jkurina86/DIC_Board/Docs/Board/STM32_hardware_guidance/AN4879_USB_hardware_PCB.txt

                                                                                                               AN4879

                                                                                                         Application note

                       Introduction to USB hardware and PCB guidelines using STM32 MCUs

Introduction
STM32 microcontrollers include a group of products embedding a USB (universal serial bus) peripheral (see the table below for
applicable products). Full-speed and high-speed operations are provided through embedded and/or external PHYs (physical
layers of the open system interconnection model).
This application note gives an overview of the USB peripherals implemented on STM32 MCUs. It also provides hardware
guidelines for PCB design, to ensure electrical compliance with the USB standards.
For more details, refer to the USB or OTG sections in the product reference manual.

AN4879 - Rev 12 - June 2026                                                                                         www.st.com
For further information, contact your local STMicroelectronics sales office.

                                                                                                               AN4879

                                                   Table 1. Applicable products

                        Type                                                  Series, lines, part numbers(1)

                                                       STM32C5 series
                                                       STM32F2 series

                                                       STM32F4 series (2)
                                                       STM32F7 series
                                                       STM32H5 series
                                                       STM32H7 series

                                                       STM32F0 series (3)

                                                       STM32F1 series (4)
                                                       STM32F302 line
                                                       STM32F303xD/xE/xB/xC products
                                                       STM32F373 line
                                                       STM32G0B0xx products
                                                       STM32G0C1xx products
                                                       STM32G4 series
                   Microcontrollers                    STM32C071 line

                                                       STM32L0 series (5)
                                                       STM32L1 series

                                                       STM32L4 series (6)
                                                       STM32L4+ series
                                                       STM32L5 series
                                                       STM32U073 line
                                                       STM32U083 line
                                                       STM32U5 series
                                                       STM32U3 series
                                                       STM32WBA2x line
                                                       STM32WBA6x line
                                                       STM32WB35xx products
                                                       STM32WB55xx products
                                                       STM32N6 series

1. Check the product datasheet for supported part numbers.
2. STM32F410 is not supported.
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
