jkurina86/DIC_Board/Reviews/preliminary-layout-2026-09-15.png

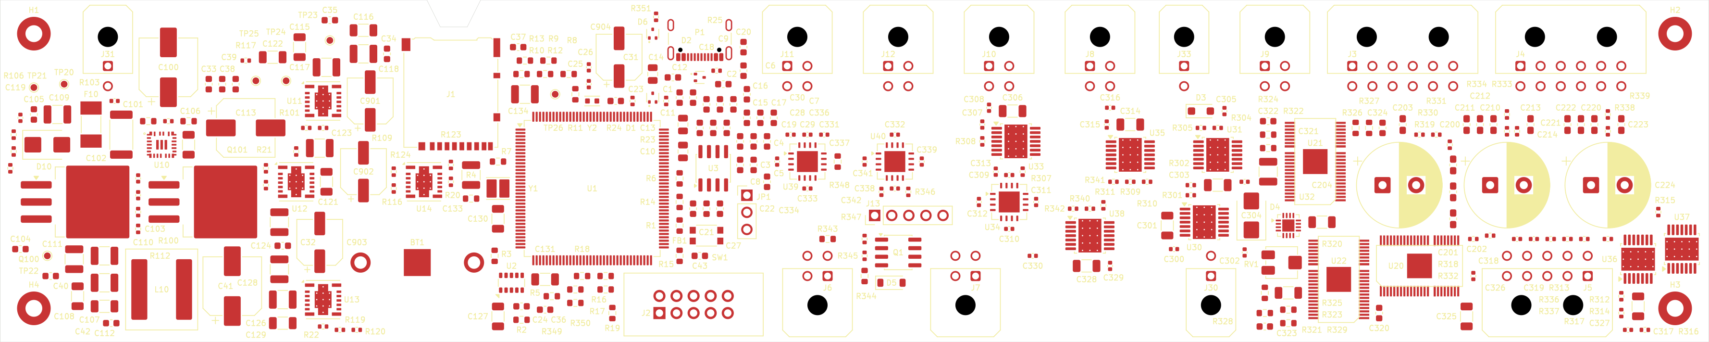
Reviews/preliminary-layout-2026-09-15.png
