jkurina86/DIC_Board/Reviews/preliminary-layout-2026-09-16.png

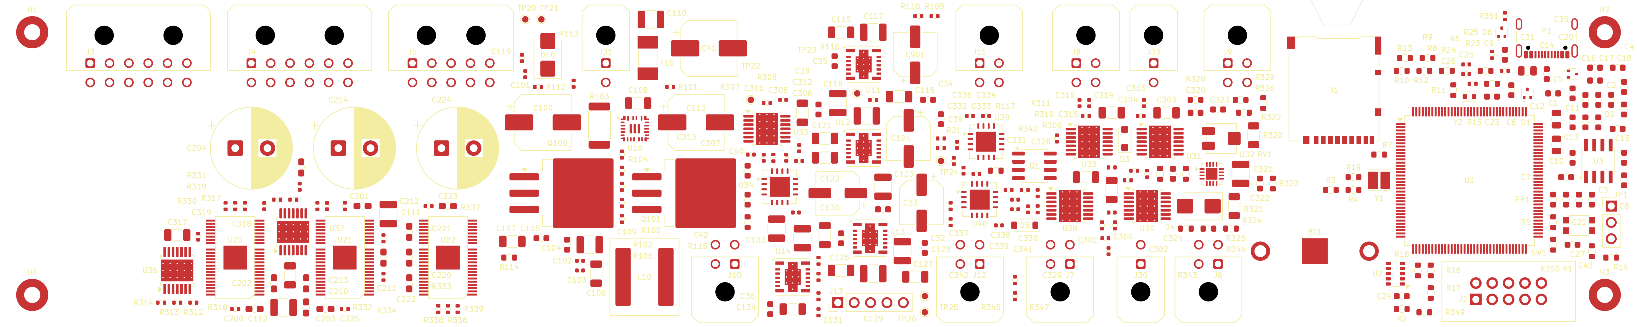
Reviews/preliminary-layout-2026-09-16.png
