jkurina86/DIC_Board/Reviews/tps552892-pcb-update-2026-09-16.png

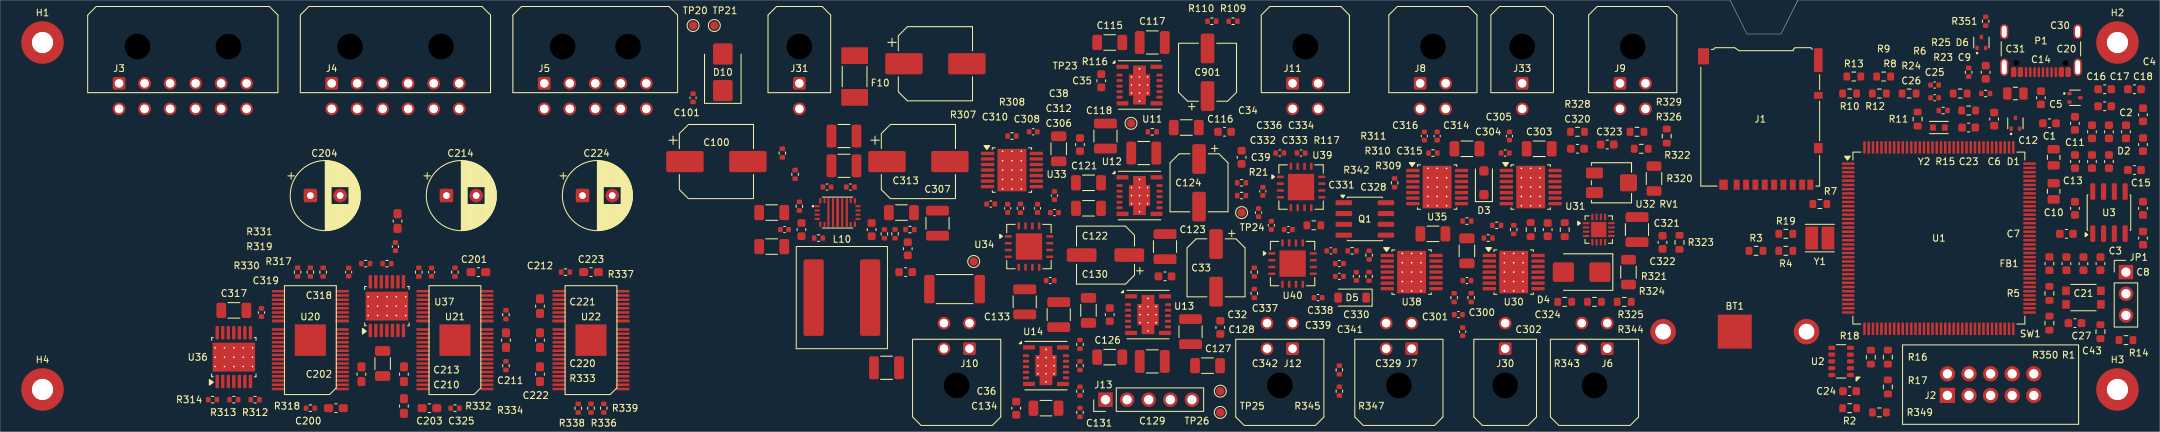
Reviews/tps552892-pcb-update-2026-09-16.png
