jkurina86/DIC_Board/outputs/01a0ab21-5a0e-7063-b471-613ef4b65435/DIC_Board_BOM.xlsx

Sheet: BOM
Item | QTY per board | REF. DES. | Description | MFG or Supplier | MFG P/N or Supplier P/N | Internal Notes if Any
1 | 1 | BT1 | Battery; 16 mm coin-cell retainer; battery separate; BatteryHolder_Keystone_3013_1x16mm | Keystone Electronics | 3013 | BT1: 16mm coin-cell retainer only; battery purchased separately. Both TH tabs positive pad1; exposed PCB contact pad2 negative/GND. No paste on contact pad; use suitable clean contact finish.
2 | 19 | C1, C2, C3, C4, C5, C6, C7, C8, C9, C11, C12, C14, C16, C20, C21, C27, C28, C30, C104 | 100nF; C_0603_1608Metric | TDK | C1608X7R1H104K080AA
3 | 2 | C10, C13 | 4.7uF; C_0805_2012Metric | TDK | C2012X7R1E475K125AB
4 | 5 | C15, C17, C19, C29, C43 | 1uF; C_0603_1608Metric | TDK | C1608X7R1E105K080AB
5 | 3 | C18, C22, C322 | 10nF; C_0603_1608Metric | TDK | C1608X7R1H103K080AA
6 | 2 | C23, C24 | 12pF; Unpolarized capacitor; C_0603_1608Metric | TDK | C1608C0G1H120J080AA
7 | 2 | C25, C26 | 6.8pF; Unpolarized capacitor; C_0402_1005Metric | Murata | GRM1555C1H6R8CA01D
8 | 1 | C31 | 10uF; microSD local bulk decoupling; C_0805_2012Metric | TDK | C2012X7S1C106K125AC
9 | 10 | C32, C33, C34, C35, C36, C37, C38, C39, C40, C42 | 0.1uF; Unpolarized capacitor; C_0603_1608Metric | TDK | C1608X7R1H104K080AA
10 | 2 | C41, C100 | 100uF; CP_Elec_8x10.5 | Panasonic | EEHZA1V101P
11 | 25 | C101, C102, C103, C300, C304, C307, C309, C310, C311, C312, C313, C315, C318, C326, C329, C331, C332, C333, C334, C336, C337, C338, C339, C341, C342 | 100nF; C_0402_1005Metric | Murata | GRM155R71H104ME14D
12 | 2 | C105, C323 | 1nF; C_0603_1608Metric | TDK | C1608C0G1H102J080AA
13 | 1 | C106 | 10uF; VCC bypass; C_1206_3216Metric | Murata | GRM31CR71E106KA12L
14 | 17 | C107, C108, C115, C116, C121, C122, C126, C127, C130, C131, C301, C303, C306, C314, C317, C325, C328 | 10uF; C_1206_3216Metric | TDK | CGA5L1X7R1H106K160AC
15 | 4 | C109, C110, C111, C112 | 22uF; 12-V output capacitor; C_1210_3225Metric | Murata | GRM32ER71E226ME15L
16 | 1 | C113 | 220uF; 12-V output capacitor; CP_Elec_8x10.5 | Panasonic | EEHZA1E221P
17 | 8 | C117, C118, C123, C124, C128, C129, C133, C134 | 47uF; C_1210_3225Metric | Murata | GRM32ER61A476ME20L
18 | 1 | C119 | 10nF; CDC timing capacitor; C_0402_1005Metric | TDK | CGA2B3X7R1H103K050BB
19 | 3 | C200, C210, C220 | 0.47uF; C_0603_1608Metric_Pad1.08x0.95mm_HandSolder | TDK | CGA3E3X7R1H474K080AE
20 | 3 | C201, C211, C221 | 0.01uF; C_0603_1608Metric_Pad1.08x0.95mm_HandSolder | KEMET | C0603C103K2RACTU
21 | 6 | C202, C203, C212, C213, C222, C223 | 0.1uF; C_0603_1608Metric_Pad1.08x0.95mm_HandSolder | KEMET | C0603X104K5RAC7867
22 | 3 | C204, C214, C224 | 100uF; 100uF 50V 20%; 8x11.5mm radial, 3.5mm pitch; coordinated with TPS552892 startup budget; CP_Radial_D8.0mm_P3.50mm | Nichicon | UHE1H101MPD
23 | 7 | C302, C305, C308, C316, C319, C327, C330 | 22nF; Output ESD capacitor; C_0402_1005Metric | Murata | GRM155R71H223KA12D
24 | 1 | C320 | 2.2uF 16V; STSPIN220 local ceramic supply capacitor; C_0603_1608Metric | TDK | C1608X5R1C225K080AB
25 | 1 | C321 | 22uF 16V; STSPIN220 local bulk supply capacitor; C_1210_3225Metric | Murata | GRM32ER71E226ME15L
26 | 1 | C324 | 22nF; TOFF stability capacitor; C_0603_1608Metric | TDK | C1608X7R1H223K080AA
27 | 4 | C901, C902, C903, C904 | 180uF 16V; CP_Elec_6.3x5.9 | Panasonic | 16SVPF180M
28 | 3 | D1, D2, D6 | RCLAMP0582B; SOT-523 | Semtech | RClamp0582B.TCT | D6: Pin1 protects CC2;pin3=GND;pin2 unused NC.
29 | 1 | D3 | STPS1L40ZF; 40 V, 1 A low-drop Schottky freewheel rectifier, SOD-123Flat; D_SOD-123F | STMicroelectronics | STPS1L40ZF | D3: Freewheel clamp: pin 1 cathode to switched output; pin 2 anode to GND.
30 | 1 | D4 | STPS3L60U; 60 V, 3 A low-drop Schottky freewheel rectifier, SMB; D_SMB | STMicroelectronics | STPS3L60U | D4: Freewheel clamp sized above SBE 5P startup surge: pin 1 cathode to switched +12V output; pin 2 anode to GND.
31 | 1 | D5 | BZT52C8V2-7-F; 8.2V gate-source Zener clamp, cathode to P-channel source; D_SOD-123 | Diodes Incorporated | BZT52C8V2-7-F
32 | 1 | D10 | SMBJ18A; Unidirectional input TVS; cathode pad 1 to P_IN, anode pad 2 to GND.; D_SMB | Littelfuse | SMBJ18A | D10: SMBJ18A unidirectional: cathode band must face footprint pad 1/P_IN.
33 | 1 | F10 | 8A; Input fuse; Fuse_Littelfuse-NANO2-451_453 | Littelfuse | 0451008.MRL
34 | 1 | FB1 | 600R @ 100MHz; Ferrite bead, small symbol; L_0603_1608Metric | Murata | BLM18AG601SN1D
35 | 1 | J1 | DM3AT-SF-PEJM5; Hirose push-push microSD socket with active-low card detect; microSD_HC_Hirose_DM3AT-SF-PEJM5 | Hirose | DM3AT-SF-PEJM5
36 | 1 | J2 | Conn_ARM_JTAG_SWD_10; Cortex Debug Connector, standard ARM Cortex-M SWD and JTAG interface; Wurth_61201021621_2x05_P2.54mm_Vertical | Wurth Elektronik | 61201021621 | J2: User-selected 2.54mm-pitch shrouded 10-pin header; retains existing ARM SWD pin numbering. Requires matching 2.54mm cable/adapter; pin7 present but NC.
37 | 2 | J3, J4 | 0430451200; Molex Micro-Fit 3.0 right-angle through-hole header, dual row, 12 circuits, 3.00 mm pitch, MPN 0430451200; Molex_Micro-Fit_3.0_43045-1200_2x06_P3.00mm_Horizontal | Molex | 0430451200
38 | 1 | J5 | Conn_01x10; Generic connector, single row, 01x10, script generated (kicad-library-utils/schlib/autogen/connector/); Molex_Micro-Fit_3.0_43045-1000_2x05_P3.00mm_Horizontal | Molex | 0430451000
39 | 7 | J6, J7, J8, J9, J10, J11, J12 | Conn_01x04; Generic connector, single row, 01x04, script generated (kicad-library-utils/schlib/autogen/connector/); Molex_Micro-Fit_3.0_43045-0400_2x02_P3.00mm_Horizontal | Molex | 0430450400
40 | 1 | J13 | Conn_01x05_Pin; Generic connector, single row, 01x05, script generated; PinHeader_Wurth_61300511121_1x05_P2.54mm_Vertical | Wurth Elektronik | 61300511121 | J13: User specified PTH male header; selected 1x5,2.54mm pitch,vertical,0.64mm square pins,6mm mating length and3mm solder tails. Recommended1.1mm holes.
41 | 3 | J30, J31, J33 | 0430450200; Molex Micro-Fit 3.0 two-circuit right-angle through-hole header; Molex_Micro-Fit_3.0_43045-0200_2x01_P3.00mm_Horizontal | Molex | 0430450200 | J30: Pin 1 = GND; pin 2 = switched +12 V. Mating housing 0430250200 and female contacts required. J31: Pin 1 = GND; pin 2 = external positive supply, through F10 to P_IN. Mating housing 0430250200 and female contacts required. Verify harness polarity before connection. J33: Pin 1 = GND / pump black lead; pin 2 = switched +6V6 / pump red lead. Mating housing 0430250200 and female contacts required.
42 | 1 | JP1 | Conn_01x03_Pin; Generic connector, single row, 01x03, script generated; PinHeader_Wurth_61300311121_1x03_P2.54mm_Vertical | Wurth Elektronik | 61300311121 | JP1: User specified PTH male header; selected 1x3,2.54mm pitch,vertical,0.64mm square pins,6mm mating length and3mm solder tails. Recommended1.1mm holes.
43 | 1 | L10 | 4.7uH; Buck-boost inductor; L_Coilcraft_XAL1010-XXX | Coilcraft | XAL1010-472MEB
44 | 1 | P1 | USB4105-GF-A; USB-C USB2.0 receptacle, top-mount, horizontal, SMT contacts and through-hole shell anchors; USB_C_Receptacle_GCT_USB4105-xx-A_16P_TopMnt_Horizontal | GCT | USB4105-GF-A | P1: Device/UFP socket: CC1 and CC2 each have an independent5.1k Rd; A6/B6=D+,A7/B7=D-. SBU pins unused.
45 | 1 | Q1 | AO4630; 30V complementary MOSFET;PMOS RDSon78mohm max at-2.5V;SOIC8;S1=1,G1=2,S2=3,G2=4,D2=5/6,D1=7/8; SOIC-8_3.9x4.9mm_P1.27mm | Alpha & Omega Semiconductor | AO4630
46 | 2 | R1, R326 | 47k; R_0603_1608Metric | Vishay | CRCW060347K0FKEA
47 | 5 | R2, R5, R6, R8, R14 | 10k; R_0603_1608Metric | Vishay | CRCW060310K0FKEA
48 | 2 | R3, R19 | 470R; Resistor; R_0603_1608Metric | Vishay | CRCW0603470RFKEA
49 | 1 | R4 | 0R; Resistor; R_0603_1608Metric | Vishay | CRCW06030000Z0EA
50 | 1 | R7 | 33R; SDMMC clock source termination; R_0603_1608Metric | Vishay | CRCW060333R0FKEA
51 | 5 | R9, R10, R11, R12, R13 | 47K; SDMMC clock source termination; R_0603_1608Metric | Vishay | CRCW060347K0FKEA
52 | 4 | R15, R16, R17, R18 | 22R; Resistor; R_0603_1608Metric | Vishay | CRCW060322R0FKEA
53 | 4 | R20, R21, R22, R104 | 100k; R_0402_1005Metric | Vishay | CRCW0402100KFKED
54 | 1 | R23 | 33k; USB VBUS sense upper divider; R_0402_1005Metric | Vishay | CRCW040233K0FKED
55 | 1 | R24 | 82k; USB VBUS sense lower divider; R_0402_1005Metric | Vishay | CRCW040282K0FKED
56 | 2 | R25, R351 | 5.1k; R_0402_1005Metric | Vishay | CRCW04025K10FKED
57 | 1 | R100 | 150k; EN upper divider; R_0402_1005Metric | Vishay | CRCW0402150KFKED
58 | 2 | R101, R112 | 24.9k; R_0402_1005Metric | Vishay | CRCW040224K9FKED
59 | 1 | R102 | 49.9k; 400-kHz frequency set; R_0402_1005Metric | Vishay | CRCW040249K9FKED
60 | 1 | R103 | 10m; 10mOhm 1% 1W; nominal 5A output limit; Kelvin sense; R_2512_6332Metric | Vishay | WSL2512R0100FEA
61 | 1 | R105 | 11.1k; 12-V feedback lower; R_0402_1005Metric | Vishay | CRCW040211K1FKED
62 | 5 | R106, R109, R116, R119, R123 | 10k; R_0402_1005Metric | Vishay | CRCW040210K0FKED
63 | 1 | R110 | 4.32k; 3V3 feedback lower; R_0402_1005Metric | Vishay | CRCW04024K32FKED
64 | 1 | R117 | 2.49k; 5V feedback lower; R_0402_1005Metric | Vishay | CRCW04022K49FKED
65 | 1 | R120 | 1.78k; 6V6 feedback lower; R_0402_1005Metric | Vishay | CRCW04021K78FKED
66 | 1 | R124 | 5.56k; 2V7 feedback lower; R_0402_1005Metric | Vishay | CRCW04025K56FKED
67 | 9 | R301, R304, R307, R310, R313, R316, R341, R345, R346 | 100k; Enable pull-down; R_0402_1005Metric | Vishay Dale | CRCW0402100KFKED
68 | 7 | R302, R305, R308, R311, R314, R317, R342 | 1.00k; Approximately 2.5-A current-limit set resistor; R_0402_1005Metric | Vishay Dale | CRCW04021K00FKED
69 | 4 | R309, R312, R315, R340 | 15k; MCU input protection; R_0402_1005Metric | Vishay Dale | CRCW040215K0FKED
70 | 12 | R318, R319, R330, R331, R332, R333, R334, R335, R336, R337, R338, R339 | 3.3R; R_0402_1005Metric | Vishay | CRCW04023R30FKEDHP
71 | 2 | R320, R321 | 2.00R 1%; R_1206_3216Metric | Vishay | CRCW12062R00FKEA
72 | 4 | R322, R323, R324, R325 | 20k; R_0603_1608Metric | Vishay | CRCW060320K0FKEA
73 | 1 | R327 | 1k; TOFF stability resistor; R_0603_1608Metric | Vishay | CRCW06031K00FKEA
74 | 1 | R328 | 2.87k; Bounded current-reference upper resistor, 0.1% required; R_0603_1608Metric | Vishay | TNPW06032K87BEEA
75 | 1 | R329 | 487R; Bounded current-reference lower resistor, 0.1% required; R_0603_1608Metric | Vishay | TNPW0603487RBEEA
76 | 2 | R343, R344 | 4.7k; R_0603_1608Metric | Vishay | CRCW06034K70FKEA
77 | 1 | R347 | 4.7k; R_0402_1005Metric | Vishay | CRCW04024K70FKED
78 | 3 | R348, R349, R350 | 100k; R_0603_1608Metric | Vishay | CRCW0603100KFKEA
79 | 1 | RV1 | 10k trim; 10k current-limit trimmer; wiper tied to VREF-side terminal for fail-safe operation; Potentiometer_Bourns_3314J_Vertical | Bourns | 3314J-1-103E
80 | 1 | SW1 | SW_Push; Push button switch, generic, two pins; SW_ESwitch_TL6330AF200Q | E-Switch | TL6330AF200Q | SW1: Physical switch terminals 1/2 are internally common and map to schematic pin1 (NRST); terminals 3/4 map to schematic pin2 (GND).
81 | 1 | U1 | STM32L476ZGTx; STMicroelectronics Arm Cortex-M4 MCU, 1024KB flash, 128KB RAM, 80 MHz, 1.71-3.6V, 114 GPIO, LQFP144; LQFP-144_20x20mm_P0.5mm | STMicroelectronics | STM32L476ZGT6
82 | 1 | U2 | AB-RTCMC-32.768kHz-EOA9-S3; DTCXO temperature-compensated real-time clock module with SPI bus, 3.7x2.5x0.9 mm; RTC_SMD_MicroCrystal_C3_2.5x3.7mm | Abracon | AB-RTCMC-32.768kHz-EOA9-S3
83 | 1 | U3 | APS6404L-3SQRX-SN; 64 Mbit (8 MiB) 3.3 V Quad-SPI pseudo-SRAM, extended temperature, SOP-8; SOIC-8_3.9x4.9mm_P1.27mm | AP Memory | APS6404L-3SQRX-SN
84 | 1 | U10 | TPS552892RYQR; 10-14V input; 12V nominal / 3A continuous design target; qualify thermal and startup; Texas_RYQ0021A_TPS552892 | Texas Instruments | TPS552892RYQR | U10: RYQ0021A, 21 pins; all four MOSFETs internal; not pin compatible with TPS552882
85 | 4 | U11, U12, U13, U14 | TPSM53603RDAR; 36-V input, 3-A step-down power module; Texas_B3QFN-14-1EP_5x5.5mm_P0.65mm_ThermalVia | Texas Instruments | TPSM53603RDAR
86 | 3 | U20, U21, U22 | DRV8823QDCARQ1; Automotive quad H-bridge serial motor driver; used for four latching valves; DRV8823_DCA48_ReviewFixed | Texas Instruments | DRV8823QDCARQ1
87 | 7 | U30, U31, U33, U35, U36, U37, U38 | TPS27S100APWPR; 40-V, 4-A, 80-mOhm single-channel industrial smart high-side switch; Texas_HTSSOP-14-1EP_4.4x5mm_P0.65mm_EP3.4x5mm_Mask3.155x3.255mm_ThermalVias | Texas Instruments | TPS27S100APWPR | U30: R302 = 1.00 kOhm sets approximately 2.5 A current limit for the SBE 5P. U31: R302 = 1.00 kOhm sets approximately 2.5 A current limit for the SBE 5P. U33: R302 = 1.00 kOhm sets approximately 2.5 A current limit for the SBE 5P. U35: R302 = 1.00 kOhm sets approximately 2.5 A current limit for the SBE 5P. U36: R302 = 1.00 kOhm sets approximately 2.5 A current limit for the SBE 5P. U37: R302 = 1.00 kOhm sets approximately 2.5 A current limit for the SBE 5P. U38: R302 = 1.00 kOhm sets approximately 2.5 A current limit for the SBE 5P.
88 | 1 | U32 | STSPIN220; Low-voltage stepper motor driver; VQFN-16-1EP_3x3mm_P0.5mm_EP1.8x1.8mm | STMicroelectronics | STSPIN220
89 | 3 | U34, U39, U40 | MAX3226EETE+; Single RS-232 driver/receiver with AutoShutdown Plus, 16-TQFN package; TQFN-16-1EP_5x5mm_P0.8mm_EP3.1x3.1mm | Analog Devices / Maxim Integrated | MAX3226EETE+
90 | 1 | Y1 | ABM8AAIG-8.000MHz-V2R-T3; 8 MHz fundamental-mode crystal, 8 pF load, 2-SMD 3.2 x 2.5 mm, AEC-Q200; ABM8AAIG-2Pin_3.2x2.5mm | Abracon | ABM8AAIG-8.000MHz-V2R-T3
91 | 1 | Y2 | ABS06-107-32.768KHZ-T; 32.768 kHz tuning-fork crystal, 4 pF load, 2-SMD 2.0 x 1.2 mm; ABS06-107-2Pin_2.0x1.2mm | Abracon | ABS06-107-32.768KHZ-T

Sheet: Sourcing and exclusions
DIC Board BOM details
Quantities are per board. Grouped by value, footprint, manufacturer and exact MPN. Snapshot: September 16, 2026.
Source: current DIC_Board.kicad_sch hierarchy, cross-checked against KiCad 10.0.4 resolved netlist. Schematic fields remain the source of truth.
Supplier numbers and datasheet URLs are copied from schematic fields. Blank fields mean not recorded. Pricing, stock and lifecycle have not been checked.
Assembly scope: board-mounted parts only. Battery, mating housings, contacts, cables, external instruments and mounting hardware require separate purchasing.
 | BOM line items | 91
 | Fitted components / board | 280
 | Excluded PCB features | 11
BOM item | Value | KiCad footprint | DigiKey P/N | Mouser P/N | Datasheet URL | Source schematic
1 | Battery | DIC_Board:BatteryHolder_Keystone_3013_1x16mm | 36-3013-ND |  | https://beta.keyelco.com/userAssets/file/M60p4-6-7.pdf | mcu.kicad_sch
2 | 100nF | Capacitor_SMD:C_0603_1608Metric |  |  | https://product.tdk.com/info/en/documents/chara_sheet/C1608X7R1H104K080AA.pdf | 12v.kicad_sch; mcu.kicad_sch
3 | 4.7uF | Capacitor_SMD:C_0805_2012Metric |  |  |  | mcu.kicad_sch
4 | 1uF | Capacitor_SMD:C_0603_1608Metric |  |  |  | mcu.kicad_sch
5 | 10nF | Capacitor_SMD:C_0603_1608Metric |  |  |  | Acid_Pump.kicad_sch; mcu.kicad_sch
6 | 12pF | Capacitor_SMD:C_0603_1608Metric |  |  |  | mcu.kicad_sch
7 | 6.8pF | Capacitor_SMD:C_0402_1005Metric |  |  |  | mcu.kicad_sch
8 | 10uF | Capacitor_SMD:C_0805_2012Metric |  |  |  | mcu.kicad_sch
9 | 0.1uF | Capacitor_SMD:C_0603_1608Metric |  |  |  | 12v.kicad_sch; 2v8.kicad_sch; 3v3.kicad_sch; 5v.kicad_sch; 6v6.kicad_sch
10 | 100uF | Capacitor_SMD:CP_Elec_8x10.5 |  |  |  | 12v.kicad_sch; Power.kicad_sch
11 | 100nF | Capacitor_SMD:C_0402_1005Metric |  |  |  | 12v.kicad_sch; Air_Pump.kicad_sch; Licor.kicad_sch; Power.kicad_sch; Water_Pump.kicad_sch; actuators.kicad_sch; admont_k96.kicad_sch; auxiliary.kicad_sch; comms.kicad_sch; o2_sensor.kicad_sch
12 | 1nF | Capacitor_SMD:C_0603_1608Metric |  |  | https://product.tdk.com/info/en/documents/chara_sheet/C1608C0G1H471J080AA.pdf | 12v.kicad_sch; Acid_Pump.kicad_sch
13 | 10uF | Capacitor_SMD:C_1206_3216Metric |  |  | https://pim.murata.com/en-us/pim/details/?partNum=GRM31CR71E106KA12L | 12v.kicad_sch
14 | 10uF | Capacitor_SMD:C_1206_3216Metric |  |  |  | 12v.kicad_sch; 2v8.kicad_sch; 3v3.kicad_sch; 5v.kicad_sch; 6v6.kicad_sch; Air_Pump.kicad_sch; Licor.kicad_sch; Water_Pump.kicad_sch; actuators.kicad_sch; admont_k96.kicad_sch; o2_sensor.kicad_sch
15 | 22uF | Capacitor_SMD:C_1210_3225Metric |  |  |  | 12v.kicad_sch
16 | 220uF | Capacitor_SMD:CP_Elec_8x10.5 |  |  |  | 12v.kicad_sch
17 | 47uF | Capacitor_SMD:C_1210_3225Metric |  |  |  | 2v8.kicad_sch; 3v3.kicad_sch; 5v.kicad_sch; 6v6.kicad_sch
18 | 10nF | Capacitor_SMD:C_0402_1005Metric |  |  |  | 12v.kicad_sch
19 | 0.47uF | Capacitor_SMD:C_0603_1608Metric_Pad1.08x0.95mm_HandSolder |  |  |  | Valve_Control_Bank1.kicad_sch; Valve_Control_Bank2.kicad_sch; Valve_Control_Bank3.kicad_sch
20 | 0.01uF | Capacitor_SMD:C_0603_1608Metric_Pad1.08x0.95mm_HandSolder |  |  |  | Valve_Control_Bank1.kicad_sch; Valve_Control_Bank2.kicad_sch; Valve_Control_Bank3.kicad_sch
21 | 0.1uF | Capacitor_SMD:C_0603_1608Metric_Pad1.08x0.95mm_HandSolder |  |  |  | Valve_Control_Bank1.kicad_sch; Valve_Control_Bank2.kicad_sch; Valve_Control_Bank3.kicad_sch
22 | 100uF | Capacitor_THT:CP_Radial_D8.0mm_P3.50mm |  |  | https://www.nichicon.com/getmedia/5ee6e3a3-2d90-4858-bed0-89ef58a93bc3/e-uhe.pdf | Valve_Control_Bank1.kicad_sch; Valve_Control_Bank2.kicad_sch; Valve_Control_Bank3.kicad_sch
23 | 22nF | Capacitor_SMD:C_0402_1005Metric |  |  |  | Air_Pump.kicad_sch; Licor.kicad_sch; Water_Pump.kicad_sch; actuators.kicad_sch; admont_k96.kicad_sch; o2_sensor.kicad_sch
24 | 2.2uF 16V | Capacitor_SMD:C_0603_1608Metric |  |  |  | Acid_Pump.kicad_sch
25 | 22uF 16V | Capacitor_SMD:C_1210_3225Metric |  |  |  | Acid_Pump.kicad_sch
26 | 22nF | Capacitor_SMD:C_0603_1608Metric |  |  |  | Acid_Pump.kicad_sch
27 | 180uF 16V | Capacitor_SMD:CP_Elec_6.3x5.9 |  |  | https://industrial.panasonic.com/cdbs/www-data/pdf/AAB8000/AAB8000COL87.pdf | 2v8.kicad_sch; 3v3.kicad_sch; 5v.kicad_sch; 6v6.kicad_sch
28 | RCLAMP0582B | Package_TO_SOT_SMD:SOT-523 |  |  | https://www.semtech.com/products/circuit-protection/low-capacitance/rclamp0582b | mcu.kicad_sch
29 | STPS1L40ZF | Diode_SMD:D_SOD-123F | 497-16916-1-ND |  | https://www.st.com/resource/en/datasheet/stps1l40.pdf | Air_Pump.kicad_sch
30 | STPS3L60U | Diode_SMD:D_SMB |  |  | https://www.st.com/resource/en/datasheet/stps3l60.pdf | Water_Pump.kicad_sch
31 | BZT52C8V2-7-F | Diode_SMD:D_SOD-123 |  |  | https://www.diodes.com/datasheet/download/BZT52Cxx.pdf | auxiliary.kicad_sch
32 | SMBJ18A | Diode_SMD:D_SMB |  |  | https://www.littelfuse.com/media?itemid=8d6ebfcb-84fe-41e5-a1bd-0d9fda5f2f4c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 | Power.kicad_sch
33 | 8A | Fuse:Fuse_Littelfuse-NANO2-451_453 |  |  |  | Power.kicad_sch
34 | 600R @ 100MHz | Inductor_SMD:L_0603_1608Metric |  |  |  | mcu.kicad_sch
35 | DM3AT-SF-PEJM5 | Connector_Card:microSD_HC_Hirose_DM3AT-SF-PEJM5 |  |  | https://www.hirose.com/en/product/document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 | mcu.kicad_sch
36 | Conn_ARM_JTAG_SWD_10 | DIC_Board:Wurth_61201021621_2x05_P2.54mm_Vertical | 732-2094-ND |  | https://www.we-online.com/components/products/datasheet/61201021621.pdf | mcu.kicad_sch
37 | 0430451200 | DIC_Board:Molex_Micro-Fit_3.0_43045-1200_2x06_P3.00mm_Horizontal | WM1818-ND |  | https://www.molex.com/pdm_docs/sd/430450201_sd.pdf | Valve_Control.kicad_sch
38 | Conn_01x10 | Connector_Molex:Molex_Micro-Fit_3.0_43045-1000_2x05_P3.00mm_Horizontal |  |  |  | actuators.kicad_sch
39 | Conn_01x04 | Connector_Molex:Molex_Micro-Fit_3.0_43045-0400_2x02_P3.00mm_Horizontal |  |  |  | Acid_Pump.kicad_sch; Licor.kicad_sch; admont_k96.kicad_sch; auxiliary.kicad_sch; comms.kicad_sch; o2_sensor.kicad_sch; rh_sensor.kicad_sch
40 | Conn_01x05_Pin | DIC_Board:PinHeader_Wurth_61300511121_1x05_P2.54mm_Vertical |  |  | https://www.we-online.com/components/products/datasheet/61300511121.pdf | auxiliary.kicad_sch
41 | 0430450200 | Connector_Molex:Molex_Micro-Fit_3.0_43045-0200_2x01_P3.00mm_Horizontal | WM1813-ND |  | https://www.molex.com/content/dam/molex/molex-dot-com/products/automated/en-us/salesdrawingpdf/430/43045/430450200_sd.pdf | Air_Pump.kicad_sch; Power.kicad_sch; Water_Pump.kicad_sch
42 | Conn_01x03_Pin | DIC_Board:PinHeader_Wurth_61300311121_1x03_P2.54mm_Vertical |  |  | https://www.we-online.com/components/products/datasheet/61300311121.pdf | mcu.kicad_sch
43 | 4.7uH | Inductor_SMD:L_Coilcraft_XAL1010-XXX |  |  | https://www.coilcraft.com/getmedia/1bb91f89-c5be-4d5f-9720-411ce5546127/xal1010.pdf | 12v.kicad_sch
44 | USB4105-GF-A | Connector_USB:USB_C_Receptacle_GCT_USB4105-xx-A_16P_TopMnt_Horizontal | 2073-USB4105-GF-ACT-ND |  | https://gct.co/files/drawings/usb4105.pdf | mcu.kicad_sch
45 | AO4630 | Package_SO:SOIC-8_3.9x4.9mm_P1.27mm |  |  | https://www.aosmd.com/res/datasheets/AO4630.pdf | auxiliary.kicad_sch
46 | 47k | Resistor_SMD:R_0603_1608Metric |  |  |  | Acid_Pump.kicad_sch; mcu.kicad_sch
47 | 10k | Resistor_SMD:R_0603_1608Metric |  |  |  | mcu.kicad_sch
48 | 470R | Resistor_SMD:R_0603_1608Metric |  |  |  | mcu.kicad_sch
49 | 0R | Resistor_SMD:R_0603_1608Metric |  |  |  | mcu.kicad_sch
50 | 33R | Resistor_SMD:R_0603_1608Metric |  |  |  | mcu.kicad_sch
51 | 47K | Resistor_SMD:R_0603_1608Metric |  |  |  | mcu.kicad_sch
52 | 22R | Resistor_SMD:R_0603_1608Metric |  |  |  | mcu.kicad_sch
53 | 100k | Resistor_SMD:R_0402_1005Metric |  |  |  | 12v.kicad_sch; 2v8.kicad_sch; 5v.kicad_sch; 6v6.kicad_sch
54 | 33k | Resistor_SMD:R_0402_1005Metric |  |  |  | mcu.kicad_sch
55 | 82k | Resistor_SMD:R_0402_1005Metric |  |  |  | mcu.kicad_sch
56 | 5.1k | Resistor_SMD:R_0402_1005Metric |  |  |  | mcu.kicad_sch
57 | 150k | Resistor_SMD:R_0402_1005Metric |  |  |  | 12v.kicad_sch
58 | 24.9k | Resistor_SMD:R_0402_1005Metric |  |  |  | 12v.kicad_sch
59 | 49.9k | Resistor_SMD:R_0402_1005Metric |  |  |  | 12v.kicad_sch
60 | 10m | Resistor_SMD:R_2512_6332Metric |  |  | https://www.vishay.com/docs/30100/wsl.pdf | 12v.kicad_sch
61 | 11.1k | Resistor_SMD:R_0402_1005Metric |  |  |  | 12v.kicad_sch
62 | 10k | Resistor_SMD:R_0402_1005Metric |  |  |  | 12v.kicad_sch; 2v8.kicad_sch; 3v3.kicad_sch; 5v.kicad_sch; 6v6.kicad_sch
63 | 4.32k | Resistor_SMD:R_0402_1005Metric |  |  |  | 3v3.kicad_sch
64 | 2.49k | Resistor_SMD:R_0402_1005Metric |  |  |  | 5v.kicad_sch
65 | 1.78k | Resistor_SMD:R_0402_1005Metric |  |  |  | 6v6.kicad_sch
66 | 5.56k | Resistor_SMD:R_0402_1005Metric |  |  |  | 2v8.kicad_sch
67 | 100k | Resistor_SMD:R_0402_1005Metric |  |  |  | Air_Pump.kicad_sch; Licor.kicad_sch; Water_Pump.kicad_sch; actuators.kicad_sch; admont_k96.kicad_sch; auxiliary.kicad_sch; o2_sensor.kicad_sch
68 | 1.00k | Resistor_SMD:R_0402_1005Metric |  |  |  | Air_Pump.kicad_sch; Licor.kicad_sch; Water_Pump.kicad_sch; actuators.kicad_sch; admont_k96.kicad_sch; o2_sensor.kicad_sch
69 | 15k | Resistor_SMD:R_0402_1005Metric |  |  |  | actuators.kicad_sch; admont_k96.kicad_sch; o2_sensor.kicad_sch
70 | 3.3R | Resistor_SMD:R_0402_1005Metric |  |  |  | Valve_Control_Bank1.kicad_sch; Valve_Control_Bank2.kicad_sch; Valve_Control_Bank3.kicad_sch
71 | 2.00R 1% | Resistor_SMD:R_1206_3216Metric |  |  |  | Acid_Pump.kicad_sch
72 | 20k | Resistor_SMD:R_0603_1608Metric |  |  |  | Acid_Pump.kicad_sch
73 | 1k | Resistor_SMD:R_0603_1608Metric |  |  |  | Acid_Pump.kicad_sch
74 | 2.87k | Resistor_SMD:R_0603_1608Metric |  |  |  | Acid_Pump.kicad_sch
75 | 487R | Resistor_SMD:R_0603_1608Metric |  |  |  | Acid_Pump.kicad_sch
76 | 4.7k | Resistor_SMD:R_0603_1608Metric |  |  |  | rh_sensor.kicad_sch
77 | 4.7k | Resistor_SMD:R_0402_1005Metric |  |  |  | auxiliary.kicad_sch
78 | 100k | Resistor_SMD:R_0603_1608Metric |  |  |  | comms.kicad_sch; mcu.kicad_sch
79 | 10k trim | Potentiometer_SMD:Potentiometer_Bourns_3314J_Vertical |  |  | https://www.bourns.com/docs/product-datasheets/3314.pdf | Acid_Pump.kicad_sch
80 | SW_Push | DIC_Board:SW_ESwitch_TL6330AF200Q |  |  | https://configured-product-images.s3.amazonaws.com/2D/specs/TL6330AF200Q.pdf | mcu.kicad_sch
81 | STM32L476ZGTx | Package_QFP:LQFP-144_20x20mm_P0.5mm |  |  | https://www.st.com/resource/en/datasheet/stm32l476zg.pdf | mcu.kicad_sch
82 | AB-RTCMC-32.768kHz-EOA9-S3 | Package_SON:RTC_SMD_MicroCrystal_C3_2.5x3.7mm |  |  | https://abracon.com/realtimeclock/AB-RTCMC-32.768kHz-EOA9-S3.pdf | mcu.kicad_sch
83 | APS6404L-3SQRX-SN | Package_SO:SOIC-8_3.9x4.9mm_P1.27mm |  | 878-APS6404L-3SQRXSN | https://www.apmemory.com/wp-content/uploads/APM_PSRAM_E3_QSPI-APS6404L-3SQR-v2.4-KGD_PKG.pdf | mcu.kicad_sch
84 | TPS552892RYQR | DIC_Board:Texas_RYQ0021A_TPS552892 |  |  | https://www.ti.com/lit/ds/symlink/tps552892.pdf | 12v.kicad_sch
85 | TPSM53603RDAR | Package_DFN_QFN:Texas_B3QFN-14-1EP_5x5.5mm_P0.65mm_ThermalVia |  |  | https://www.ti.com/lit/ds/symlink/tpsm53603.pdf | 2v8.kicad_sch; 3v3.kicad_sch; 5v.kicad_sch; 6v6.kicad_sch
86 | DRV8823QDCARQ1 | DIC_Board:DRV8823_DCA48_ReviewFixed |  |  | https://www.ti.com/lit/ds/symlink/drv8823-q1.pdf | Valve_Control_Bank1.kicad_sch; Valve_Control_Bank2.kicad_sch; Valve_Control_Bank3.kicad_sch
87 | TPS27S100APWPR | Package_SO:Texas_HTSSOP-14-1EP_4.4x5mm_P0.65mm_EP3.4x5mm_Mask3.155x3.255mm_ThermalVias | 296-49002-1-ND |  | https://www.ti.com/lit/ds/symlink/tps27s100.pdf | Air_Pump.kicad_sch; Licor.kicad_sch; Water_Pump.kicad_sch; actuators.kicad_sch; admont_k96.kicad_sch; o2_sensor.kicad_sch
88 | STSPIN220 | Package_DFN_QFN:VQFN-16-1EP_3x3mm_P0.5mm_EP1.8x1.8mm |  |  | https://www.st.com/resource/en/datasheet/stspin220.pdf | Acid_Pump.kicad_sch
89 | MAX3226EETE+ | Package_DFN_QFN:TQFN-16-1EP_5x5mm_P0.8mm_EP3.1x3.1mm |  |  | https://www.analog.com/media/en/technical-documentation/data-sheets/MAX3224E-MAX3245E.pdf | Licor.kicad_sch; auxiliary.kicad_sch; comms.kicad_sch
90 | ABM8AAIG-8.000MHz-V2R-T3 | DIC_Board:ABM8AAIG-2Pin_3.2x2.5mm |  |  | https://abracon.com/datasheets/ABM8AAIG.pdf | mcu.kicad_sch
91 | ABS06-107-32.768KHZ-T | DIC_Board:ABS06-107-2Pin_2.0x1.2mm |  |  | https://abracon.com/Resonators/ABS06-107-32.768kHz-T.pdf | mcu.kicad_sch
Excluded PCB features
Reference | Value | Footprint | Population status | MPN | Reason
H1 |  | MountingHole:MountingHole_2.5mm_Pad | Excluded from BOM |  | PCB mounting hole; no separately fitted part
H2 |  | MountingHole:MountingHole_2.5mm_Pad | Excluded from BOM |  | PCB mounting hole; no separately fitted part
H3 |  | MountingHole:MountingHole_2.5mm_Pad | Excluded from BOM |  | PCB mounting hole; no separately fitted part
H4 |  | MountingHole:MountingHole_2.5mm_Pad | Excluded from BOM |  | PCB mounting hole; no separately fitted part
TP20 | P_IN | TestPoint:TestPoint_Pad_D1.0mm | Excluded from BOM |  | 1 mm copper test pad; no separately fitted part
TP21 | P_IN | TestPoint:TestPoint_Pad_D1.0mm | Excluded from BOM |  | 1 mm copper test pad; no separately fitted part
TP22 | +12V | TestPoint:TestPoint_Pad_D1.0mm | Excluded from BOM |  | 1 mm copper test pad; no separately fitted part
TP23 | +3V3 | TestPoint:TestPoint_Pad_D1.0mm | Excluded from BOM |  | 1 mm copper test pad; no separately fitted part
TP24 | +5V | TestPoint:TestPoint_Pad_D1.0mm | Excluded from BOM |  | 1 mm copper test pad; no separately fitted part
TP25 | +6V6 | TestPoint:TestPoint_Pad_D1.0mm | Excluded from BOM |  | 1 mm copper test pad; no separately fitted part
TP26 | +2V8 | TestPoint:TestPoint_Pad_D1.0mm | Excluded from BOM |  | 1 mm copper test pad; no separately fitted part
