jkurina86/DIC_Board/Docs/Sensors/LI-COR_LI-830/LI-830_LI-850_support_manuals.txt

LI-850 | Operating Instructions
Skip To Main Content
Account
Settings
Logout
placeholder
Account
Settings
Logout
Filter:
All Files
Submit Search
PRODUCTS
Plant Physiology
Eddy Covariance
Trace Gas Concentration
Soil Gas Flux
Plant Canopy
PAR & Global Solar Radiation
Soil Moisture
Meteorology
Water Levels & Water Quality
Indoor Environment
SOLUTIONS
Greenhouse
Gas Monitoring
Agricultural
Best Practices
Environmental
Protection
Soil, Atmosphere,
& Ocean Studies
Energy & Indoor
Air Monitoring
Water
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
