jkurina86/DIC_Board/Reviews/component-audit-after-fixes-2026-09-11.md

# Component audit after repairs — 11 September 2026

290 components,343 resolved nets. [Complete pin-net data for every component](fixes-2026-09-11/components-after.json). Assigned metadata does not close the external operating-limit findings in the [repair report](schematic-fixes-2026-09-11.md).

## /Actuators/

| Reference | Value | MPN | Footprint | Status |
|---|---|---|---|---|
| C317 | 10uF | CGA5L1X7R1H106K160AC | Capacitor_SMD:C_1206_3216Metric | Assigned |
| C318 | 100nF | GRM155R71H104ME14D | Capacitor_SMD:C_0402_1005Metric | Assigned |
| C319 | 22nF | GRM155R71H223KA12D | Capacitor_SMD:C_0402_1005Metric | Assigned |
| C325 | 10uF | CGA5L1X7R1H106K160AC | Capacitor_SMD:C_1206_3216Metric | Assigned |
| C326 | 100nF | GRM155R71H104ME14D | Capacitor_SMD:C_0402_1005Metric | Assigned |
| C327 | 22nF | GRM155R71H223KA12D | Capacitor_SMD:C_0402_1005Metric | Assigned |
| J5 | Conn_01x10 | 0430451000 | Connector_Molex:Molex_Micro-Fit_3.0_43045-1000_2x05_P3.00mm_Horizontal | Assigned |
| R312 | 15k | CRCW040215K0FKED | Resistor_SMD:R_0402_1005Metric | Assigned |
| R313 | 100k | CRCW0402100KFKED | Resistor_SMD:R_0402_1005Metric | Assigned |
| R314 | 1.00k | CRCW04021K00FKED | Resistor_SMD:R_0402_1005Metric | Assigned |
| R315 | 15k | CRCW040215K0FKED | Resistor_SMD:R_0402_1005Metric | Assigned |
| R316 | 100k | CRCW0402100KFKED | Resistor_SMD:R_0402_1005Metric | Assigned |
| R317 | 1.00k | CRCW04021K00FKED | Resistor_SMD:R_0402_1005Metric | Assigned |
| U36 | TPS27S100APWPR | TPS27S100APWPR | Package_SO:Texas_HTSSOP-14-1EP_4.4x5mm_P0.65mm_EP3.4x5mm_Mask3.155x3.255mm_ThermalVias | Assigned |
| U37 | TPS27S100APWPR | TPS27S100APWPR | Package_SO:Texas_HTSSOP-14-1EP_4.4x5mm_P0.65mm_EP3.4x5mm_Mask3.155x3.255mm_ThermalVias | Assigned |

## /Comms/

| Reference | Value | MPN | Footprint | Status |
|---|---|---|---|---|
| C331 | 100nF | GRM155R71H104ME14D | Capacitor_SMD:C_0402_1005Metric | Assigned |
| C333 | 100nF | GRM155R71H104ME14D | Capacitor_SMD:C_0402_1005Metric | Assigned |
| C334 | 100nF | GRM155R71H104ME14D | Capacitor_SMD:C_0402_1005Metric | Assigned |
| C336 | 100nF | GRM155R71H104ME14D | Capacitor_SMD:C_0402_1005Metric | Assigned |
| C337 | 100nF | GRM155R71H104ME14D | Capacitor_SMD:C_0402_1005Metric | Assigned |
| J11 | Conn_01x04 | 0430450400 | Connector_Molex:Molex_Micro-Fit_3.0_43045-0400_2x02_P3.00mm_Horizontal | Assigned |
| R348 | 100k | CRCW0603100KFKEA | Resistor_SMD:R_0603_1608Metric | Assigned |
| U39 | MAX3226EETE+ | MAX3226EETE+ | Package_DFN_QFN:TQFN-16-1EP_5x5mm_P0.8mm_EP3.1x3.1mm | Assigned |

## /Comms/Aux/

| Reference | Value | MPN | Footprint | Status |
|---|---|---|---|---|
| C332 | 100nF | GRM155R71H104ME14D | Capacitor_SMD:C_0402_1005Metric | Assigned |
| C338 | 100nF | GRM155R71H104ME14D | Capacitor_SMD:C_0402_1005Metric | Assigned |
| C339 | 100nF | GRM155R71H104ME14D | Capacitor_SMD:C_0402_1005Metric | Assigned |
| C341 | 100nF | GRM155R71H104ME14D | Capacitor_SMD:C_0402_1005Metric | Assigned |
| C342 | 100nF | GRM155R71H104ME14D | Capacitor_SMD:C_0402_1005Metric | Assigned |
| D5 | BZT52C8V2-7-F | BZT52C8V2-7-F | Diode_SMD:D_SOD-123 | Assigned |
| J12 | Conn_01x04 | 0430450400 | Connector_Molex:Molex_Micro-Fit_3.0_43045-0400_2x02_P3.00mm_Horizontal | Assigned |
| J13 | Conn_01x05_Pin | 0436500500 | Connector_Molex:Molex_Micro-Fit_3.0_43650-0500_1x05_P3.00mm_Horizontal | Assigned |
| Q1 | AO4630 | AO4630 | Package_SO:SOIC-8_3.9x4.9mm_P1.27mm | Assigned |
| R345 | 100k | CRCW0402100KFKED | Resistor_SMD:R_0402_1005Metric | Assigned |
| R346 | 100k | CRCW0402100KFKED | Resistor_SMD:R_0402_1005Metric | Assigned |
| R347 | 4.7k | CRCW04024K70FKED | Resistor_SMD:R_0402_1005Metric | Assigned |
| U40 | MAX3226EETE+ | MAX3226EETE+ | Package_DFN_QFN:TQFN-16-1EP_5x5mm_P0.8mm_EP3.1x3.1mm | Assigned |

## /Power/

| Reference | Value | MPN | Footprint | Status |
|---|---|---|---|---|
| C100 | 100uF | EEHZA1V101P | Capacitor_SMD:CP_Elec_8x10.5 | Assigned |
| C101 | 100nF | GRM155R71H104ME14D | Capacitor_SMD:C_0402_1005Metric | Assigned |
| D10 | SMBJ18A | SMBJ18A | Diode_SMD:D_SMB | Assigned |
| F10 | 8A | 0451008.MRL | Fuse:Fuse_Littelfuse-NANO2-451_453 | Assigned |
| J31 | 0430450200 | 0430450200 | Connector_Molex:Molex_Micro-Fit_3.0_43045-0200_2x01_P3.00mm_Horizontal | Assigned |
| TP20 | P_IN | — | TestPoint:TestPoint_Plated_Hole_D2.0mm | Fabricated; not BOM |
| TP21 | P_IN | — | TestPoint:TestPoint_Plated_Hole_D2.0mm | Fabricated; not BOM |

## /Power/12V/

| Reference | Value | MPN | Footprint | Status |
|---|---|---|---|---|
| C102 | 100nF | GRM155R71H104ME14D | Capacitor_SMD:C_0402_1005Metric | Assigned |
| C103 | 100nF | GRM155R71H104ME14D | Capacitor_SMD:C_0402_1005Metric | Assigned |
| C104 | 100nF | C1608X7R1H104K080AA | Capacitor_SMD:C_0603_1608Metric | Assigned |
| C105 | 1nF | C1608C0G1H102J080AA | Capacitor_SMD:C_0603_1608Metric | Assigned |
| C106 | 10uF | GRM31CR71E106KA12L | Capacitor_SMD:C_1206_3216Metric | Assigned |
| C107 | 10uF | CGA5L1X7R1H106K160AC | Capacitor_SMD:C_1206_3216Metric | Assigned |
| C108 | 10uF | CGA5L1X7R1H106K160AC | Capacitor_SMD:C_1206_3216Metric | Assigned |
| C109 | 22uF | GRM32ER71E226ME15L | Capacitor_SMD:C_1210_3225Metric | Assigned |
| C110 | 22uF | GRM32ER71E226ME15L | Capacitor_SMD:C_1210_3225Metric | Assigned |
| C111 | 22uF | GRM32ER71E226ME15L | Capacitor_SMD:C_1210_3225Metric | Assigned |
| C112 | 22uF | GRM32ER71E226ME15L | Capacitor_SMD:C_1210_3225Metric | Assigned |
| C113 | 220uF | EEHZA1E221P | Capacitor_SMD:CP_Elec_8x10.5 | Assigned |
| C119 | 10nF | CGA2B3X7R1H103K050BB | Capacitor_SMD:C_0402_1005Metric | Assigned |
| C40 | 0.1uF | C1608X7R1H104K080AA | Capacitor_SMD:C_0603_1608Metric | Assigned |
| C41 | 100uF | EEHZA1V101P | Capacitor_SMD:CP_Elec_8x10.5 | Assigned |
| C42 | 0.1uF | C1608X7R1H104K080AA | Capacitor_SMD:C_0603_1608Metric | Assigned |
| L10 | 4.7uH | XAL1010-472MEB | Inductor_SMD:L_Coilcraft_XAL1010-XXX | Assigned |
| Q100 | CSD18542KTTT | CSD18542KTTT | Package_TO_SOT_SMD:TO-263-3_TabPin2 | Assigned |
| Q101 | CSD18542KTTT | CSD18542KTTT | Package_TO_SOT_SMD:TO-263-3_TabPin2 | Assigned |
| R100 | 150k | CRCW0402150KFKED | Resistor_SMD:R_0402_1005Metric | Assigned |
| R101 | 24.9k | CRCW040224K9FKED | Resistor_SMD:R_0402_1005Metric | Assigned |
| R102 | 49.9k | CRCW040249K9FKED | Resistor_SMD:R_0402_1005Metric | Assigned |
| R103 | 6.8m | WSL25126L800FEA | Resistor_SMD:R_2512_6332Metric | Assigned |
| R104 | 100k | CRCW0402100KFKED | Resistor_SMD:R_0402_1005Metric | Assigned |
| R105 | 11.1k | CRCW040211K1FKED | Resistor_SMD:R_0402_1005Metric | Assigned |
| R106 | 10k | CRCW040210K0FKED | Resistor_SMD:R_0402_1005Metric | Assigned |
| R112 | 24.9k | CRCW040224K9FKED | Resistor_SMD:R_0402_1005Metric | Assigned |
| R113 | 24.9k | CRCW040224K9FKED | Resistor_SMD:R_0402_1005Metric | Assigned |
| R114 | 1R | CRCW06031R00FKEA | Resistor_SMD:R_0603_1608Metric | Assigned |
| R115 | 1R | CRCW06031R00FKEA | Resistor_SMD:R_0603_1608Metric | Assigned |
| TP22 | +12V | — | TestPoint:TestPoint_Plated_Hole_D2.0mm | Fabricated; not BOM |
| U10 | TPS552882RPMR | TPS552882RPMR | DIC_Board:Texas_RPM0026A_TPS552882 | Assigned |

## /Power/2V8/

| Reference | Value | MPN | Footprint | Status |
|---|---|---|---|---|
| C130 | 10uF | CGA5L1X7R1H106K160AC | Capacitor_SMD:C_1206_3216Metric | Assigned |
| C131 | 10uF | CGA5L1X7R1H106K160AC | Capacitor_SMD:C_1206_3216Metric | Assigned |
| C133 | 47uF | GRM32ER61A476ME20L | Capacitor_SMD:C_1210_3225Metric | Assigned |
| C134 | 47uF | GRM32ER61A476ME20L | Capacitor_SMD:C_1210_3225Metric | Assigned |
| C36 | 0.1uF | C1608X7R1H104K080AA | Capacitor_SMD:C_0603_1608Metric | Assigned |
| C37 | 0.1uF | C1608X7R1H104K080AA | Capacitor_SMD:C_0603_1608Metric | Assigned |
| C904 | 180uF 16V | 16SVPF180M | Capacitor_SMD:CP_Elec_6.3x5.9 | Assigned |
| R123 | 10k | CRCW040210K0FKED | Resistor_SMD:R_0402_1005Metric | Assigned |
| R124 | 5.56k | CRCW04025K56FKED | Resistor_SMD:R_0402_1005Metric | Assigned |
| R20 | 100k | CRCW0402100KFKED | Resistor_SMD:R_0402_1005Metric | Assigned |
| TP26 | +2V8 | — | TestPoint:TestPoint_Plated_Hole_D2.0mm | Fabricated; not BOM |
| U14 | TPSM53603RDAR | TPSM53603RDAR | Package_DFN_QFN:Texas_B3QFN-14-1EP_5x5.5mm_P0.65mm_ThermalVia | Assigned |

## /Power/3V3/

| Reference | Value | MPN | Footprint | Status |
|---|---|---|---|---|
| C115 | 10uF | CGA5L1X7R1H106K160AC | Capacitor_SMD:C_1206_3216Metric | Assigned |
| C116 | 10uF | CGA5L1X7R1H106K160AC | Capacitor_SMD:C_1206_3216Metric | Assigned |
| C117 | 47uF | GRM32ER61A476ME20L | Capacitor_SMD:C_1210_3225Metric | Assigned |
| C118 | 47uF | GRM32ER61A476ME20L | Capacitor_SMD:C_1210_3225Metric | Assigned |
| C34 | 0.1uF | C1608X7R1H104K080AA | Capacitor_SMD:C_0603_1608Metric | Assigned |
| C35 | 0.1uF | C1608X7R1H104K080AA | Capacitor_SMD:C_0603_1608Metric | Assigned |
| C901 | 180uF 16V | 16SVPF180M | Capacitor_SMD:CP_Elec_6.3x5.9 | Assigned |
| R109 | 10k | CRCW040210K0FKED | Resistor_SMD:R_0402_1005Metric | Assigned |
| R110 | 4.32k | CRCW04024K32FKED | Resistor_SMD:R_0402_1005Metric | Assigned |
| TP23 | +3V3 | — | TestPoint:TestPoint_Plated_Hole_D2.0mm | Fabricated; not BOM |
| U11 | TPSM53603RDAR | TPSM53603RDAR | Package_DFN_QFN:Texas_B3QFN-14-1EP_5x5.5mm_P0.65mm_ThermalVia | Assigned |

## /Power/5V/

| Reference | Value | MPN | Footprint | Status |
|---|---|---|---|---|
| C121 | 10uF | CGA5L1X7R1H106K160AC | Capacitor_SMD:C_1206_3216Metric | Assigned |
| C122 | 10uF | CGA5L1X7R1H106K160AC | Capacitor_SMD:C_1206_3216Metric | Assigned |
| C123 | 47uF | GRM32ER61A476ME20L | Capacitor_SMD:C_1210_3225Metric | Assigned |
| C124 | 47uF | GRM32ER61A476ME20L | Capacitor_SMD:C_1210_3225Metric | Assigned |
| C38 | 0.1uF | C1608X7R1H104K080AA | Capacitor_SMD:C_0603_1608Metric | Assigned |
| C39 | 0.1uF | C1608X7R1H104K080AA | Capacitor_SMD:C_0603_1608Metric | Assigned |
| C902 | 180uF 16V | 16SVPF180M | Capacitor_SMD:CP_Elec_6.3x5.9 | Assigned |
| R116 | 10k | CRCW040210K0FKED | Resistor_SMD:R_0402_1005Metric | Assigned |
| R117 | 2.49k | CRCW04022K49FKED | Resistor_SMD:R_0402_1005Metric | Assigned |
| R21 | 100k | CRCW0402100KFKED | Resistor_SMD:R_0402_1005Metric | Assigned |
| TP24 | +5V | — | TestPoint:TestPoint_Plated_Hole_D2.0mm | Fabricated; not BOM |
| U12 | TPSM53603RDAR | TPSM53603RDAR | Package_DFN_QFN:Texas_B3QFN-14-1EP_5x5.5mm_P0.65mm_ThermalVia | Assigned |

## /Power/6V6/

| Reference | Value | MPN | Footprint | Status |
|---|---|---|---|---|
| C126 | 10uF | CGA5L1X7R1H106K160AC | Capacitor_SMD:C_1206_3216Metric | Assigned |
| C127 | 10uF | CGA5L1X7R1H106K160AC | Capacitor_SMD:C_1206_3216Metric | Assigned |
| C128 | 47uF | GRM32ER61A476ME20L | Capacitor_SMD:C_1210_3225Metric | Assigned |
| C129 | 47uF | GRM32ER61A476ME20L | Capacitor_SMD:C_1210_3225Metric | Assigned |
| C32 | 0.1uF | C1608X7R1H104K080AA | Capacitor_SMD:C_0603_1608Metric | Assigned |
| C33 | 0.1uF | C1608X7R1H104K080AA | Capacitor_SMD:C_0603_1608Metric | Assigned |
| C903 | 180uF 16V | 16SVPF180M | Capacitor_SMD:CP_Elec_6.3x5.9 | Assigned |
| R119 | 10k | CRCW040210K0FKED | Resistor_SMD:R_0402_1005Metric | Assigned |
| R120 | 1.78k | CRCW04021K78FKED | Resistor_SMD:R_0402_1005Metric | Assigned |
| R22 | 100k | CRCW0402100KFKED | Resistor_SMD:R_0402_1005Metric | Assigned |
| TP25 | +6V6 | — | TestPoint:TestPoint_Plated_Hole_D2.0mm | Fabricated; not BOM |
| U13 | TPSM53603RDAR | TPSM53603RDAR | Package_DFN_QFN:Texas_B3QFN-14-1EP_5x5.5mm_P0.65mm_ThermalVia | Assigned |

## /Pump Control/Acid Pump/

| Reference | Value | MPN | Footprint | Status |
|---|---|---|---|---|
| C320 | 2.2uF 16V | C1608X5R1C225K080AB | Capacitor_SMD:C_0603_1608Metric | Assigned |
| C321 | 22uF 16V | GRM32ER71E226ME15L | Capacitor_SMD:C_1210_3225Metric | Assigned |
| C322 | 10nF | C1608X7R1H103K080AA | Capacitor_SMD:C_0603_1608Metric | Assigned |
| C323 | 1nF | C1608C0G1H102J080AA | Capacitor_SMD:C_0603_1608Metric | Assigned |
| C324 | 22nF | C1608X7R1H223K080AA | Capacitor_SMD:C_0603_1608Metric | Assigned |
| J9 | Conn_01x04 | 0430450400 | Connector_Molex:Molex_Micro-Fit_3.0_43045-0400_2x02_P3.00mm_Horizontal | Assigned |
| R320 | 2.00R 1% | CRCW12062R00FKEA | Resistor_SMD:R_1206_3216Metric | Assigned |
| R321 | 2.00R 1% | CRCW12062R00FKEA | Resistor_SMD:R_1206_3216Metric | Assigned |
| R322 | 18k | CRCW060318K0FKEA | Resistor_SMD:R_0603_1608Metric | Assigned |
| R323 | 18k | CRCW060318K0FKEA | Resistor_SMD:R_0603_1608Metric | Assigned |
| R324 | 20k | CRCW060320K0FKEA | Resistor_SMD:R_0603_1608Metric | Assigned |
| R325 | 20k | CRCW060320K0FKEA | Resistor_SMD:R_0603_1608Metric | Assigned |
| R326 | 47k | CRCW060347K0FKEA | Resistor_SMD:R_0603_1608Metric | Assigned |
| R327 | 1k | CRCW06031K00FKEA | Resistor_SMD:R_0603_1608Metric | Assigned |
| R328 | 2.87k | TNPW06032K87BEEA | Resistor_SMD:R_0603_1608Metric | Assigned |
| R329 | 487R | TNPW0603487RBEEA | Resistor_SMD:R_0603_1608Metric | Assigned |
| RV1 | 10k trim | 3314J-1-103E | Potentiometer_SMD:Potentiometer_Bourns_3314J_Vertical | Assigned |
| U32 | STSPIN220 | STSPIN220 | Package_DFN_QFN:VQFN-16-1EP_3x3mm_P0.5mm_EP1.8x1.8mm | Assigned |

## /Pump Control/Air Pump/

| Reference | Value | MPN | Footprint | Status |
|---|---|---|---|---|
| C303 | 10uF | CGA5L1X7R1H106K160AC | Capacitor_SMD:C_1206_3216Metric | Assigned |
| C304 | 100nF | GRM155R71H104ME14D | Capacitor_SMD:C_0402_1005Metric | Assigned |
| C305 | 22nF | GRM155R71H223KA12D | Capacitor_SMD:C_0402_1005Metric | Assigned |
| D3 | STPS1L40ZF | STPS1L40ZF | Diode_SMD:D_SOD-123F | Assigned |
| J33 | 0430450200 | 0430450200 | Connector_Molex:Molex_Micro-Fit_3.0_43045-0200_2x01_P3.00mm_Horizontal | Assigned |
| R304 | 100k | CRCW0402100KFKED | Resistor_SMD:R_0402_1005Metric | Assigned |
| R305 | 1.00k | CRCW04021K00FKED | Resistor_SMD:R_0402_1005Metric | Assigned |
| U31 | TPS27S100APWPR | TPS27S100APWPR | Package_SO:Texas_HTSSOP-14-1EP_4.4x5mm_P0.65mm_EP3.4x5mm_Mask3.155x3.255mm_ThermalVias | Assigned |

## /Pump Control/Water Pump/

| Reference | Value | MPN | Footprint | Status |
|---|---|---|---|---|
| C300 | 100nF | GRM155R71H104ME14D | Capacitor_SMD:C_0402_1005Metric | Assigned |
| C301 | 10uF | CGA5L1X7R1H106K160AC | Capacitor_SMD:C_1206_3216Metric | Assigned |
| C302 | 22nF | GRM155R71H223KA12D | Capacitor_SMD:C_0402_1005Metric | Assigned |
| D4 | STPS3L60U | STPS3L60U | Diode_SMD:D_SMB | Assigned |
| J30 | 0430450200 | 0430450200 | Connector_Molex:Molex_Micro-Fit_3.0_43045-0200_2x01_P3.00mm_Horizontal | Assigned |
| R301 | 100k | CRCW0402100KFKED | Resistor_SMD:R_0402_1005Metric | Assigned |
| R302 | 1.00k | CRCW04021K00FKED | Resistor_SMD:R_0402_1005Metric | Assigned |
| U30 | TPS27S100APWPR | TPS27S100APWPR | Package_SO:Texas_HTSSOP-14-1EP_4.4x5mm_P0.65mm_EP3.4x5mm_Mask3.155x3.255mm_ThermalVias | Assigned |

## /STM32 MCU/

| Reference | Value | MPN | Footprint | Status |
|---|---|---|---|---|
| BT1 | Battery | — | — | Deferred hardware |
| C1 | 100nF | C1608X7R1H104K080AA | Capacitor_SMD:C_0603_1608Metric | Assigned |
| C10 | 4.7uF | C2012X7R1E475K125AB | Capacitor_SMD:C_0805_2012Metric | Assigned |
| C11 | 100nF | C1608X7R1H104K080AA | Capacitor_SMD:C_0603_1608Metric | Assigned |
| C12 | 100nF | C1608X7R1H104K080AA | Capacitor_SMD:C_0603_1608Metric | Assigned |
| C13 | 4.7uF | C2012X7R1E475K125AB | Capacitor_SMD:C_0805_2012Metric | Assigned |
| C14 | 100nF | C1608X7R1H104K080AA | Capacitor_SMD:C_0603_1608Metric | Assigned |
| C15 | 1uF | C1608X7R1E105K080AB | Capacitor_SMD:C_0603_1608Metric | Assigned |
| C16 | 100nF | C1608X7R1H104K080AA | Capacitor_SMD:C_0603_1608Metric | Assigned |
| C17 | 1uF | C1608X7R1E105K080AB | Capacitor_SMD:C_0603_1608Metric | Assigned |
| C18 | 10nF | C1608X7R1H103K080AA | Capacitor_SMD:C_0603_1608Metric | Assigned |
| C19 | 1uF | C1608X7R1E105K080AB | Capacitor_SMD:C_0603_1608Metric | Assigned |
| C2 | 100nF | C1608X7R1H104K080AA | Capacitor_SMD:C_0603_1608Metric | Assigned |
| C20 | 100nF | C1608X7R1H104K080AA | Capacitor_SMD:C_0603_1608Metric | Assigned |
| C21 | 100nF | C1608X7R1H104K080AA | Capacitor_SMD:C_0603_1608Metric | Assigned |
| C22 | 10nF | C1608X7R1H103K080AA | Capacitor_SMD:C_0603_1608Metric | Assigned |
| C23 | 12pF | C1608C0G1H120J080AA | Capacitor_SMD:C_0603_1608Metric | Assigned |
| C24 | 12pF | C1608C0G1H120J080AA | Capacitor_SMD:C_0603_1608Metric | Assigned |
| C25 | 6.8pF | GRM1555C1H6R8CA01D | Capacitor_SMD:C_0402_1005Metric | Assigned |
| C26 | 6.8pF | GRM1555C1H6R8CA01D | Capacitor_SMD:C_0402_1005Metric | Assigned |
| C27 | 100nF | C1608X7R1H104K080AA | Capacitor_SMD:C_0603_1608Metric | Assigned |
| C28 | 100nF | C1608X7R1H104K080AA | Capacitor_SMD:C_0603_1608Metric | Assigned |
| C29 | 1uF | C1608X7R1E105K080AB | Capacitor_SMD:C_0603_1608Metric | Assigned |
| C3 | 100nF | C1608X7R1H104K080AA | Capacitor_SMD:C_0603_1608Metric | Assigned |
| C30 | 100nF | C1608X7R1H104K080AA | Capacitor_SMD:C_0603_1608Metric | Assigned |
| C31 | 10uF | C2012X7S1C106K125AC | Capacitor_SMD:C_0805_2012Metric | Assigned |
| C4 | 100nF | C1608X7R1H104K080AA | Capacitor_SMD:C_0603_1608Metric | Assigned |
| C43 | 1uF | C1608X7R1E105K080AB | Capacitor_SMD:C_0603_1608Metric | Assigned |
| C5 | 100nF | C1608X7R1H104K080AA | Capacitor_SMD:C_0603_1608Metric | Assigned |
| C6 | 100nF | C1608X7R1H104K080AA | Capacitor_SMD:C_0603_1608Metric | Assigned |
| C7 | 100nF | C1608X7R1H104K080AA | Capacitor_SMD:C_0603_1608Metric | Assigned |
| C8 | 100nF | C1608X7R1H104K080AA | Capacitor_SMD:C_0603_1608Metric | Assigned |
| C9 | 100nF | C1608X7R1H104K080AA | Capacitor_SMD:C_0603_1608Metric | Assigned |
| D1 | RCLAMP0582B | RClamp0582B.TCT | Package_TO_SOT_SMD:SOT-523 | Assigned |
| D2 | RCLAMP0582B | RClamp0582B.TCT | Package_TO_SOT_SMD:SOT-523 | Assigned |
| FB1 | 600R @ 100MHz | BLM18AG601SN1D | Inductor_SMD:L_0603_1608Metric | Assigned |
| J1 | DM3AT-SF-PEJM5 | DM3AT-SF-PEJM5 | Connector_Card:microSD_HC_Hirose_DM3AT-SF-PEJM5 | Assigned |
| J2 | Conn_ARM_JTAG_SWD_10 | — | — | Deferred hardware |
| JP1 | Conn_01x03_Pin | — | — | Deferred hardware |
| P1 | USB_C_Plug_USB2.0 | — | — | Deferred hardware |
| R1 | 47k | CRCW060347K0FKEA | Resistor_SMD:R_0603_1608Metric | Assigned |
| R10 | 47K | CRCW060347K0FKEA | Resistor_SMD:R_0603_1608Metric | Assigned |
| R11 | 47K | CRCW060347K0FKEA | Resistor_SMD:R_0603_1608Metric | Assigned |
| R12 | 47K | CRCW060347K0FKEA | Resistor_SMD:R_0603_1608Metric | Assigned |
| R13 | 47K | CRCW060347K0FKEA | Resistor_SMD:R_0603_1608Metric | Assigned |
| R14 | 10k | CRCW060310K0FKEA | Resistor_SMD:R_0603_1608Metric | Assigned |
| R15 | 22R | CRCW060322R0FKEA | Resistor_SMD:R_0603_1608Metric | Assigned |
| R16 | 22R | CRCW060322R0FKEA | Resistor_SMD:R_0603_1608Metric | Assigned |
| R17 | 22R | CRCW060322R0FKEA | Resistor_SMD:R_0603_1608Metric | Assigned |
| R18 | 22R | CRCW060322R0FKEA | Resistor_SMD:R_0603_1608Metric | Assigned |
| R19 | 470R | CRCW0603470RFKEA | Resistor_SMD:R_0603_1608Metric | Assigned |
| R2 | 10k | CRCW060310K0FKEA | Resistor_SMD:R_0603_1608Metric | Assigned |
| R23 | 33k | CRCW040233K0FKED | Resistor_SMD:R_0402_1005Metric | Assigned |
| R24 | 82k | CRCW040282K0FKED | Resistor_SMD:R_0402_1005Metric | Assigned |
| R25 | 5.1k | CRCW04025K10FKED | Resistor_SMD:R_0402_1005Metric | Assigned |
| R3 | 470R | CRCW0603470RFKEA | Resistor_SMD:R_0603_1608Metric | Assigned |
| R349 | 100k | CRCW0603100KFKEA | Resistor_SMD:R_0603_1608Metric | Assigned |
| R350 | 100k | CRCW0603100KFKEA | Resistor_SMD:R_0603_1608Metric | Assigned |
| R4 | 0R | CRCW06030000Z0EA | Resistor_SMD:R_0603_1608Metric | Assigned |
| R5 | 10k | CRCW060310K0FKEA | Resistor_SMD:R_0603_1608Metric | Assigned |
| R6 | 10k | CRCW060310K0FKEA | Resistor_SMD:R_0603_1608Metric | Assigned |
| R7 | 33R | CRCW060333R0FKEA | Resistor_SMD:R_0603_1608Metric | Assigned |
| R8 | 10k | CRCW060310K0FKEA | Resistor_SMD:R_0603_1608Metric | Assigned |
| R9 | 47K | CRCW060347K0FKEA | Resistor_SMD:R_0603_1608Metric | Assigned |
| SW1 | SW_Push | — | — | Deferred hardware |
| U1 | STM32L476ZGTx | STM32L476ZGT6 | Package_QFP:LQFP-144_20x20mm_P0.5mm | Assigned |
| U2 | AB-RTCMC-32.768kHz-EOA9-S3 | AB-RTCMC-32.768kHz-EOA9-S3 | Package_SON:RTC_SMD_MicroCrystal_C3_2.5x3.7mm | Assigned |
| U3 | APS6404L-3SQRX-SN | APS6404L-3SQRX-SN | Package_SO:SOIC-8_3.9x4.9mm_P1.27mm | Assigned |
| Y1 | ABM8AAIG-8.000MHz-V2R-T3 | ABM8AAIG-8.000MHz-V2R-T3 | DIC_Board:ABM8AAIG-2Pin_3.2x2.5mm | Assigned |
| Y2 | ABS06-107-32.768KHZ-T | ABS06-107-32.768KHZ-T | DIC_Board:ABS06-107-2Pin_2.0x1.2mm | Assigned |

## /Sensors/ADMONT K96/

| Reference | Value | MPN | Footprint | Status |
|---|---|---|---|---|
| C314 | 10uF | CGA5L1X7R1H106K160AC | Capacitor_SMD:C_1206_3216Metric | Assigned |
| C315 | 100nF | GRM155R71H104ME14D | Capacitor_SMD:C_0402_1005Metric | Assigned |
| C316 | 22nF | GRM155R71H223KA12D | Capacitor_SMD:C_0402_1005Metric | Assigned |
| J8 | Conn_01x04 | 0430450400 | Connector_Molex:Molex_Micro-Fit_3.0_43045-0400_2x02_P3.00mm_Horizontal | Assigned |
| R309 | 15k | CRCW040215K0FKED | Resistor_SMD:R_0402_1005Metric | Assigned |
| R310 | 100k | CRCW0402100KFKED | Resistor_SMD:R_0402_1005Metric | Assigned |
| R311 | 1.00k | CRCW04021K00FKED | Resistor_SMD:R_0402_1005Metric | Assigned |
| U35 | TPS27S100APWPR | TPS27S100APWPR | Package_SO:Texas_HTSSOP-14-1EP_4.4x5mm_P0.65mm_EP3.4x5mm_Mask3.155x3.255mm_ThermalVias | Assigned |

## /Sensors/Licor/

| Reference | Value | MPN | Footprint | Status |
|---|---|---|---|---|
| C306 | 10uF | CGA5L1X7R1H106K160AC | Capacitor_SMD:C_1206_3216Metric | Assigned |
| C307 | 100nF | GRM155R71H104ME14D | Capacitor_SMD:C_0402_1005Metric | Assigned |
| C308 | 22nF | GRM155R71H223KA12D | Capacitor_SMD:C_0402_1005Metric | Assigned |
| C309 | 100nF | GRM155R71H104ME14D | Capacitor_SMD:C_0402_1005Metric | Assigned |
| C310 | 100nF | GRM155R71H104ME14D | Capacitor_SMD:C_0402_1005Metric | Assigned |
| C311 | 100nF | GRM155R71H104ME14D | Capacitor_SMD:C_0402_1005Metric | Assigned |
| C312 | 100nF | GRM155R71H104ME14D | Capacitor_SMD:C_0402_1005Metric | Assigned |
| C313 | 100nF | GRM155R71H104ME14D | Capacitor_SMD:C_0402_1005Metric | Assigned |
| J10 | Conn_01x04 | 0430450400 | Connector_Molex:Molex_Micro-Fit_3.0_43045-0400_2x02_P3.00mm_Horizontal | Assigned |
| R307 | 100k | CRCW0402100KFKED | Resistor_SMD:R_0402_1005Metric | Assigned |
| R308 | 1.00k | CRCW04021K00FKED | Resistor_SMD:R_0402_1005Metric | Assigned |
| U33 | TPS27S100APWPR | TPS27S100APWPR | Package_SO:Texas_HTSSOP-14-1EP_4.4x5mm_P0.65mm_EP3.4x5mm_Mask3.155x3.255mm_ThermalVias | Assigned |
| U34 | MAX3226EETE+ | MAX3226EETE+ | Package_DFN_QFN:TQFN-16-1EP_5x5mm_P0.8mm_EP3.1x3.1mm | Assigned |

## /Sensors/O2 Sensor/

| Reference | Value | MPN | Footprint | Status |
|---|---|---|---|---|
| C328 | 10uF | CGA5L1X7R1H106K160AC | Capacitor_SMD:C_1206_3216Metric | Assigned |
| C329 | 100nF | GRM155R71H104ME14D | Capacitor_SMD:C_0402_1005Metric | Assigned |
| C330 | 22nF | GRM155R71H223KA12D | Capacitor_SMD:C_0402_1005Metric | Assigned |
| J7 | Conn_01x04 | 0430450400 | Connector_Molex:Molex_Micro-Fit_3.0_43045-0400_2x02_P3.00mm_Horizontal | Assigned |
| R340 | 15k | CRCW040215K0FKED | Resistor_SMD:R_0402_1005Metric | Assigned |
| R341 | 100k | CRCW0402100KFKED | Resistor_SMD:R_0402_1005Metric | Assigned |
| R342 | 1.00k | CRCW04021K00FKED | Resistor_SMD:R_0402_1005Metric | Assigned |
| U38 | TPS27S100APWPR | TPS27S100APWPR | Package_SO:Texas_HTSSOP-14-1EP_4.4x5mm_P0.65mm_EP3.4x5mm_Mask3.155x3.255mm_ThermalVias | Assigned |

## /Sensors/RH Sensor/

| Reference | Value | MPN | Footprint | Status |
|---|---|---|---|---|
| J6 | Conn_01x04 | 0430450400 | Connector_Molex:Molex_Micro-Fit_3.0_43045-0400_2x02_P3.00mm_Horizontal | Assigned |
| R343 | 4.7k | CRCW06034K70FKEA | Resistor_SMD:R_0603_1608Metric | Assigned |
| R344 | 4.7k | CRCW06034K70FKEA | Resistor_SMD:R_0603_1608Metric | Assigned |

## /Valve Control/

| Reference | Value | MPN | Footprint | Status |
|---|---|---|---|---|
| J3 | 0430451200 | 0430451200 | DIC_Board:Molex_Micro-Fit_3.0_43045-1200_2x06_P3.00mm_Horizontal | Assigned |
| J4 | 0430451200 | 0430451200 | DIC_Board:Molex_Micro-Fit_3.0_43045-1200_2x06_P3.00mm_Horizontal | Assigned |

## /Valve Control/Valve Control Bank 1/

| Reference | Value | MPN | Footprint | Status |
|---|---|---|---|---|
| C200 | 0.47uF | CGA3E3X7R1H474K080AE | Capacitor_SMD:C_0603_1608Metric_Pad1.08x0.95mm_HandSolder | Assigned |
| C201 | 0.01uF | C0603C103K2RACTU | Capacitor_SMD:C_0603_1608Metric_Pad1.08x0.95mm_HandSolder | Assigned |
| C202 | 0.1uF | C0603X104K5RAC7867 | Capacitor_SMD:C_0603_1608Metric_Pad1.08x0.95mm_HandSolder | Assigned |
| C203 | 0.1uF | C0603X104K5RAC7867 | Capacitor_SMD:C_0603_1608Metric_Pad1.08x0.95mm_HandSolder | Assigned |
| C204 | 0.33mF | URZ1H331MHD1TO | Capacitor_THT:CP_Radial_D12.5mm_P5.00mm | Assigned |
| R318 | 3.3R | CRCW04023R30FKEDHP | Resistor_SMD:R_0402_1005Metric | Assigned |
| R319 | 3.3R | CRCW04023R30FKEDHP | Resistor_SMD:R_0402_1005Metric | Assigned |
| R330 | 3.3R | CRCW04023R30FKEDHP | Resistor_SMD:R_0402_1005Metric | Assigned |
| R331 | 3.3R | CRCW04023R30FKEDHP | Resistor_SMD:R_0402_1005Metric | Assigned |
| U20 | DRV8823QDCARQ1 | DRV8823QDCARQ1 | DIC_Board:DRV8823_DCA48_ReviewFixed | Assigned |

## /Valve Control/Valve Control Bank 2/

| Reference | Value | MPN | Footprint | Status |
|---|---|---|---|---|
| C210 | 0.47uF | CGA3E3X7R1H474K080AE | Capacitor_SMD:C_0603_1608Metric_Pad1.08x0.95mm_HandSolder | Assigned |
| C211 | 0.01uF | C0603C103K2RACTU | Capacitor_SMD:C_0603_1608Metric_Pad1.08x0.95mm_HandSolder | Assigned |
| C212 | 0.1uF | C0603X104K5RAC7867 | Capacitor_SMD:C_0603_1608Metric_Pad1.08x0.95mm_HandSolder | Assigned |
| C213 | 0.1uF | C0603X104K5RAC7867 | Capacitor_SMD:C_0603_1608Metric_Pad1.08x0.95mm_HandSolder | Assigned |
| C214 | 0.33mF | URZ1H331MHD1TO | Capacitor_THT:CP_Radial_D12.5mm_P5.00mm | Assigned |
| R332 | 3.3R | CRCW04023R30FKEDHP | Resistor_SMD:R_0402_1005Metric | Assigned |
| R333 | 3.3R | CRCW04023R30FKEDHP | Resistor_SMD:R_0402_1005Metric | Assigned |
| R334 | 3.3R | CRCW04023R30FKEDHP | Resistor_SMD:R_0402_1005Metric | Assigned |
| R335 | 3.3R | CRCW04023R30FKEDHP | Resistor_SMD:R_0402_1005Metric | Assigned |
| U21 | DRV8823QDCARQ1 | DRV8823QDCARQ1 | DIC_Board:DRV8823_DCA48_ReviewFixed | Assigned |

## /Valve Control/Valve Control Bank 3/

| Reference | Value | MPN | Footprint | Status |
|---|---|---|---|---|
| C220 | 0.47uF | CGA3E3X7R1H474K080AE | Capacitor_SMD:C_0603_1608Metric_Pad1.08x0.95mm_HandSolder | Assigned |
| C221 | 0.01uF | C0603C103K2RACTU | Capacitor_SMD:C_0603_1608Metric_Pad1.08x0.95mm_HandSolder | Assigned |
| C222 | 0.1uF | C0603X104K5RAC7867 | Capacitor_SMD:C_0603_1608Metric_Pad1.08x0.95mm_HandSolder | Assigned |
| C223 | 0.1uF | C0603X104K5RAC7867 | Capacitor_SMD:C_0603_1608Metric_Pad1.08x0.95mm_HandSolder | Assigned |
| C224 | 0.33mF | URZ1H331MHD1TO | Capacitor_THT:CP_Radial_D12.5mm_P5.00mm | Assigned |
| R336 | 3.3R | CRCW04023R30FKEDHP | Resistor_SMD:R_0402_1005Metric | Assigned |
| R337 | 3.3R | CRCW04023R30FKEDHP | Resistor_SMD:R_0402_1005Metric | Assigned |
| R338 | 3.3R | CRCW04023R30FKEDHP | Resistor_SMD:R_0402_1005Metric | Assigned |
| R339 | 3.3R | CRCW04023R30FKEDHP | Resistor_SMD:R_0402_1005Metric | Assigned |
| U22 | DRV8823QDCARQ1 | DRV8823QDCARQ1 | DIC_Board:DRV8823_DCA48_ReviewFixed | Assigned |

## Connector pin maps

Board-side numbering. Match to controlled mating-harness drawings before connecting external equipment.

### J1

- Pin 4: `+3V3`
- Pin 6: `GND`
- Pin 9: `GND`
- Pin SH: `GND`
- Pin 5: `Net-(J1-CLK)`
- Pin 3: `SDMMC1_CMD`
- Pin 7: `SDMMC1_D0`
- Pin 8: `SDMMC1_D1`
- Pin 1: `SDMMC1_D2`
- Pin 2: `SDMMC1_D3`
- Pin 10: `SD_DETECT_N`

### J2

- Pin 3: `GND`
- Pin 5: `GND`
- Pin 9: `GND`
- Pin 4: `Net-(J2-SWCLK/TCK)`
- Pin 2: `Net-(J2-SWDIO/TMS)`
- Pin 6: `Net-(J2-SWO/TDO)`
- Pin 1: `Net-(J2-VTref)`
- Pin 10: `Net-(J2-~{RESET})`
- Pin 7: `unconnected-(J2-KEY-Pad7)`
- Pin 8: `unconnected-(J2-NC/TDI-Pad8)`

### JP1

- Pin 3: `+3V3`
- Pin 2: `BOOT0`
- Pin 1: `GND`

### P1

- Pin A1: `GND`
- Pin A12: `GND`
- Pin B1: `GND`
- Pin B12: `GND`
- Pin SH: `GND`
- Pin A5: `Net-(D2-K1)`
- Pin A4: `Net-(D2-K2)`
- Pin A9: `Net-(D2-K2)`
- Pin B4: `Net-(D2-K2)`
- Pin B9: `Net-(D2-K2)`
- Pin A7: `USB_OTG_FS_DM`
- Pin A6: `USB_OTG_FS_DP`
- Pin B5: `unconnected-(P1-VCONN-PadB5)`

### J31

- Pin 1: `GND`
- Pin 2: `Net-(J31-Pin_2)`

### J10

- Pin 1: `GND`
- Pin 2: `Net-(J10-Pin_2)`
- Pin 3: `Net-(J10-Pin_3)`
- Pin 4: `Net-(J10-Pin_4)`

### J6

- Pin 4: `+3V3`
- Pin 3: `/STM32 MCU/RH_SCL`
- Pin 2: `/STM32 MCU/RH_SDA`
- Pin 1: `GND`

### J7

- Pin 3: `/STM32 MCU/O2_SENSOR_RX`
- Pin 2: `/STM32 MCU/O2_SENSOR_TX`
- Pin 1: `GND`
- Pin 4: `Net-(J7-Pin_4)`

### J8

- Pin 3: `/STM32 MCU/ADMONT_RX`
- Pin 2: `/STM32 MCU/ADMONT_TX`
- Pin 1: `GND`
- Pin 4: `Net-(J8-Pin_4)`

### J30

- Pin 1: `GND`
- Pin 2: `Net-(D4-K)`

### J9

- Pin 1: `Net-(J9-Pin_1)`
- Pin 2: `Net-(J9-Pin_2)`
- Pin 3: `Net-(J9-Pin_3)`
- Pin 4: `Net-(J9-Pin_4)`

### J33

- Pin 1: `GND`
- Pin 2: `Net-(D3-K)`

### J3

- Pin 1: `/Valve Control/Valve Control Bank 1/VALVE1_A`
- Pin 2: `/Valve Control/Valve Control Bank 1/VALVE1_B`
- Pin 3: `/Valve Control/Valve Control Bank 1/VALVE2_A`
- Pin 4: `/Valve Control/Valve Control Bank 1/VALVE2_B`
- Pin 5: `/Valve Control/Valve Control Bank 1/VALVE3_A`
- Pin 6: `/Valve Control/Valve Control Bank 1/VALVE3_B`
- Pin 7: `/Valve Control/Valve Control Bank 1/VALVE4_A`
- Pin 8: `/Valve Control/Valve Control Bank 1/VALVE4_B`
- Pin 9: `/Valve Control/Valve Control Bank 2/VALVE5_A`
- Pin 10: `/Valve Control/Valve Control Bank 2/VALVE5_B`
- Pin 11: `/Valve Control/Valve Control Bank 2/VALVE6_A`
- Pin 12: `/Valve Control/Valve Control Bank 2/VALVE6_B`

### J4

- Pin 1: `/Valve Control/Valve Control Bank 2/VALVE7_A`
- Pin 2: `/Valve Control/Valve Control Bank 2/VALVE7_B`
- Pin 3: `/Valve Control/Valve Control Bank 2/VALVE8_A`
- Pin 4: `/Valve Control/Valve Control Bank 2/VALVE8_B`
- Pin 5: `/Valve Control/Valve Control Bank 3/VALVE9_A`
- Pin 6: `/Valve Control/Valve Control Bank 3/VALVE9_B`
- Pin 7: `/Valve Control/Valve Control Bank 3/VALVE10_A`
- Pin 8: `/Valve Control/Valve Control Bank 3/VALVE10_B`
- Pin 9: `/Valve Control/Valve Control Bank 3/VALVE11_A`
- Pin 10: `/Valve Control/Valve Control Bank 3/VALVE11_B`
- Pin 11: `/Valve Control/Valve Control Bank 3/VALVE12_A`
- Pin 12: `/Valve Control/Valve Control Bank 3/VALVE12_B`

### J5

- Pin 5: `/Actuators/ACTUATOR_1_CURRENT`
- Pin 4: `/Actuators/ACTUATOR_1_POS`
- Pin 3: `/Actuators/ACTUATOR_1_PWM`
- Pin 10: `/Actuators/ACTUATOR_2_CURRENT`
- Pin 9: `/Actuators/ACTUATOR_2_POS`
- Pin 8: `/Actuators/ACTUATOR_2_PWM`
- Pin 1: `GND`
- Pin 6: `GND`
- Pin 2: `Net-(J5-Pin_2)`
- Pin 7: `Net-(J5-Pin_7)`

### J11

- Pin 1: `GND`
- Pin 2: `Net-(J11-Pin_2)`
- Pin 3: `Net-(J11-Pin_3)`
- Pin 4: `unconnected-(J11-Pin_4-Pad4)`

### J12

- Pin 1: `GND`
- Pin 2: `Net-(J12-Pin_2)`
- Pin 3: `Net-(J12-Pin_3)`
- Pin 4: `Net-(J12-Pin_4)`

### J13

- Pin 1: `+3V3`
- Pin 3: `+5V`
- Pin 5: `+12V`
- Pin 2: `Net-(D5-K)`
- Pin 4: `Net-(D5-K)`
