jkurina86/DIC_Board/Reviews/updated-schematic-2026-09-11.pdf

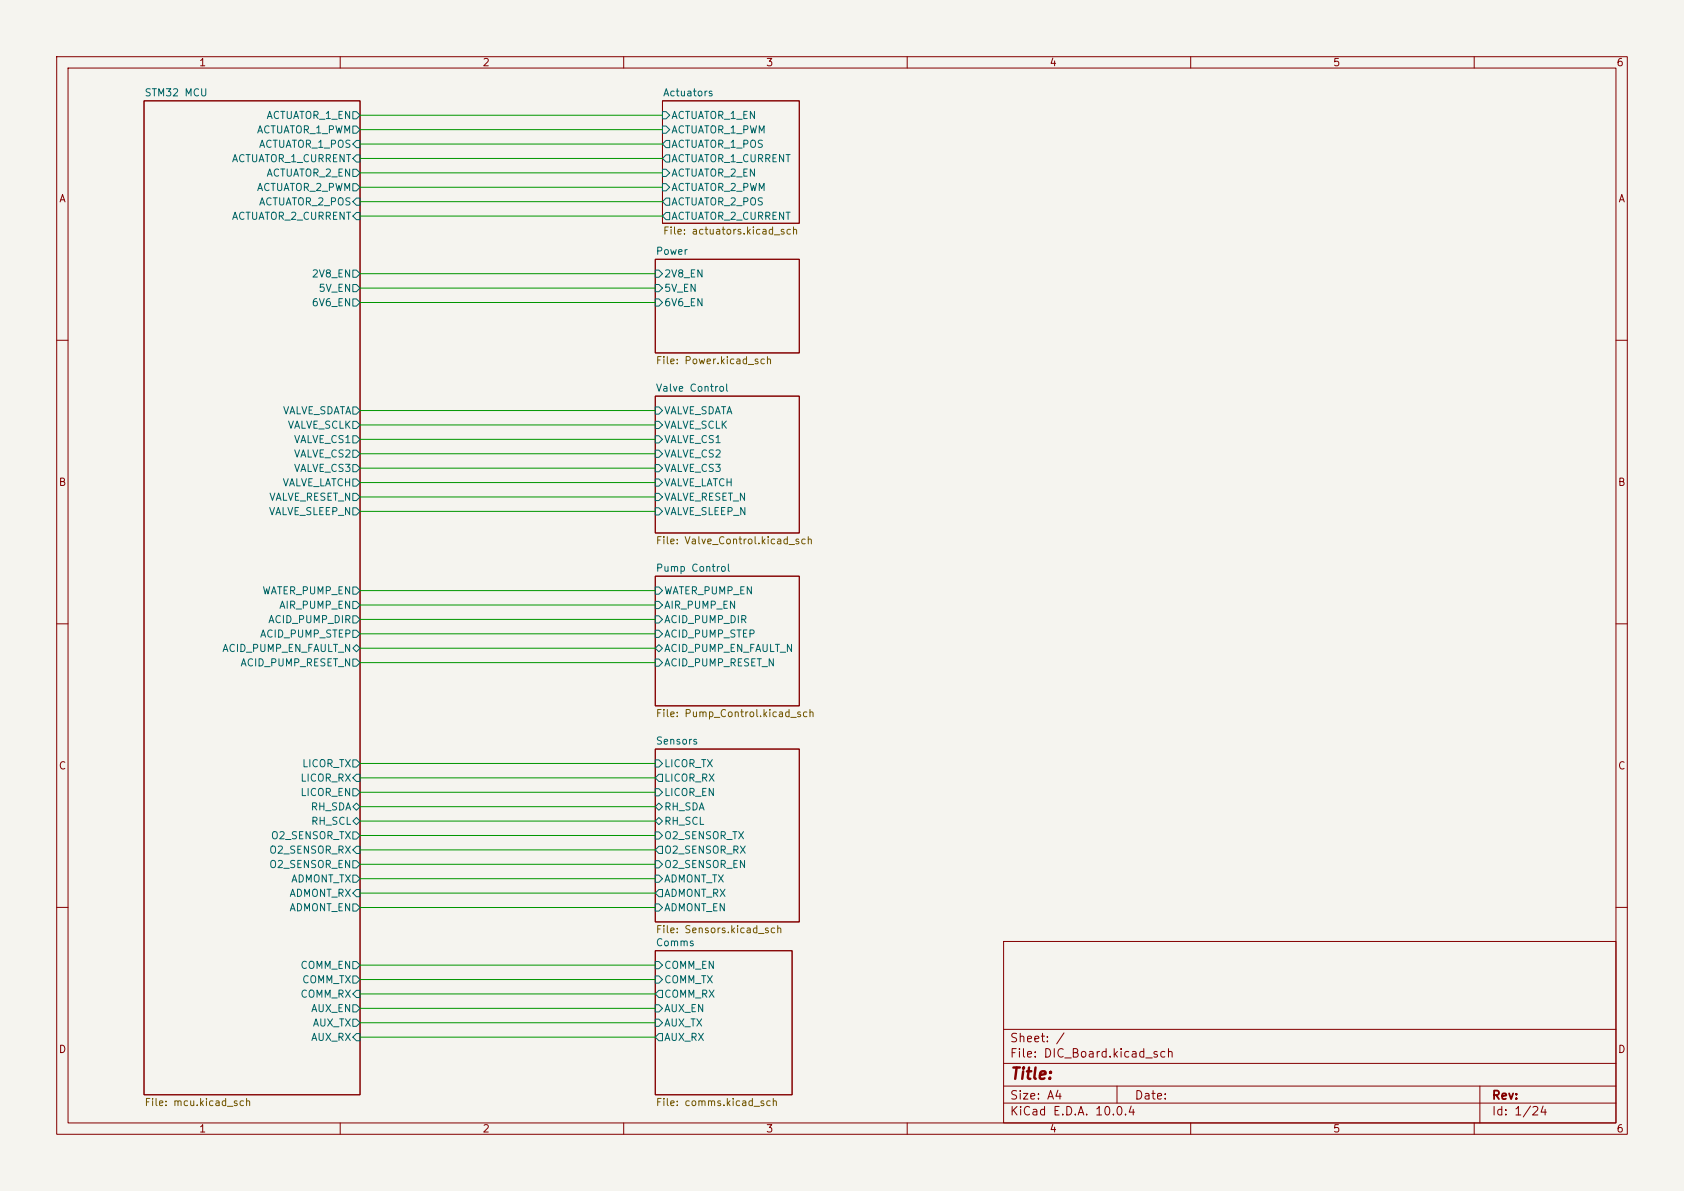
[picture p5: page 1]

Size: A4 | Rev:
KiCad E.D.A. 10.0.4 | Id: 1/24

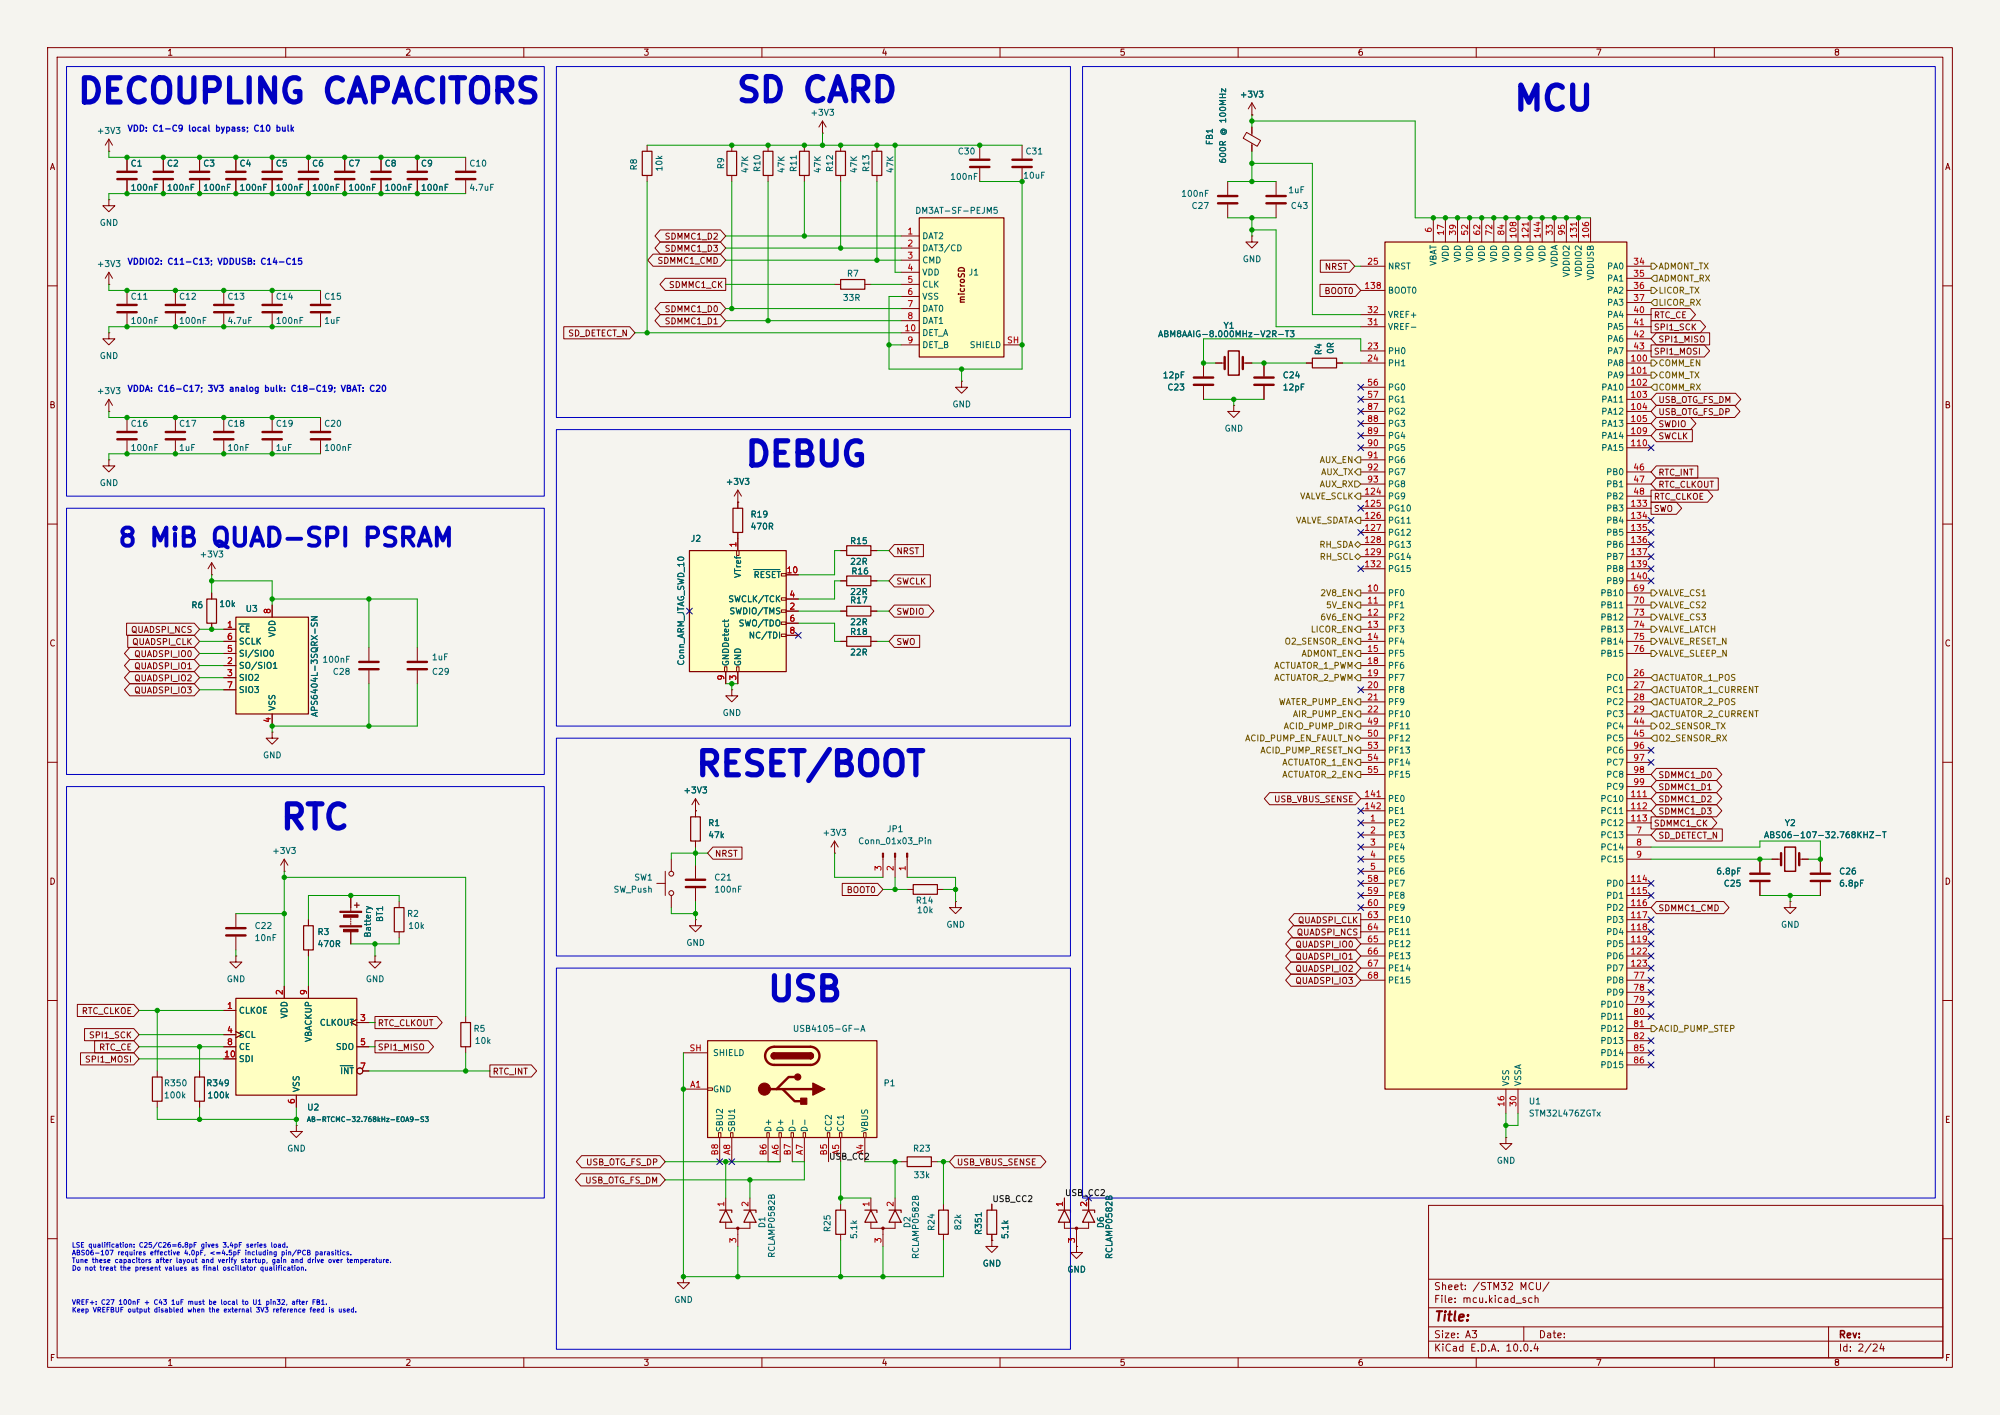
[picture p6: page 2]

VDD: C1-C9 local bypass; C10 bulk DECOUPLING CAPACITORS
100nF GND

DAT2 1 DAT3/CD 2 CMD 3

R7 | VDD 4 CLK 5

Size: A3 | Rev:

F Date:

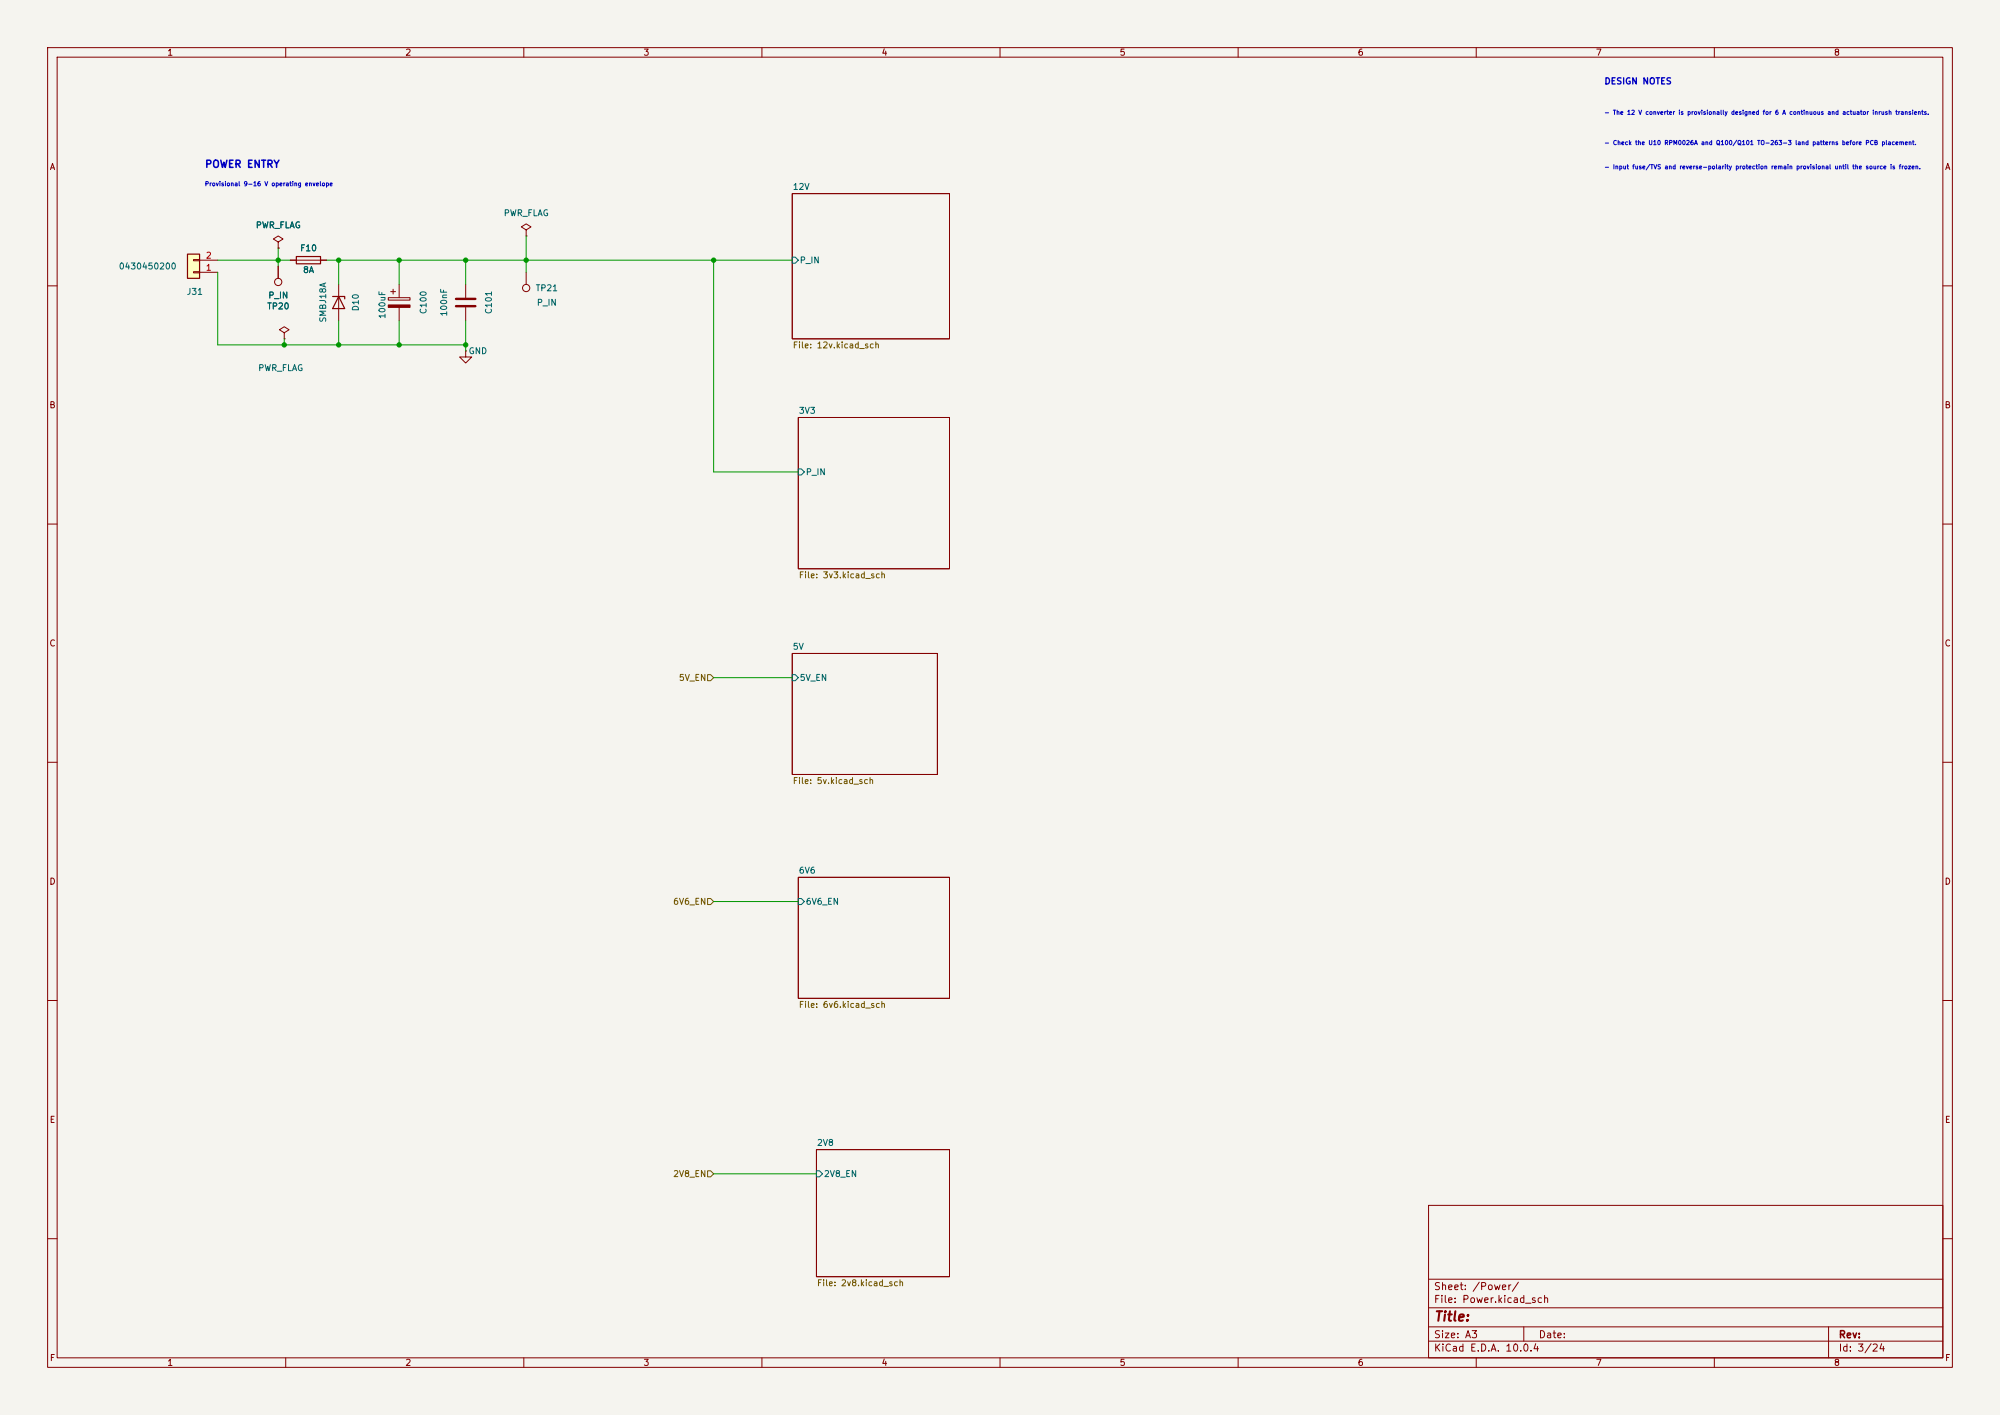
[picture p7: page 3]

Size: A3 | Rev:

F Date:

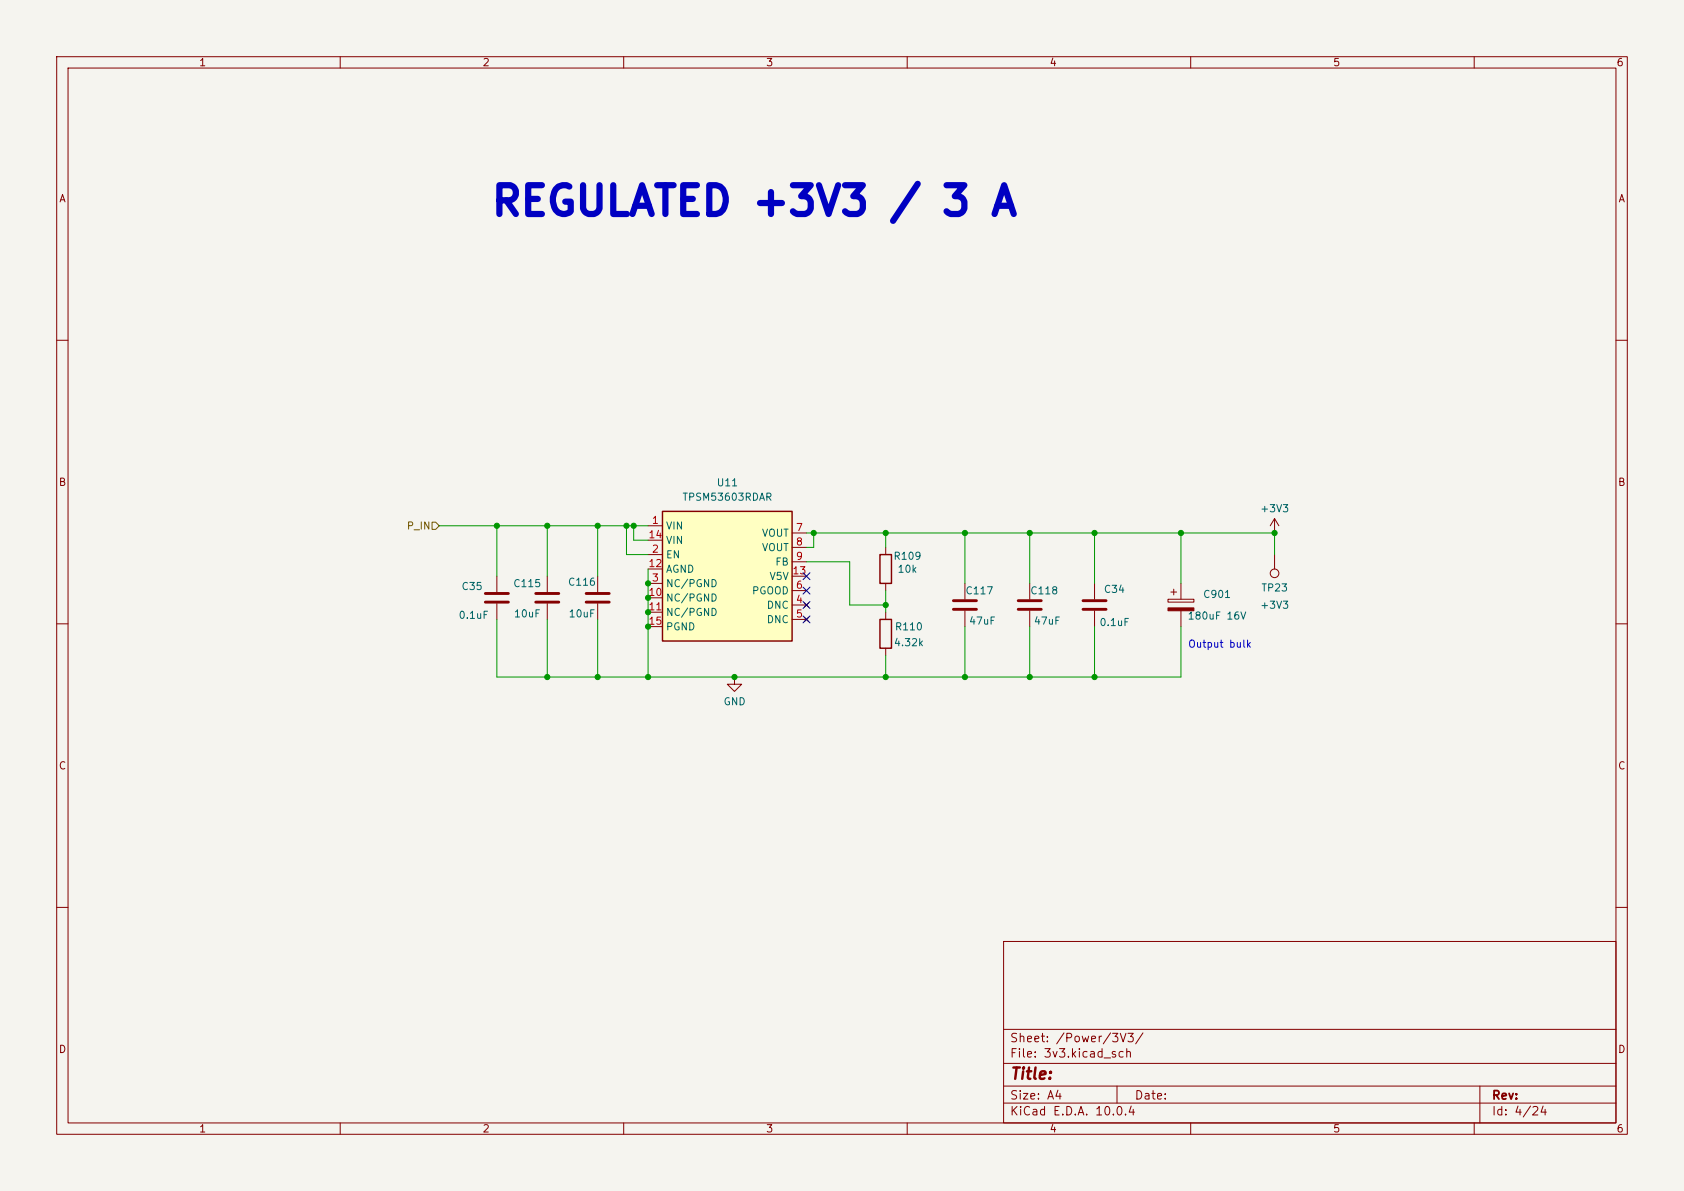
[picture p8: page 4]

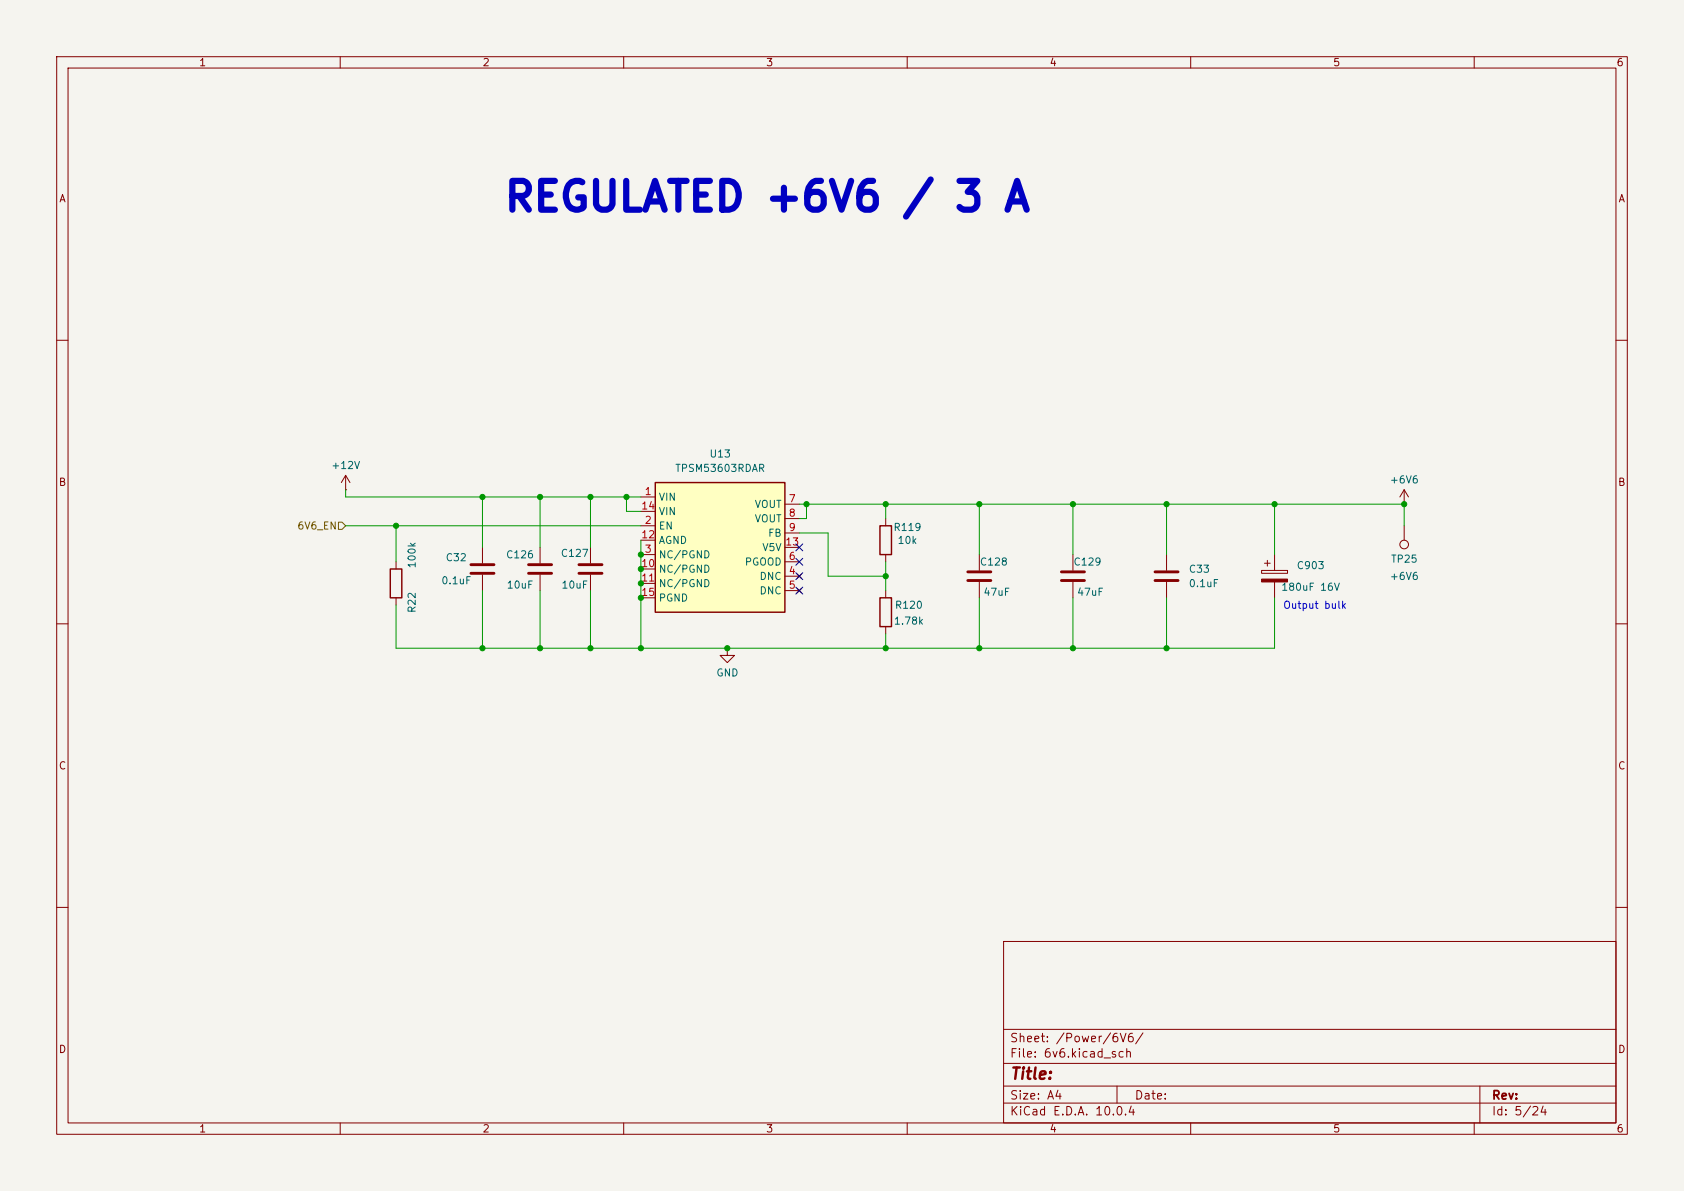
[picture p9: page 5]

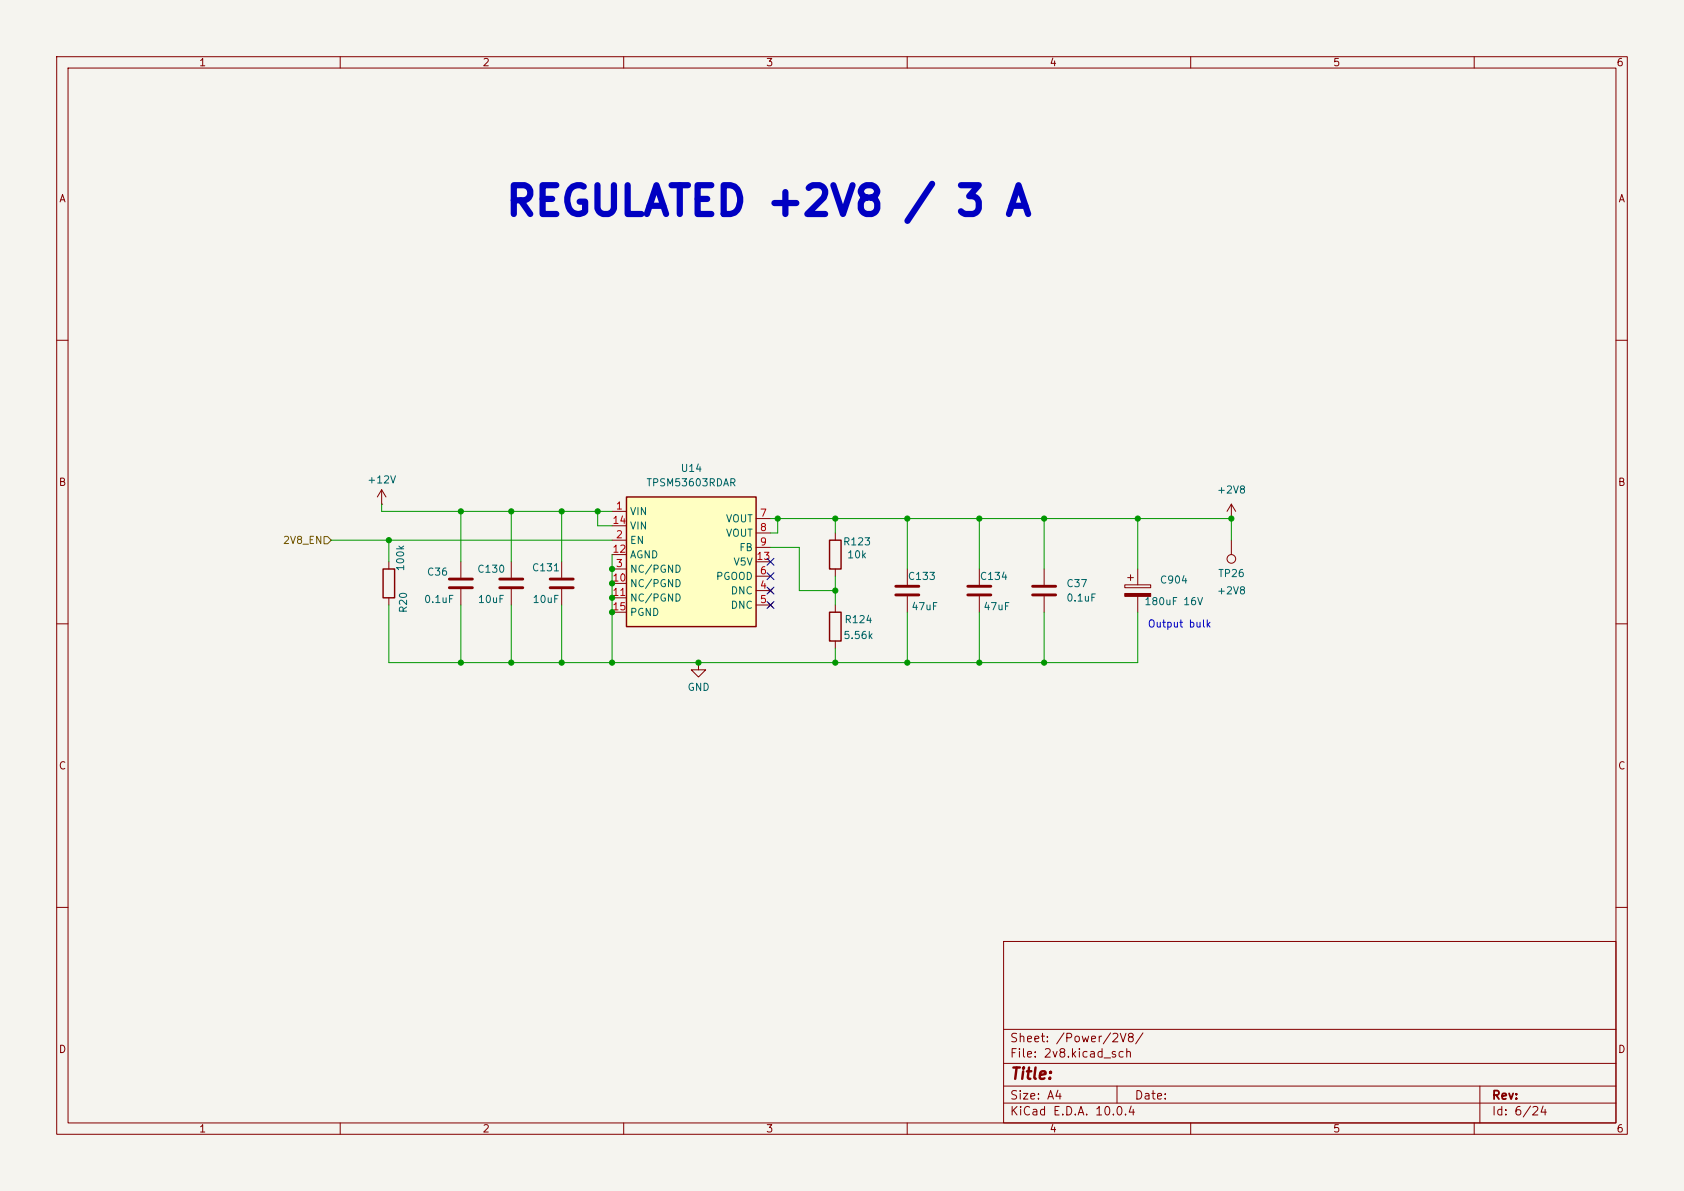
[picture p10: page 6]

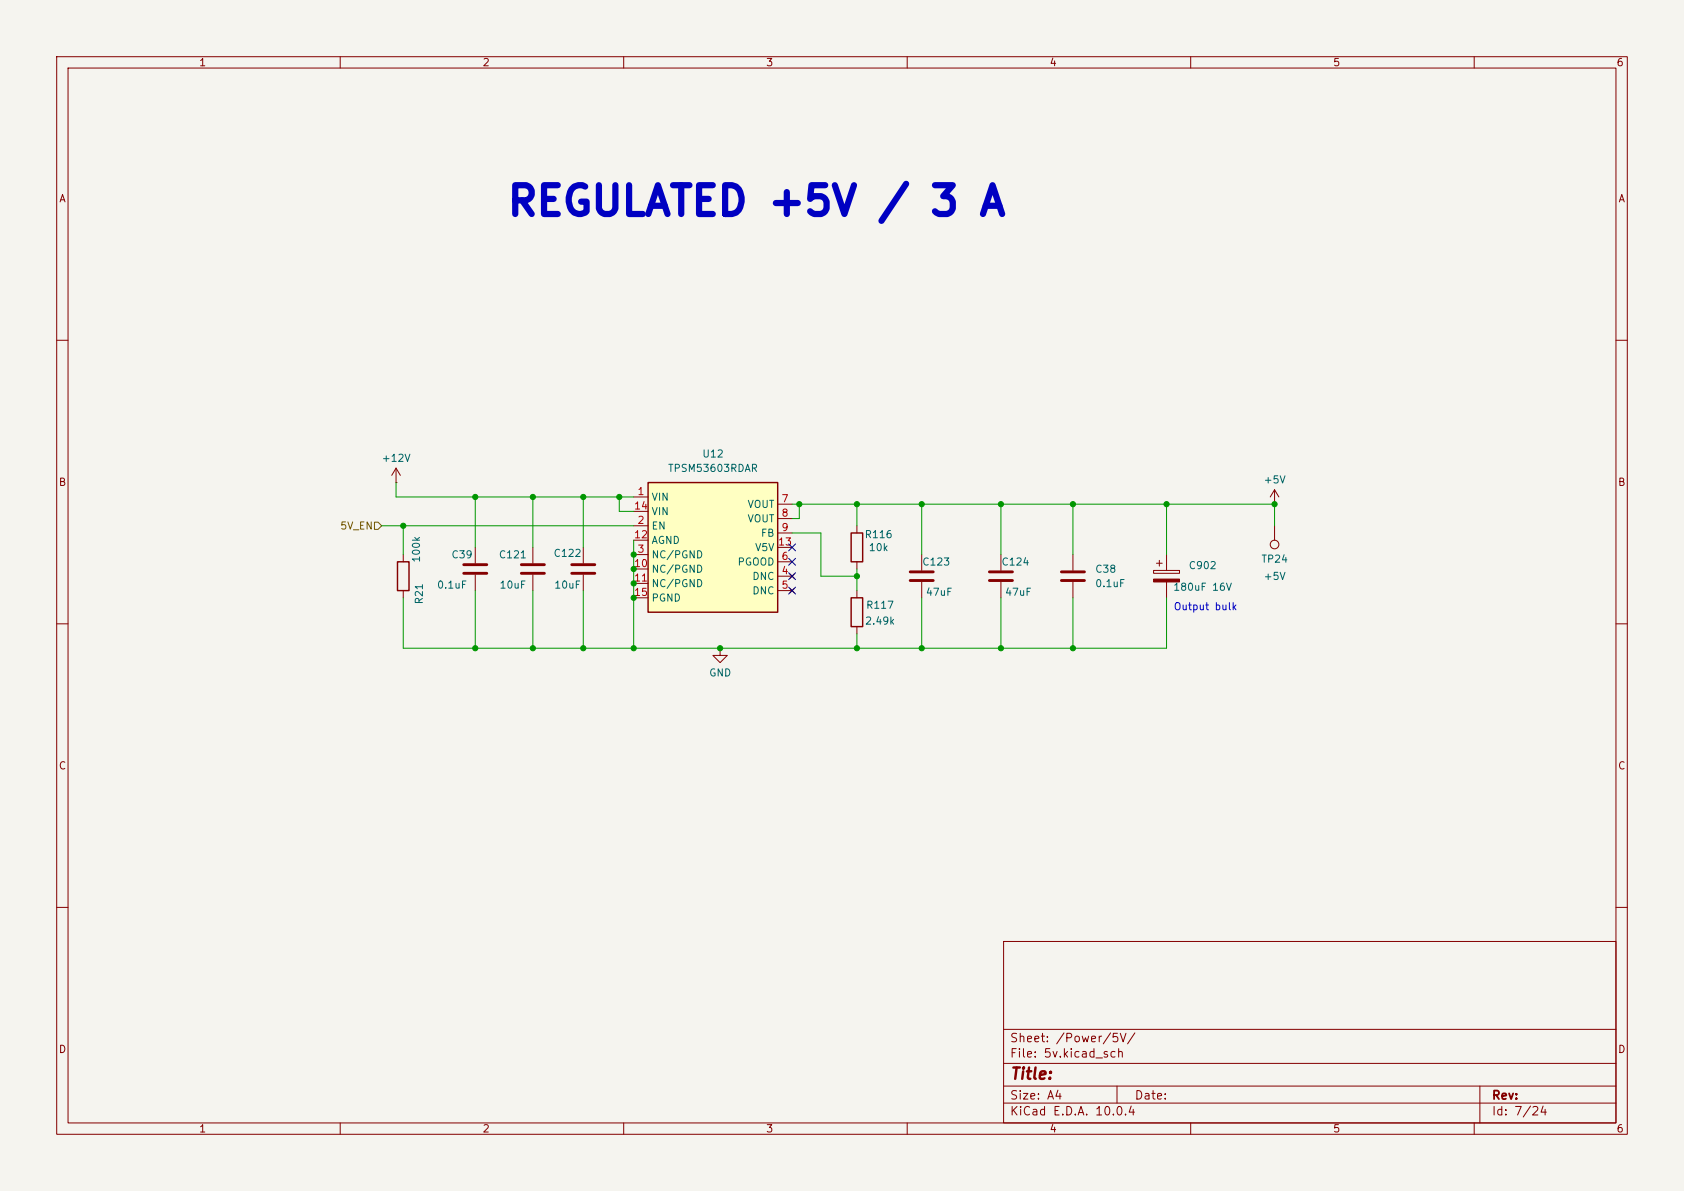
[picture p11: page 7]

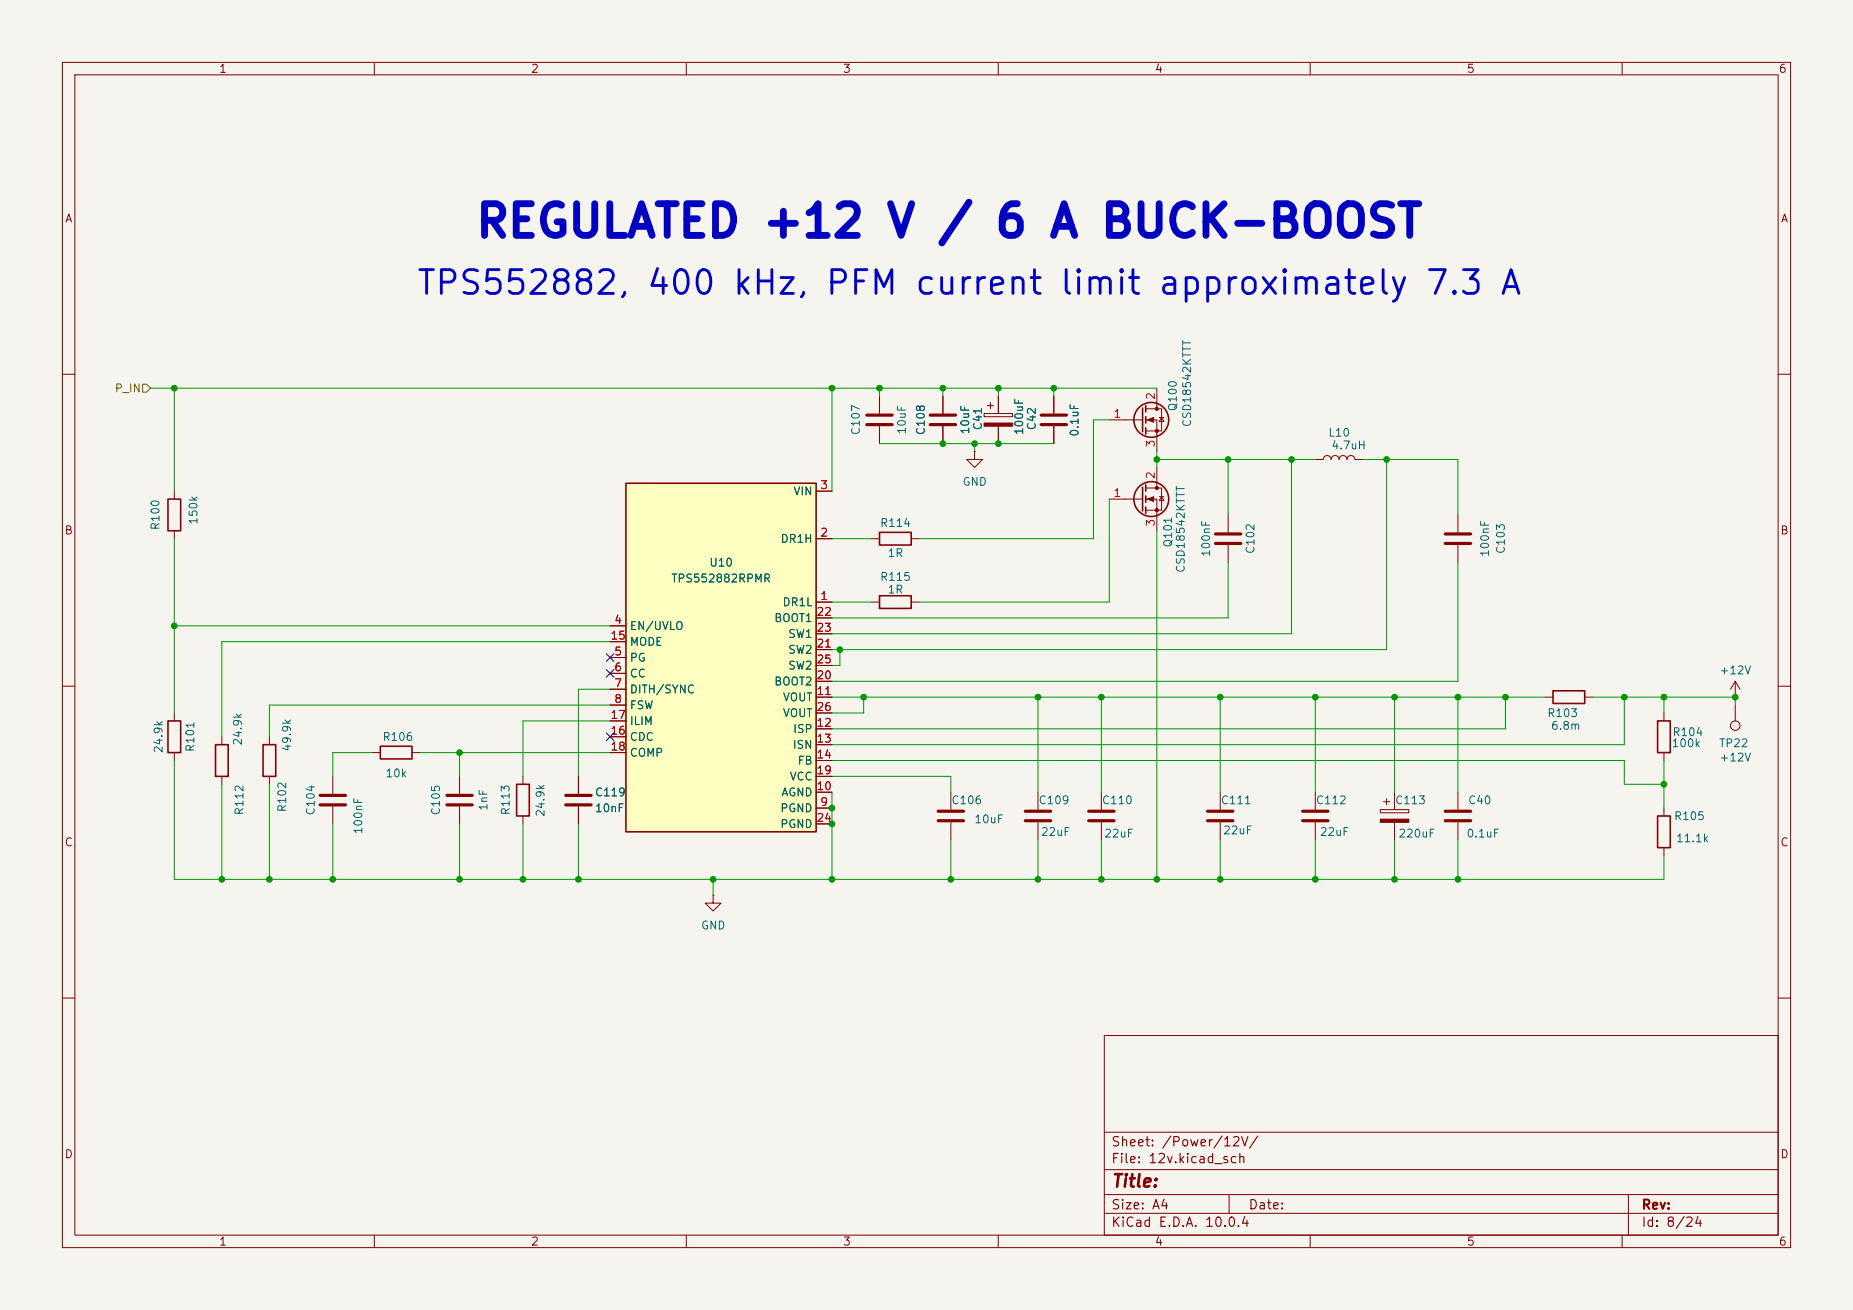
[picture p12: page 8]

TPS552882, 400 kHz, PFM current limit approximately 7.3 A

FB 14 MODE 15 CDC 16 ILIM 17 COMP 18

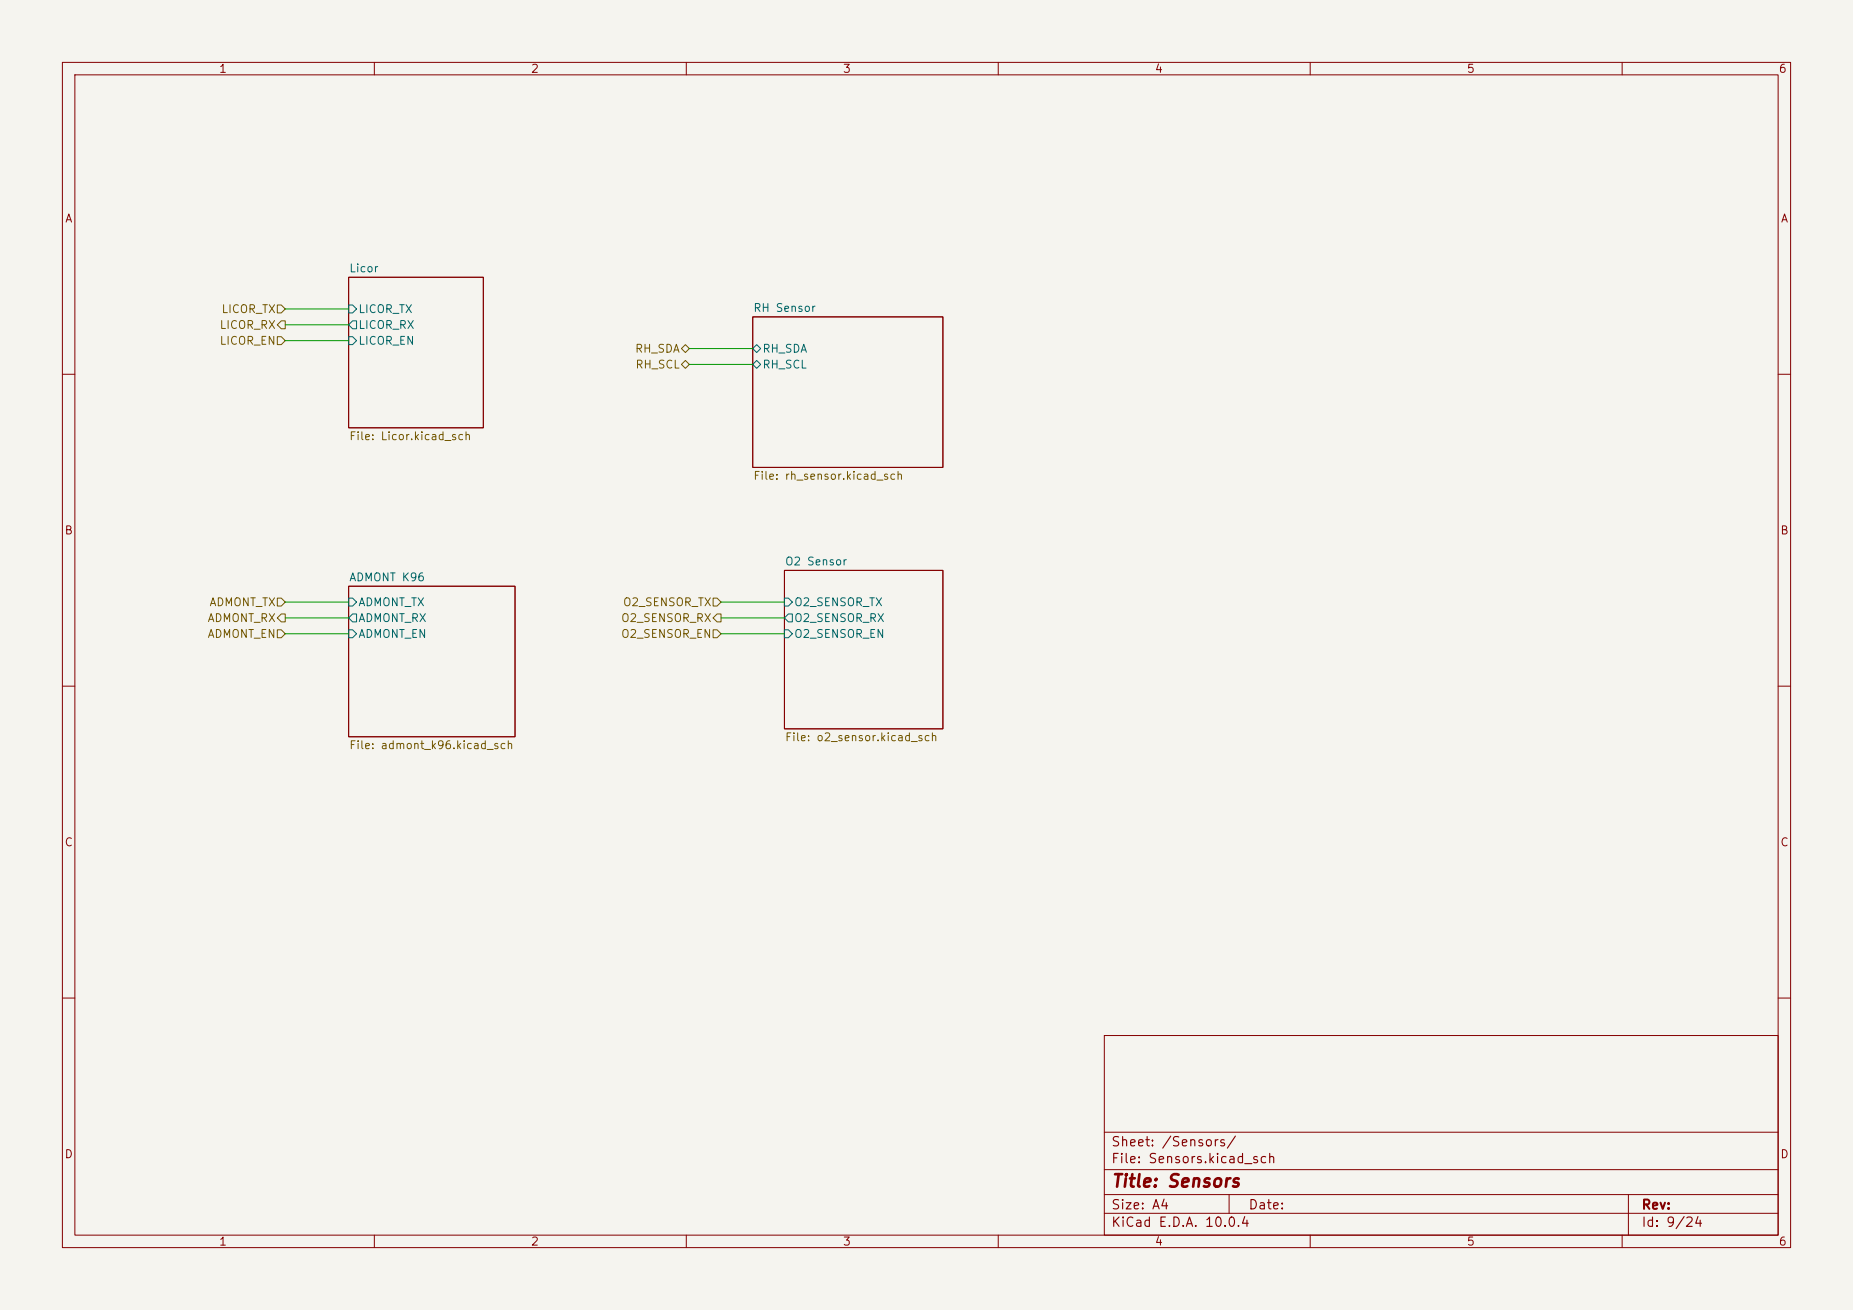
[picture p13: page 9]

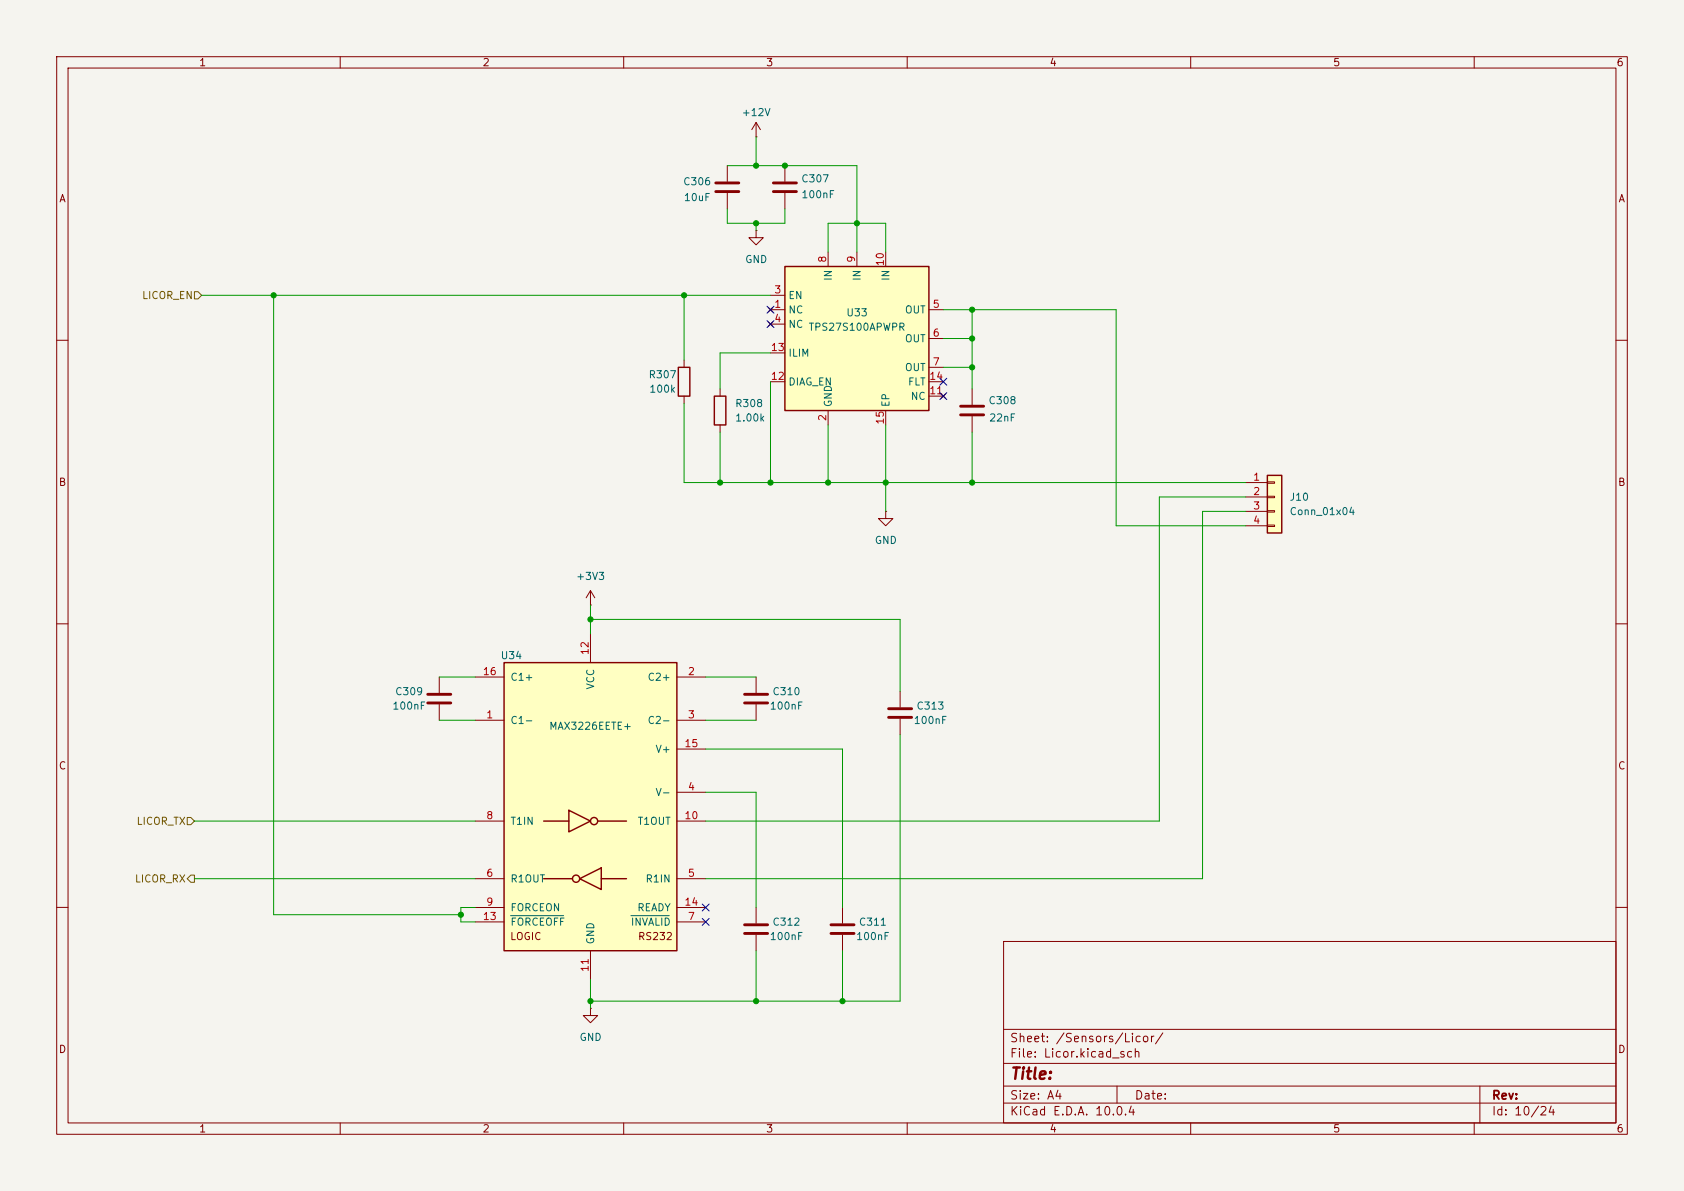
[picture p14: page 10]

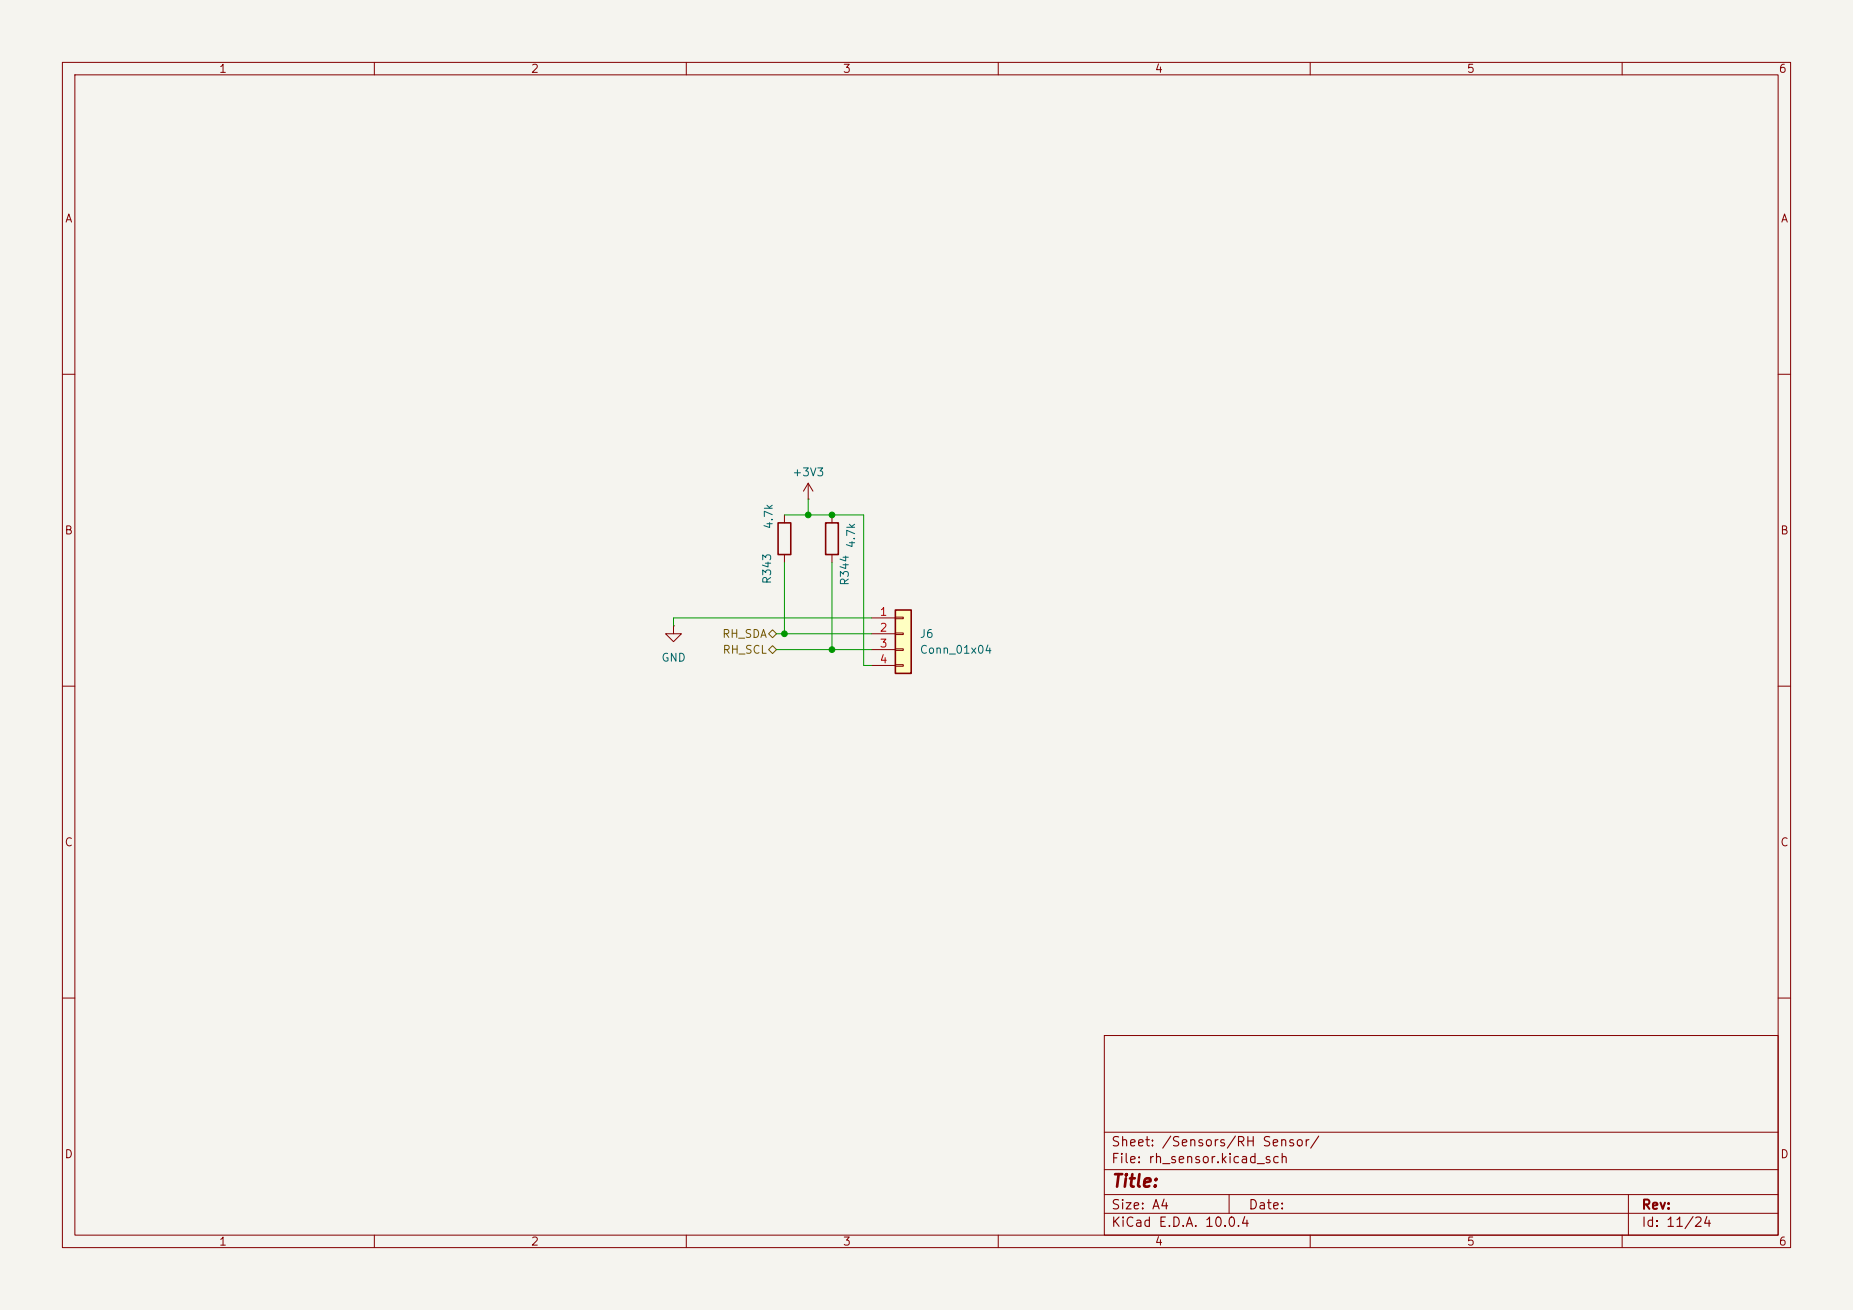
[picture p15: page 11]

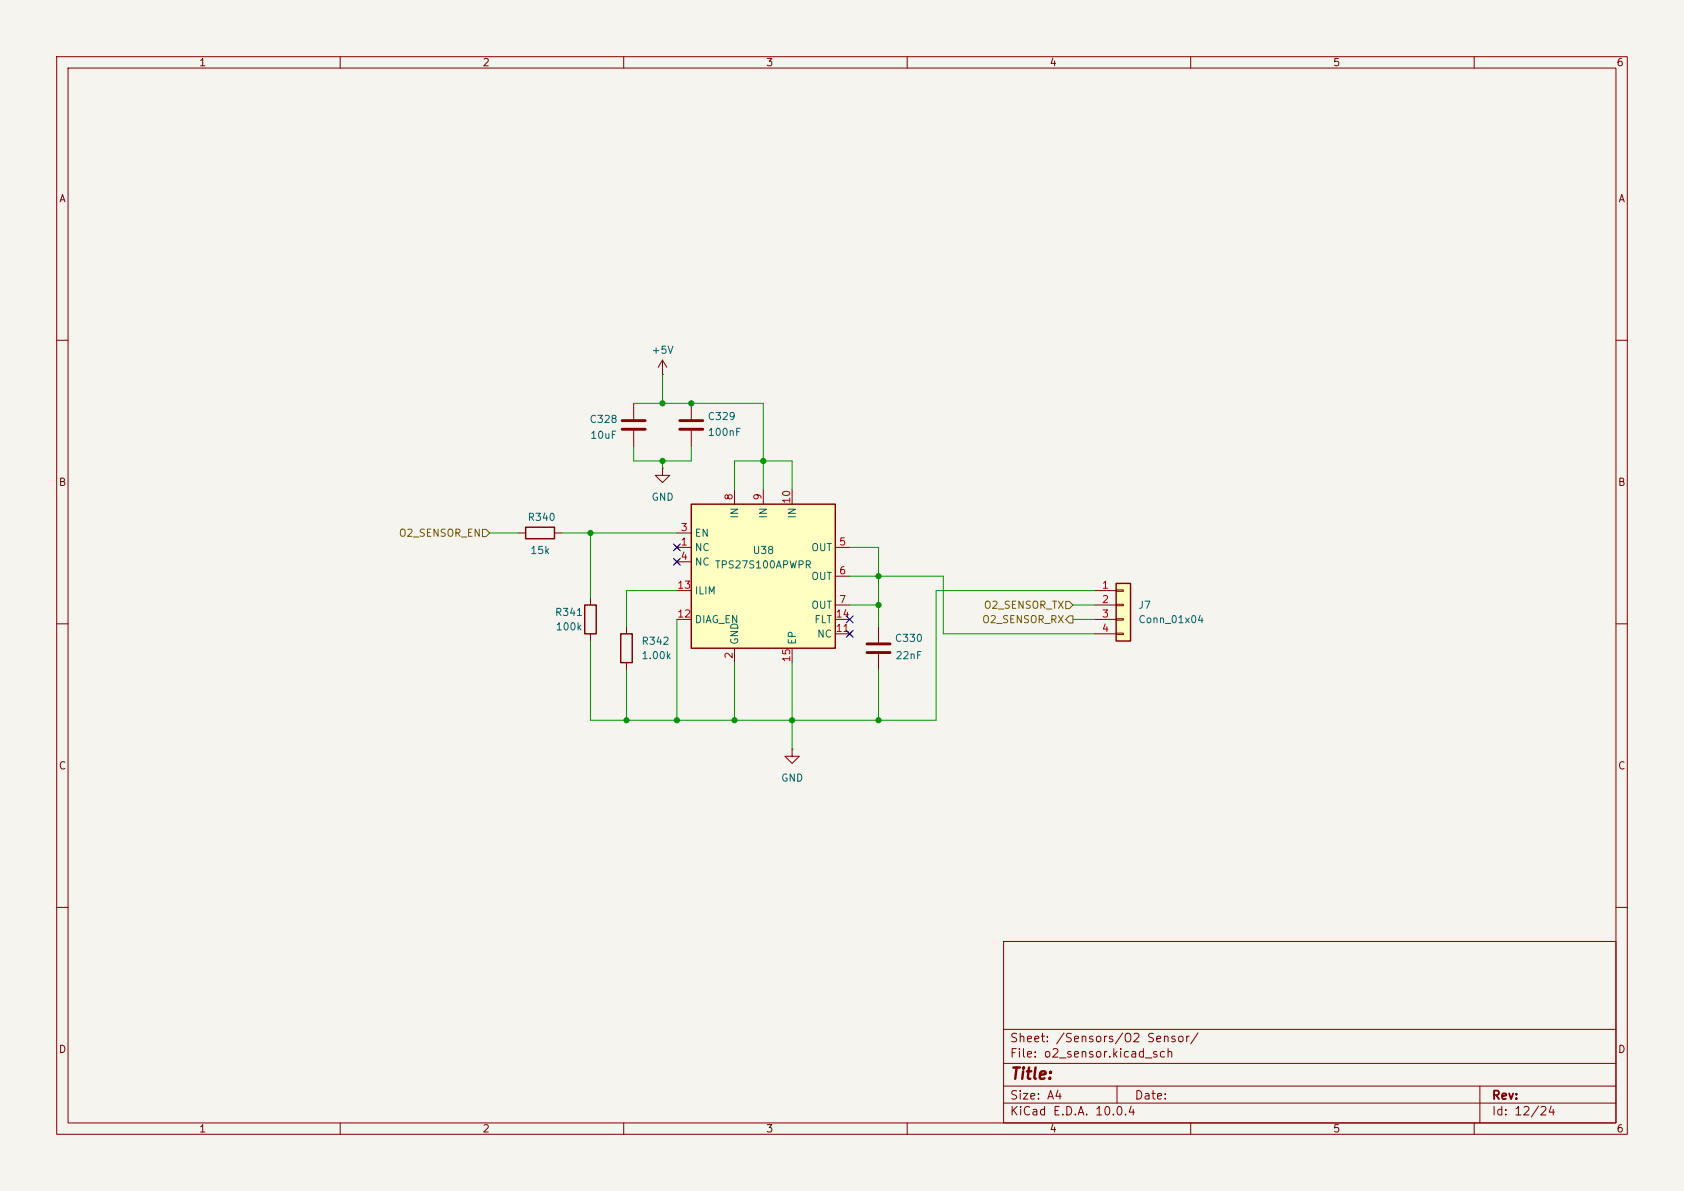
[picture p16: page 12]

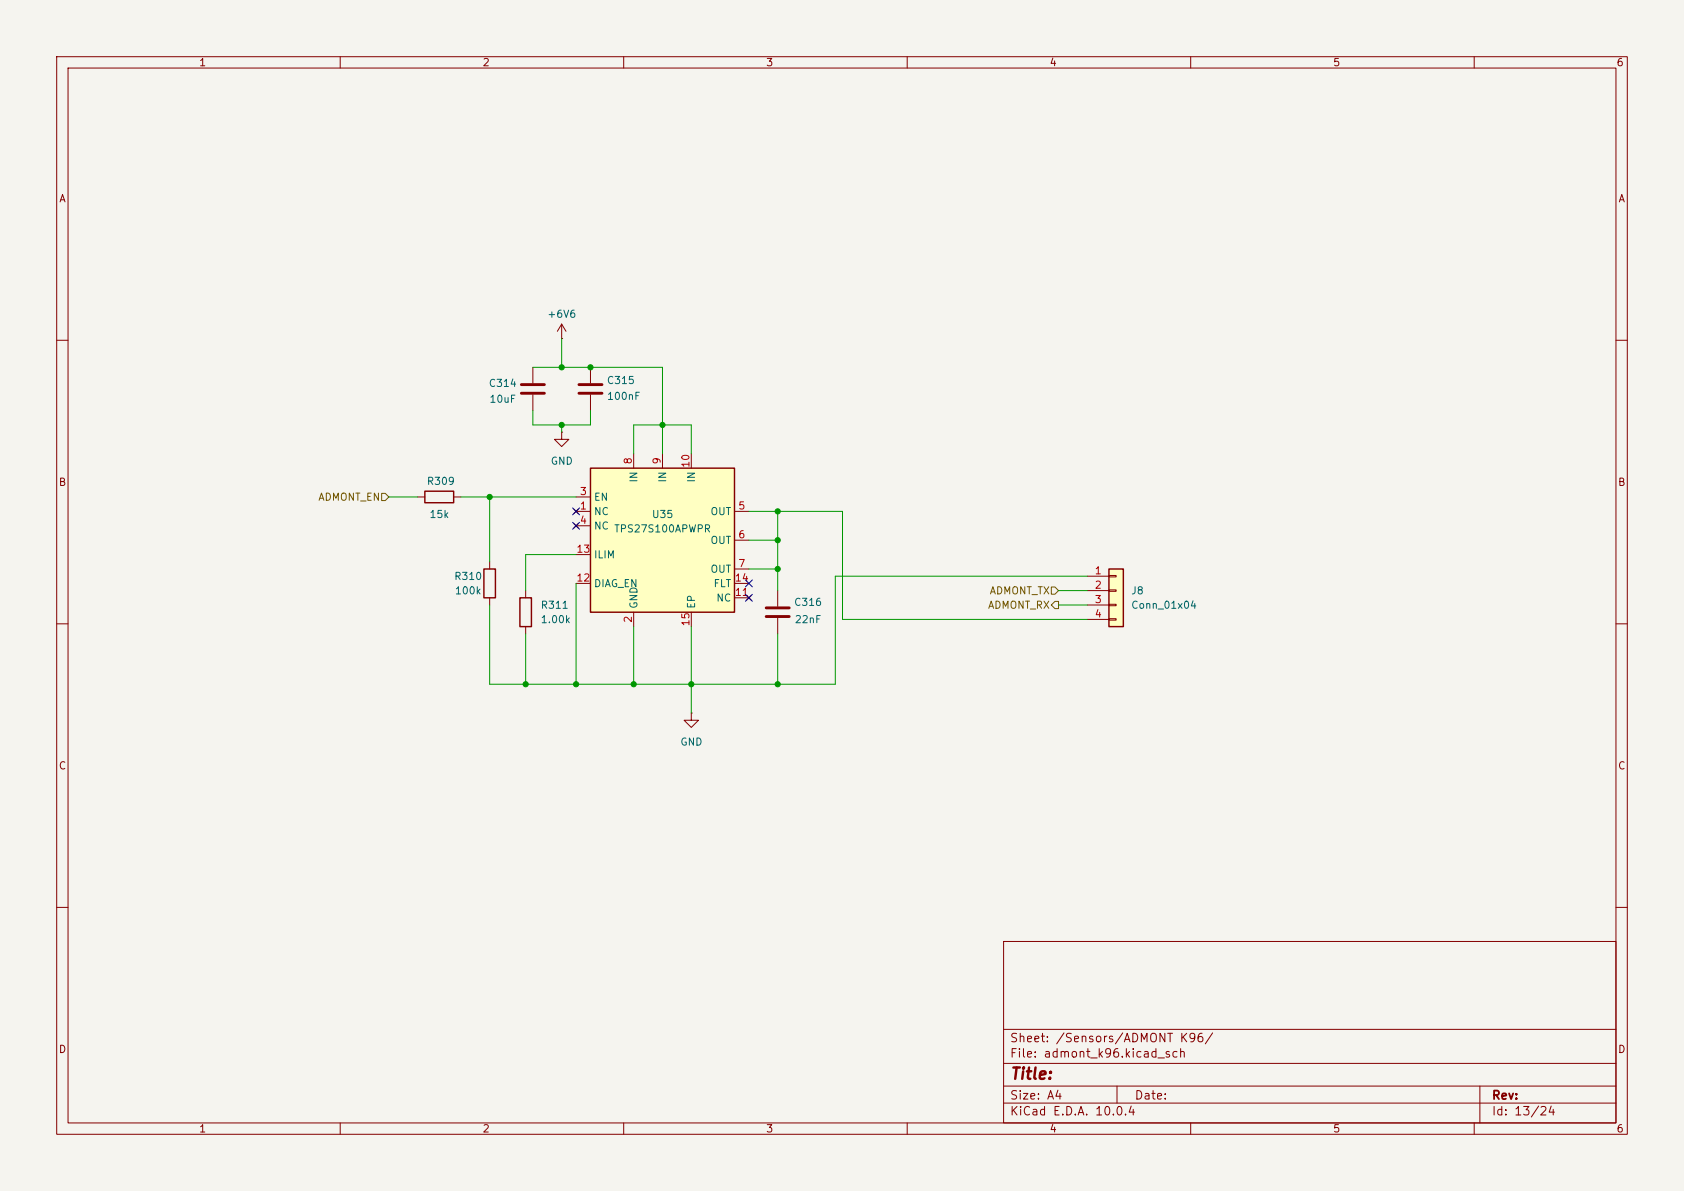
[picture p17: page 13]

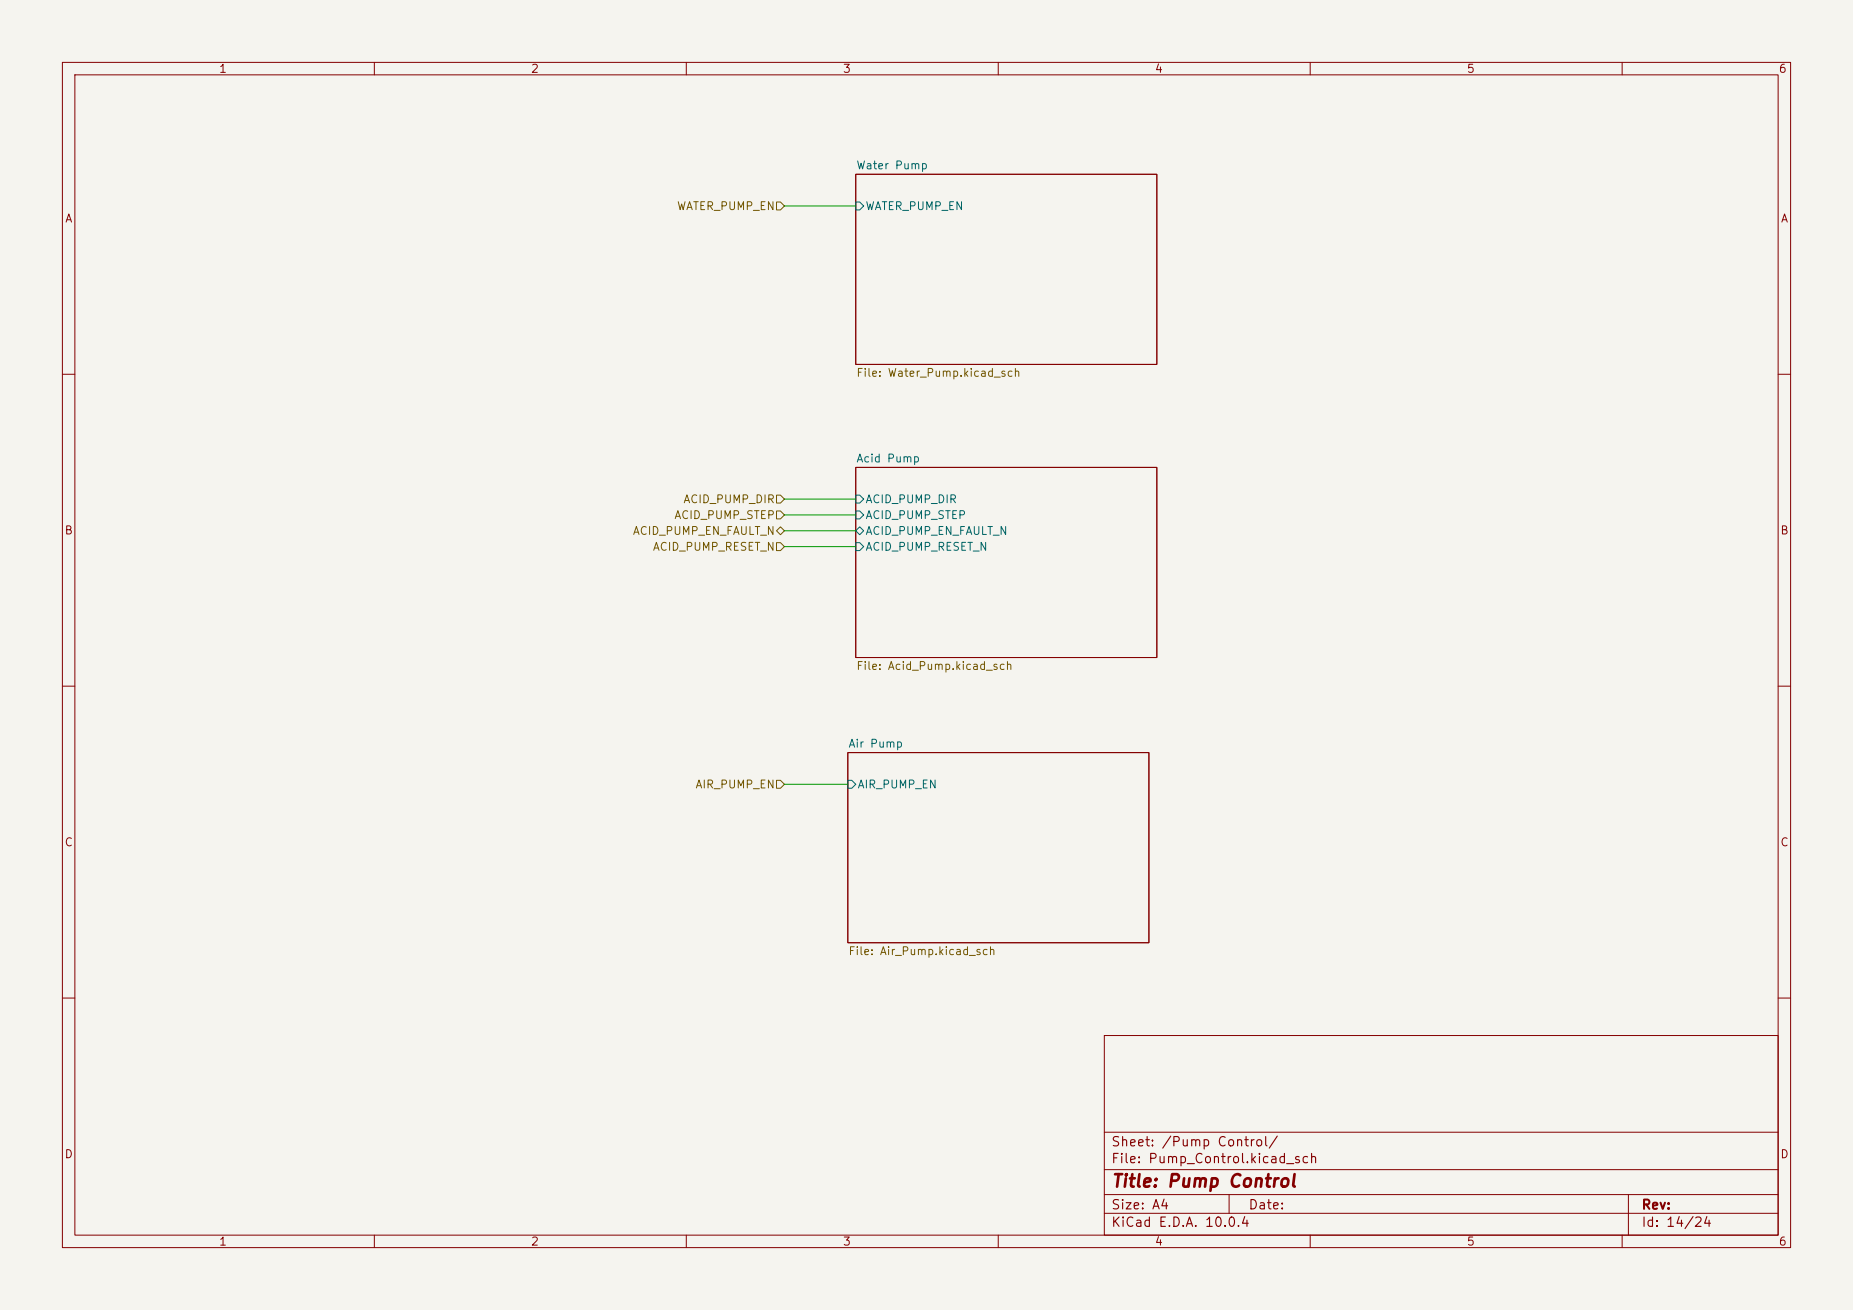
[picture p18: page 14]

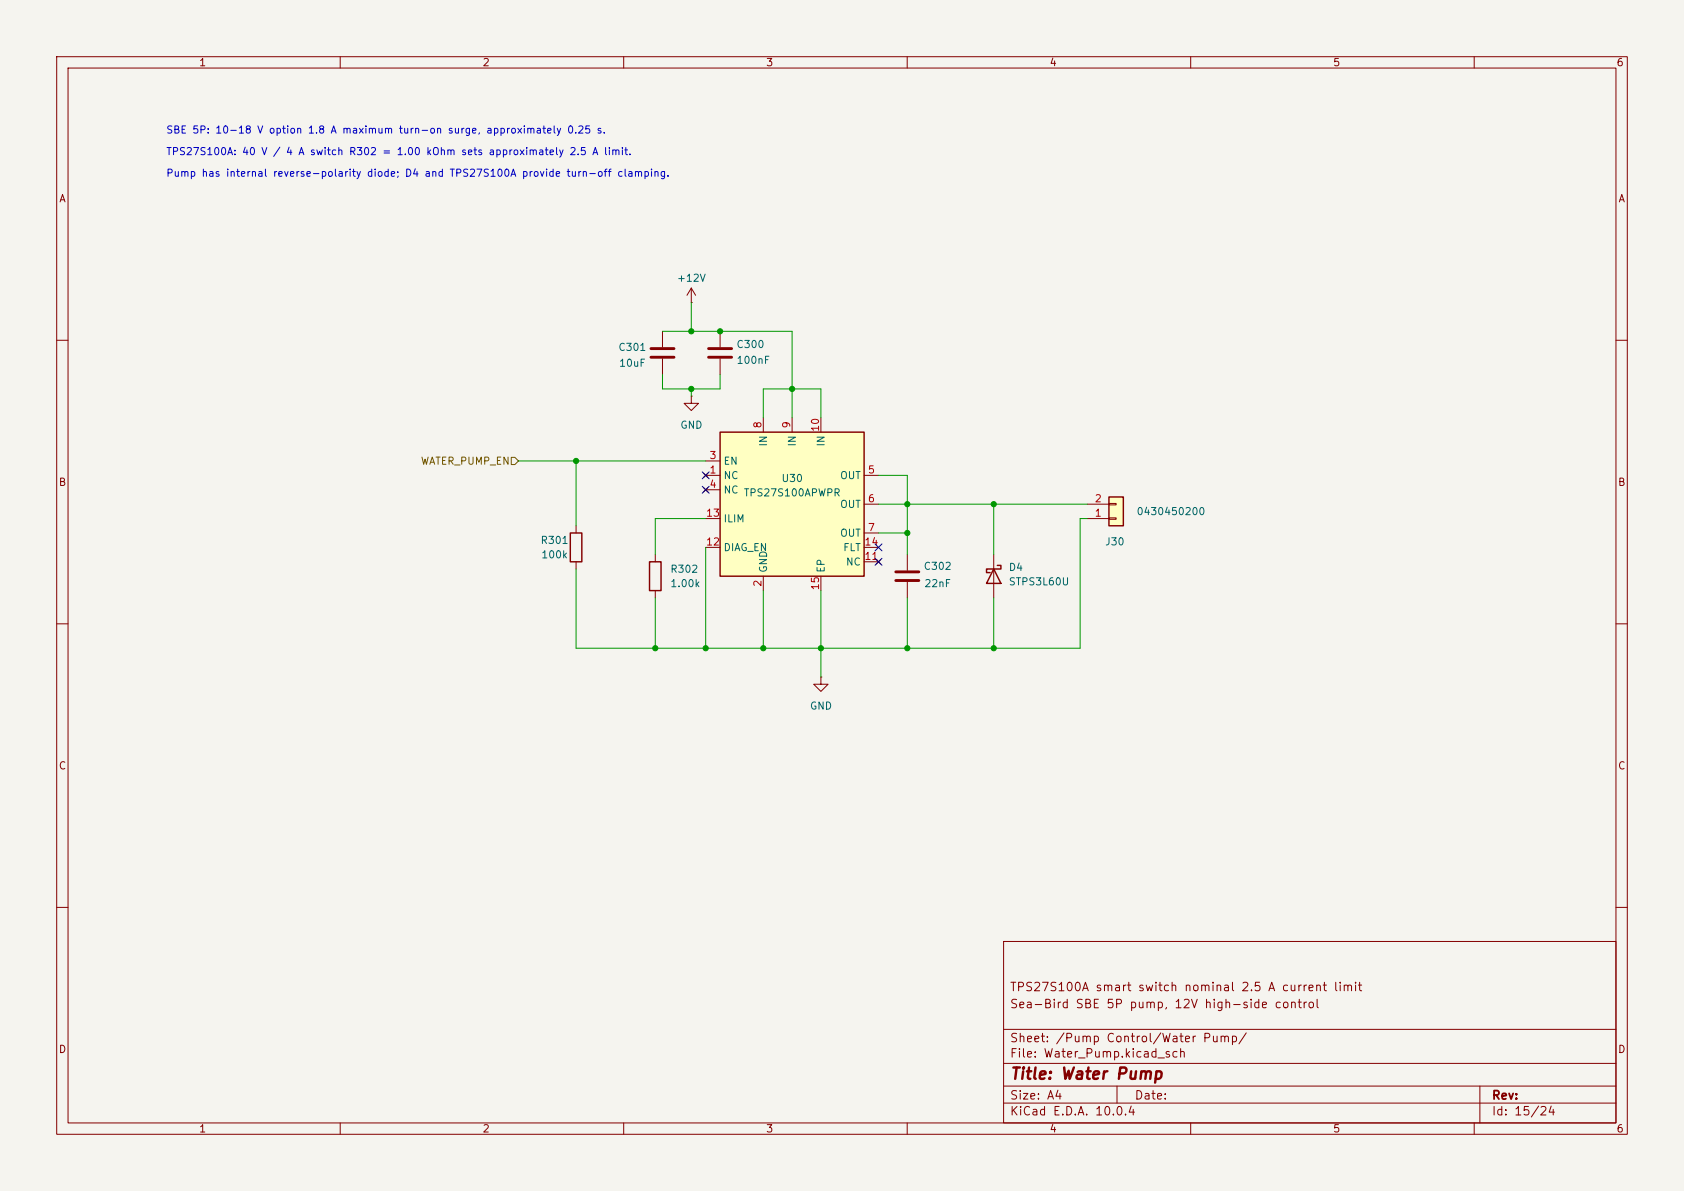
[picture p19: page 15]

Pump has internal reverse-polarity diode; D4 and TPS27S100A provide turn-off clamping. TPS27S100A: 40 V / 4 A switch R302 = 1.00 kOhm sets approximately 2.5 A limit. SBE 5P: 10-18 V option 1.8 A maximum turn-on surge, approximately 0.25 s.

TPS27S100A smart switch nominal 2.5 A current limit
Sea-Bird SBE 5P pump, 12V high-side control

Sheet: /Pump Control/Water Pump/
File: Water_Pump.kicad_sch
Title: Water Pump

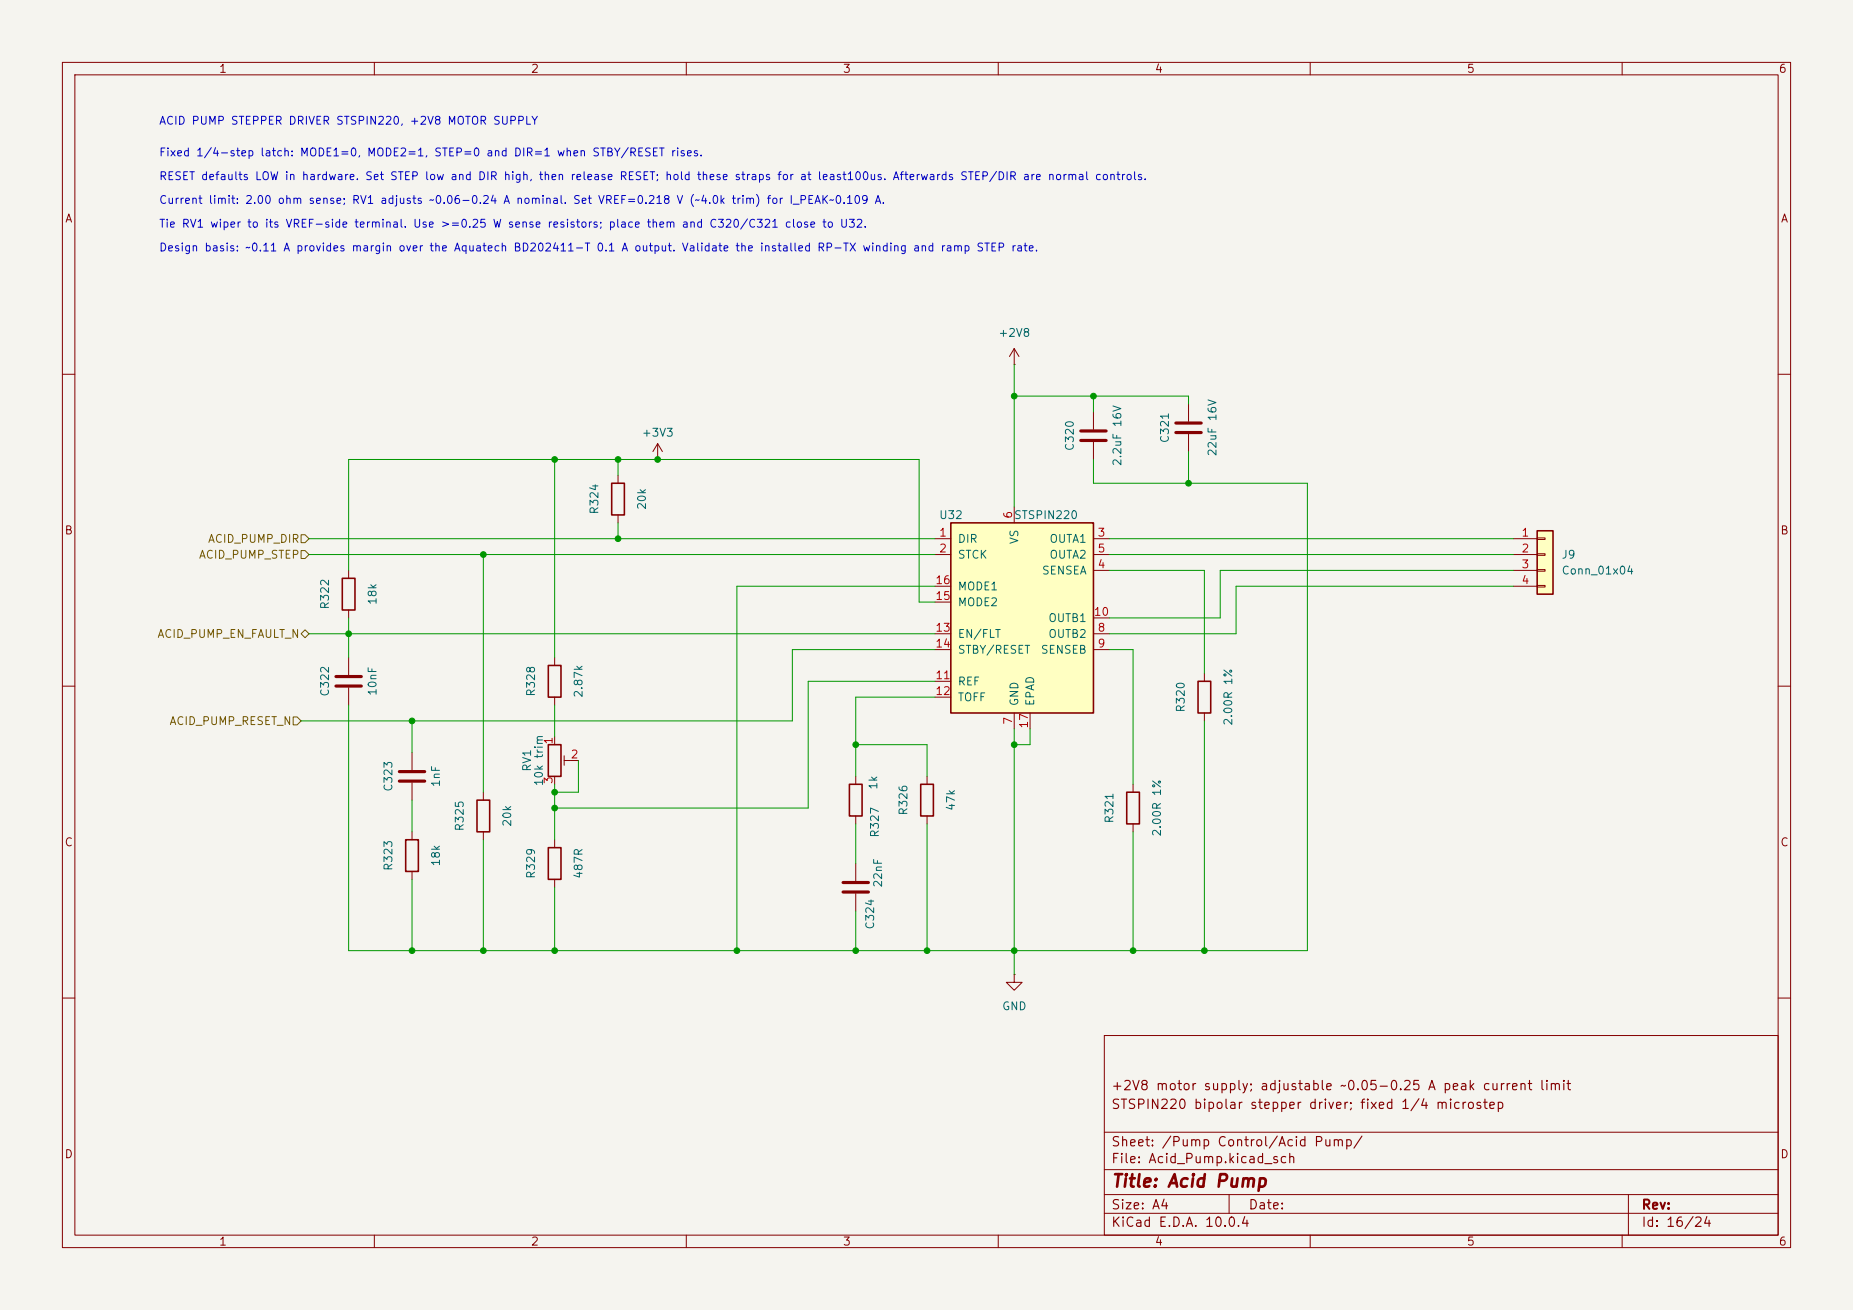
[picture p20: page 16]

Fixed 1/4-step latch: MODE1=0, MODE2=1, STEP=0 and DIR=1 when STBY/RESET rises. Tie RV1 wiper to its VREF-side terminal. Use >=0.25 W sense resistors; place them and C320/C321 close to U32. Current limit: 2.00 ohm sense; RV1 adjusts ~0.06-0.24 A nominal. Set VREF=0.218 V (~4.0k trim) for I_PEAK~0.109 A. RESET defaults LOW in hardware. Set STEP low and DIR high, then release RESET; hold these straps for at least100us. Afterwards STEP/DIR are normal controls. Design basis: ~0.11 A provides margin over the Aquatech BD202411-T 0.1 A output. Validate the installed RP-TX winding and ramp STEP rate. ACID PUMP STEPPER DRIVER STSPIN220, +2V8 MOTOR SUPPLY

STSPIN220 bipolar stepper driver; fixed 1/4 microstep

Sheet: /Pump Control/Acid Pump/
File: Acid_Pump.kicad_sch
Title: Acid Pump

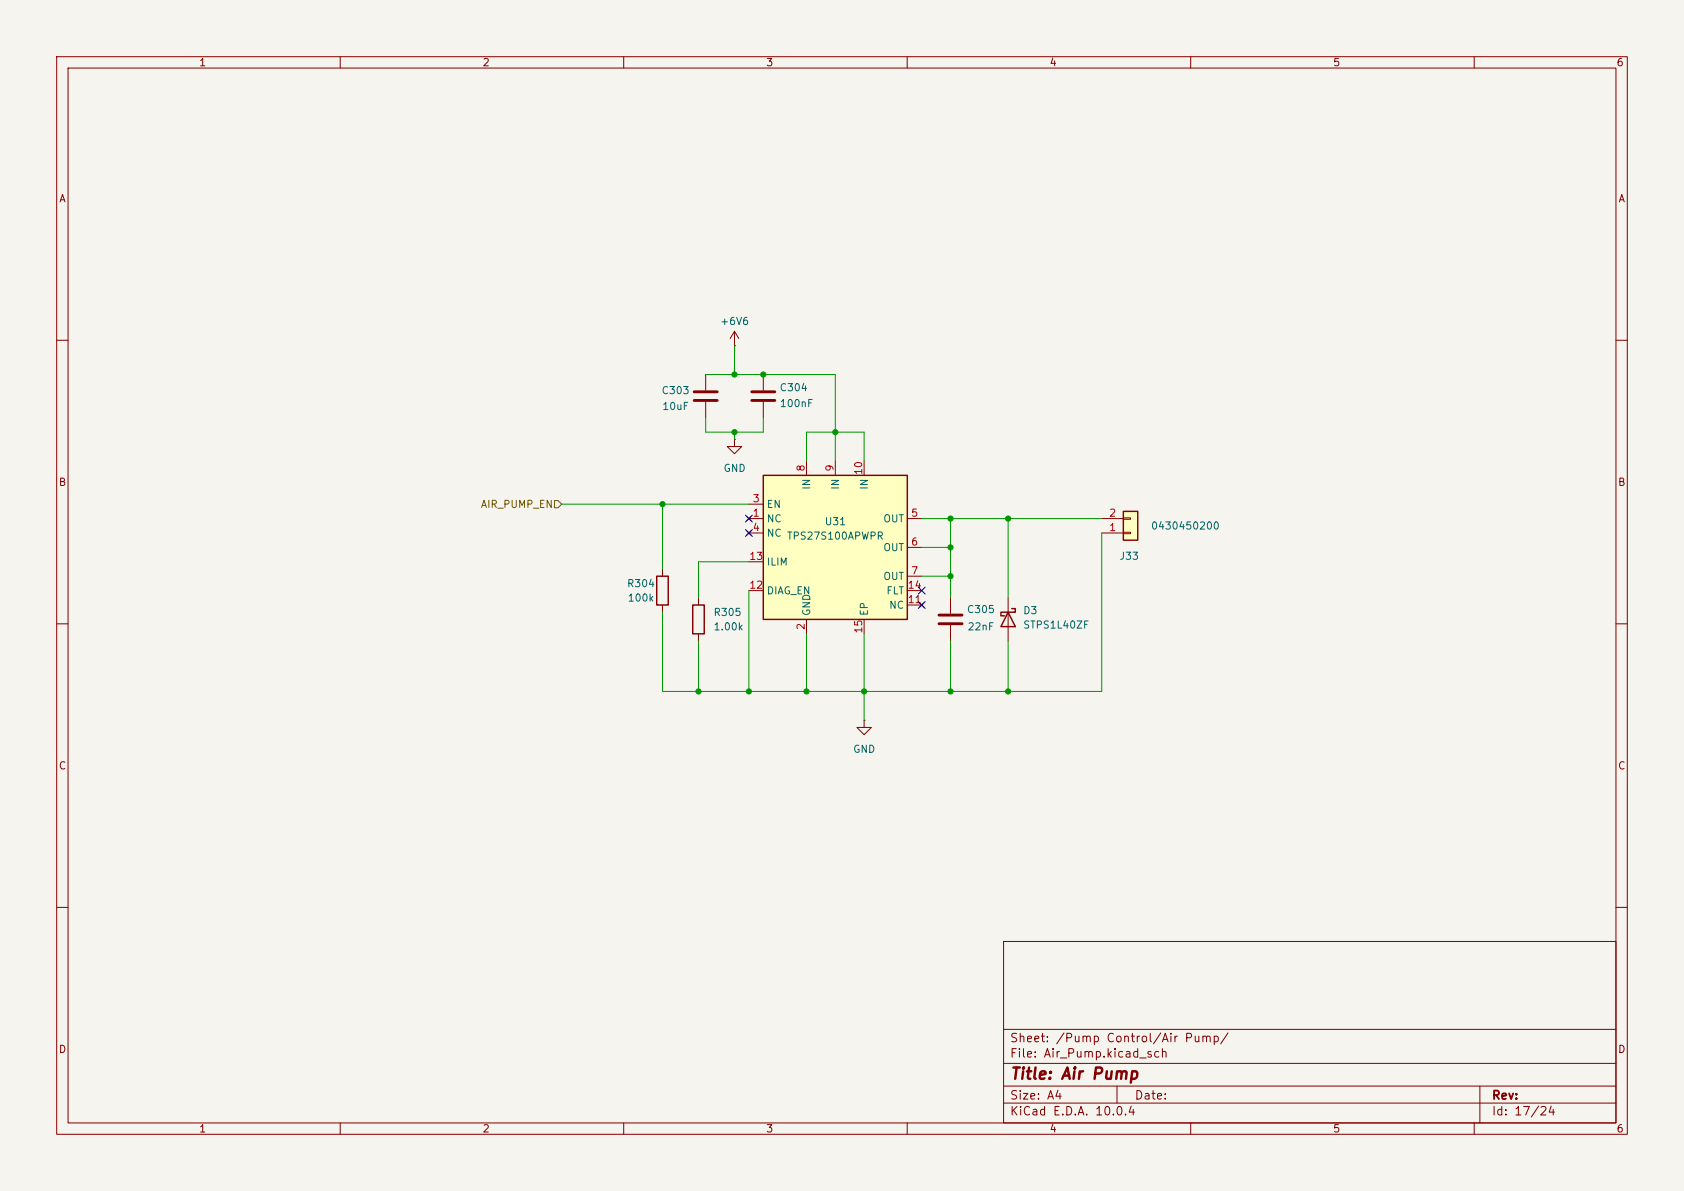
[picture p21: page 17]

Sheet: /Pump Control/Air Pump/
File: Air_Pump.kicad_sch
Title: Air Pump

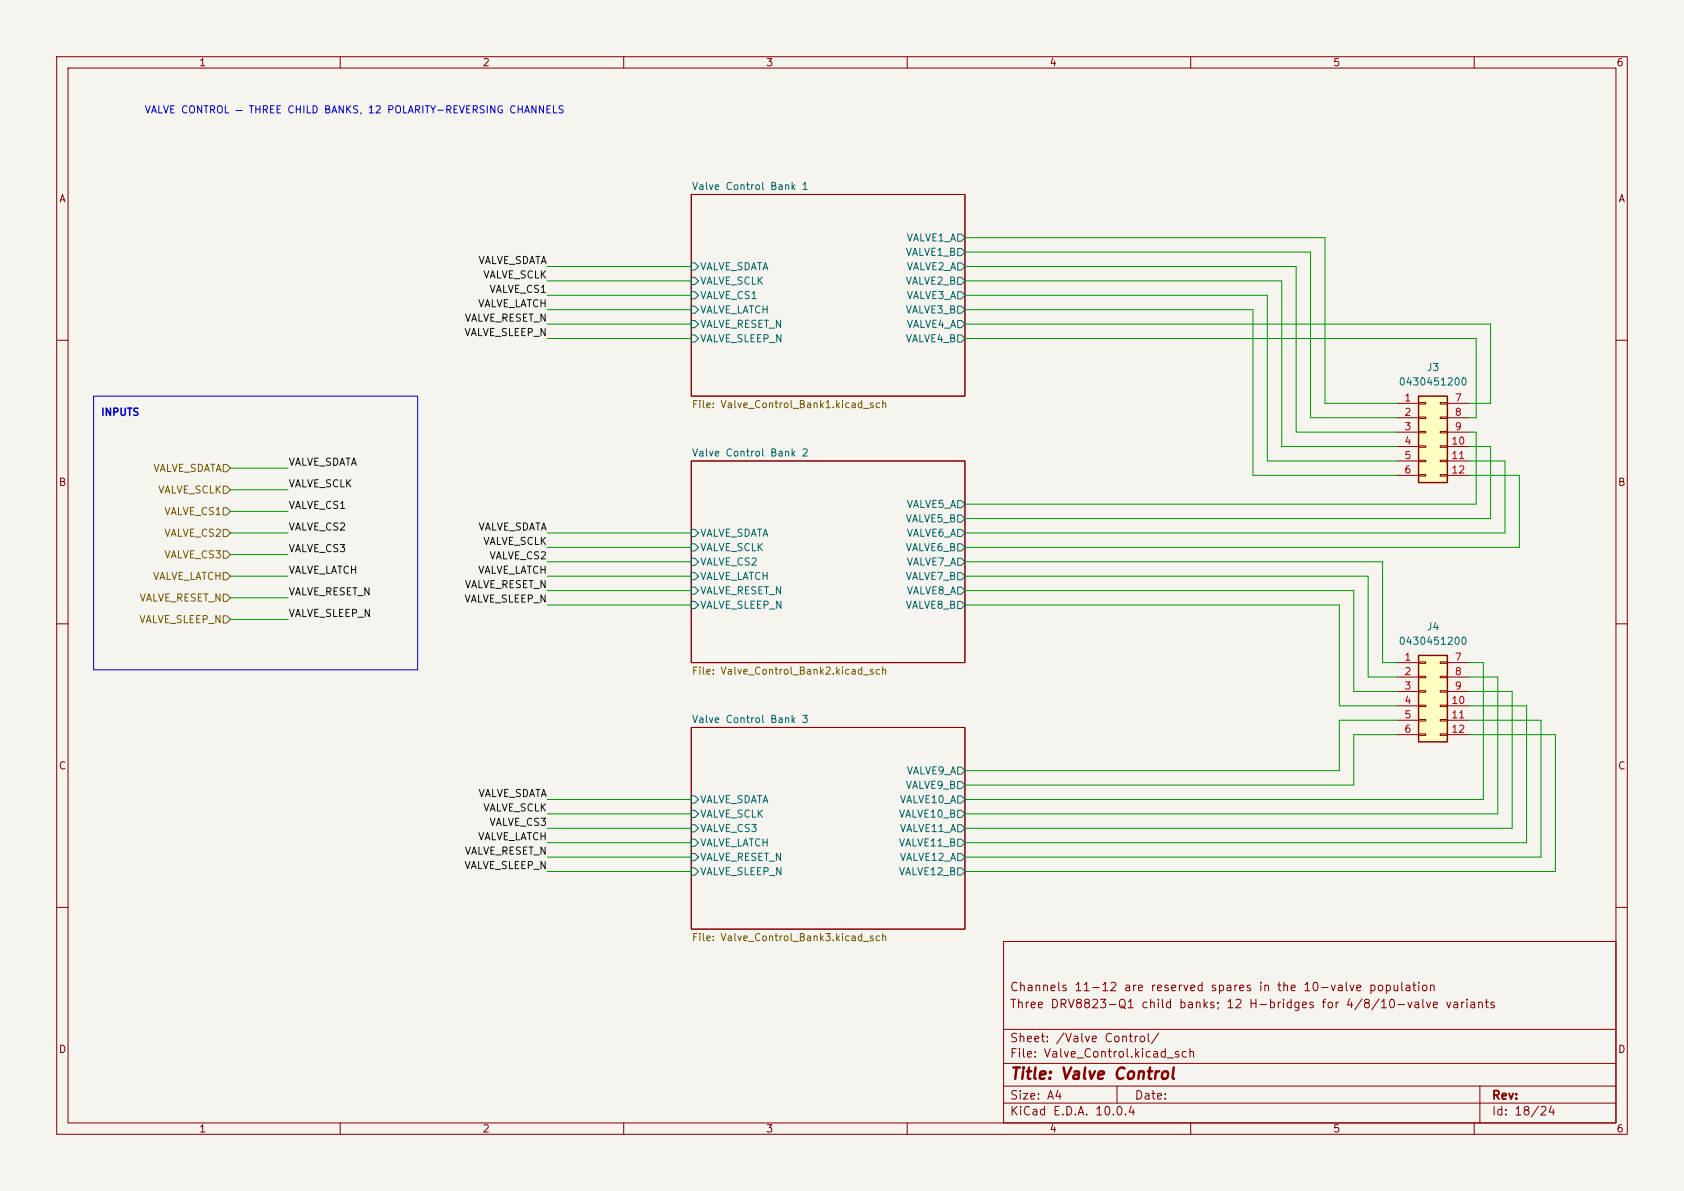
[picture p22: page 18]

VALVE CONTROL — THREE CHILD BANKS, 12 POLARITY-REVERSING CHANNELS

Channels 11-12 are reserved spares in the 10-valve population
Three DRV8823-Q1 child banks; 12 H-bridges for 4/8/10-valve variants

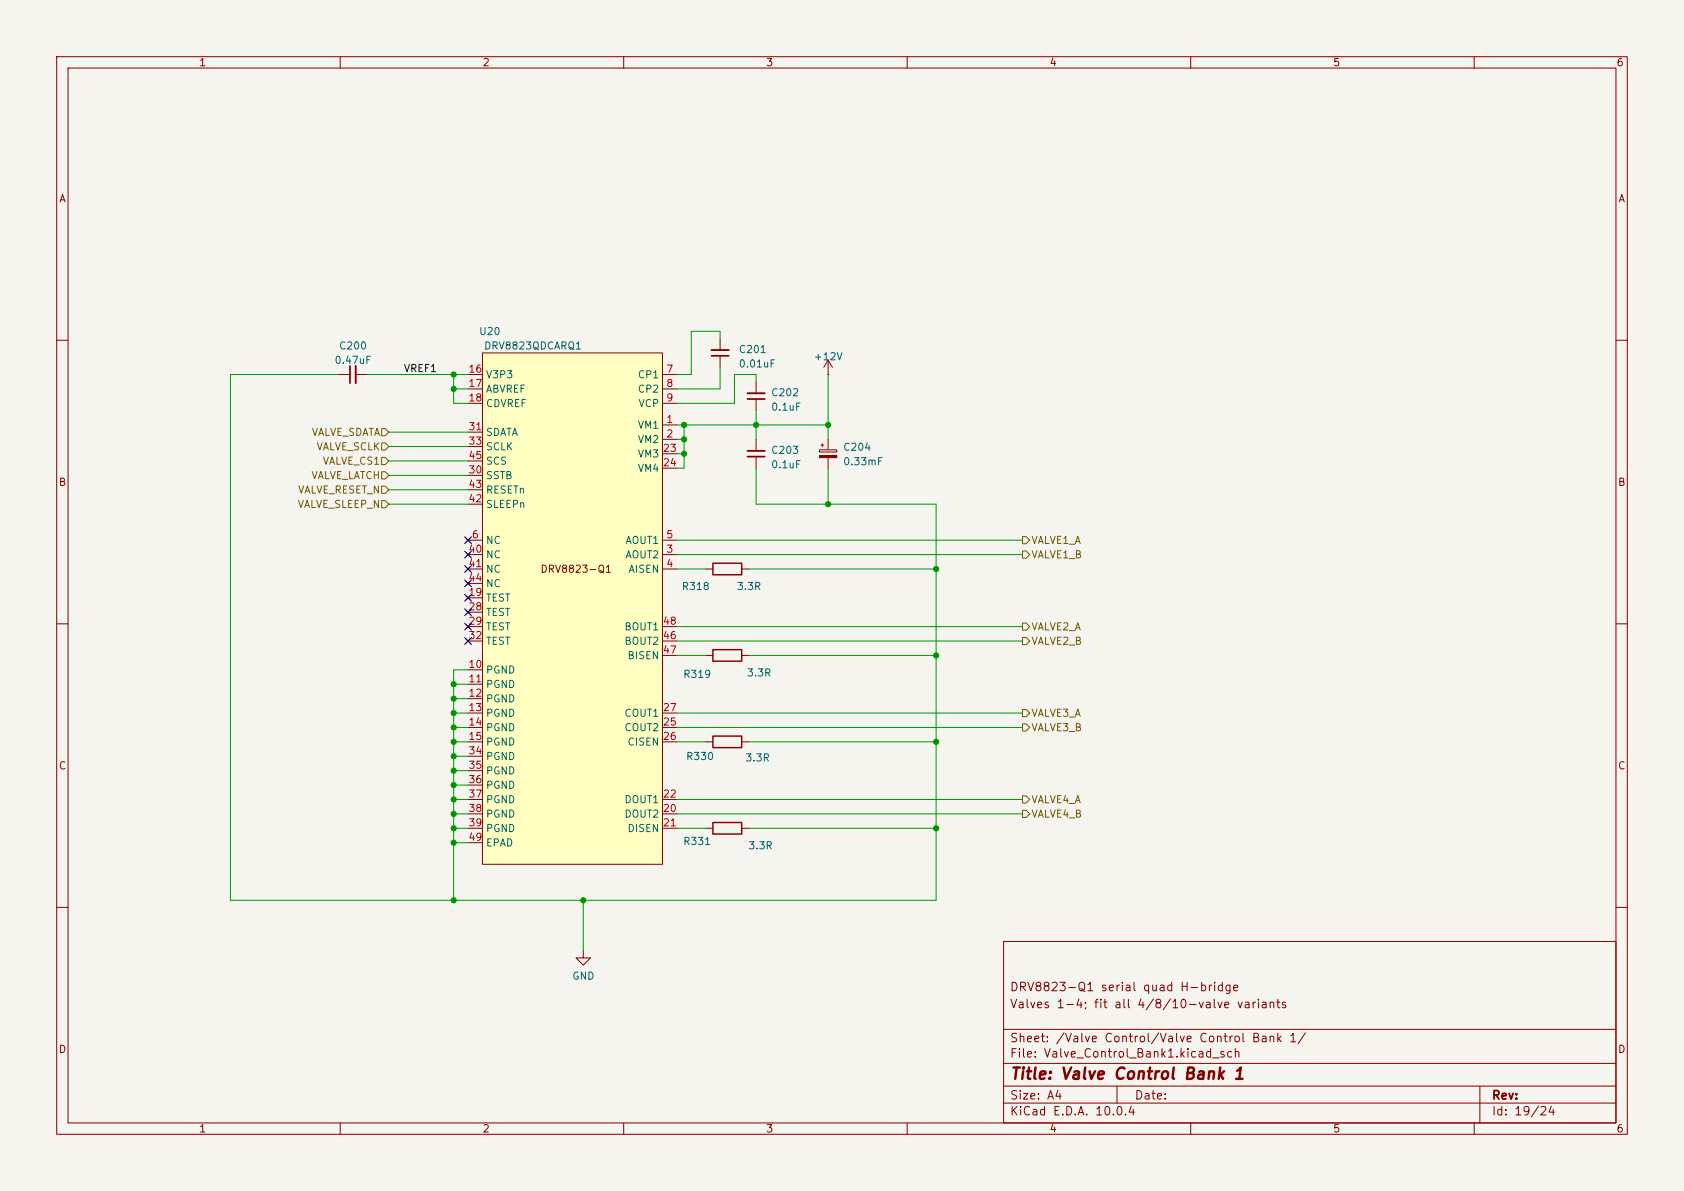
[picture p23: page 19]

SCLK 33 PGND 34 PGND 35 PGND 36 PGND 37 PGND 38 PGND 39 NC 40 NC 41
VM4 24 COUT2 25 CISEN 26 COUT1 27

DRV8823-Q1 serial quad H-bridge
Valves 1-4; fit all 4/8/10-valve variants

Sheet: /Valve Control/Valve Control Bank 1/
File: Valve_Control_Bank1.kicad_sch
Title: Valve Control Bank 1

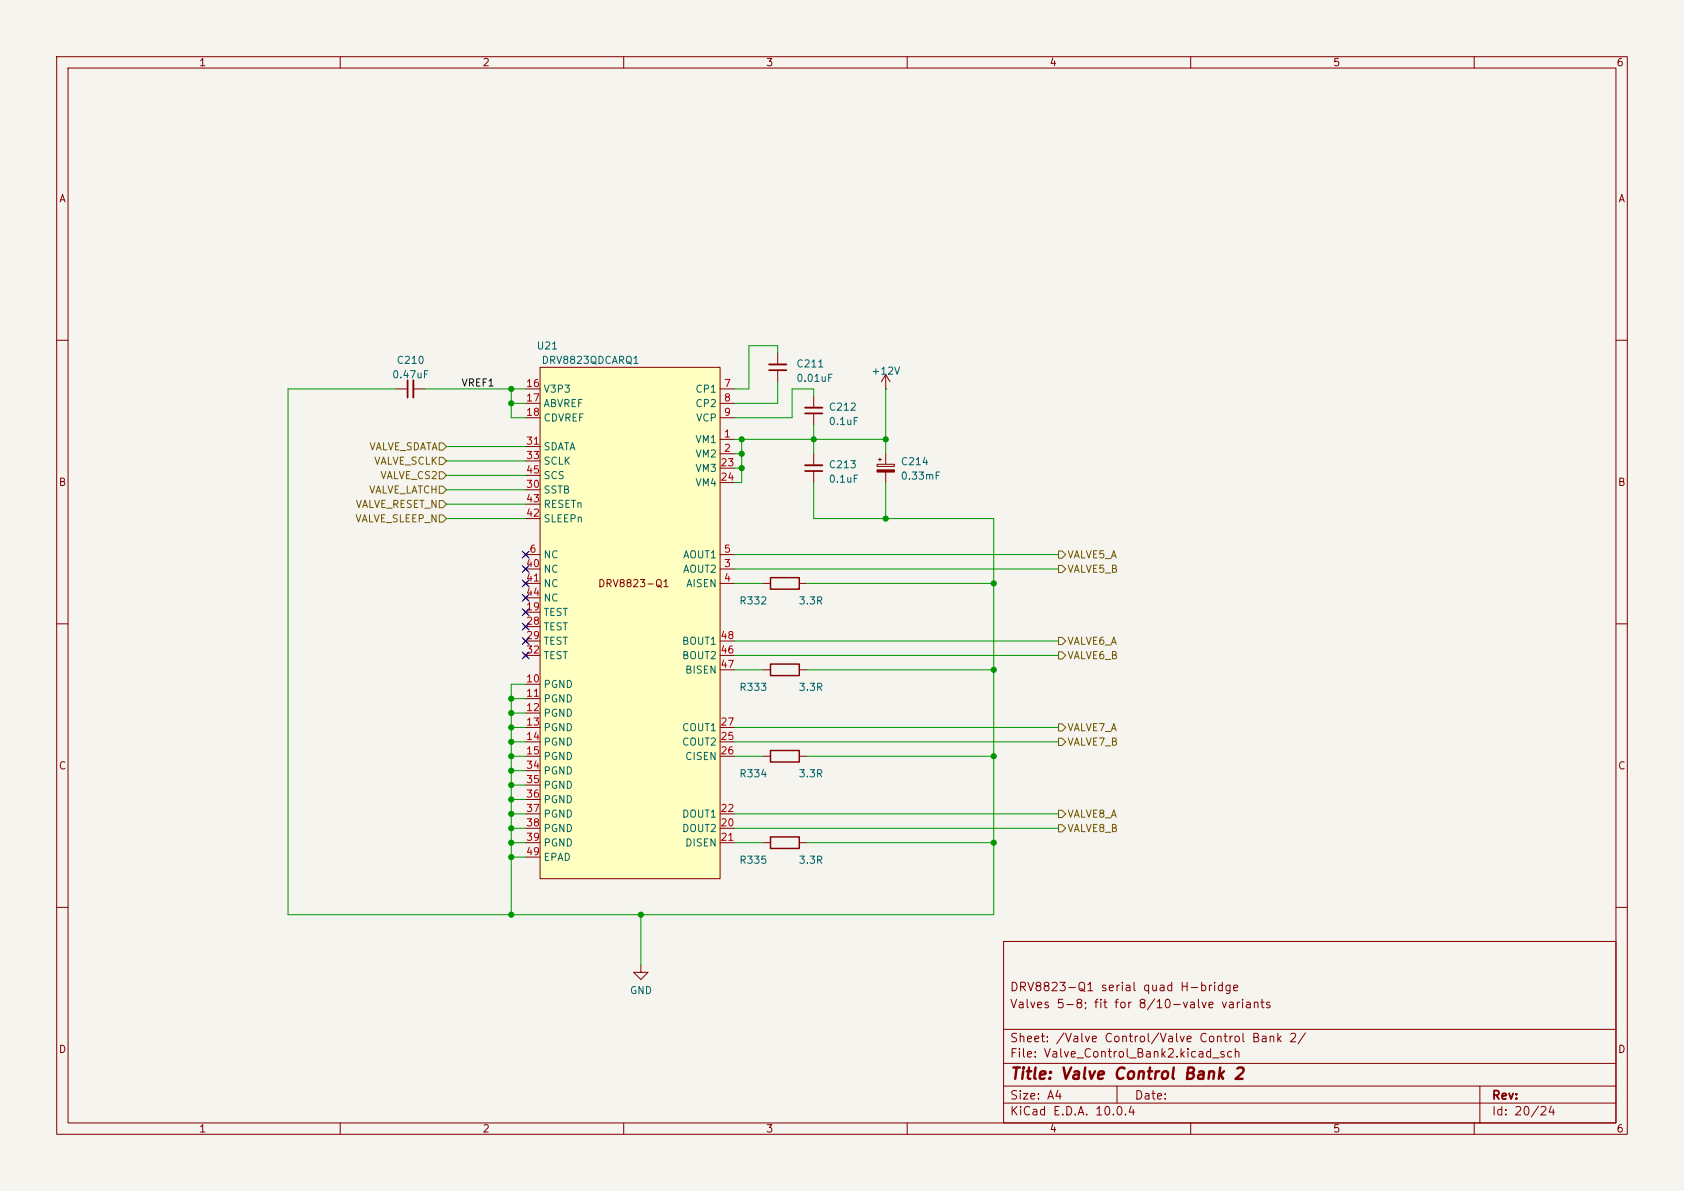
[picture p24: page 20]
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

DRV8823-Q1 serial quad H-bridge
Valves 5-8; fit for 8/10-valve variants

Sheet: /Valve Control/Valve Control Bank 2/
File: Valve_Control_Bank2.kicad_sch
Title: Valve Control Bank 2

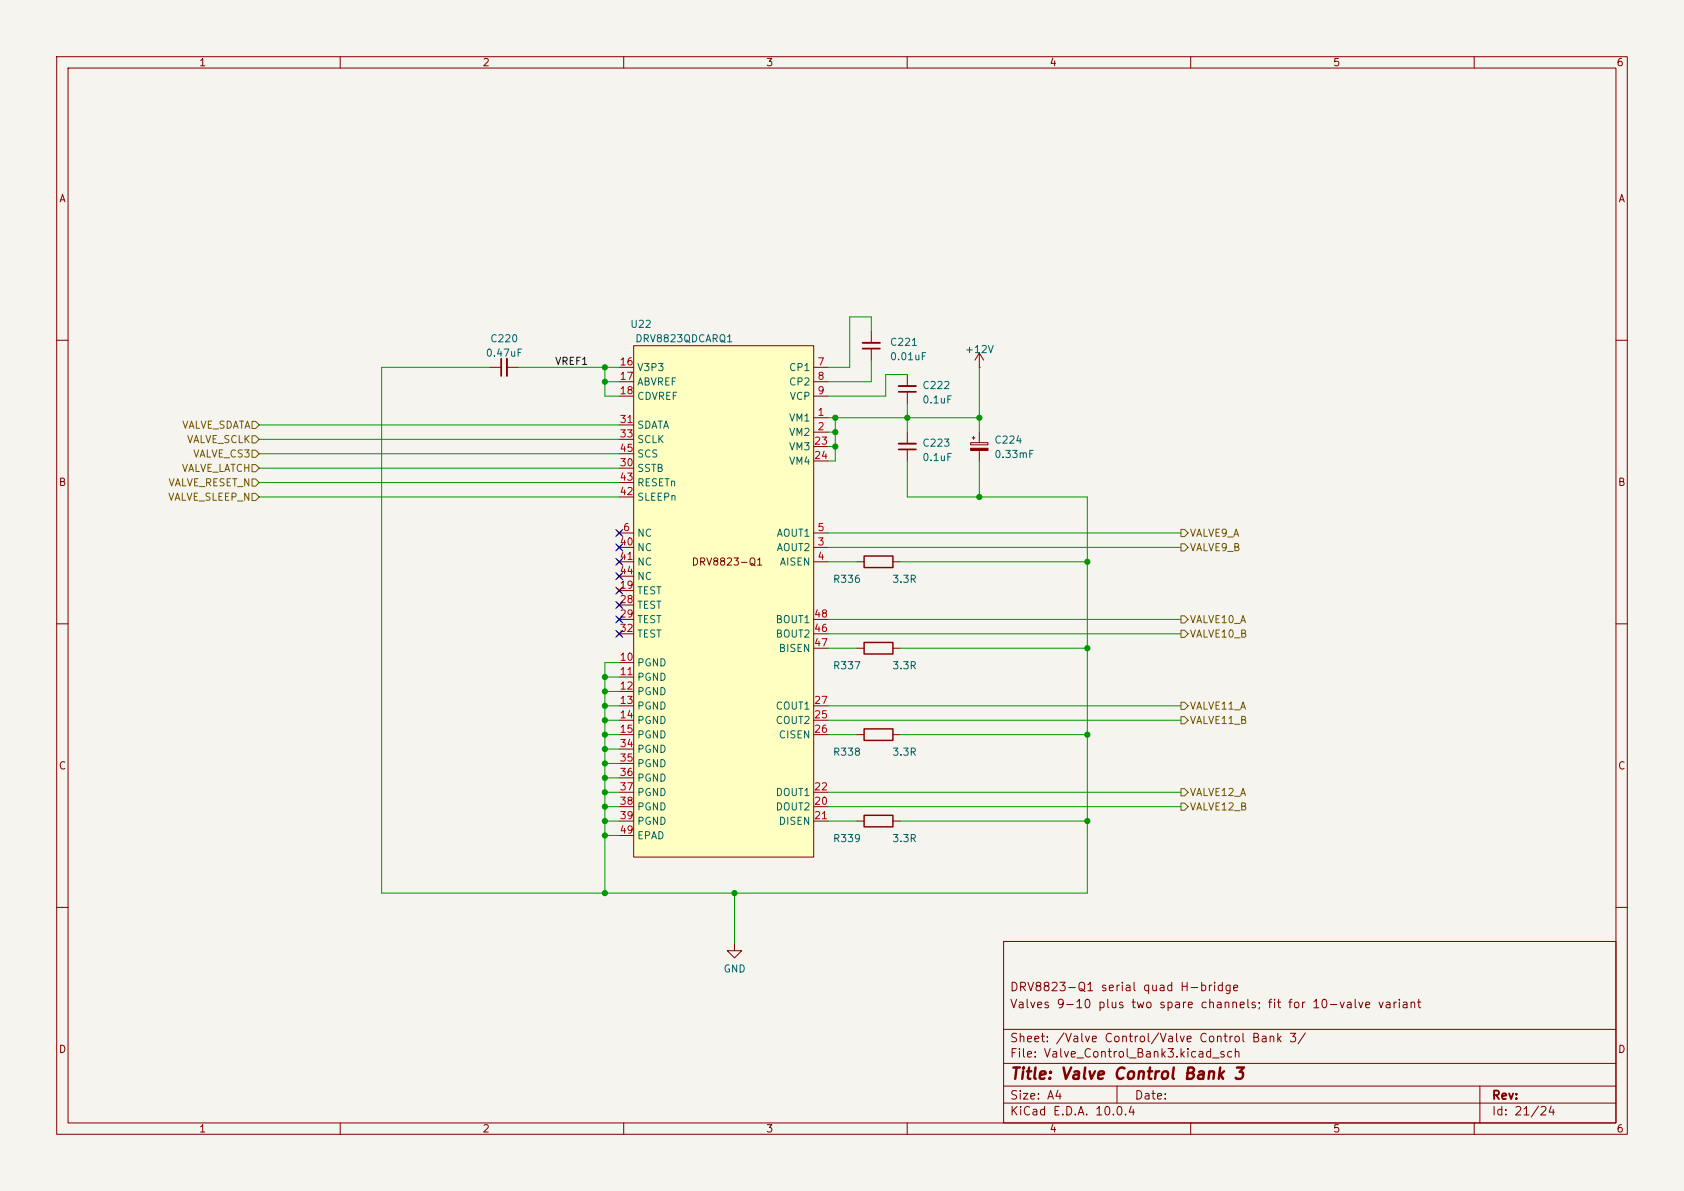
[picture p25: page 21]
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

DRV8823-Q1 serial quad H-bridge
Valves 9-10 plus two spare channels; fit for 10-valve variant

Sheet: /Valve Control/Valve Control Bank 3/
File: Valve_Control_Bank3.kicad_sch
Title: Valve Control Bank 3

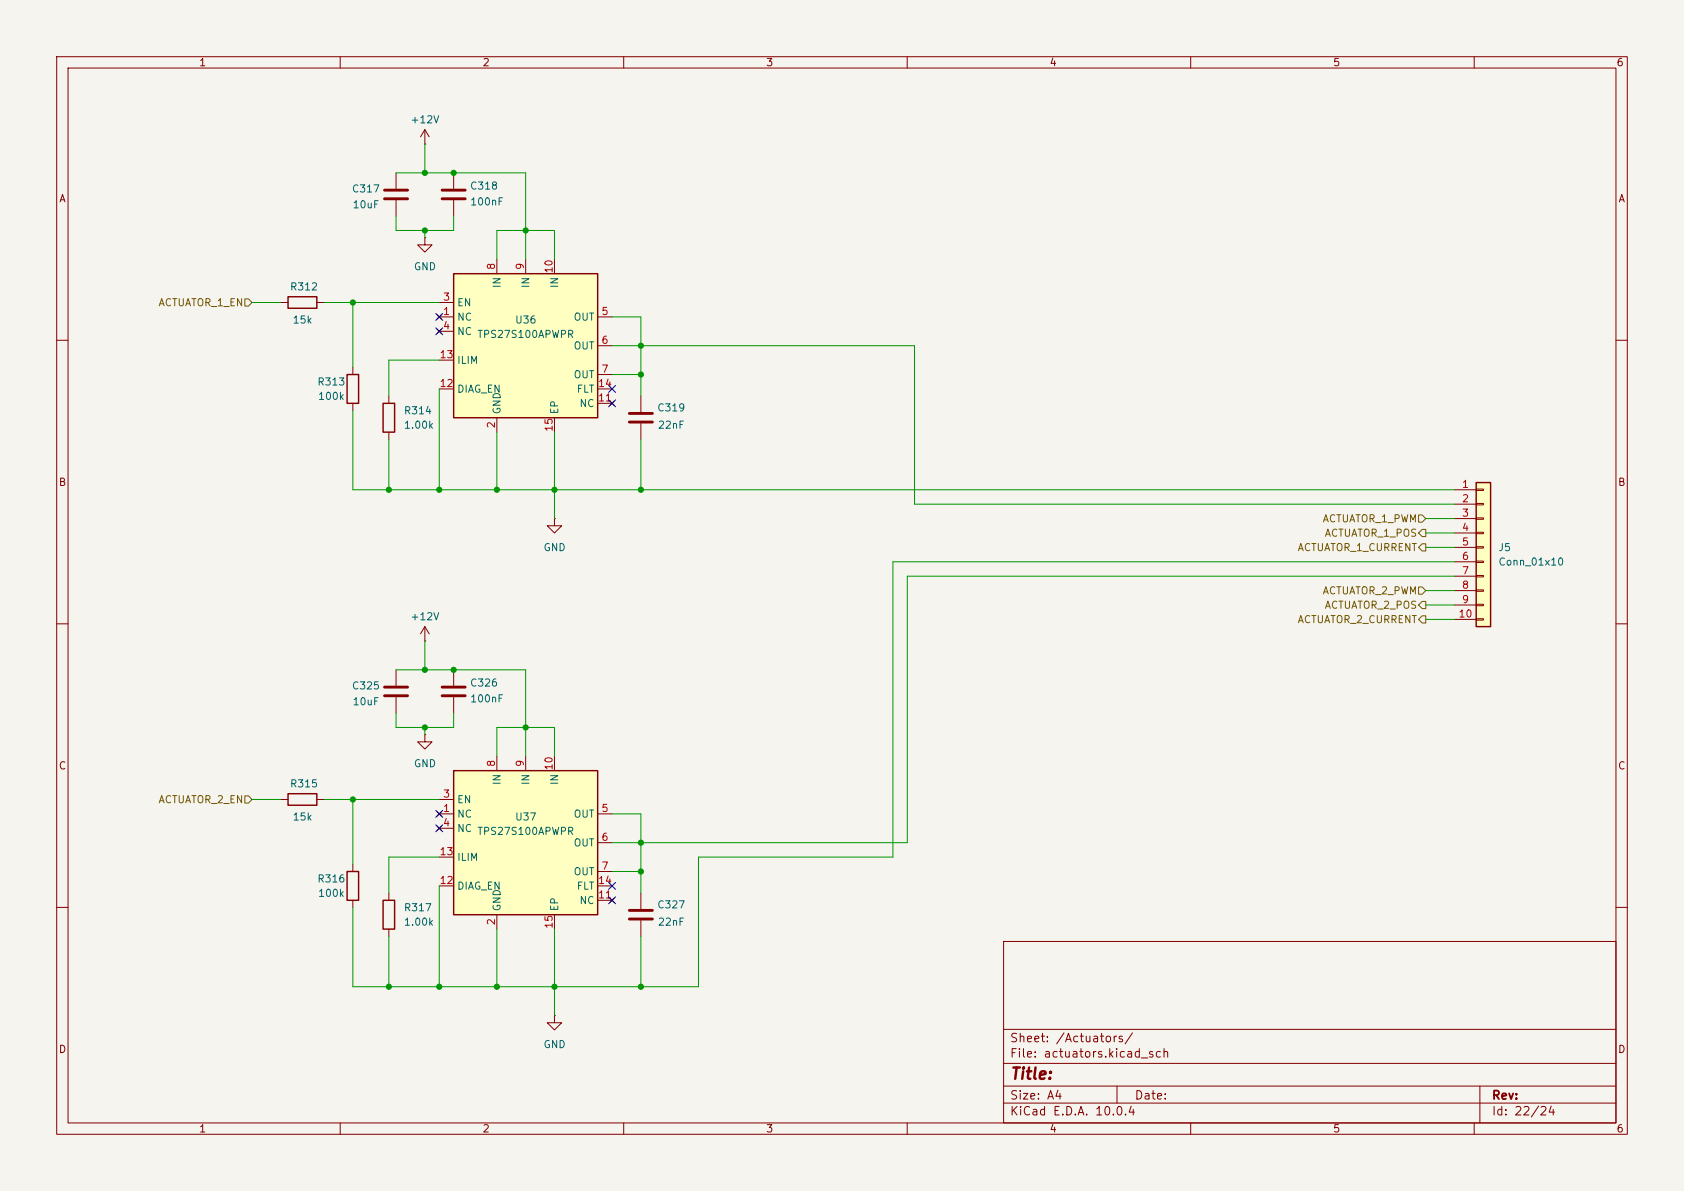
[picture p26: page 22]

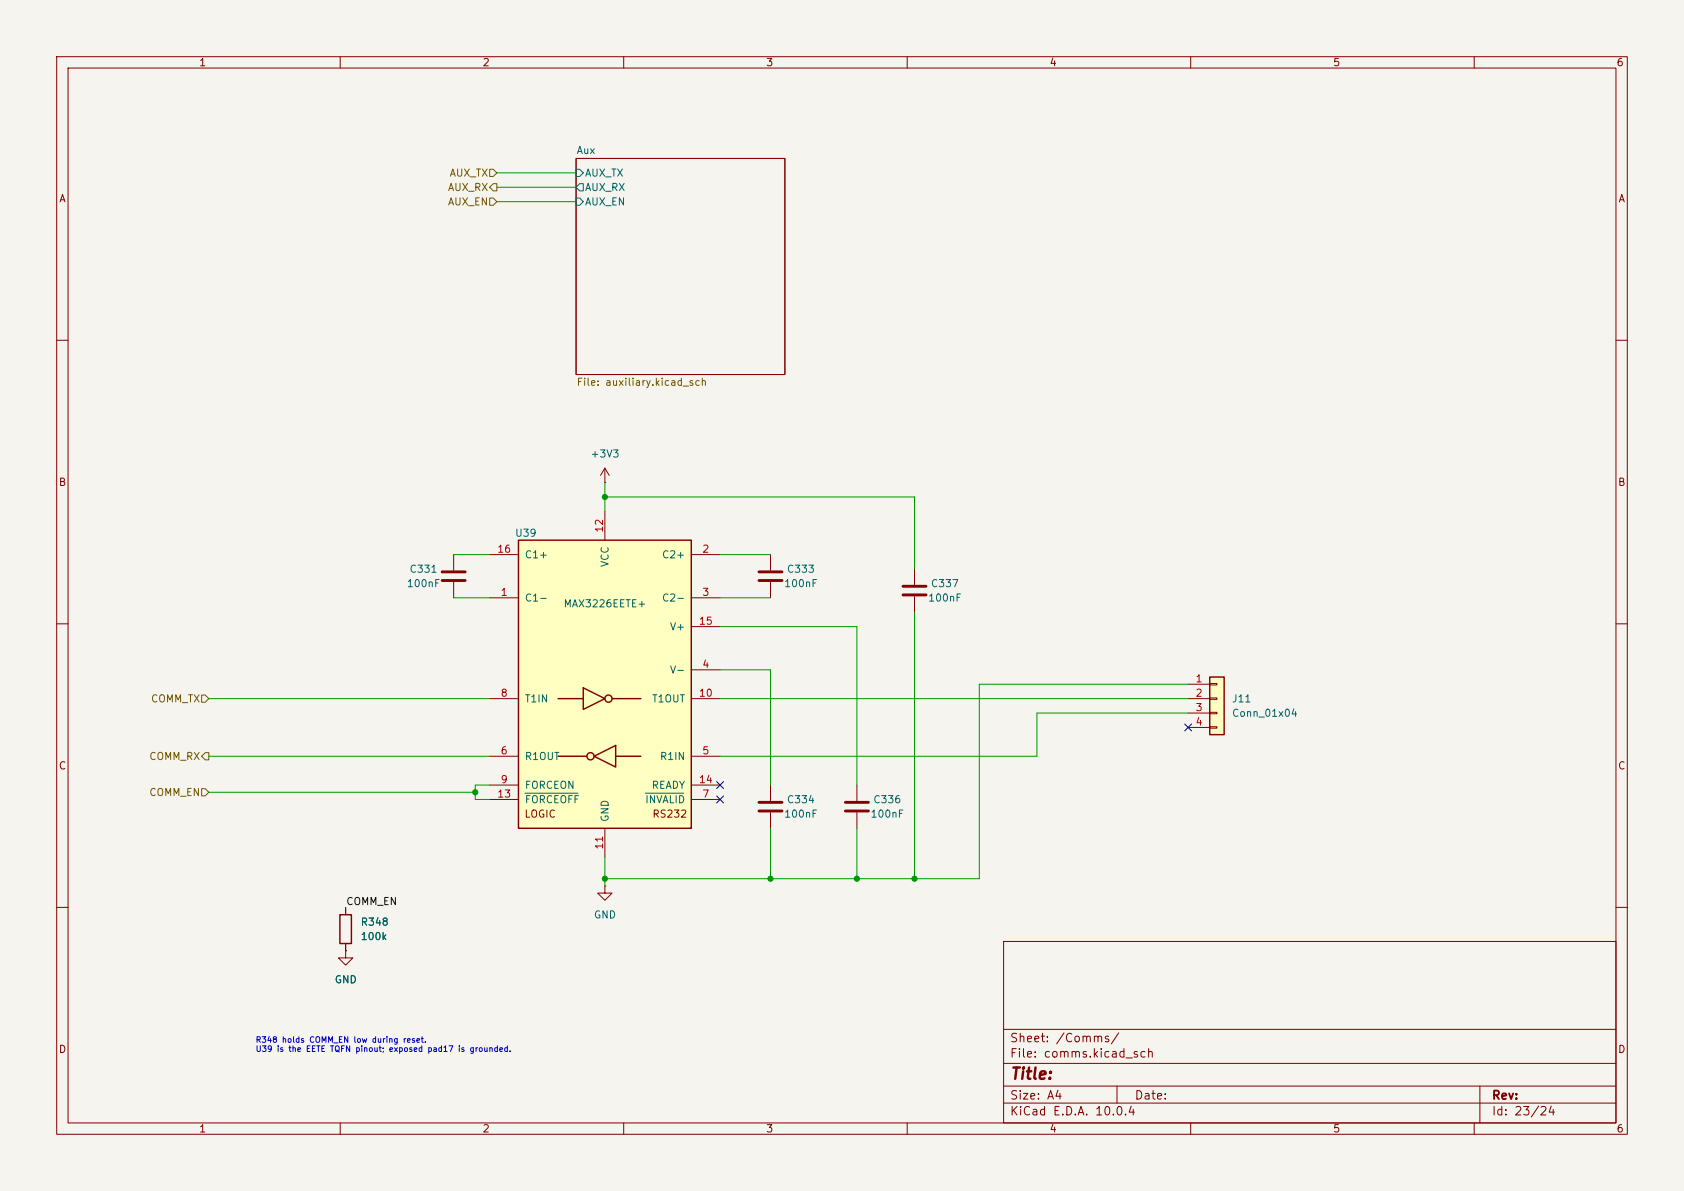
[picture p27: page 23]

R348 holds COMM_EN low during reset. U39 is the EETE TQFN pinout; exposed pad17 is grounded. R348

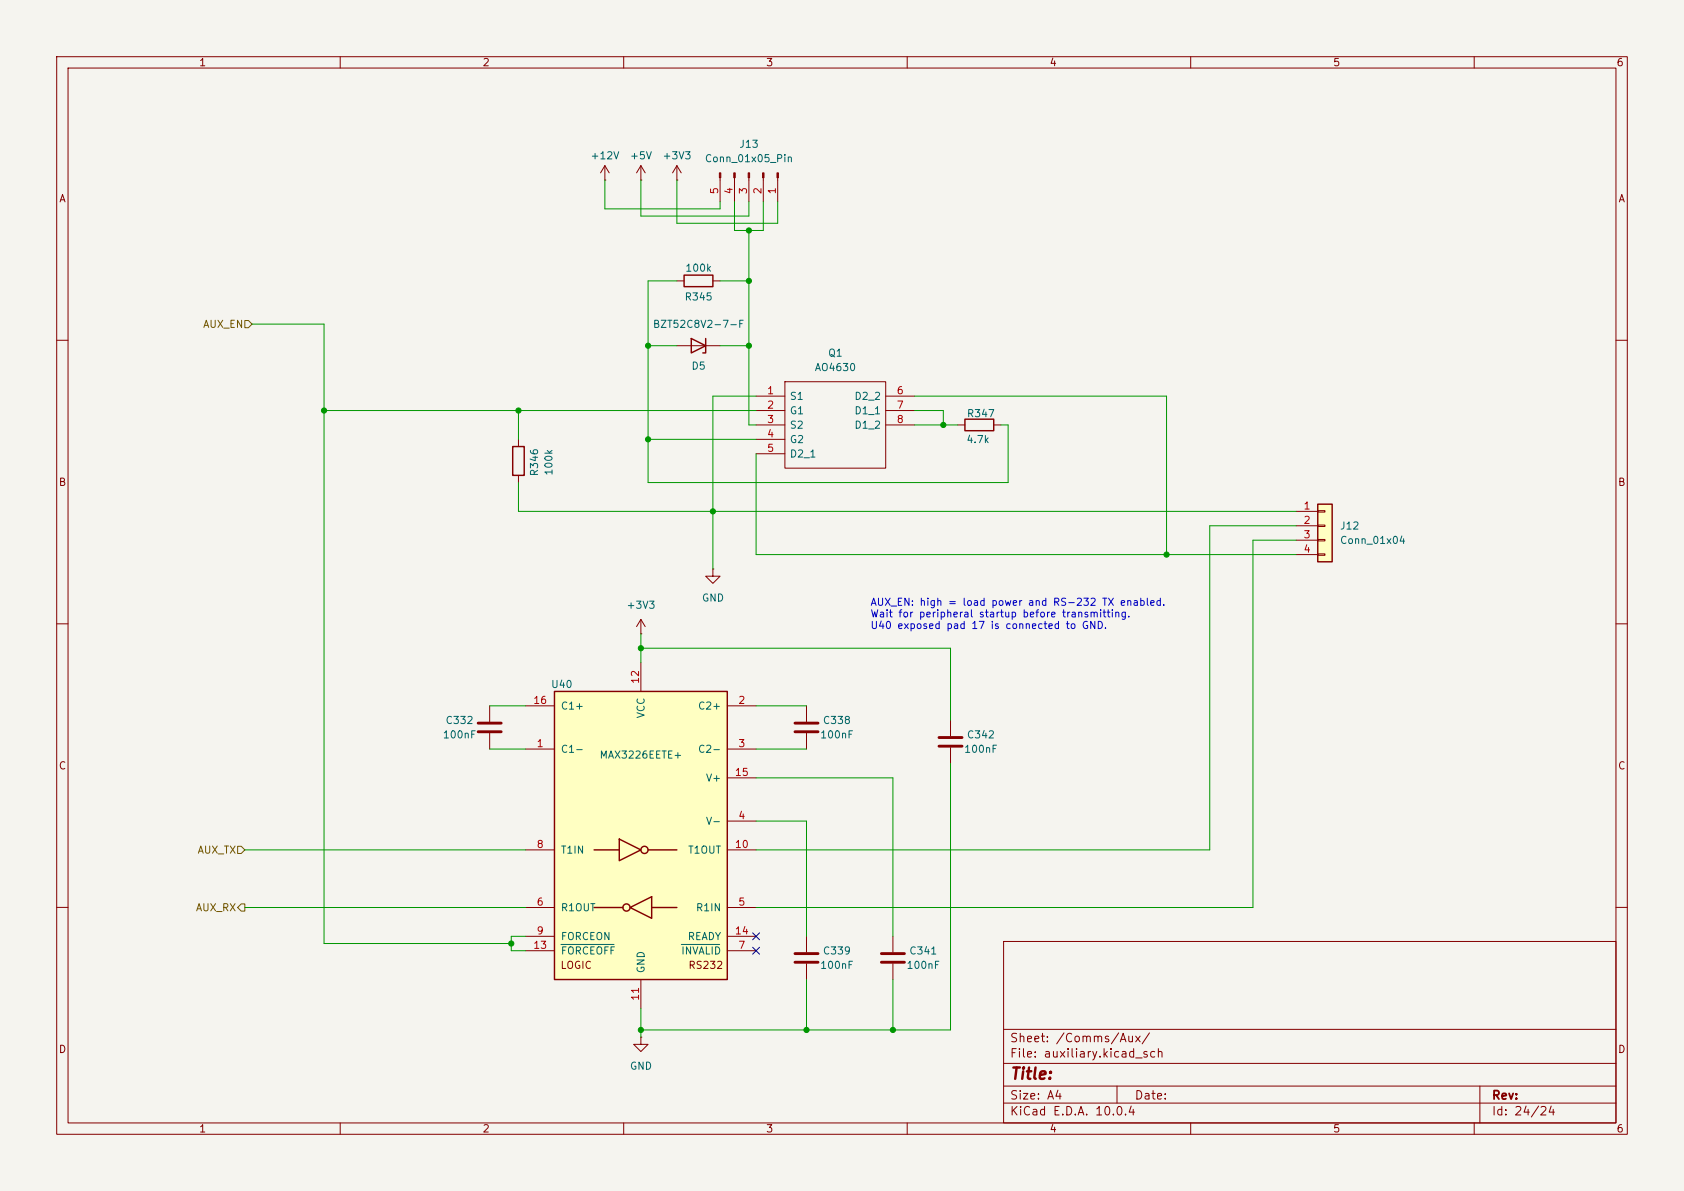
[picture p28: page 24]

AUX_EN: high = load power and RS-232 TX enabled. Wait for peripheral startup before transmitting. U40 exposed pad 17 is connected to GND.
