jkurina86/DIC_Board/Reviews/tps552892-12v-update-2026-09-16.pdf

## 12 V BUCK-BOOST | TPS552892 | 10-14 V INPUT

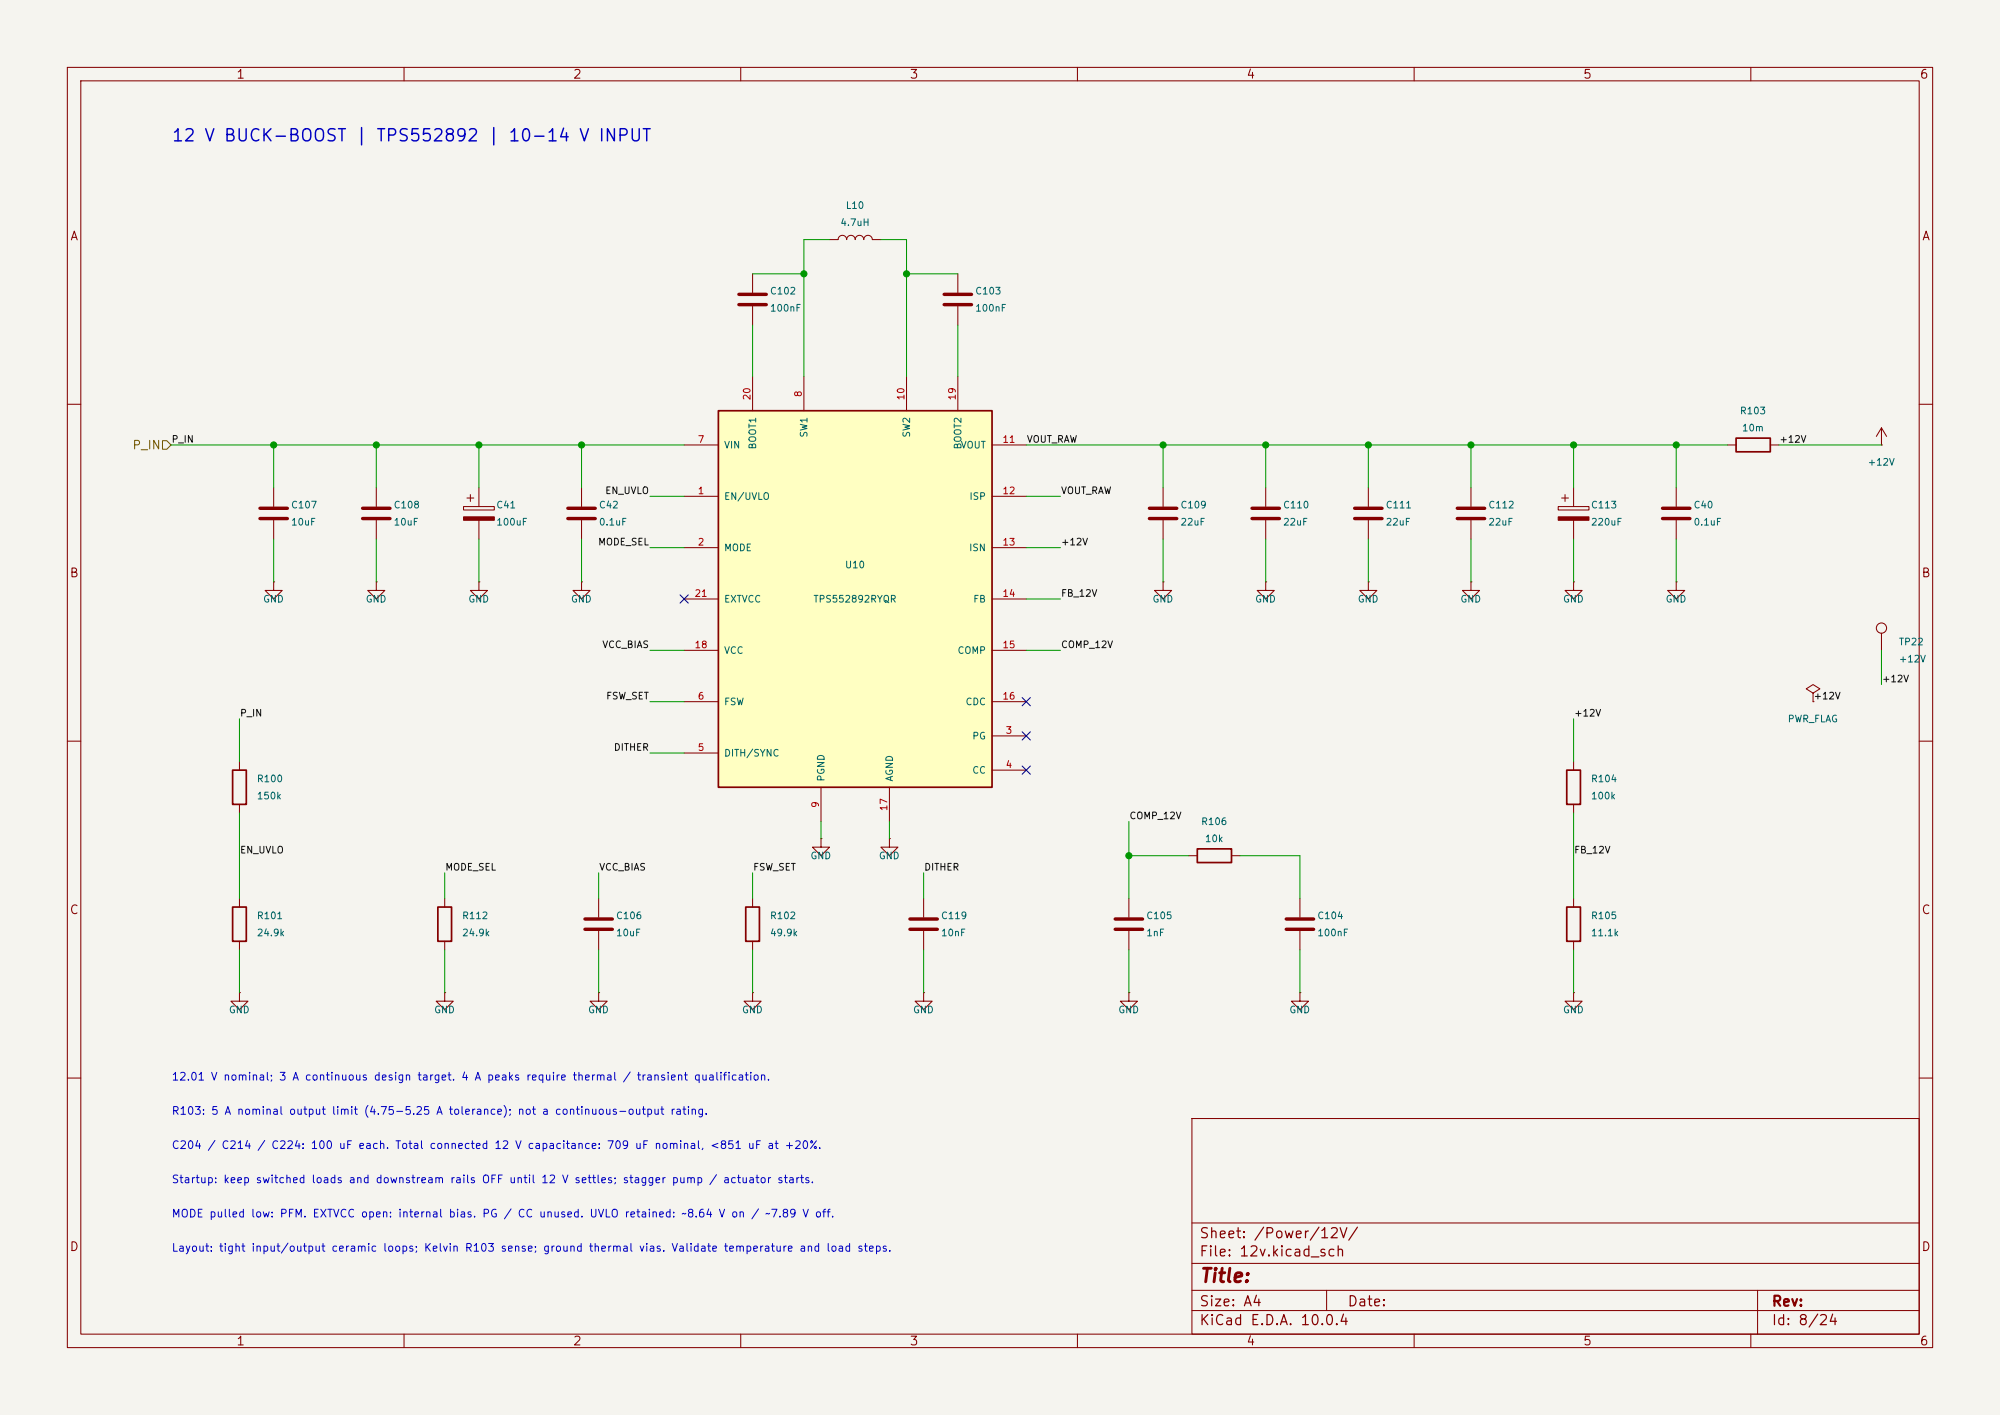
[picture p29: page 1]

12.01 V nominal; 3 A continuous design target. 4 A peaks require thermal / transient qualification.
