jkurina86/DIC_Board/DIC_Board/DIC_Board.pdf

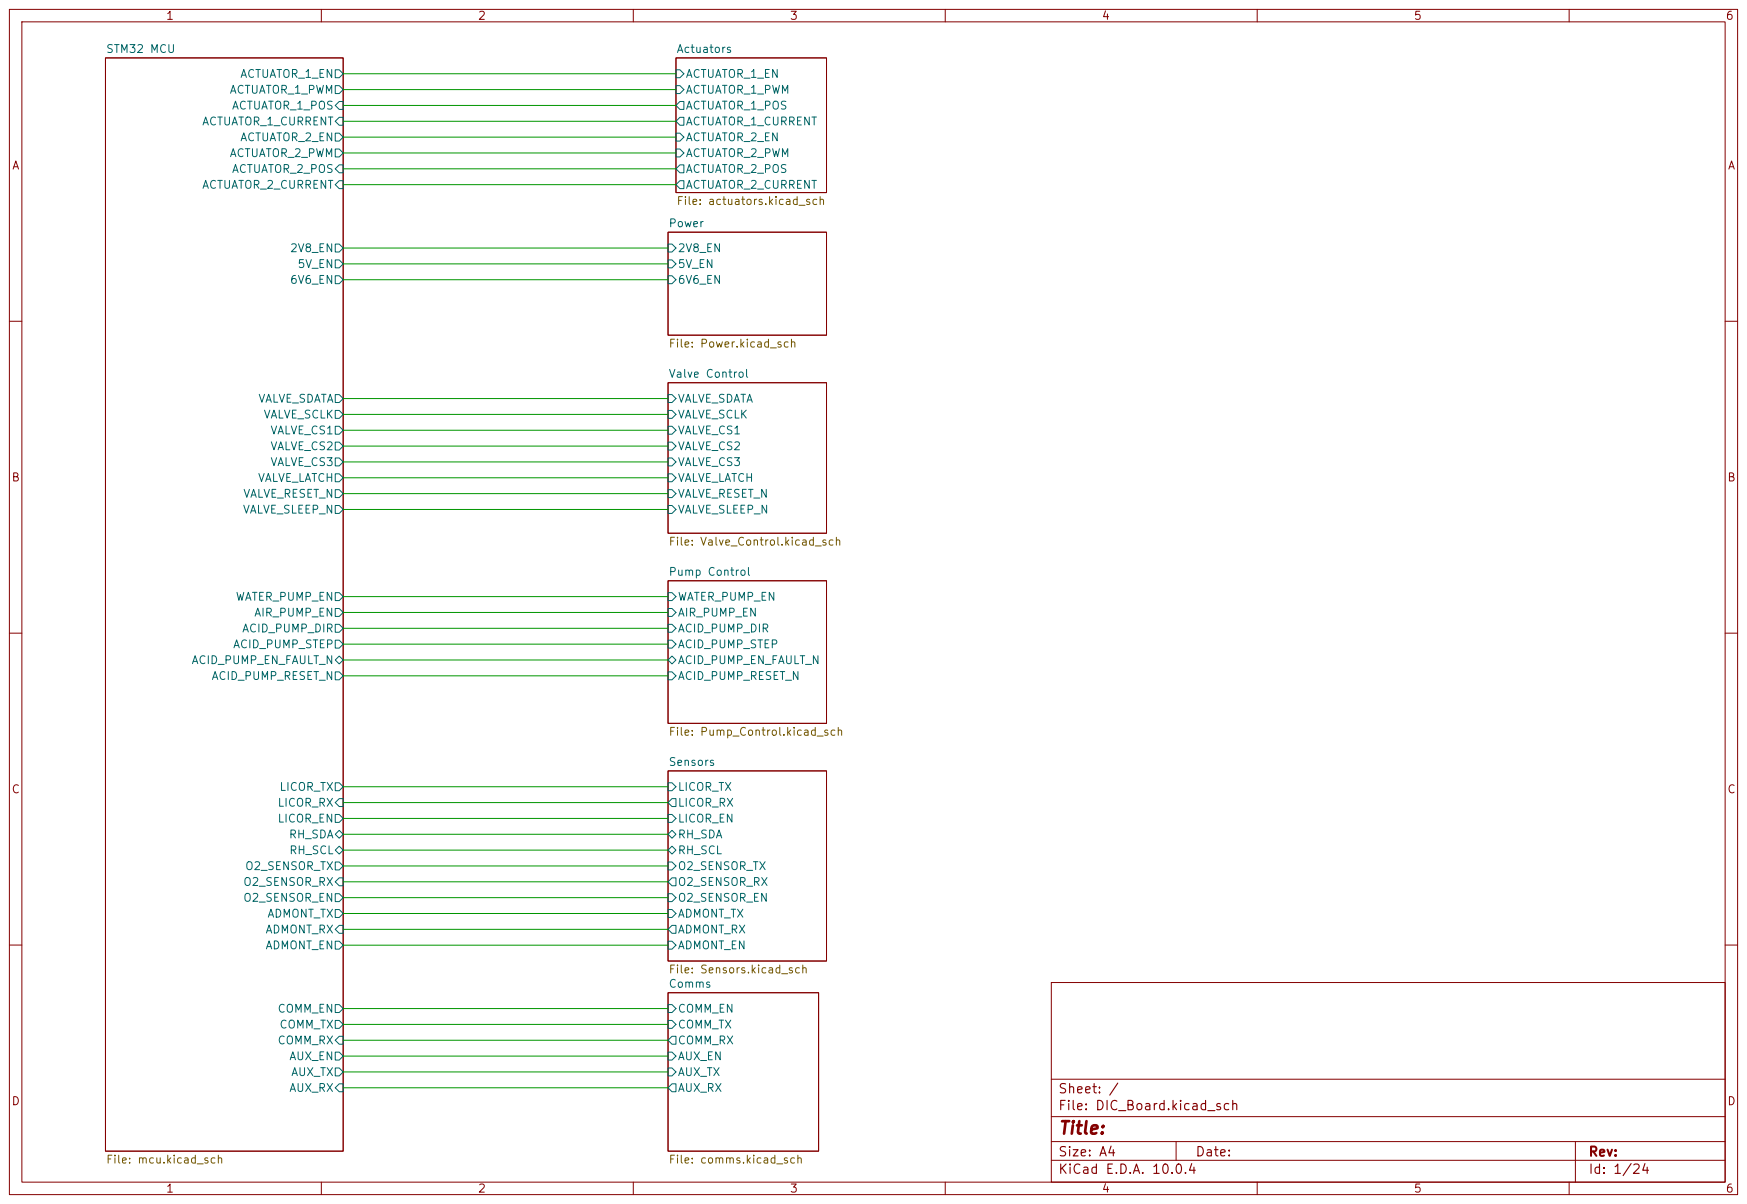
[picture p30: page 1]

Size: A4 | Rev:
KiCad E.D.A. 10.0.4 | Id: 1/24

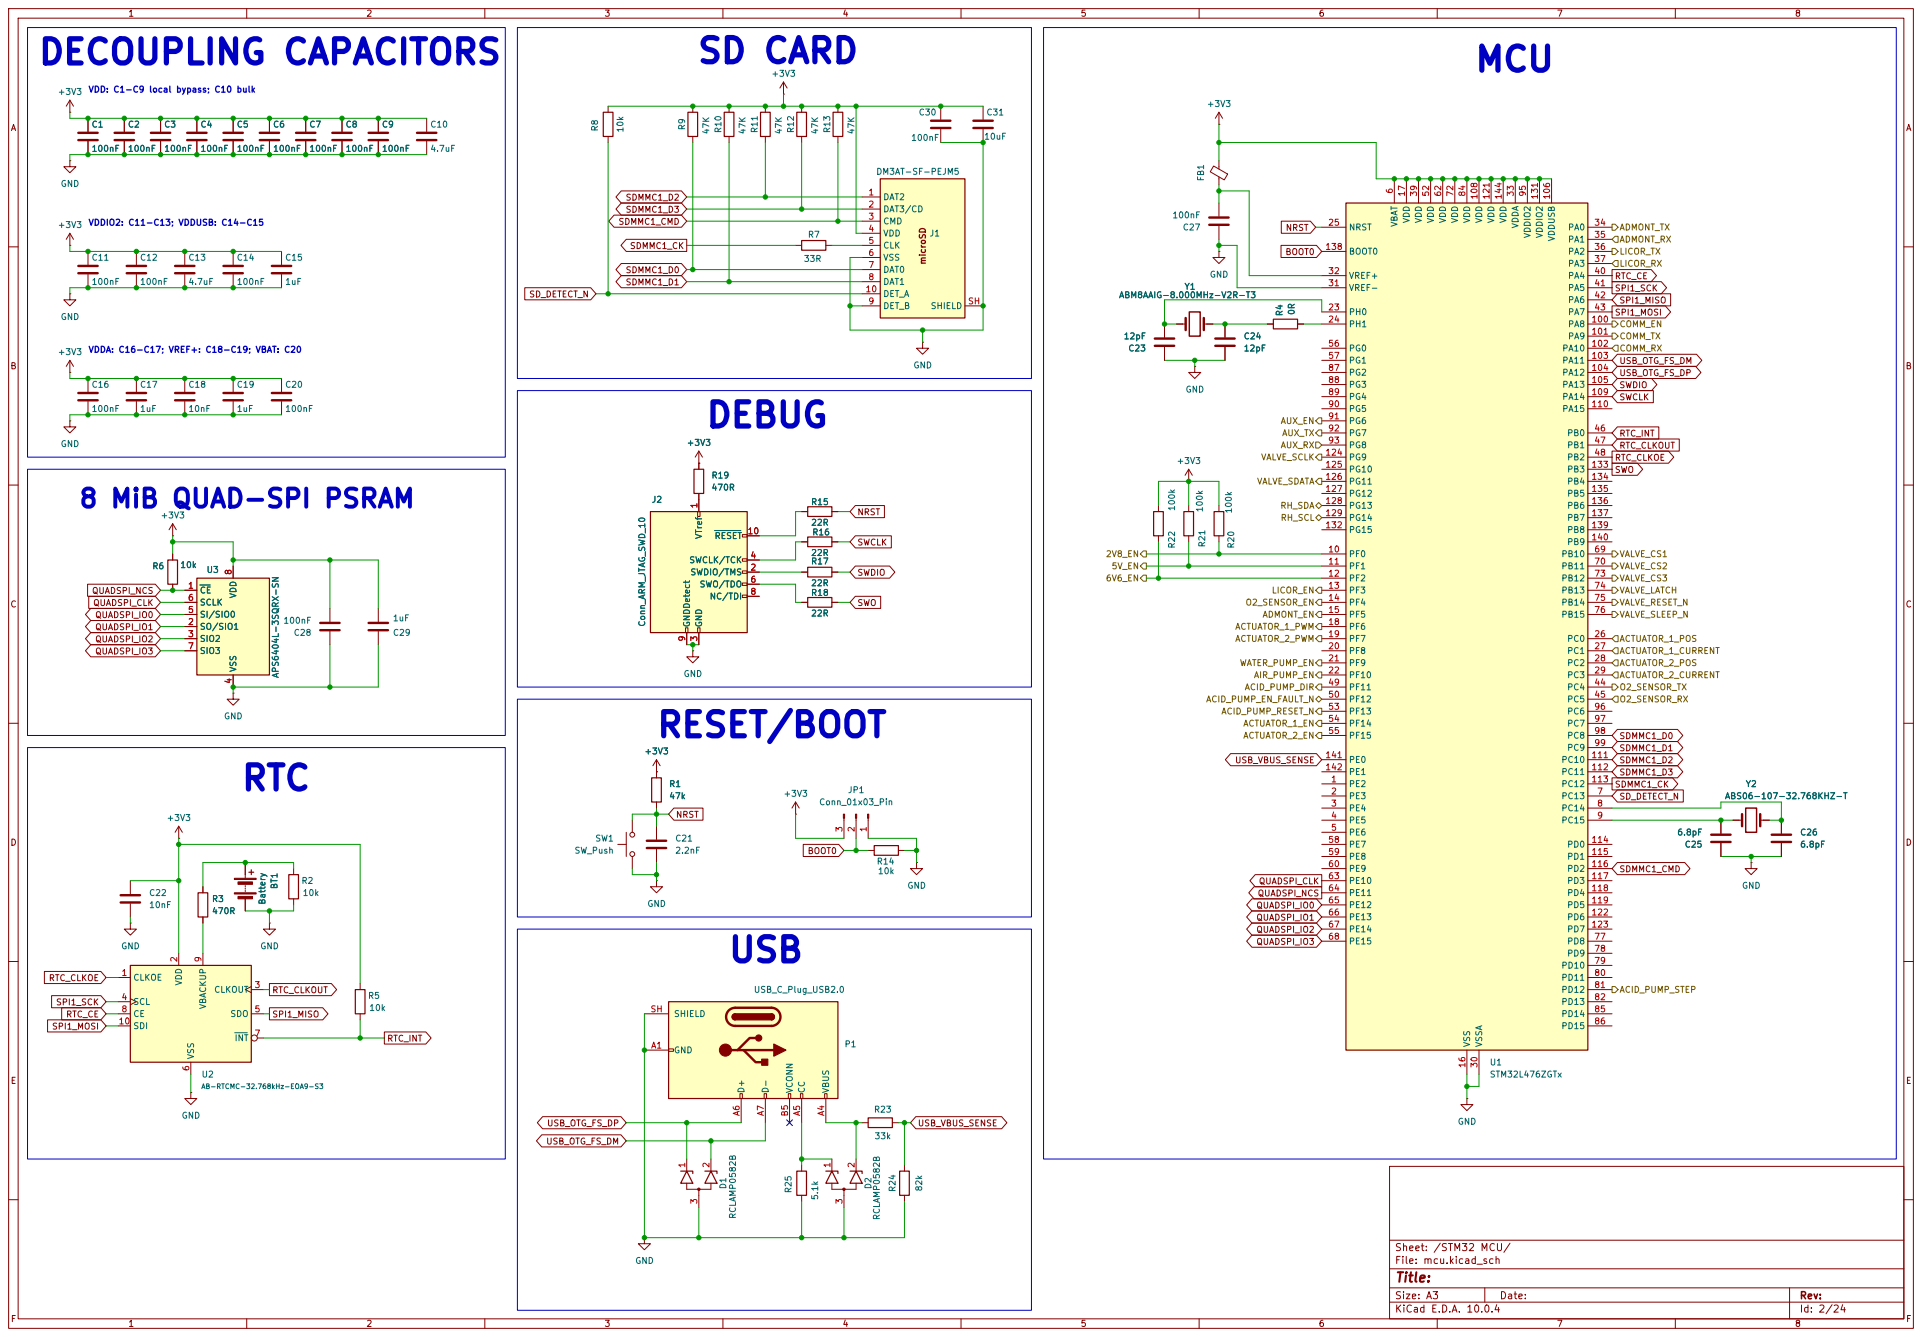
[picture p31: page 2]

DAT2 1 DAT3/CD 2 CMD 3

R7 | VDD 4 CLK 5

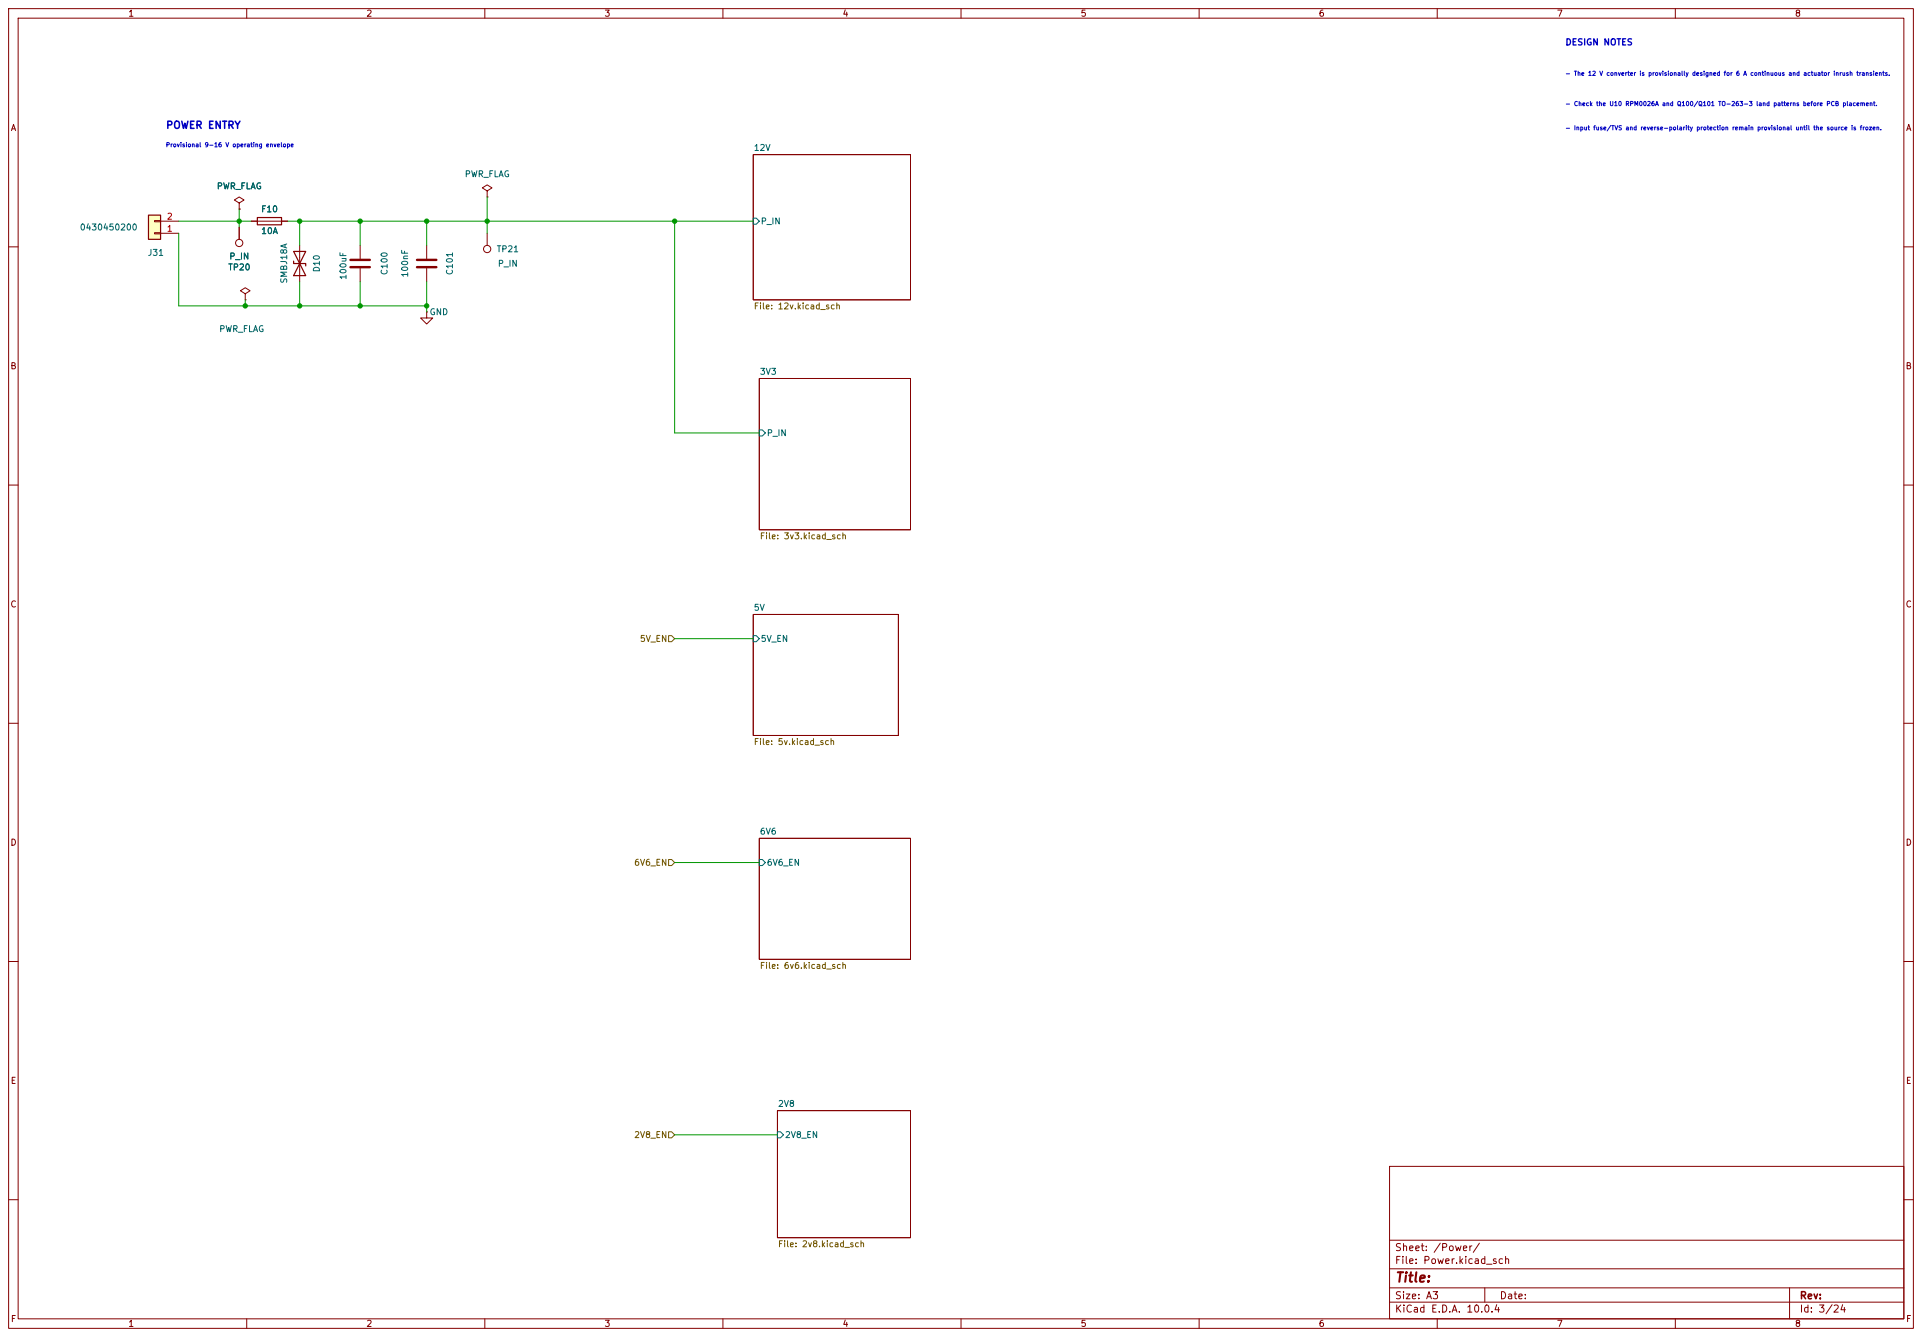
[picture p32: page 3]

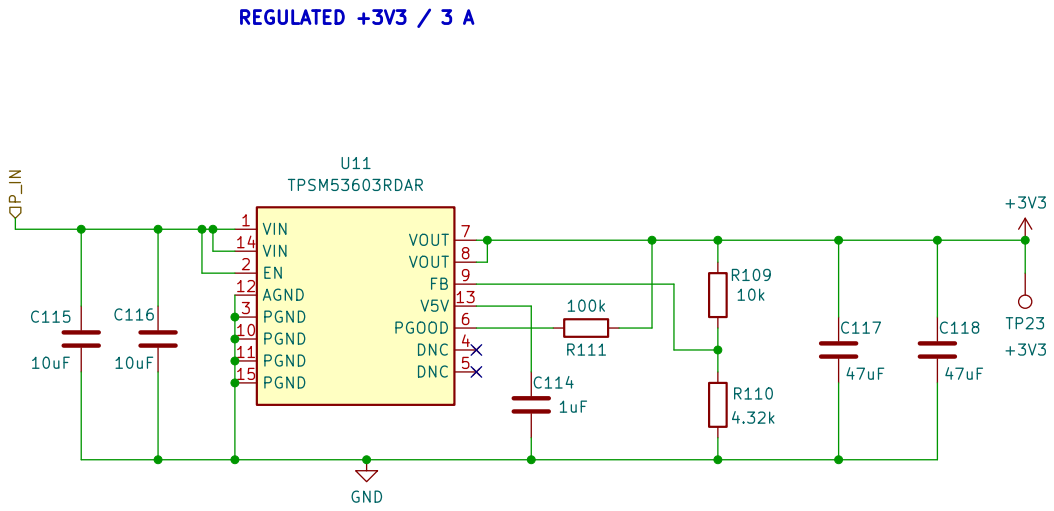
[picture p33: page 4]

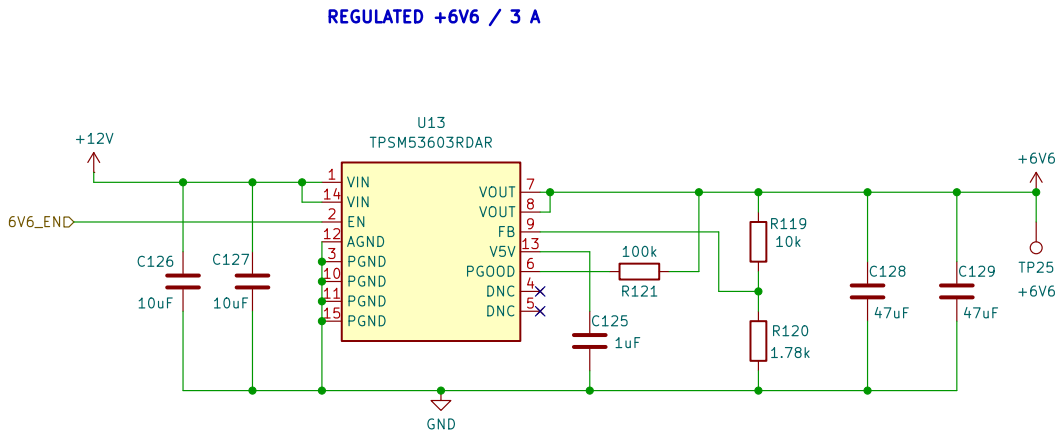
[picture p34: page 5]

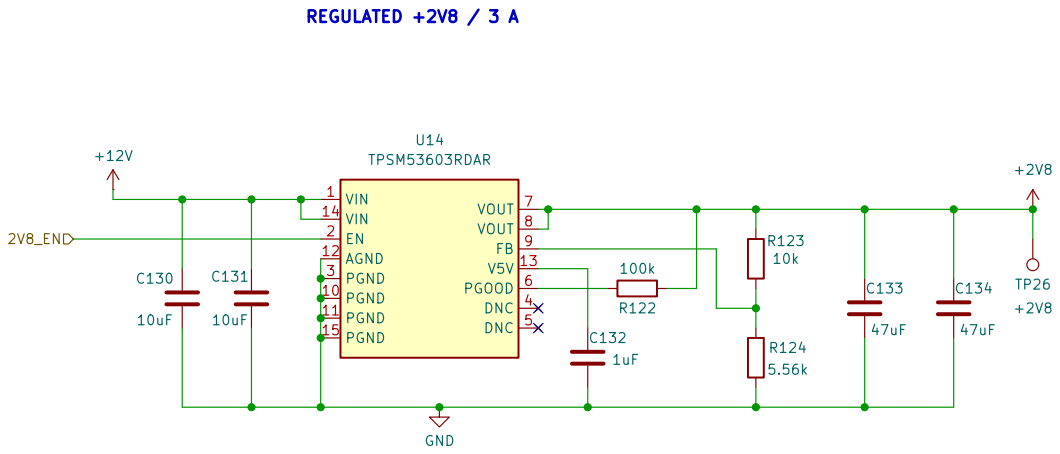
[picture p35: page 6]

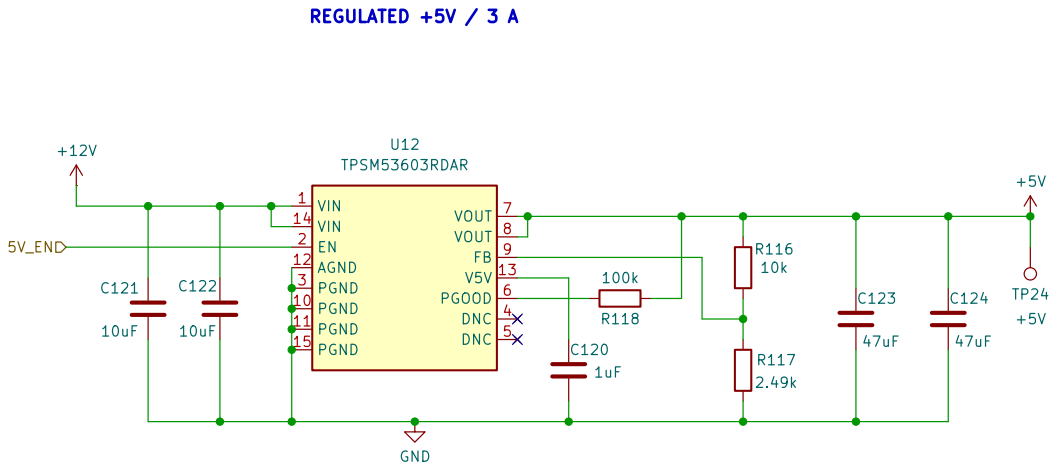
[picture p36: page 7]

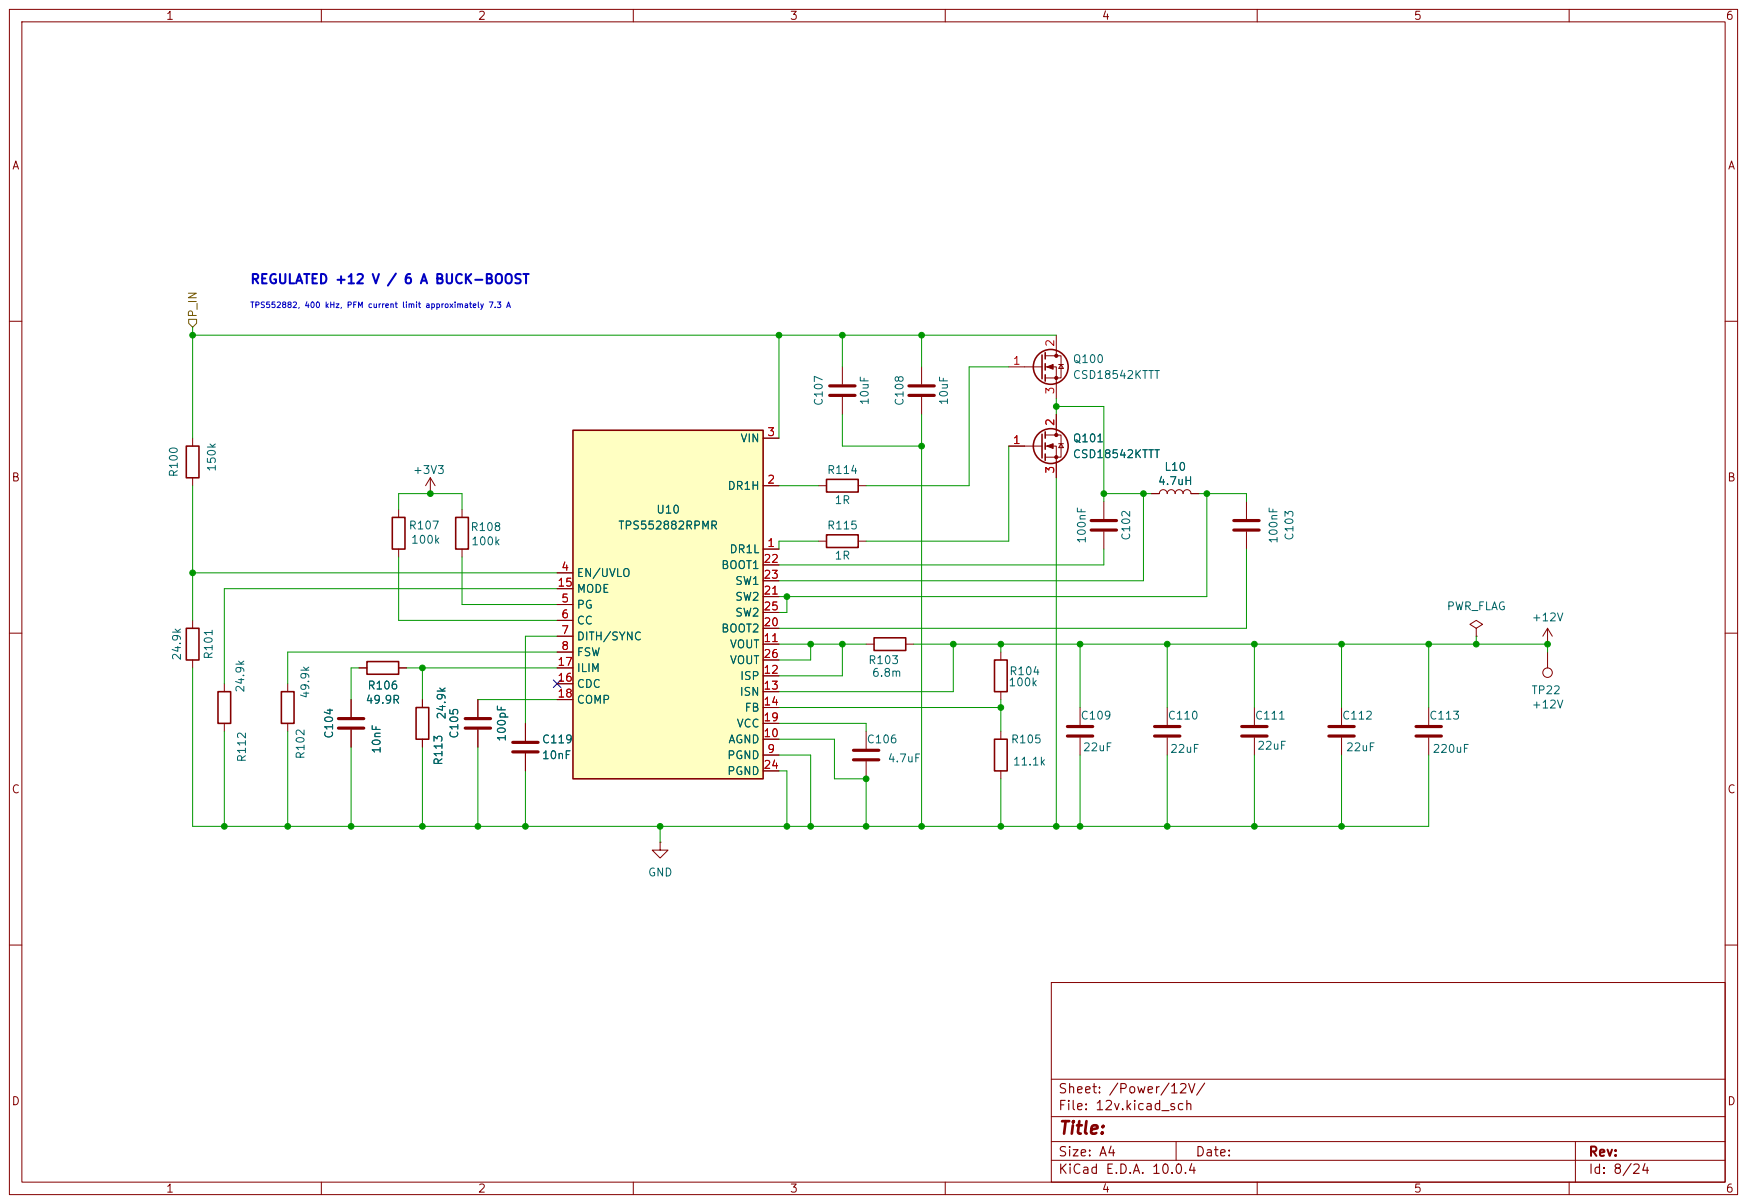
[picture p37: page 8]

FB 14 MODE 15 CDC 16 ILIM 17 COMP 18

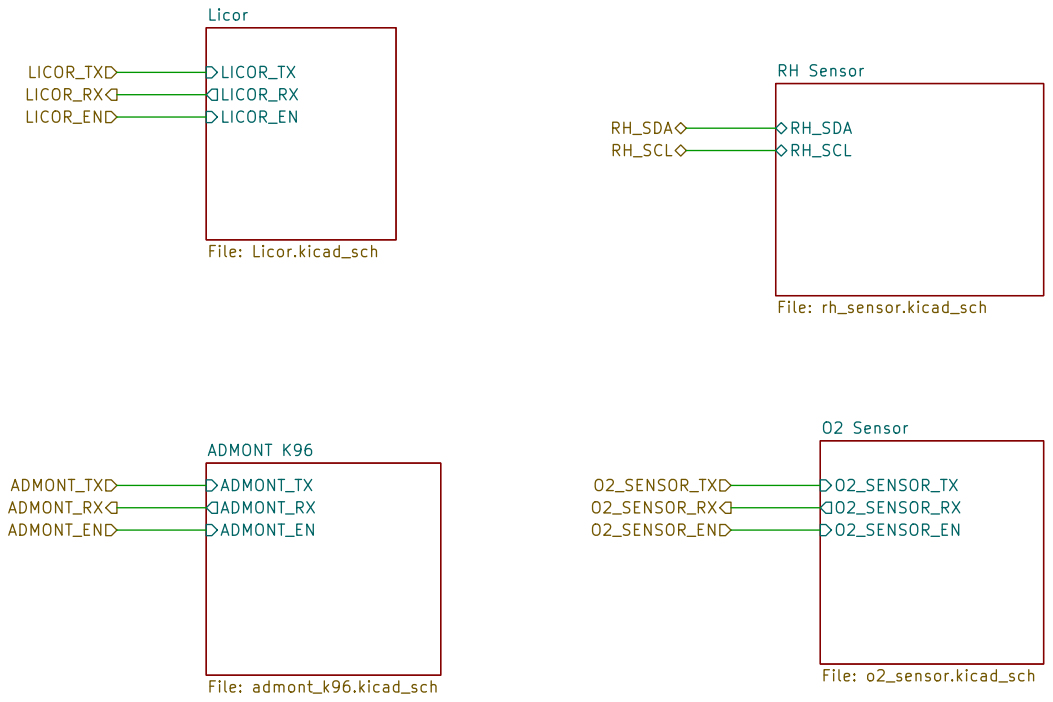
[picture p38: page 9]

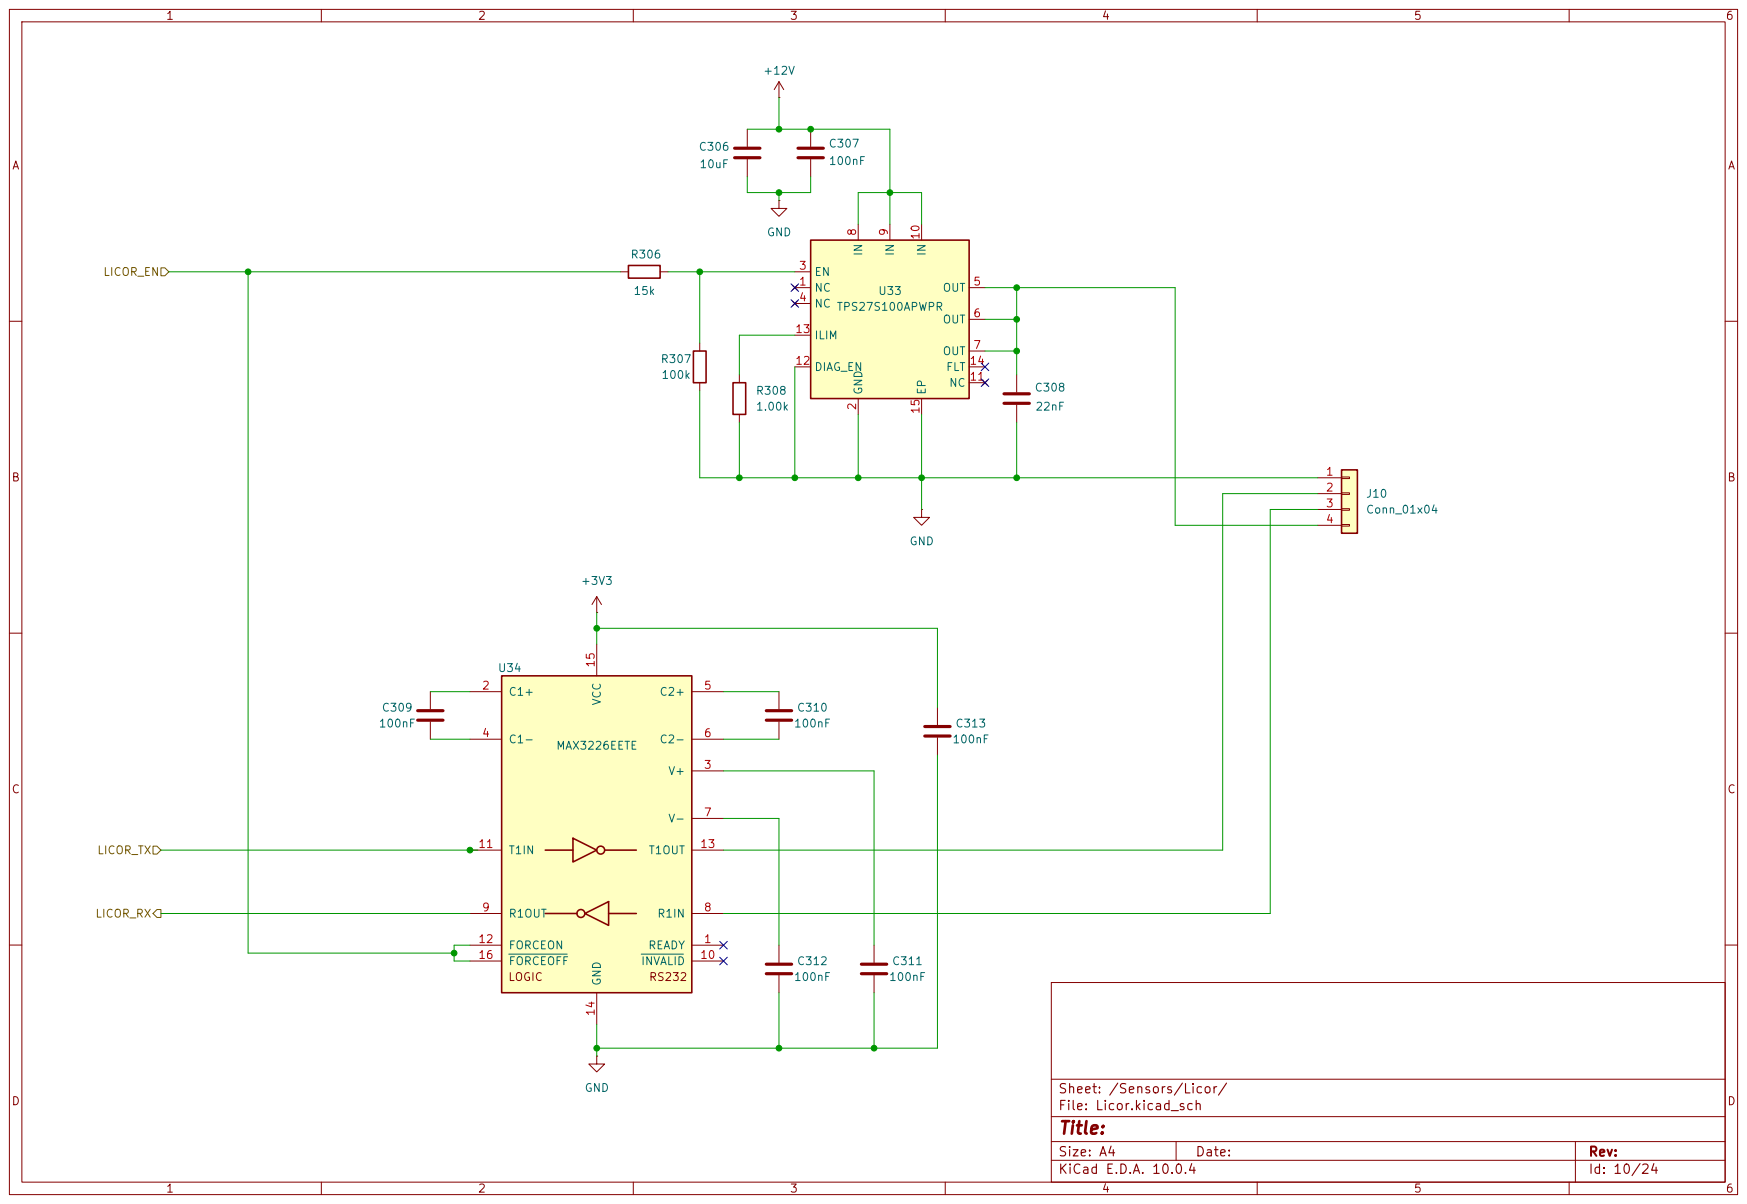
[picture p39: page 10]

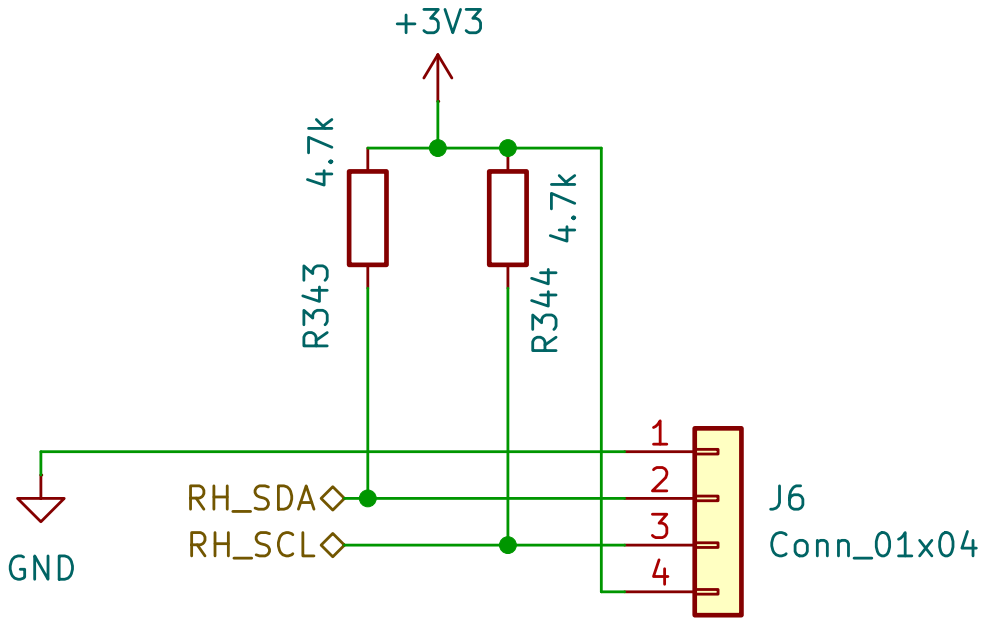
[picture p40: page 11]

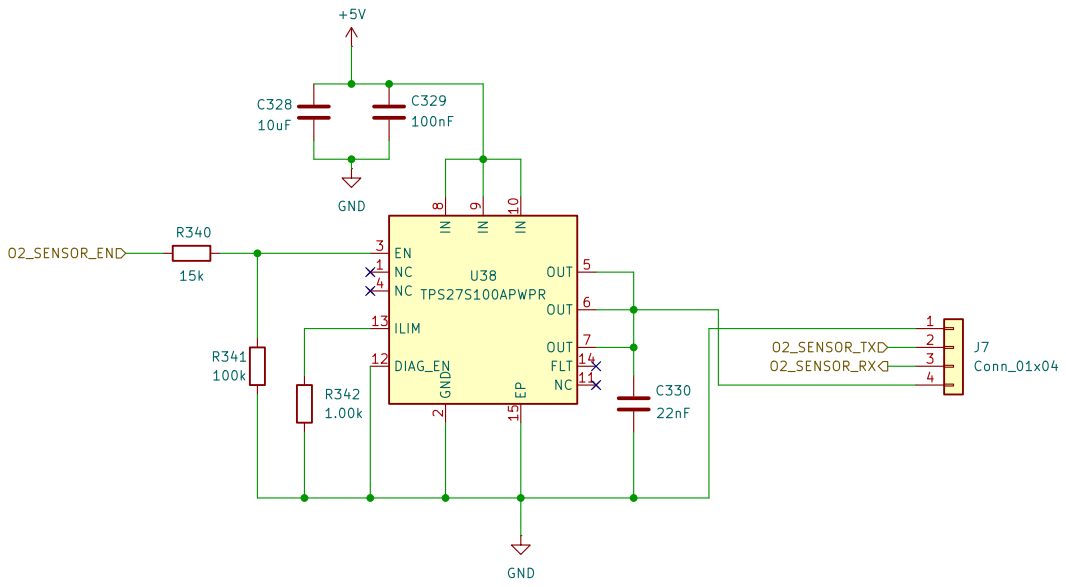
[picture p41: page 12]

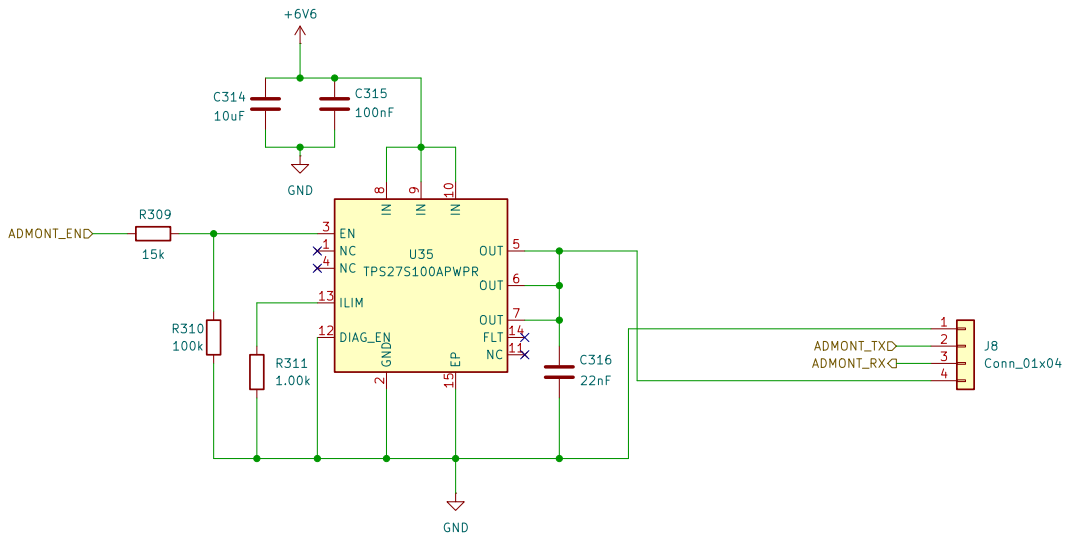
[picture p42: page 13]

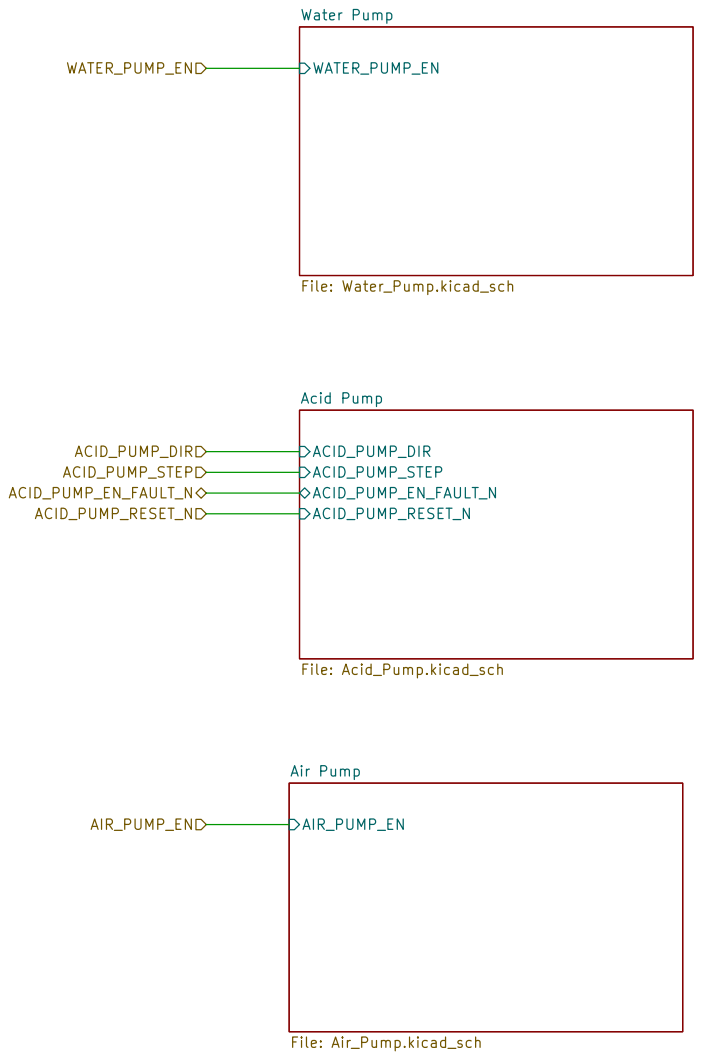
[picture p43: page 14]

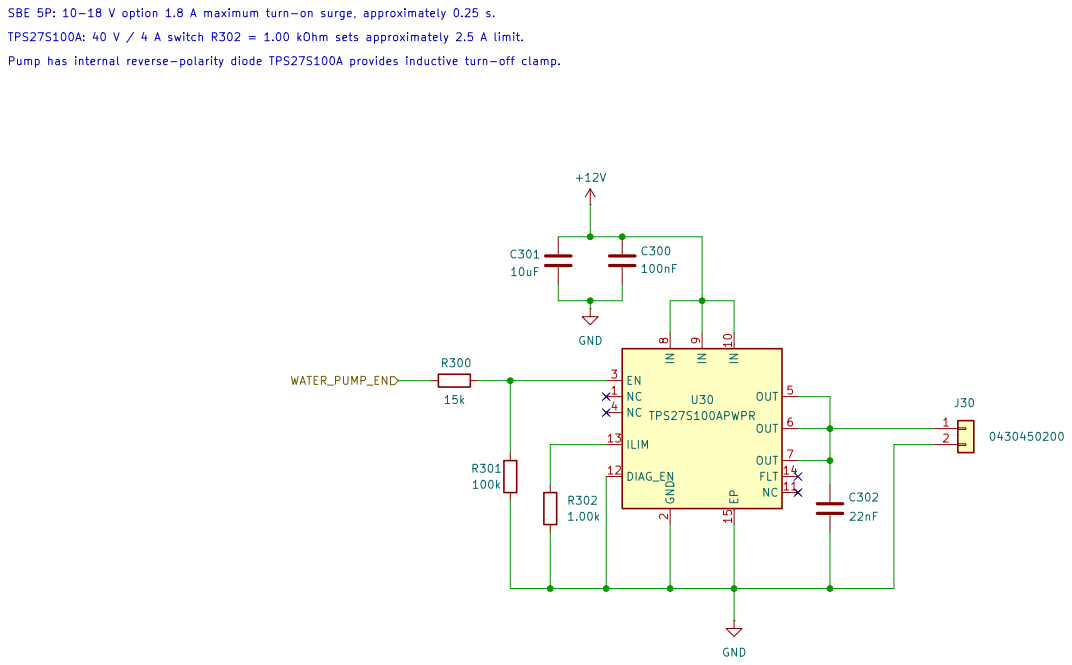
[picture p44: page 15]

Pump has internal reverse-polarity diode TPS27S100A provides inductive turn-off clamp. SBE 5P: 10-18 V option 1.8 A maximum turn-on surge, approximately 0.25 s. TPS27S100A: 40 V / 4 A switch R302 = 1.00 kOhm sets approximately 2.5 A limit.

TPS27S100A smart switch; nominal 2.5-A current limit
Sea-Bird SBE 5P pump, 12-V high-side control

Sheet: /Pump Control/Water Pump/
File: Water_Pump.kicad_sch
Title: Water Pump

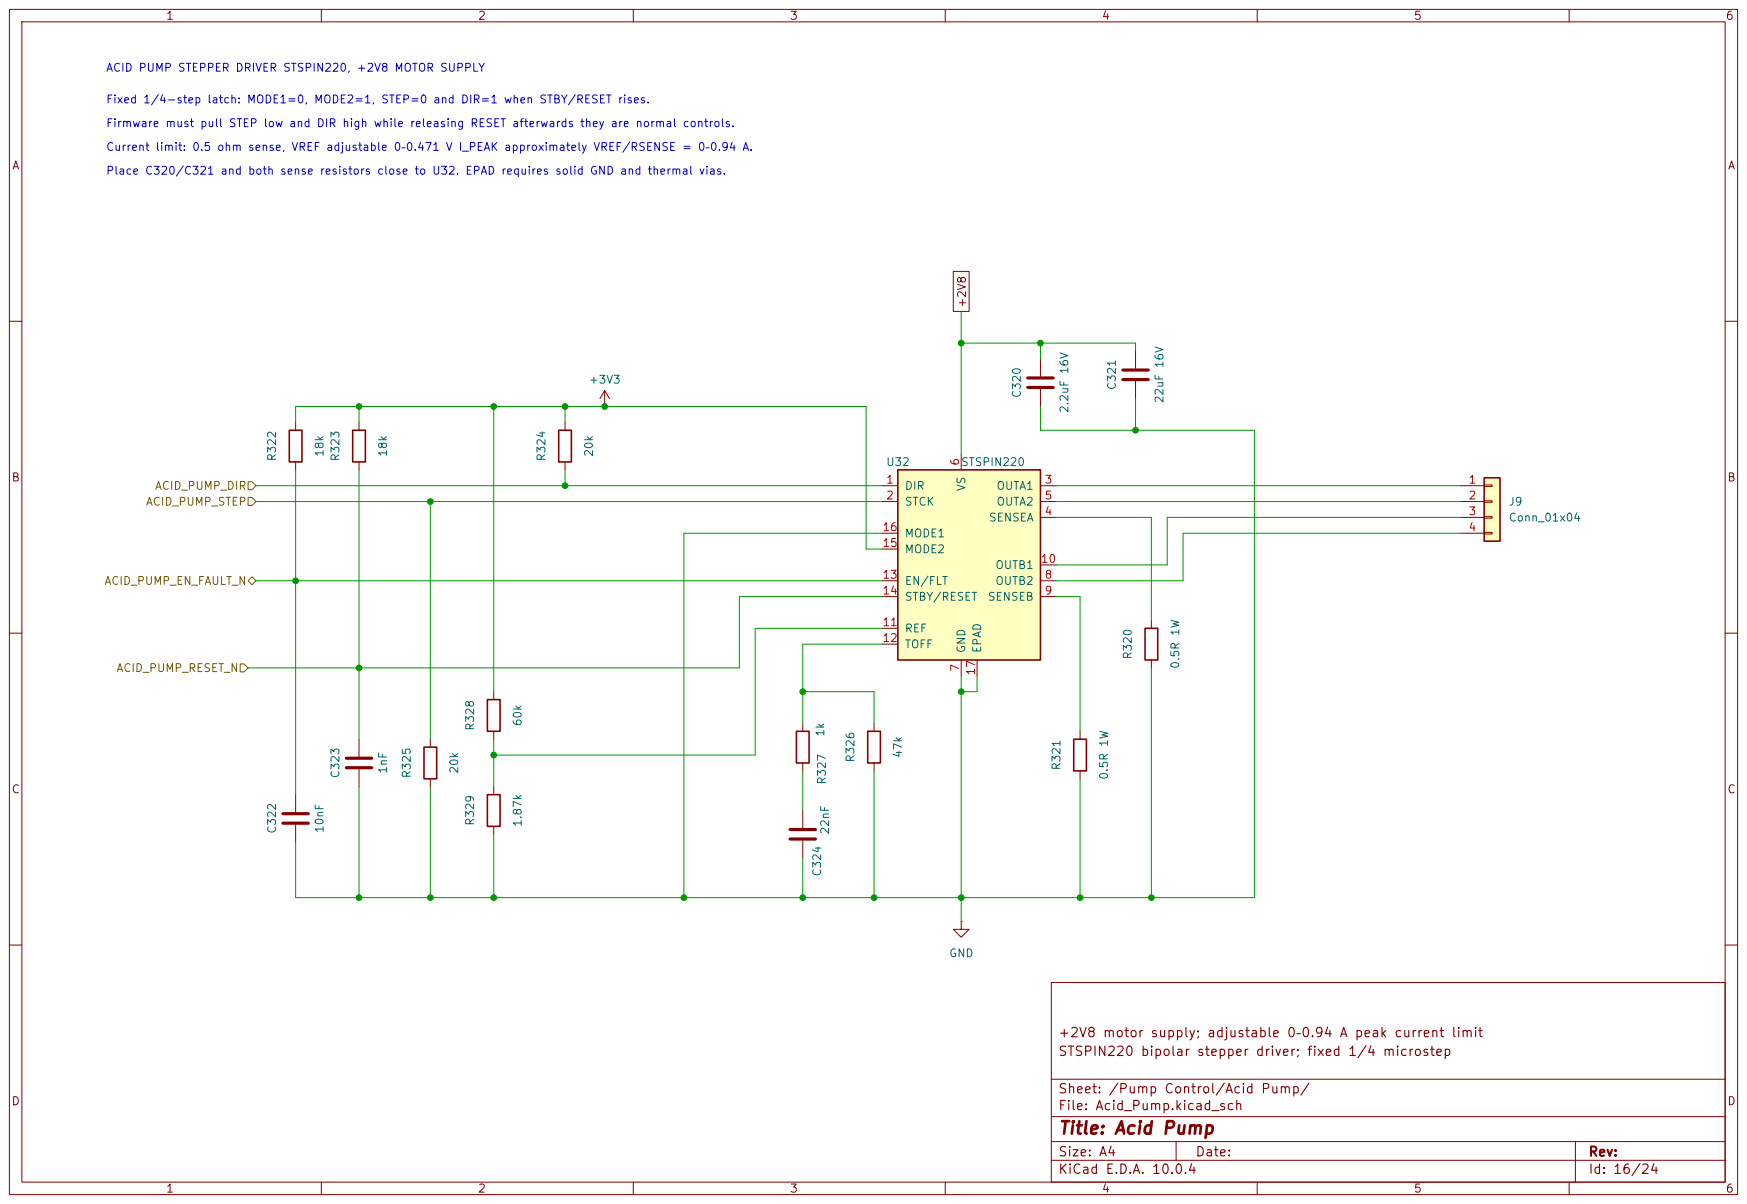
[picture p45: page 16]

Fixed 1/4-step latch: MODE1=0, MODE2=1, STEP=0 and DIR=1 when STBY/RESET rises. Place C320/C321 and both sense resistors close to U32. EPAD requires solid GND and thermal vias. Current limit: 0.5 ohm sense, VREF adjustable 0–0.471 V I_PEAK approximately VREF/RSENSE = 0–0.94 A. ACID PUMP STEPPER DRIVER STSPIN220, +2V8 MOTOR SUPPLY

Firmware must pull STEP low and DIR high while releasing RESET afterwards they are normal controls.

STSPIN220 bipolar stepper driver; fixed 1/4 microstep

Sheet: /Pump Control/Acid Pump/
File: Acid_Pump.kicad_sch
Title: Acid Pump

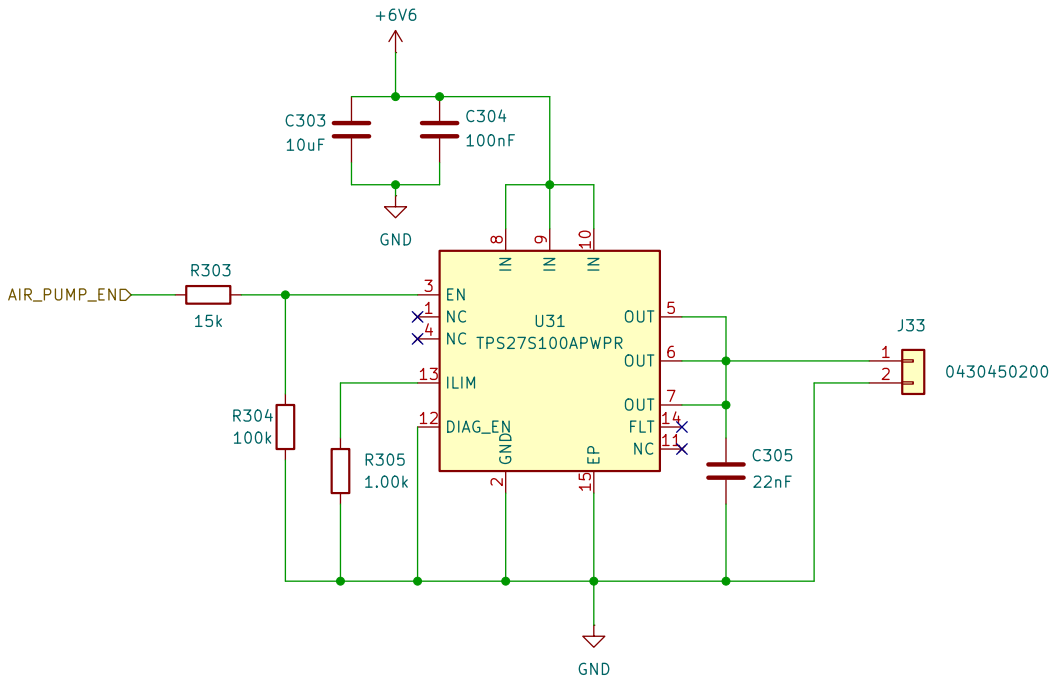
[picture p46: page 17]

Sheet: /Pump Control/Air Pump/
File: Air_Pump.kicad_sch
Title: Air Pump

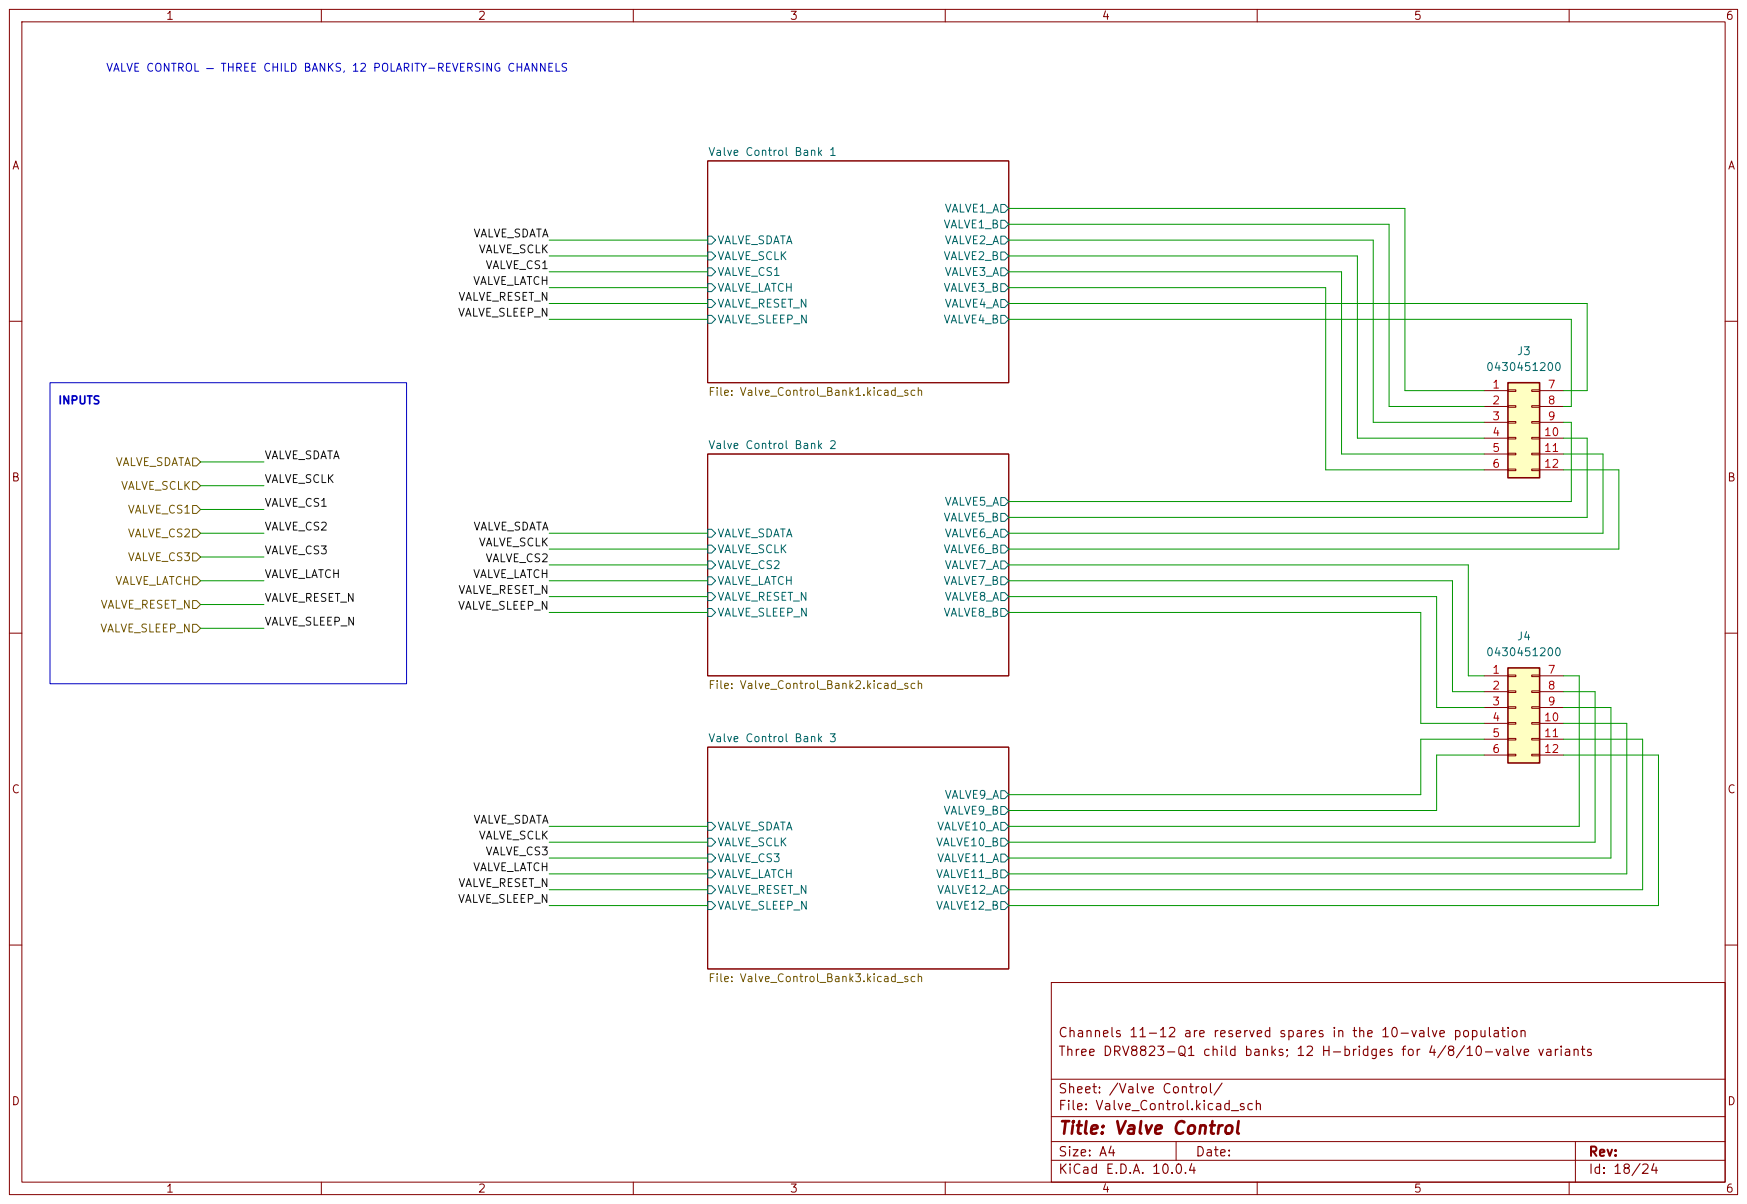
[picture p47: page 18]

VALVE CONTROL — THREE CHILD BANKS, 12 POLARITY-REVERSING CHANNELS

Channels 11-12 are reserved spares in the 10-valve population
Three DRV8823-Q1 child banks; 12 H-bridges for 4/8/10-valve variants

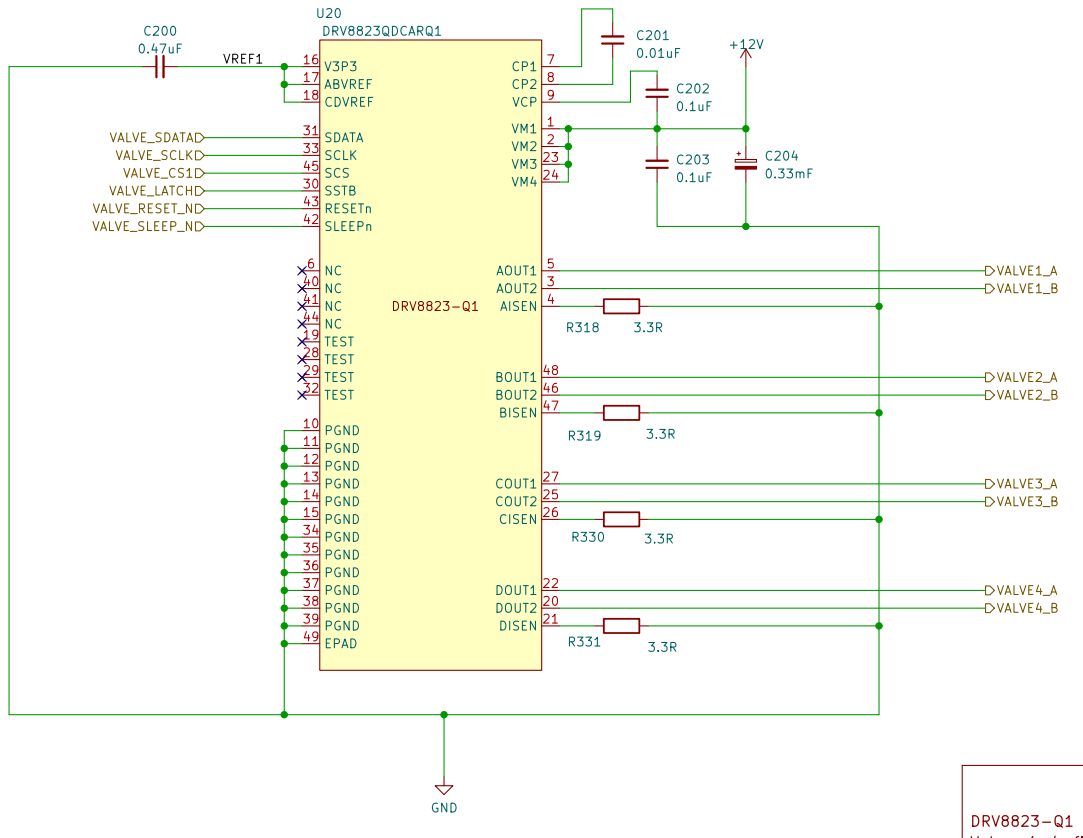
[picture p48: page 19]

SCLK 33 PGND 34 PGND 35 PGND 36 PGND 37 PGND 38 PGND 39 NC 40 NC 41
VM4 24 COUT2 25 CISEN 26 COUT1 27

DRV8823-Q1 serial quad H-bridge
Valves 1-4; fit all 4/8/10-valve variants

Sheet: /Valve Control/Valve Control Bank 1/
File: Valve_Control_Bank1.kicad_sch
Title: Valve Control Bank 1

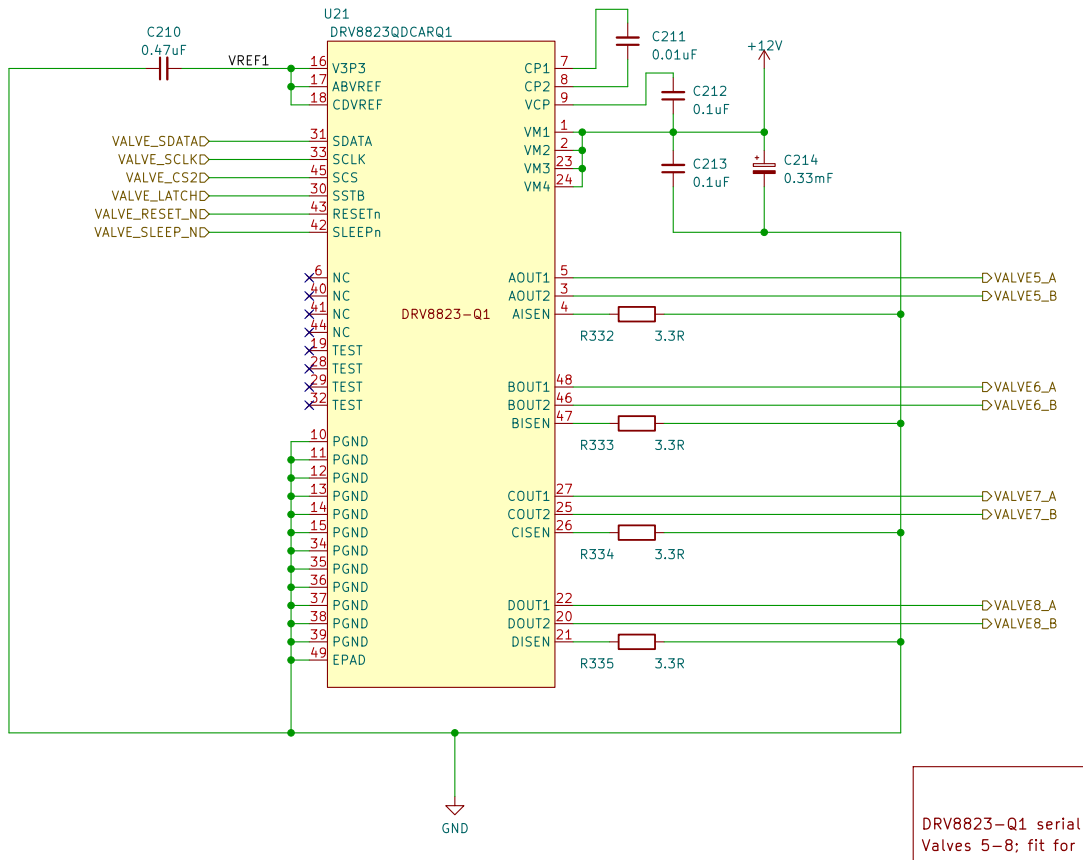
[picture p49: page 20]
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

DRV8823-Q1 serial quad H-bridge
Valves 5-8; fit for 8/10-valve variants

Sheet: /Valve Control/Valve Control Bank 2/
File: Valve_Control_Bank2.kicad_sch
Title: Valve Control Bank 2

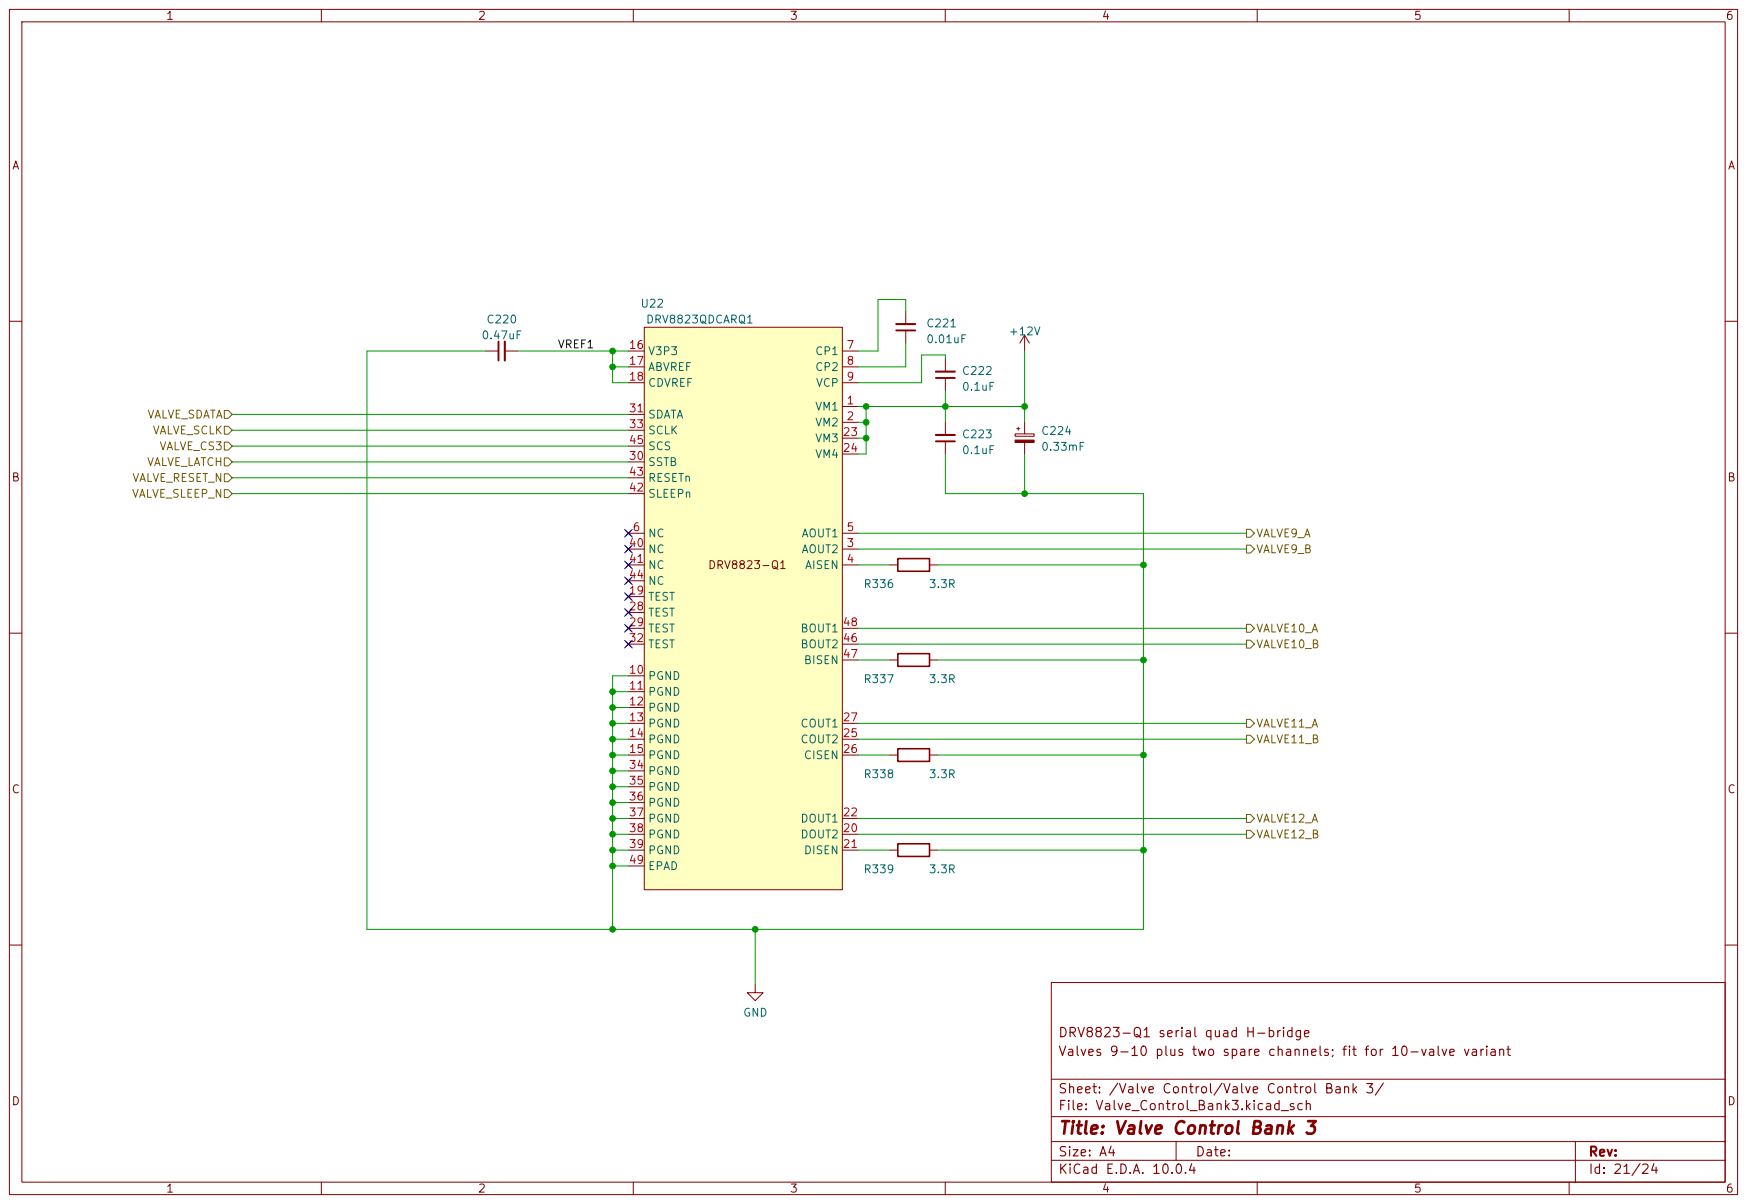
[picture p50: page 21]

SCLK 33 PGND 34 PGND 35 PGND 36 PGND 37 PGND 38 PGND 39 NC 40 NC 41
SSTB 30
SLEEPn 42 RESETn 43 NC 44

DRV8823-Q1 serial quad H-bridge
Valves 9-10 plus two spare channels; fit for 10-valve variant

Sheet: /Valve Control/Valve Control Bank 3/
File: Valve_Control_Bank3.kicad_sch
Title: Valve Control Bank 3

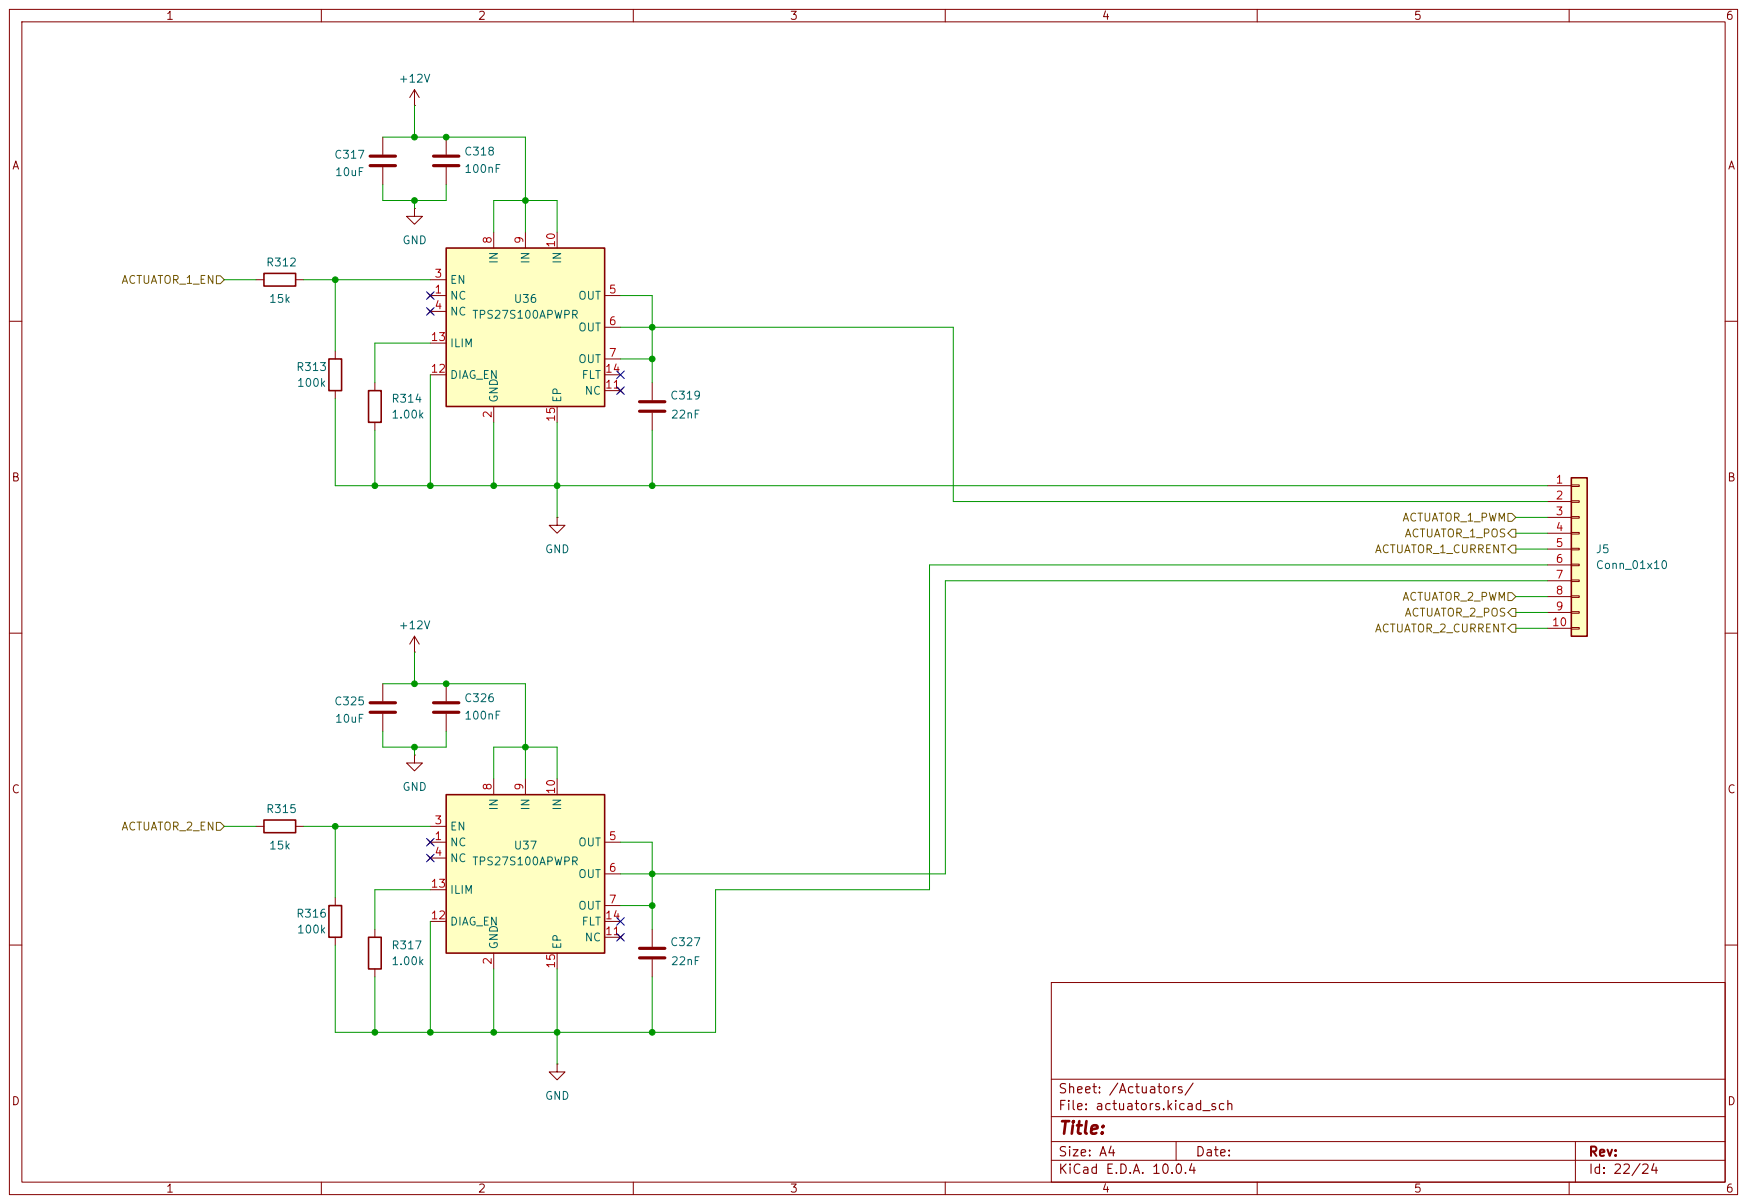
[picture p51: page 22]

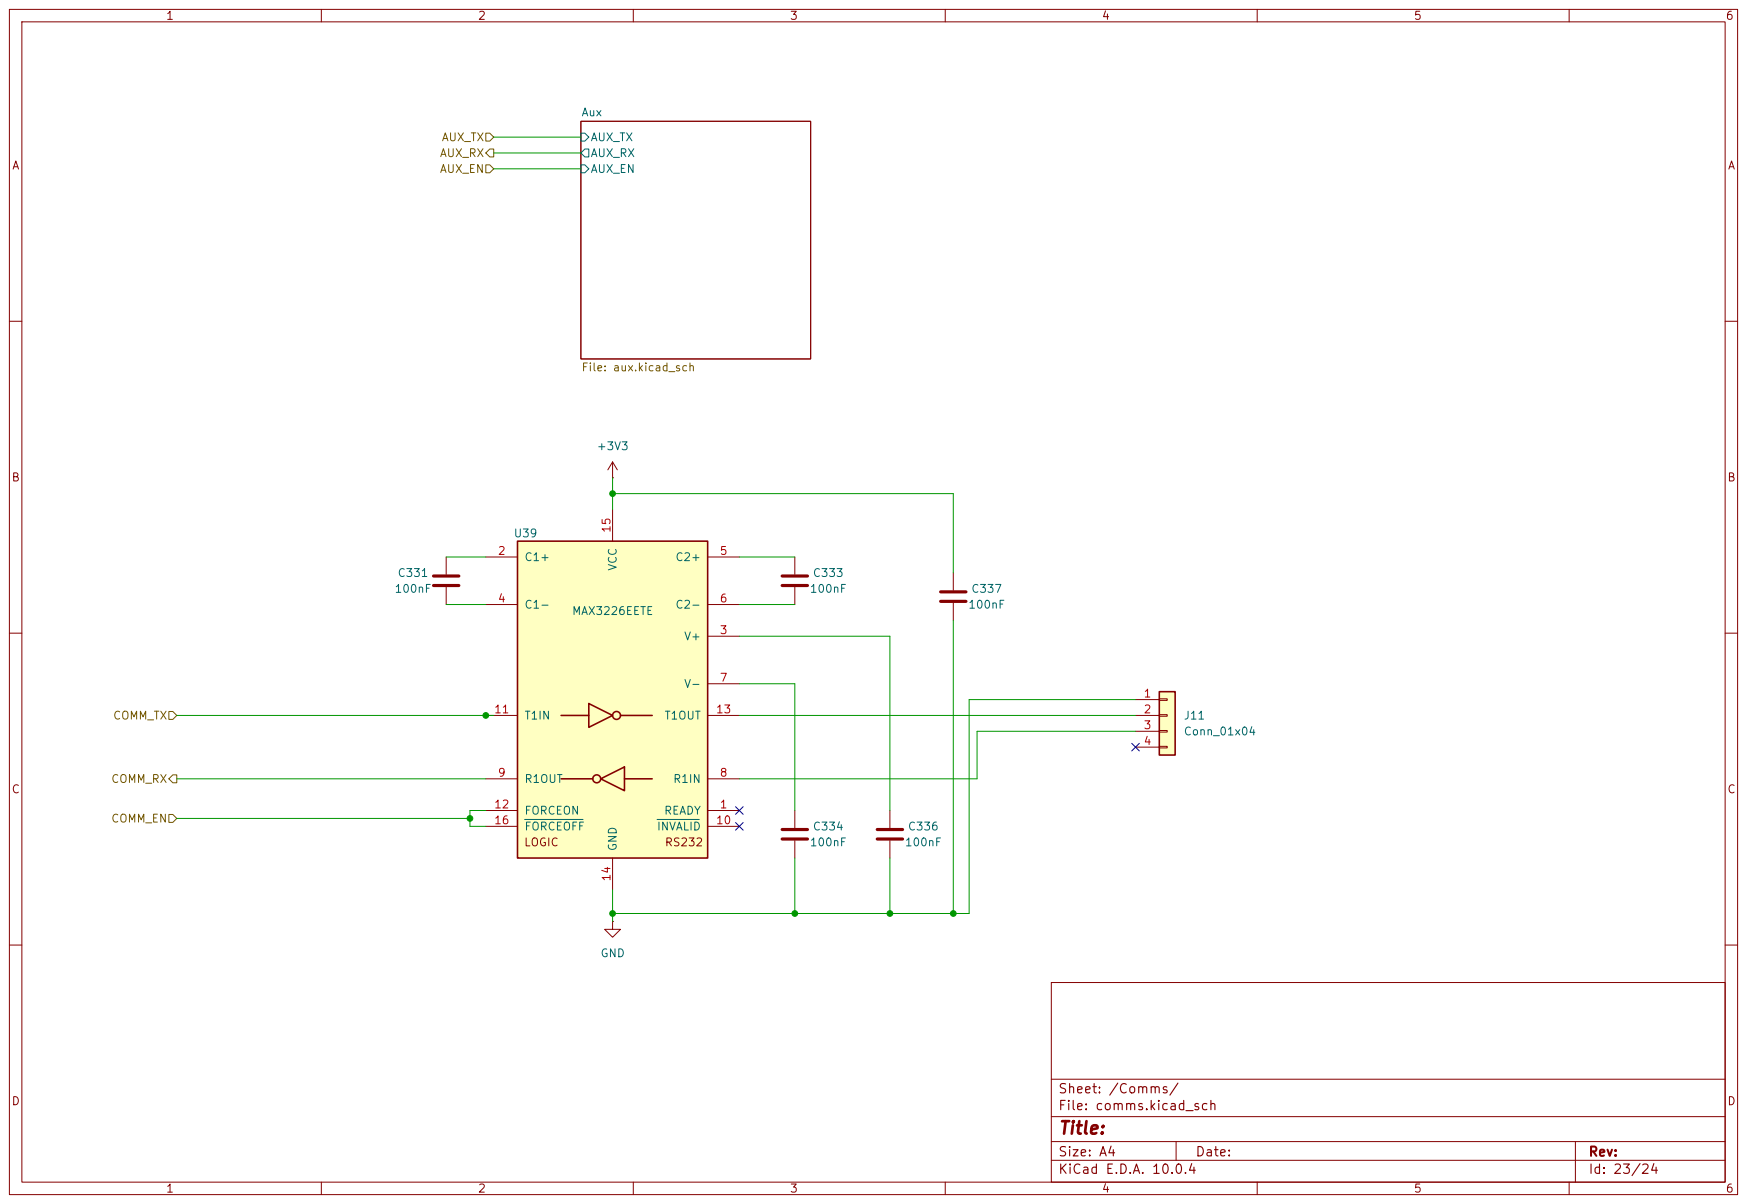
[picture p52: page 23]

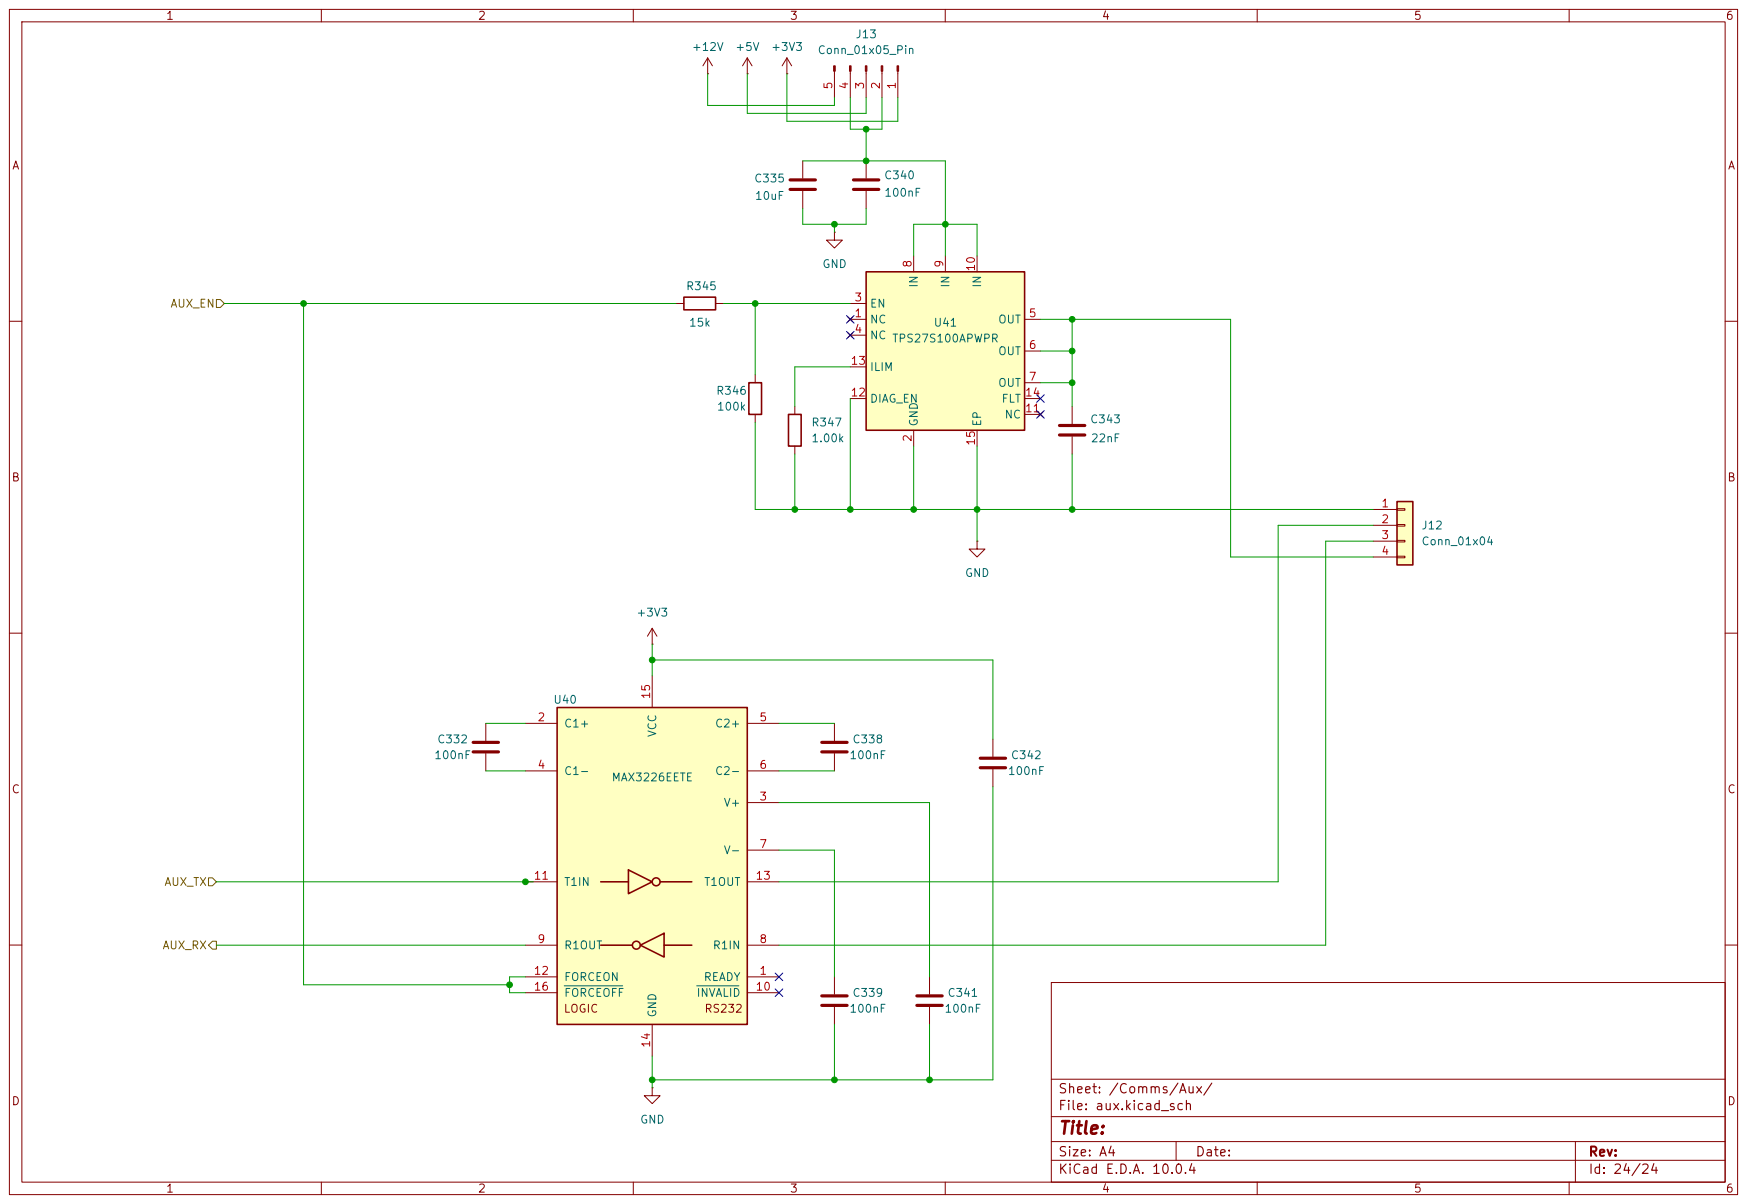
[picture p53: page 24]
