jkurina86/DIC_Board/DIC_Board/DIC_Board-STM32 MCU.pdf

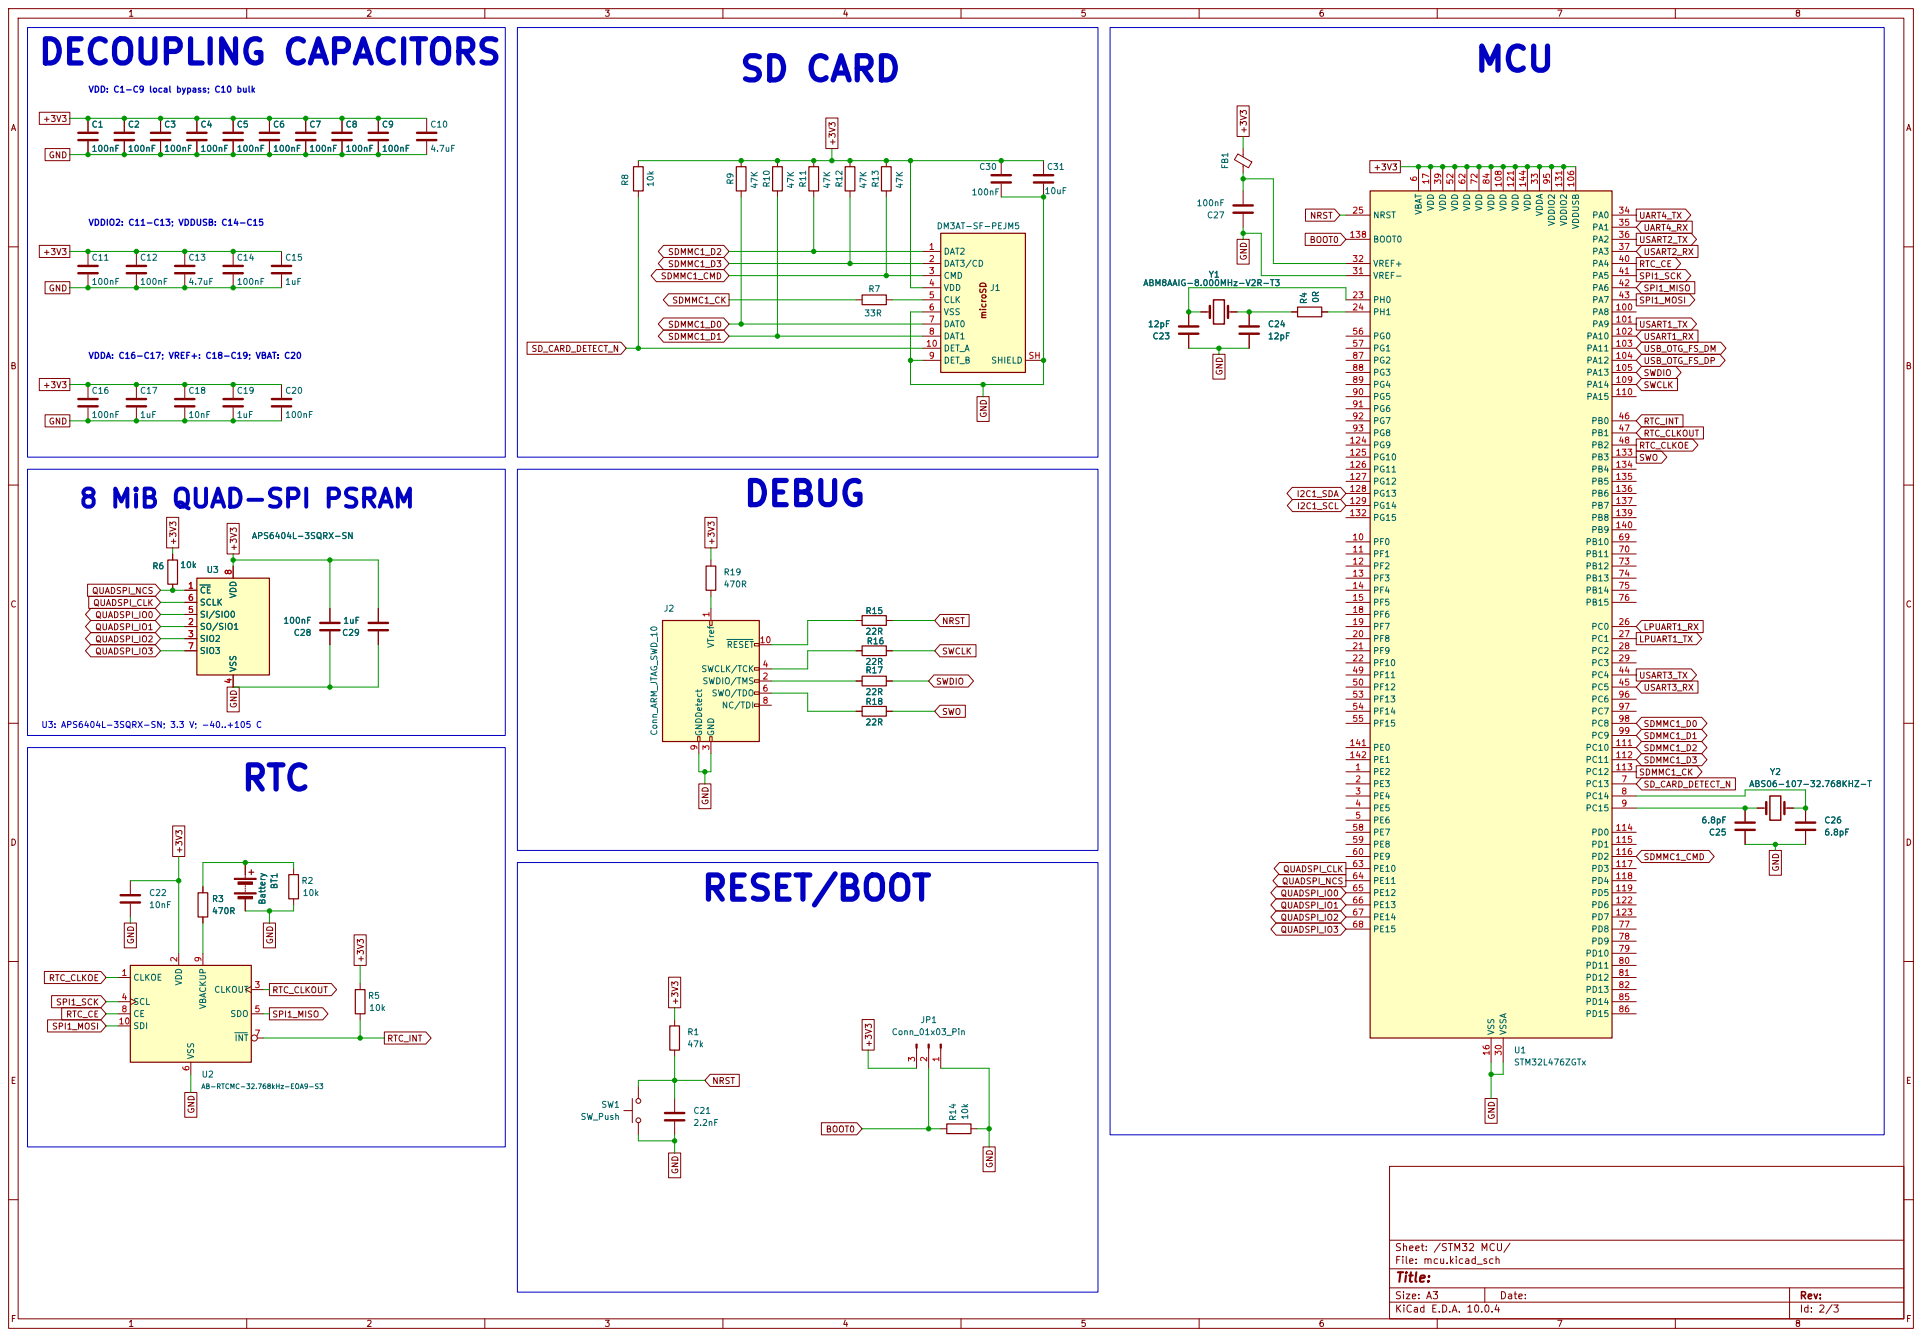
[picture p54: page 1]

8 MiB QUAD-SPI PSRAM

Size: A3 | Rev: | F Date:
KiCad E.D.A. 10.0.4 | Id: 2/3
