jkurina86/DIC_Board/Docs/Actuators/Takasago_RP-TX/Aquatech_RP-TX_outline_drawing.pdf

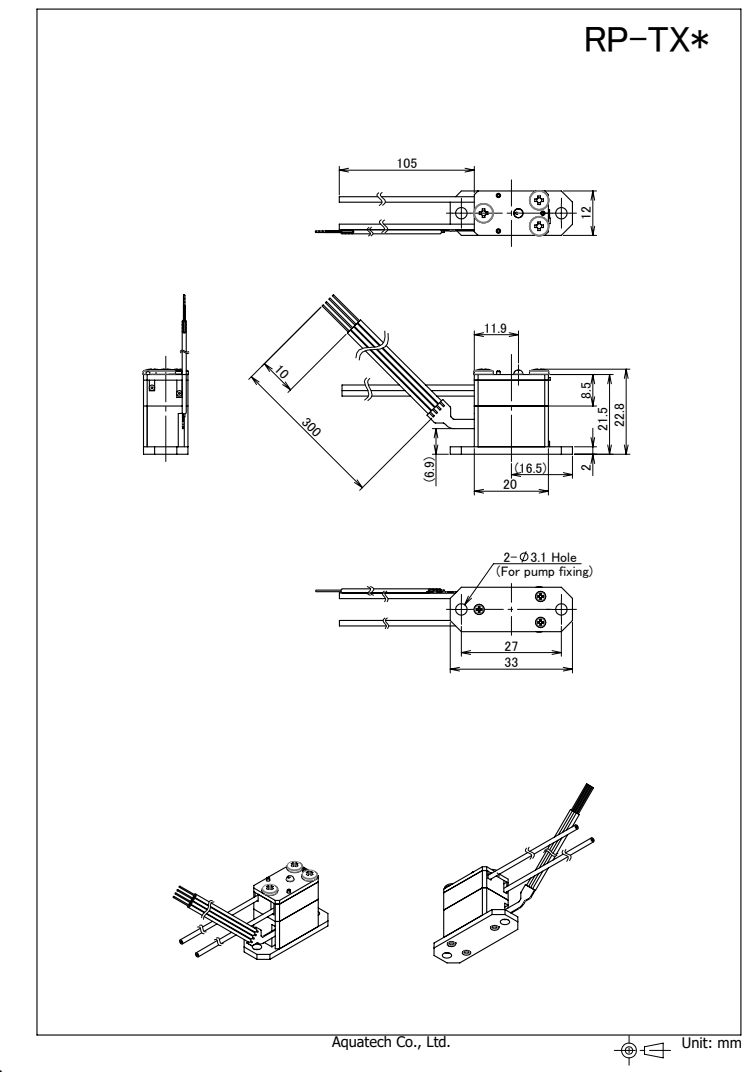
[picture p55: page 1]
Aquatech Co., Ltd.; Unit: mm

2- 3.1 Hole
(For pump fixing)
