jkurina86/DIC_Board/DIC_Board/DIC_Board.kicad_pcb

## KiCad design DIC_Board/DIC_Board.kicad_pcb (2026-09-18)

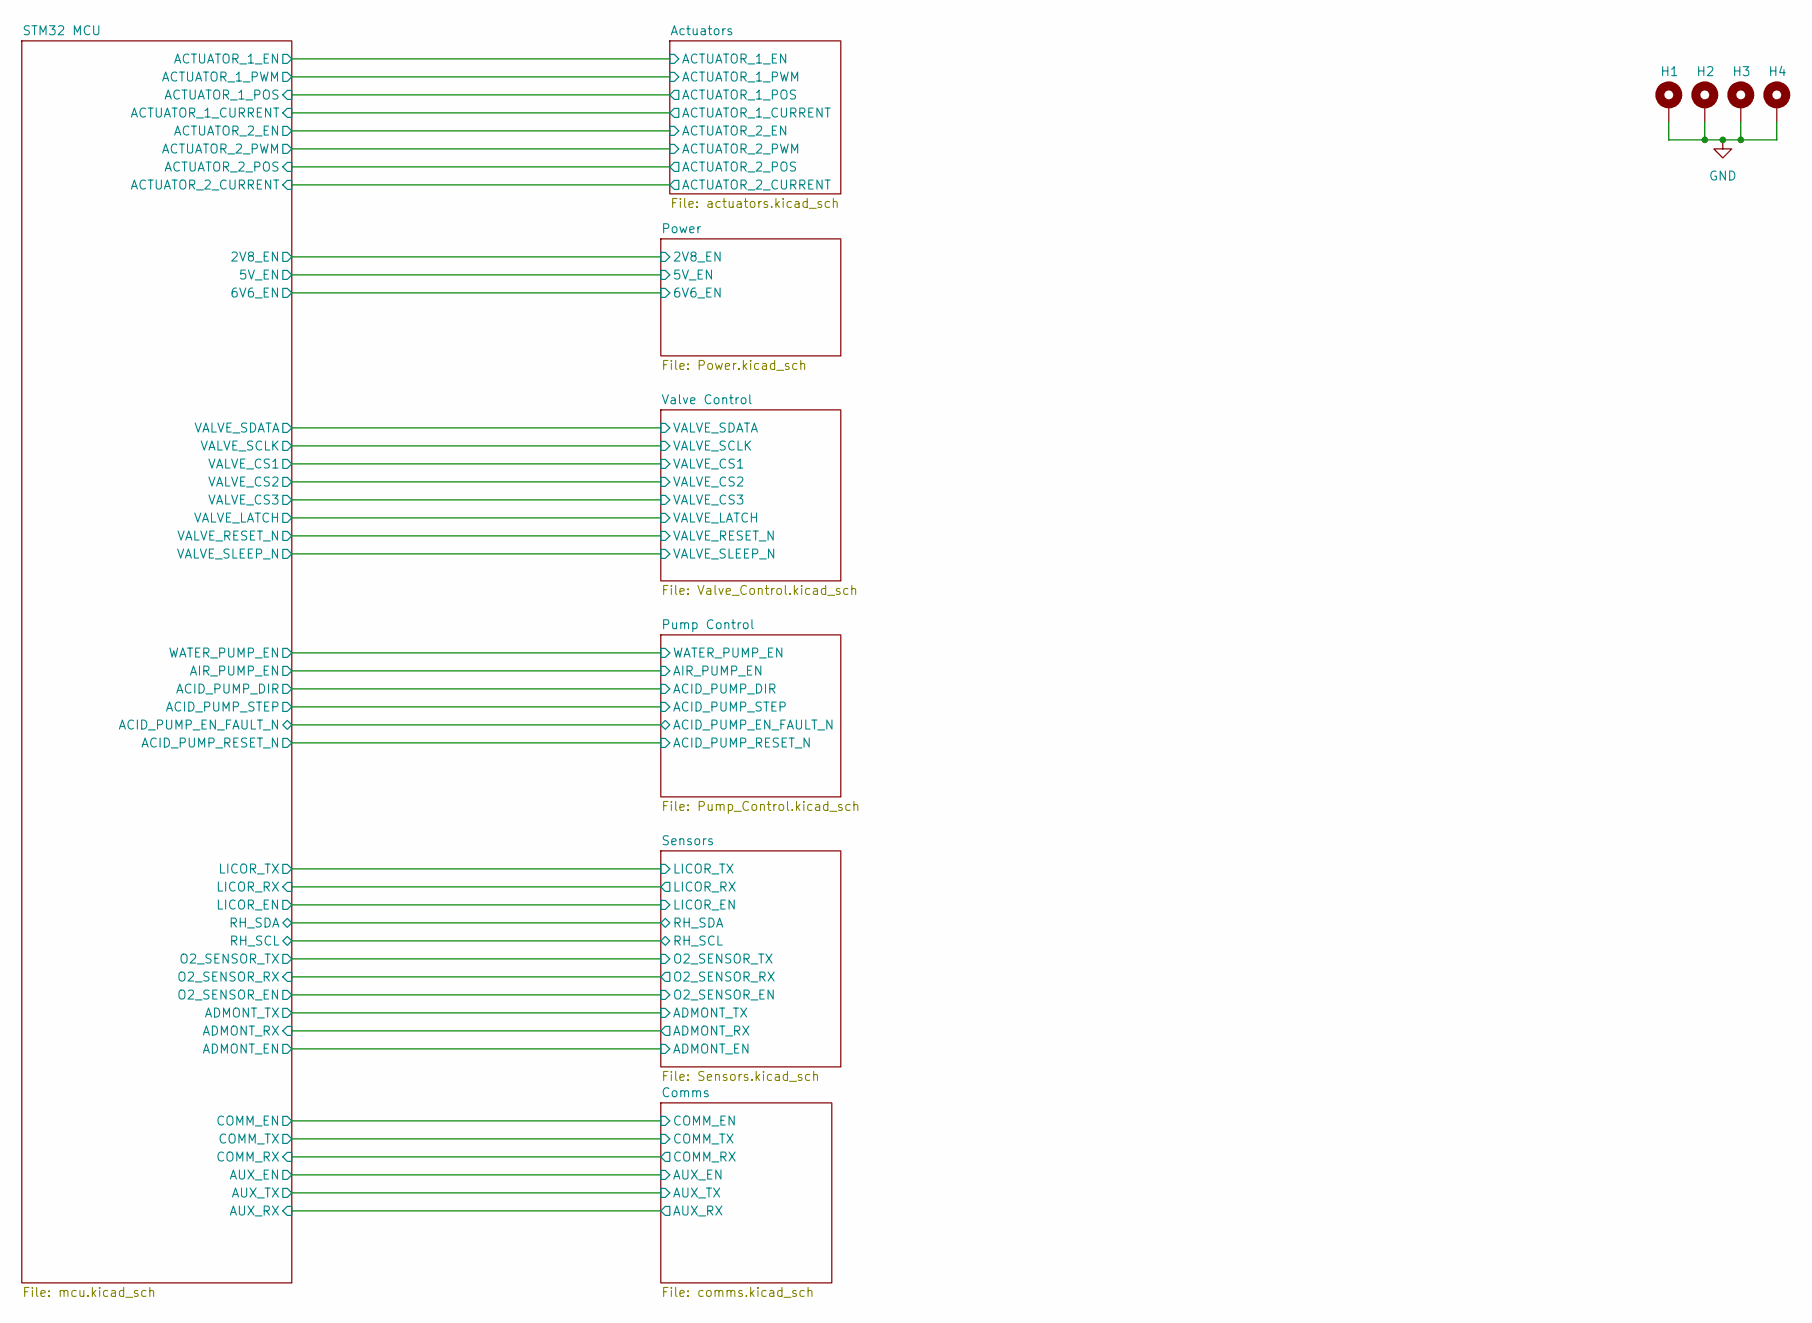
[picture p56: schematic DIC_Board.kicad_sch]

Parts:
H1, H2, H3, H4: MountingHole_2.5mm_Pad

Connections:
GND: H1.1 (1_1), H2.1 (1_1), H3.1 (1_1), H4.1 (1_1); also elsewhere on the board

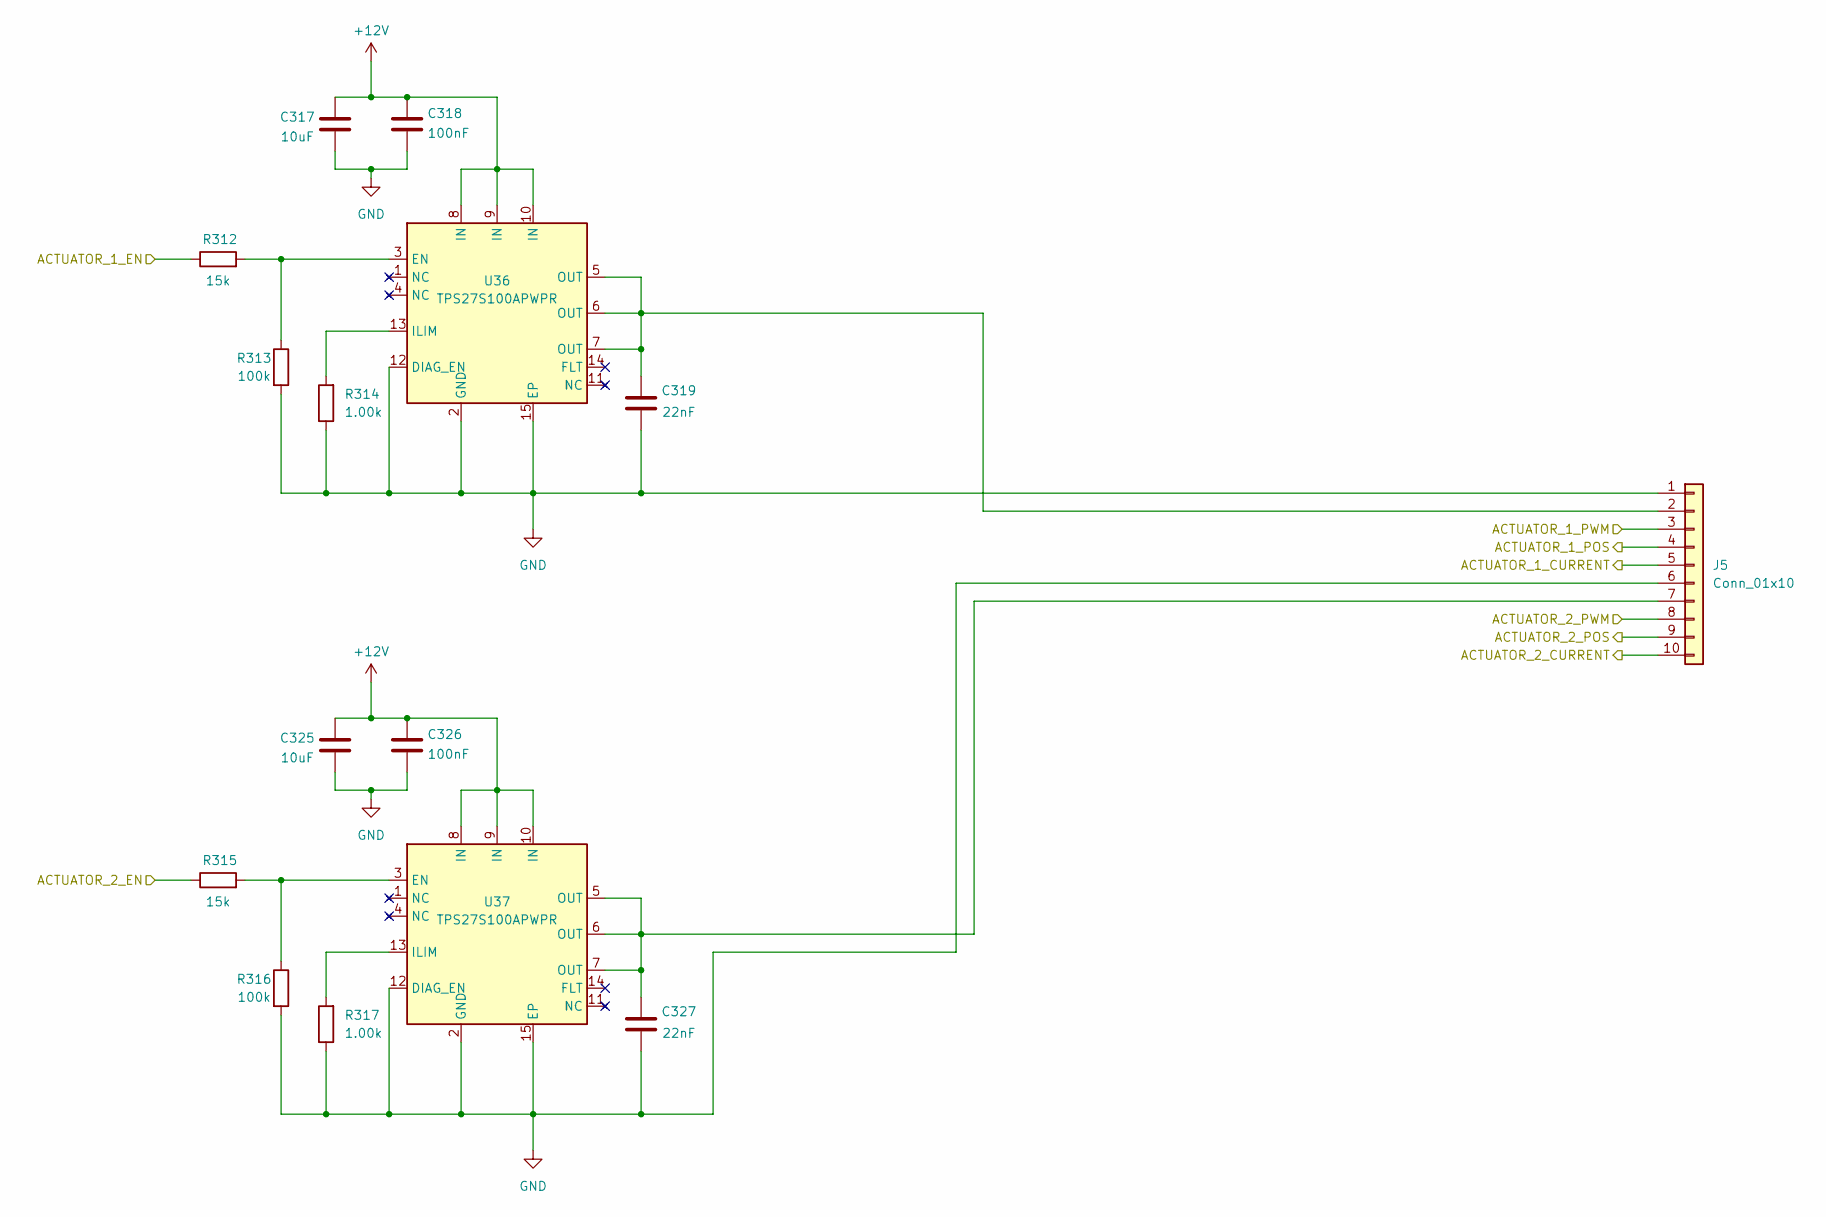
[picture p57: schematic actuators.kicad_sch]

Parts:
C317, C325: 10uF; C_1206_3216Metric; MPN CGA5L1X7R1H106K160AC
C318, C326: 100nF; C_0402_1005Metric; MPN GRM155R71H104ME14D
C319, C327: 22nF; C_0402_1005Metric; MPN GRM155R71H223KA12D
J5: Conn_01x10; Molex_Micro-Fit_3.0_43045-1000_2x05_P3.00mm_Horizontal; MPN 0430451000
R312, R315: 15k; R_0402_1005Metric; MPN CRCW040215K0FKED
R313, R316: 100k; R_0402_1005Metric; MPN CRCW0402100KFKED
R314, R317: 1.00k; R_0402_1005Metric; MPN CRCW04021K00FKED
U36, U37: TPS27S100APWPR; Texas_HTSSOP-14-1EP_4.4x5mm_P0.65mm_EP3.4x5mm_Mask3.155x3.2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; MPN TPS27S100APWPR; DigiKey 296-49002-1-ND

Connections:
+12V: C317.1, C318.1, C325.1, C326.1, U36.8 (IN), U36.9 (IN), U36.10 (IN), U37.8 (IN), U37.9 (IN), U37.10 (IN); also elsewhere on the board
/Actuators/ACTUATOR_1_CURRENT: J5.5; also elsewhere on the board
/Actuators/ACTUATOR_1_EN: R312.1; also elsewhere on the board
/Actuators/ACTUATOR_1_POS: J5.4; also elsewhere on the board
/Actuators/ACTUATOR_1_PWM: J5.3; also elsewhere on the board
/Actuators/ACTUATOR_2_CURRENT: J5.10; also elsewhere on the board
/Actuators/ACTUATOR_2_EN: R315.1; also elsewhere on the board
/Actuators/ACTUATOR_2_POS: J5.9; also elsewhere on the board
/Actuators/ACTUATOR_2_PWM: J5.8; also elsewhere on the board
GND: C317.2, C318.2, C319.2, C325.2, C326.2, C327.2, J5.1, J5.6, R313.2, R314.1, R316.2, R317.1, U36.2 (GND), U36.12 (DIAG_EN), U36.15 (EP), U37.2 (GND), U37.12 (DIAG_EN), U37.15 (EP); also elsewhere on the board
unnamed: C319.1, J5.2, U36.5 (OUT), U36.6 (OUT), U36.7 (OUT)
unnamed: C327.1, J5.7, U37.5 (OUT), U37.6 (OUT), U37.7 (OUT)
unnamed: R312.2, R313.1, U36.3 (EN)
unnamed: R314.2, U36.13 (ILIM)
unnamed: R315.2, R316.1, U37.3 (EN)
unnamed: R317.2, U37.13 (ILIM)

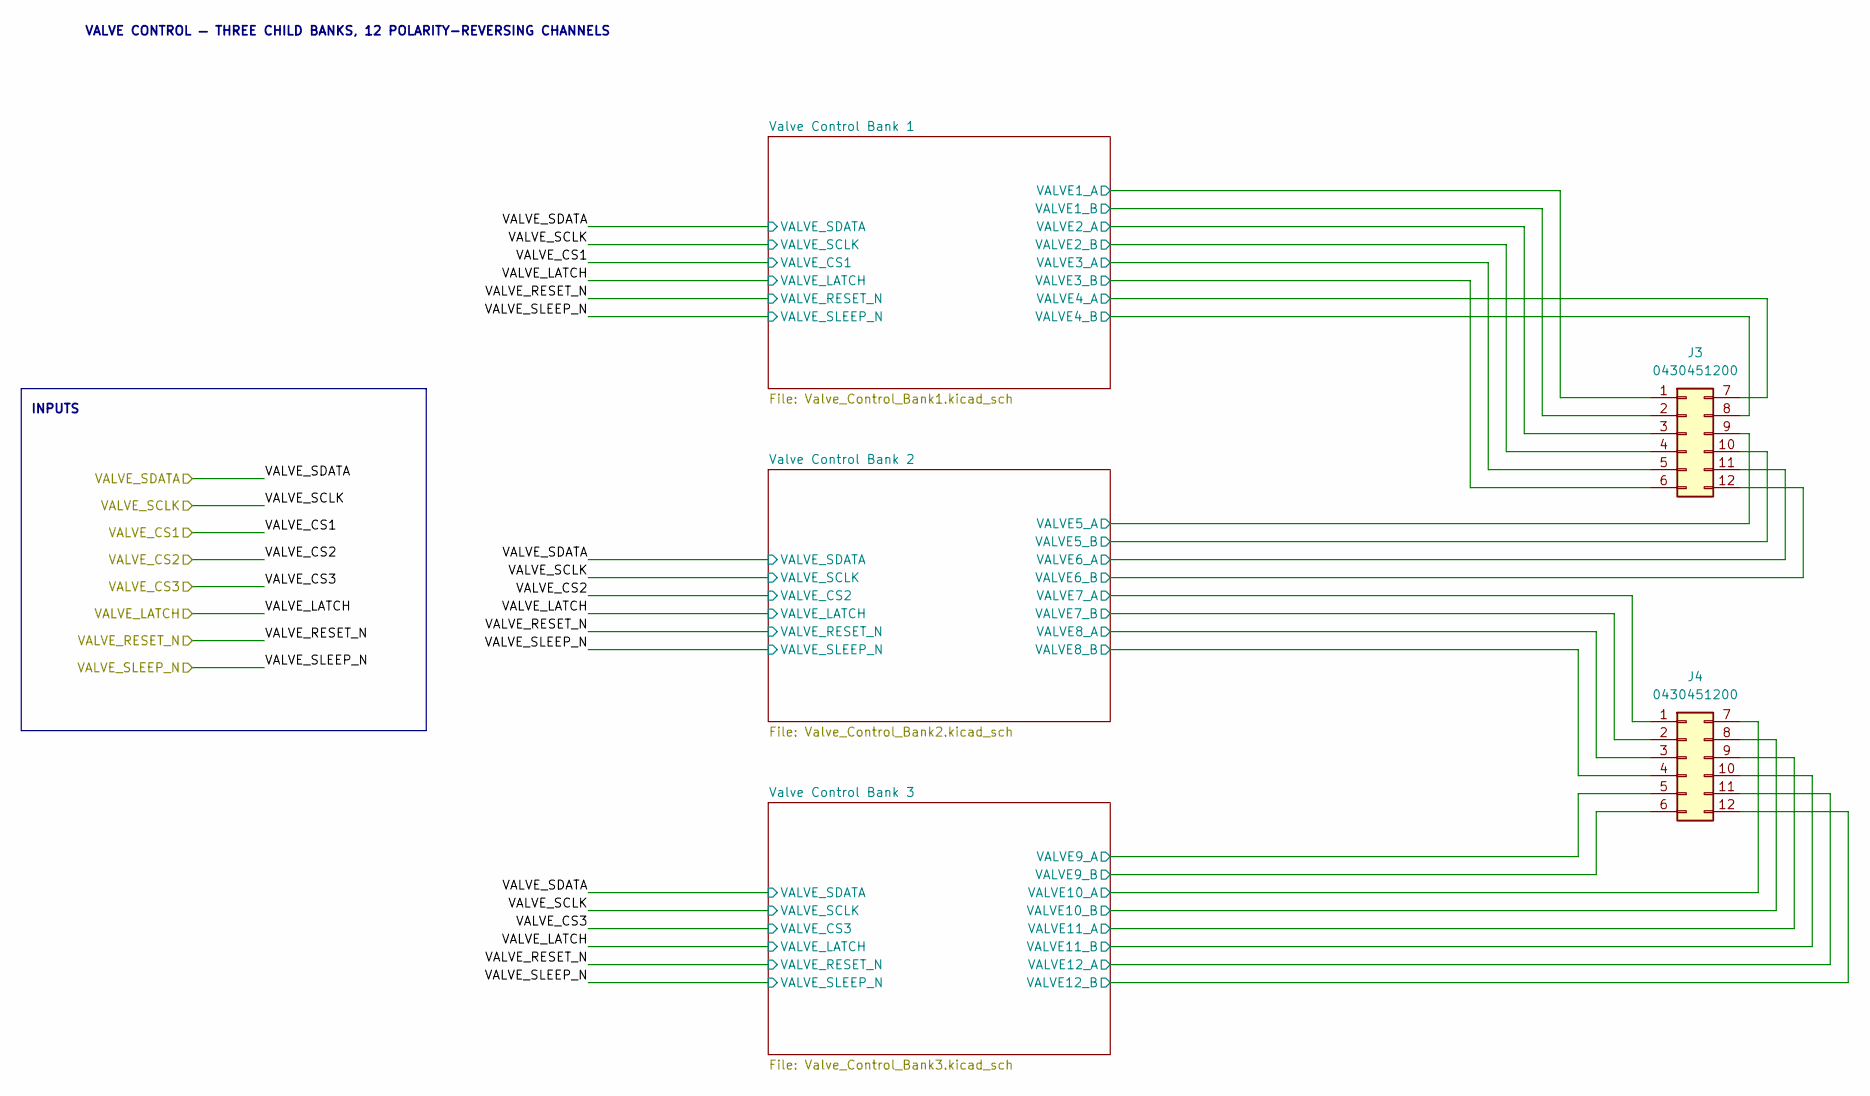
[picture p58: schematic Valve_Control.kicad_sch, Valve Control]

Parts:
J3, J4: 0430451200; Molex_Micro-Fit_3.0_43045-1200_2x06_P3.00mm_Horizontal; MPN 0430451200; DigiKey WM1818-ND

Connections:
/Valve Control/Valve Control Bank 1/VALVE1_A: J3.1; also elsewhere on the board
/Valve Control/Valve Control Bank 1/VALVE1_B: J3.2; also elsewhere on the board
/Valve Control/Valve Control Bank 1/VALVE2_A: J3.3; also elsewhere on the board
/Valve Control/Valve Control Bank 1/VALVE2_B: J3.4; also elsewhere on the board
/Valve Control/Valve Control Bank 1/VALVE3_A: J3.5; also elsewhere on the board
/Valve Control/Valve Control Bank 1/VALVE3_B: J3.6; also elsewhere on the board
/Valve Control/Valve Control Bank 1/VALVE4_A: J3.7; also elsewhere on the board
/Valve Control/Valve Control Bank 1/VALVE4_B: J3.8; also elsewhere on the board
/Valve Control/Valve Control Bank 2/VALVE5_A: J3.9; also elsewhere on the board
/Valve Control/Valve Control Bank 2/VALVE5_B: J3.10; also elsewhere on the board
/Valve Control/Valve Control Bank 2/VALVE6_A: J3.11; also elsewhere on the board
/Valve Control/Valve Control Bank 2/VALVE6_B: J3.12; also elsewhere on the board
/Valve Control/Valve Control Bank 2/VALVE7_A: J4.1; also elsewhere on the board
/Valve Control/Valve Control Bank 2/VALVE7_B: J4.2; also elsewhere on the board
/Valve Control/Valve Control Bank 2/VALVE8_A: J4.3; also elsewhere on the board
/Valve Control/Valve Control Bank 2/VALVE8_B: J4.4; also elsewhere on the board
/Valve Control/Valve Control Bank 3/VALVE9_A: J4.5; also elsewhere on the board
/Valve Control/Valve Control Bank 3/VALVE9_B: J4.6; also elsewhere on the board
/Valve Control/Valve Control Bank 3/VALVE10_A: J4.7; also elsewhere on the board
/Valve Control/Valve Control Bank 3/VALVE10_B: J4.8; also elsewhere on the board
/Valve Control/Valve Control Bank 3/VALVE11_A: J4.9; also elsewhere on the board
/Valve Control/Valve Control Bank 3/VALVE11_B: J4.10; also elsewhere on the board
/Valve Control/Valve Control Bank 3/VALVE12_A: J4.11; also elsewhere on the board
/Valve Control/Valve Control Bank 3/VALVE12_B: J4.12; also elsewhere on the board

Notes on the sheet:
INPUTS
VALVE CONTROL — THREE CHILD BANKS, 12 POLARITY-REVERSING CHANNELS

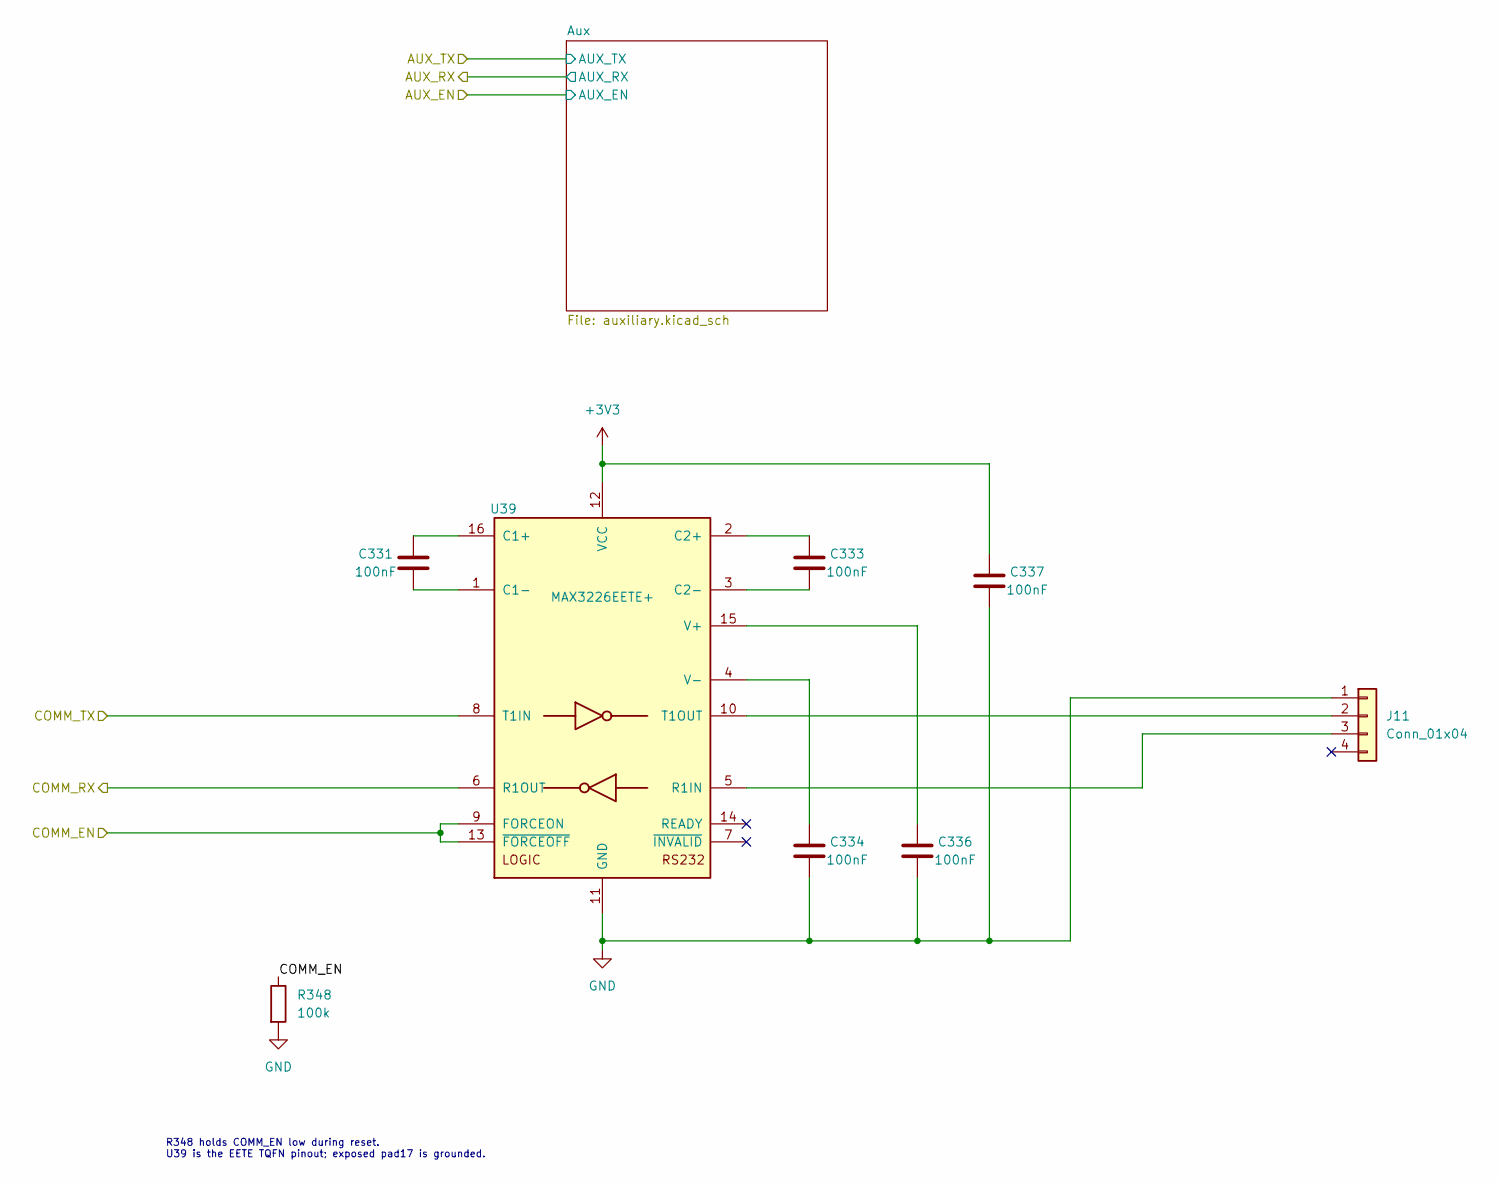
[picture p59: schematic comms.kicad_sch]

Parts:
C331, C333, C334, C336, C337: 100nF; C_0402_1005Metric; MPN GRM155R71H104ME14D
J11: Conn_01x04; Molex_Micro-Fit_3.0_43045-0400_2x02_P3.00mm_Horizontal; MPN 0430450400
R348: 100k; R_0603_1608Metric; Tolerance 1%; Power Rating 0.125W; MPN CRCW0603100KFKEA
U39: MAX3226EETE+; TQFN-16-1EP_5x5mm_P0.8mm_EP3.1x3.1mm; MPN MAX3226EETE+

Connections:
+3V3: C337.1, U39.12 (VCC); also elsewhere on the board
/Comms/COMM_EN: R348.1, U39.9 (FORCEON), U39.13 (~FORCEOFF); also elsewhere on the board
/Comms/COMM_RX: U39.6 (R1OUT); also elsewhere on the board
/Comms/COMM_TX: U39.8 (T1IN); also elsewhere on the board
GND: C334.2, C336.2, C337.2, J11.1, R348.2, U39.11 (GND), U39.17 (EP); also elsewhere on the board
unnamed: J11.2, U39.10 (T1OUT)
unnamed: J11.3, U39.5 (R1IN)
unnamed: C331.1, U39.16 (C1+)
unnamed: C331.2, U39.1 (C1-)
unnamed: C333.1, U39.2 (C2+)
unnamed: C333.2, U39.3 (C2-)
unnamed: C336.1, U39.15 (V+)
unnamed: C334.1, U39.4 (V-)

Notes on the sheet:
R348 holds COMM_EN low during reset. U39 is the EETE TQFN pinout; exposed pad17 is grounded.

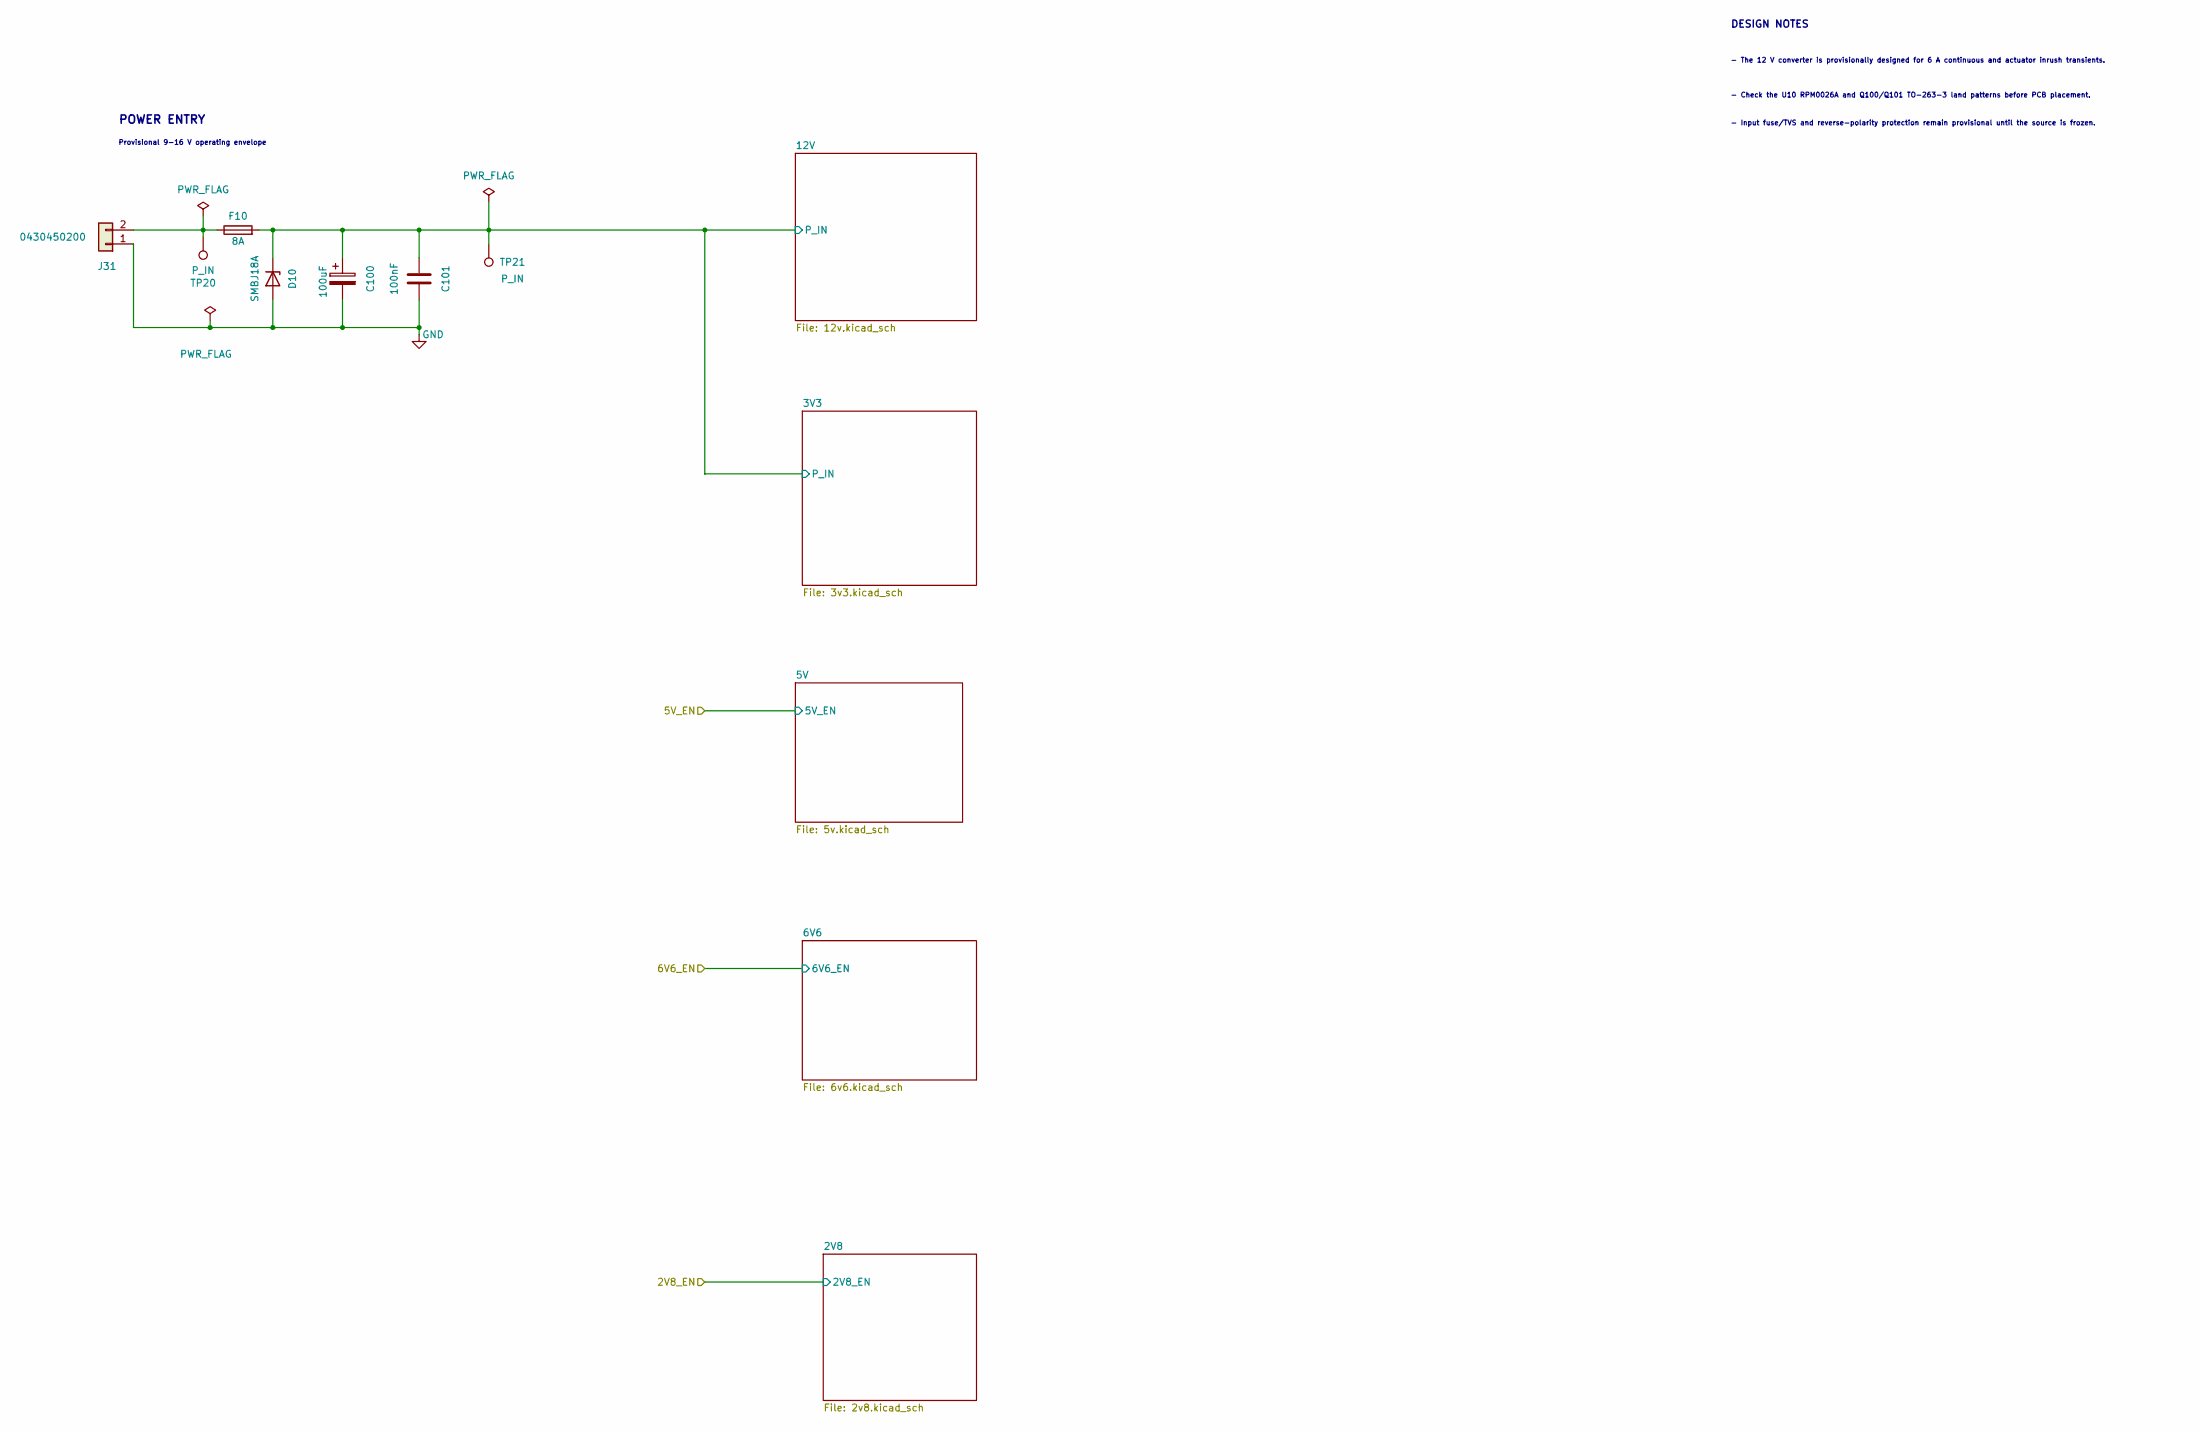
[picture p60: schematic Power.kicad_sch]

Parts:
C100: 100uF; CP_Elec_8x10.5; MPN EEHZA1V101P
C101: 100nF; C_0402_1005Metric; MPN GRM155R71H104ME14D
D10: SMBJ18A; D_SMB; MPN SMBJ18A
F10: 8A; Fuse_Littelfuse-NANO2-451_453; Current Rating 8A; Voltage Rating 125VAC / 125VDC; MPN 0451008.MRL
J31: 0430450200; Molex_Micro-Fit_3.0_43045-0200_2x01_P3.00mm_Horizontal; MPN 0430450200; DigiKey WM1813-ND
TP20, TP21: P_IN; TestPoint_Pad_D1.0mm

Connections:
/Power/12V/P_IN: C100.1, C101.1, D10.1 (K), F10.2, TP21.1 (1_1); also elsewhere on the board
GND: C100.2, C101.2, D10.2 (A), J31.1; also elsewhere on the board
unnamed: F10.1, J31.2, TP20.1 (1_1)

Notes on the sheet:
- Check the U10 RPM0026A and Q100/Q101 TO-263-3 land patterns before PCB placement.
- Input fuse/TVS and reverse-polarity protection remain provisional until the source is frozen.
- The 12 V converter is provisionally designed for 6 A continuous and actuator inrush transients.
DESIGN NOTES
Provisional 9-16 V operating envelope
POWER ENTRY
