jkurina86/DIC_Board/DIC_Board/DIC_Board.kicad_pcb

## KiCad design DIC_Board/DIC_Board.kicad_pcb (continued)

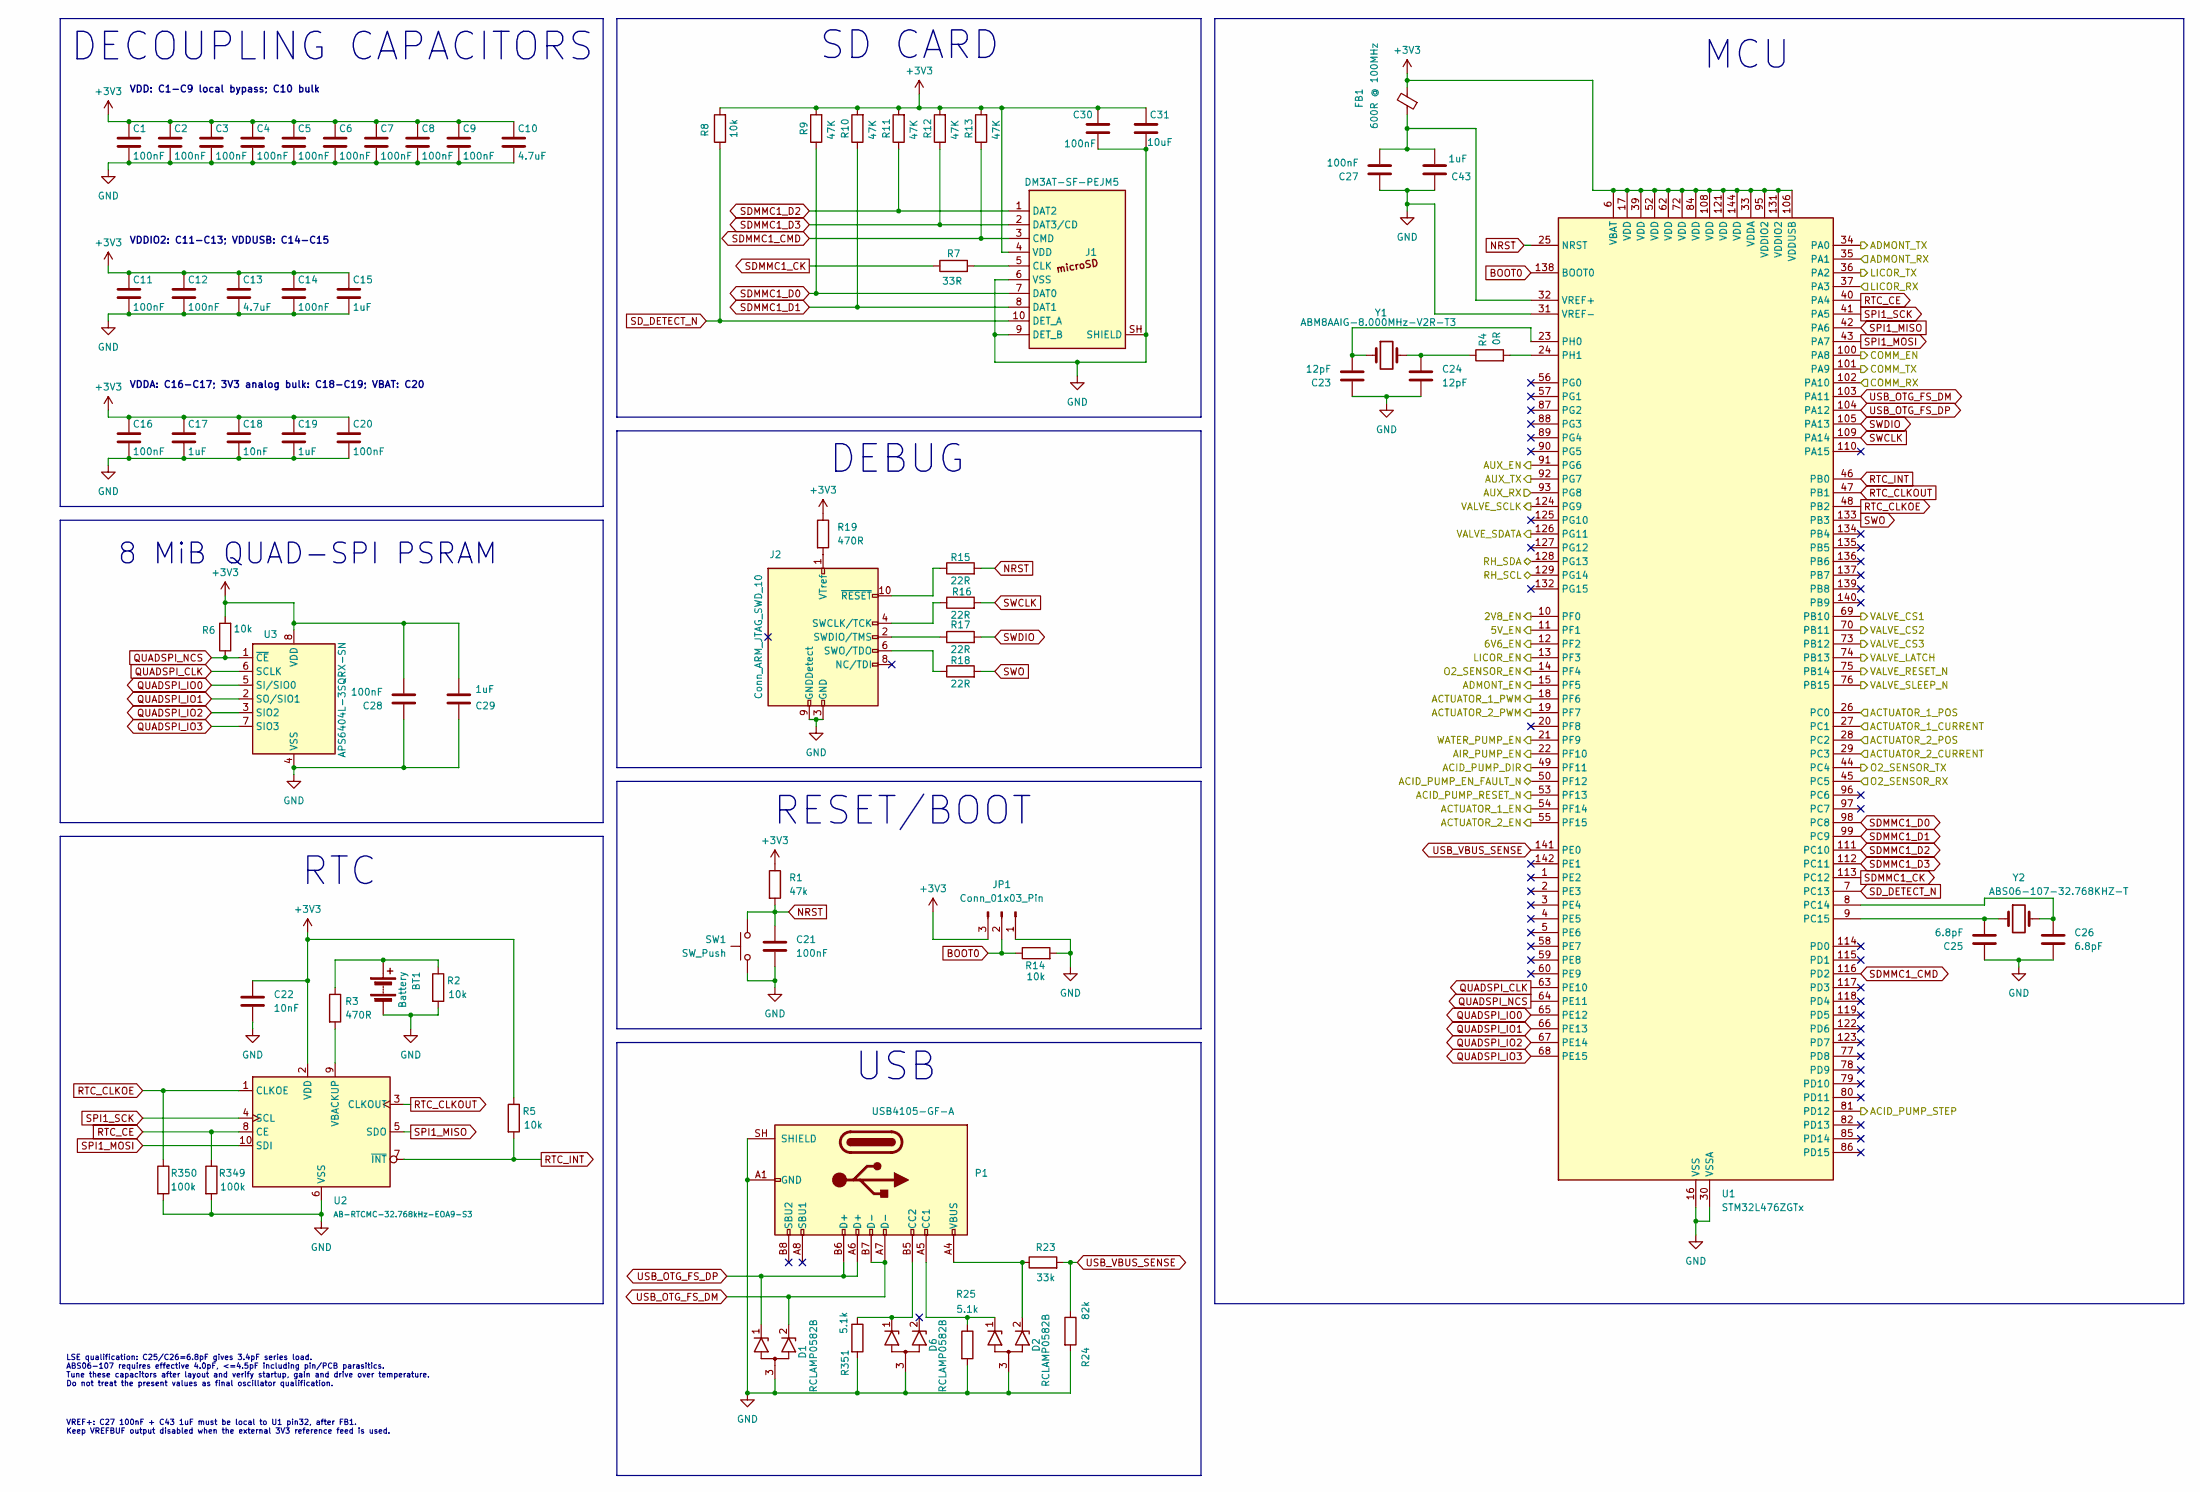
[picture p61: schematic mcu.kicad_sch]

Parts:
BT1: Battery; BatteryHolder_Keystone_3013_1x16mm; MPN 3013; DigiKey 36-3013-ND
C1, C2, C3, C4, C5, C6, C7, C8, C9, C11, C12, C14, C16, C20, C21, C27, C28, C30: 100nF; C_0603_1608Metric; Voltage Rating 50V; Tolerance 10%; MPN C1608X7R1H104K080AA
C10, C13: 4.7uF; C_0805_2012Metric; Voltage Rating 25V; Tolerance 10%; MPN C2012X7R1E475K125AB
C15, C17, C19, C29, C43: 1uF; C_0603_1608Metric; Voltage Rating 25V; Tolerance 10%; MPN C1608X7R1E105K080AB
C18, C22: 10nF; C_0603_1608Metric; Voltage Rating 50V; Tolerance 10%; MPN C1608X7R1H103K080AA
C23, C24: 12pF; C_0603_1608Metric; Voltage Rating 50V; Tolerance 5%; MPN C1608C0G1H120J080AA
C25, C26: 6.8pF; C_0402_1005Metric; Voltage Rating 50V; Tolerance 0.25pF; MPN GRM1555C1H6R8CA01D
C31: 10uF; C_0805_2012Metric; Voltage Rating 16V; Tolerance 10%; MPN C2012X7S1C106K125AC
D1, D2, D6: RCLAMP0582B; SOT-523; MPN RClamp0582B.TCT
FB1: 600R @ 100MHz; L_0603_1608Metric; Current Rating 500mA; MPN BLM18AG601SN1D
J1: DM3AT-SF-PEJM5; microSD_HC_Hirose_DM3AT-SF-PEJM5; MPN DM3AT-SF-PEJM5
J2: Conn_ARM_JTAG_SWD_10; Wurth_61201021621_2x05_P2.54mm_Vertical; MPN 61201021621; DigiKey 732-2094-ND
JP1: Conn_01x03_Pin; PinHeader_Wurth_61300311121_1x03_P2.54mm_Vertical; MPN 61300311121
P1: USB4105-GF-A; USB_C_Receptacle_GCT_USB4105-xx-A_16P_TopMnt_Horizontal; MPN USB4105-GF-A; DigiKey 2073-USB4105-GF-ACT-ND
R1: 47k; R_0603_1608Metric; Tolerance 1%; Power Rating 0.125W; MPN CRCW060347K0FKEA
R2, R5, R6, R8, R14: 10k; R_0603_1608Metric; Tolerance 1%; Power Rating 0.125W; MPN CRCW060310K0FKEA
R3, R19: 470R; R_0603_1608Metric; Tolerance 1%; Power Rating 0.125W; MPN CRCW0603470RFKEA
R4: 0R; R_0603_1608Metric; Tolerance Jumper; Power Rating 0.125W; MPN CRCW06030000Z0EA
R7: 33R; R_0603_1608Metric; Tolerance 1%; Power Rating 0.125W; MPN CRCW060333R0FKEA
R9, R10, R11, R12, R13: 47K; R_0603_1608Metric; Tolerance 1%; Power Rating 0.125W; MPN CRCW060347K0FKEA
R15, R16, R17, R18: 22R; R_0603_1608Metric; Tolerance 1%; Power Rating 0.125W; MPN CRCW060322R0FKEA
R23: 33k; R_0402_1005Metric; Tolerance 1%; Power Rating 0.1W; MPN CRCW040233K0FKED
R24: 82k; R_0402_1005Metric; Tolerance 1%; Power Rating 0.1W; MPN CRCW040282K0FKED
R25, R351: 5.1k; R_0402_1005Metric; Tolerance 1%; Power Rating 0.1W; MPN CRCW04025K10FKED
R349, R350: 100k; R_0603_1608Metric; Tolerance 1%; Power Rating 0.125W; MPN CRCW0603100KFKEA
SW1: SW_Push; SW_ESwitch_TL6330AF200Q; MPN TL6330AF200Q
U1: STM32L476ZGTx; LQFP-144_20x20mm_P0.5mm; MPN STM32L476ZGT6
U2: AB-RTCMC-32.768kHz-EOA9-S3; RTC_SMD_MicroCrystal_C3_2.5x3.7mm; MPN AB-RTCMC-32.768kHz-EOA9-S3
U3: APS6404L-3SQRX-SN; SOIC-8_3.9x4.9mm_P1.27mm; MPN APS6404L-3SQRX-SN; Mouser 878-APS6404L-3SQRXSN
Y1: ABM8AAIG-8.000MHz-V2R-T3; ABM8AAIG-2Pin_3.2x2.5mm; MPN ABM8AAIG-8.000MHz-V2R-T3
Y2: ABS06-107-32.768KHZ-T; ABS06-107-2Pin_2.0x1.2mm; MPN ABS06-107-32.768KHZ-T

Connections:
+3V3: C1.1, C2.1, C3.1, C4.1, C5.1, C6.1, C7.1, C8.1, C9.1, C10.1, C11.1, C12.1, C13.1, C14.1, C15.1, C16.1, C17.1, C18.1, C19.1, C20.1, C22.2, C28.1, C29.1, C30.1, C31.1, FB1.2, J1.4 (VDD), JP1.3, R1.1, R5.1, R6.2, R8.2, R9.2, R10.2, R11.2, R12.2, R13.2, R19.1, U1.6 (VBAT), U1.17 (VDD), U1.33 (VDDA), U1.39 (VDD), U1.52 (VDD), U1.62 (VDD), U1.72 (VDD), U1.84 (VDD), U1.95 (VDDIO2), U1.106 (VDDUSB), U1.108 (VDD), U1.121 (VDD), U1.131 (VDDIO2), U1.144 (VDD), U2.2 (VDD), U3.8 (VDD); also elsewhere on the board
/Actuators/ACTUATOR_1_CURRENT: U1.27 (PC1); also elsewhere on the board
/Actuators/ACTUATOR_1_EN: U1.54 (PF14); also elsewhere on the board
/Actuators/ACTUATOR_1_POS: U1.26 (PC0); also elsewhere on the board
/Actuators/ACTUATOR_1_PWM: U1.18 (PF6); also elsewhere on the board
/Actuators/ACTUATOR_2_CURRENT: U1.29 (PC3); also elsewhere on the board
/Actuators/ACTUATOR_2_EN: U1.55 (PF15); also elsewhere on the board
/Actuators/ACTUATOR_2_POS: U1.28 (PC2); also elsewhere on the board
/Actuators/ACTUATOR_2_PWM: U1.19 (PF7); also elsewhere on the board
/Comms/AUX_EN: U1.91 (PG6); also elsewhere on the board
/Comms/AUX_RX: U1.93 (PG8); also elsewhere on the board
/Comms/AUX_TX: U1.92 (PG7); also elsewhere on the board
/Comms/COMM_EN: U1.100 (PA8); also elsewhere on the board
/Comms/COMM_RX: U1.102 (PA10); also elsewhere on the board
/Comms/COMM_TX: U1.101 (PA9); also elsewhere on the board
/Power/2V8_EN: U1.10 (PF0); also elsewhere on the board
/Power/5V_EN: U1.11 (PF1); also elsewhere on the board
/Power/6V6_EN: U1.12 (PF2); also elsewhere on the board
/Pump Control/ACID_PUMP_DIR: U1.49 (PF11); also elsewhere on the board
/Pump Control/ACID_PUMP_EN_FAULT_N: U1.50 (PF12); also elsewhere on the board
/Pump Control/ACID_PUMP_RESET_N: U1.53 (PF13); also elsewhere on the board
/Pump Control/ACID_PUMP_STEP: U1.81 (PD12); also elsewhere on the board
/Pump Control/AIR_PUMP_EN: U1.22 (PF10); also elsewhere on the board
/Pump Control/WATER_PUMP_EN: U1.21 (PF9); also elsewhere on the board
/STM32 MCU/ADMONT_EN: U1.15 (PF5); also elsewhere on the board
/STM32 MCU/ADMONT_RX: U1.35 (PA1); also elsewhere on the board
/STM32 MCU/ADMONT_TX: U1.34 (PA0); also elsewhere on the board
/STM32 MCU/LICOR_EN: U1.13 (PF3); also elsewhere on the board
/STM32 MCU/LICOR_RX: U1.37 (PA3); also elsewhere on the board
/STM32 MCU/LICOR_TX: U1.36 (PA2); also elsewhere on the board
/STM32 MCU/O2_SENSOR_EN: U1.14 (PF4); also elsewhere on the board
/STM32 MCU/O2_SENSOR_RX: U1.45 (PC5); also elsewhere on the board
/STM32 MCU/O2_SENSOR_TX: U1.44 (PC4); also elsewhere on the board
/STM32 MCU/RH_SCL: U1.129 (PG14); also elsewhere on the board
/STM32 MCU/RH_SDA: U1.128 (PG13); also elsewhere on the board
/Valve Control/VALVE_CS1: U1.69 (PB10); also elsewhere on the board
/Valve Control/VALVE_CS2: U1.70 (PB11); also elsewhere on the board
/Valve Control/VALVE_CS3: U1.73 (PB12); also elsewhere on the board
/Valve Control/VALVE_LATCH: U1.74 (PB13); also elsewhere on the board
/Valve Control/VALVE_RESET_N: U1.75 (PB14); also elsewhere on the board
/Valve Control/VALVE_SCLK: U1.124 (PG9); also elsewhere on the board
/Valve Control/VALVE_SDATA: U1.126 (PG11); also elsewhere on the board
/Valve Control/VALVE_SLEEP_N: U1.76 (PB15); also elsewhere on the board
BOOT0: JP1.2, R14.1, U1.138 (BOOT0)
GND: BT1.2 (-), C1.2, C2.2, C3.2, C4.2, C5.2, C6.2, C7.2, C8.2, C9.2, C10.2, C11.2, C12.2, C13.2, C14.2, C15.2, C16.2, C17.2, C18.2, C19.2, C20.2, C21.1, C22.1, C23.2, C24.1, C25.2, C26.1, C27.2, C28.2, C29.2, C30.2, C31.2, C43.2, D1.3 (A), D2.3 (A), D6.3 (A), J1.6 (VSS), J1.9 (DET_B), J1.SH (SHIELD), J2.3 (GND), J2.5 (GND), J2.9 (GNDDetect), JP1.1, P1.A1 (GND), P1.A12 (GND), P1.B1 (GND), P1.B12 (GND), P1.SH (SHIELD), R2.2, R14.2, R24.2, R25.2, R349.2, R350.2, R351.2, SW1.2, U1.16 (VSS), U1.30 (VSSA), U1.31 (VREF-), U1.38 (VSS), U1.51 (VSS), U1.61 (VSS), U1.71 (VSS), U1.83 (VSS), U1.94 (VSS), U1.107 (VSS), U1.120 (VSS), U1.130 (VSS), U1.143 (VSS), U2.6 (VSS), U3.4 (VSS); also elsewhere on the board
NRST: C21.2, R1.2, R15.2, SW1.1, U1.25 (NRST)
unnamed: BT1.1 (+), R2.1, R3.1
unnamed: C24.2, R4.1, Y1.2
unnamed: D2.1 (K1), P1.A5 (CC1), R25.1
unnamed: D2.2 (K2), P1.A4 (VBUS), P1.A9 (VBUS), P1.B4 (VBUS), P1.B9 (VBUS), R23.1
unnamed: D6.1 (K1), P1.B5 (CC2), R351.1
unnamed: J1.5 (CLK), R7.2
unnamed: J2.4 (SWCLK/TCK), R16.1
unnamed: J2.2 (SWDIO/TMS), R17.1
unnamed: J2.6 (SWO/TDO), R18.1
unnamed: J2.1 (VTref), R19.2
unnamed: J2.10 (~RESET), R15.1
unnamed: C26.2, U1.8 (PC14), Y2.2
unnamed: C25.1, U1.9 (PC15), Y2.1
unnamed: C23.1, U1.23 (PH0), Y1.1
unnamed: R4.2, U1.24 (PH1)
unnamed: C27.1, C43.1, FB1.1, U1.32 (VREF+)
unnamed: R3.2, U2.9 (VBACKUP)
QUADSPI_CLK: U1.63 (PE10), U3.6 (SCLK)
QUADSPI_IO0: U1.65 (PE12), U3.5 (SI/SIO0)
QUADSPI_IO1: U1.66 (PE13), U3.2 (SO/SIO1)
QUADSPI_IO2: U1.67 (PE14), U3.3 (SIO2)
QUADSPI_IO3: U1.68 (PE15), U3.7 (SIO3)
QUADSPI_NCS: R6.1, U1.64 (PE11), U3.1 (~CE)
RTC_CE: R349.1, U1.40 (PA4), U2.8 (CE)
RTC_CLKOE: R350.1, U1.48 (PB2), U2.1 (CLKOE)
RTC_CLKOUT: U1.47 (PB1), U2.3 (CLKOUT)
RTC_INT: R5.2, U1.46 (PB0), U2.7 (~INT)
SDMMC1_CK: R7.1, U1.113 (PC12)
SDMMC1_CMD: J1.3 (CMD), R13.1, U1.116 (PD2)
SDMMC1_D0: J1.7 (DAT0), R9.1, U1.98 (PC8)
SDMMC1_D1: J1.8 (DAT1), R10.1, U1.99 (PC9)
SDMMC1_D2: J1.1 (DAT2), R11.1, U1.111 (PC10)
SDMMC1_D3: J1.2 (DAT3/CD), R12.1, U1.112 (PC11)
SD_DETECT_N: J1.10 (DET_A), R8.1, U1.7 (PC13)
SPI1_MISO: U1.42 (PA6), U2.5 (SDO)
SPI1_MOSI: U1.43 (PA7), U2.10 (SDI)
SPI1_SCK: U1.41 (PA5), U2.4 (SCL)
SWCLK: R16.2, U1.109 (PA14)
SWDIO: R17.2, U1.105 (PA13)
SWO: R18.2, U1.133 (PB3)
USB_OTG_FS_DM: D1.2 (K2), P1.A7 (D-), P1.B7 (D-), U1.103 (PA11)
USB_OTG_FS_DP: D1.1 (K1), P1.A6 (D+), P1.B6 (D+), U1.104 (PA12)
USB_VBUS_SENSE: R23.2, R24.1, U1.141 (PE0)

Notes on the sheet:
DECOUPLING CAPACITORS
RTC
USB
DEBUG
8 MiB QUAD-SPI PSRAM
VREF+: C27 100nF + C43 1uF must be local to U1 pin32, after FB1. Keep VREFBUF output disabled when the external 3V3 reference feed is used.
MCU
VDD: C1-C9 local bypass; C10 bulk
VDDIO2: C11-C13; VDDUSB: C14-C15
VDDA: C16-C17; 3V3 analog bulk: C18-C19; VBAT: C20
RESET/BOOT
SD CARD
LSE qualification: C25/C26=6.8pF gives 3.4pF series load. ABS06-107 requires effective 4.0pF, <=4.5pF including pin/PCB parasitics. Tune these capacitors after layout and verify startup, gain and drive over temperature. Do not treat the present values as final oscillator qualification.

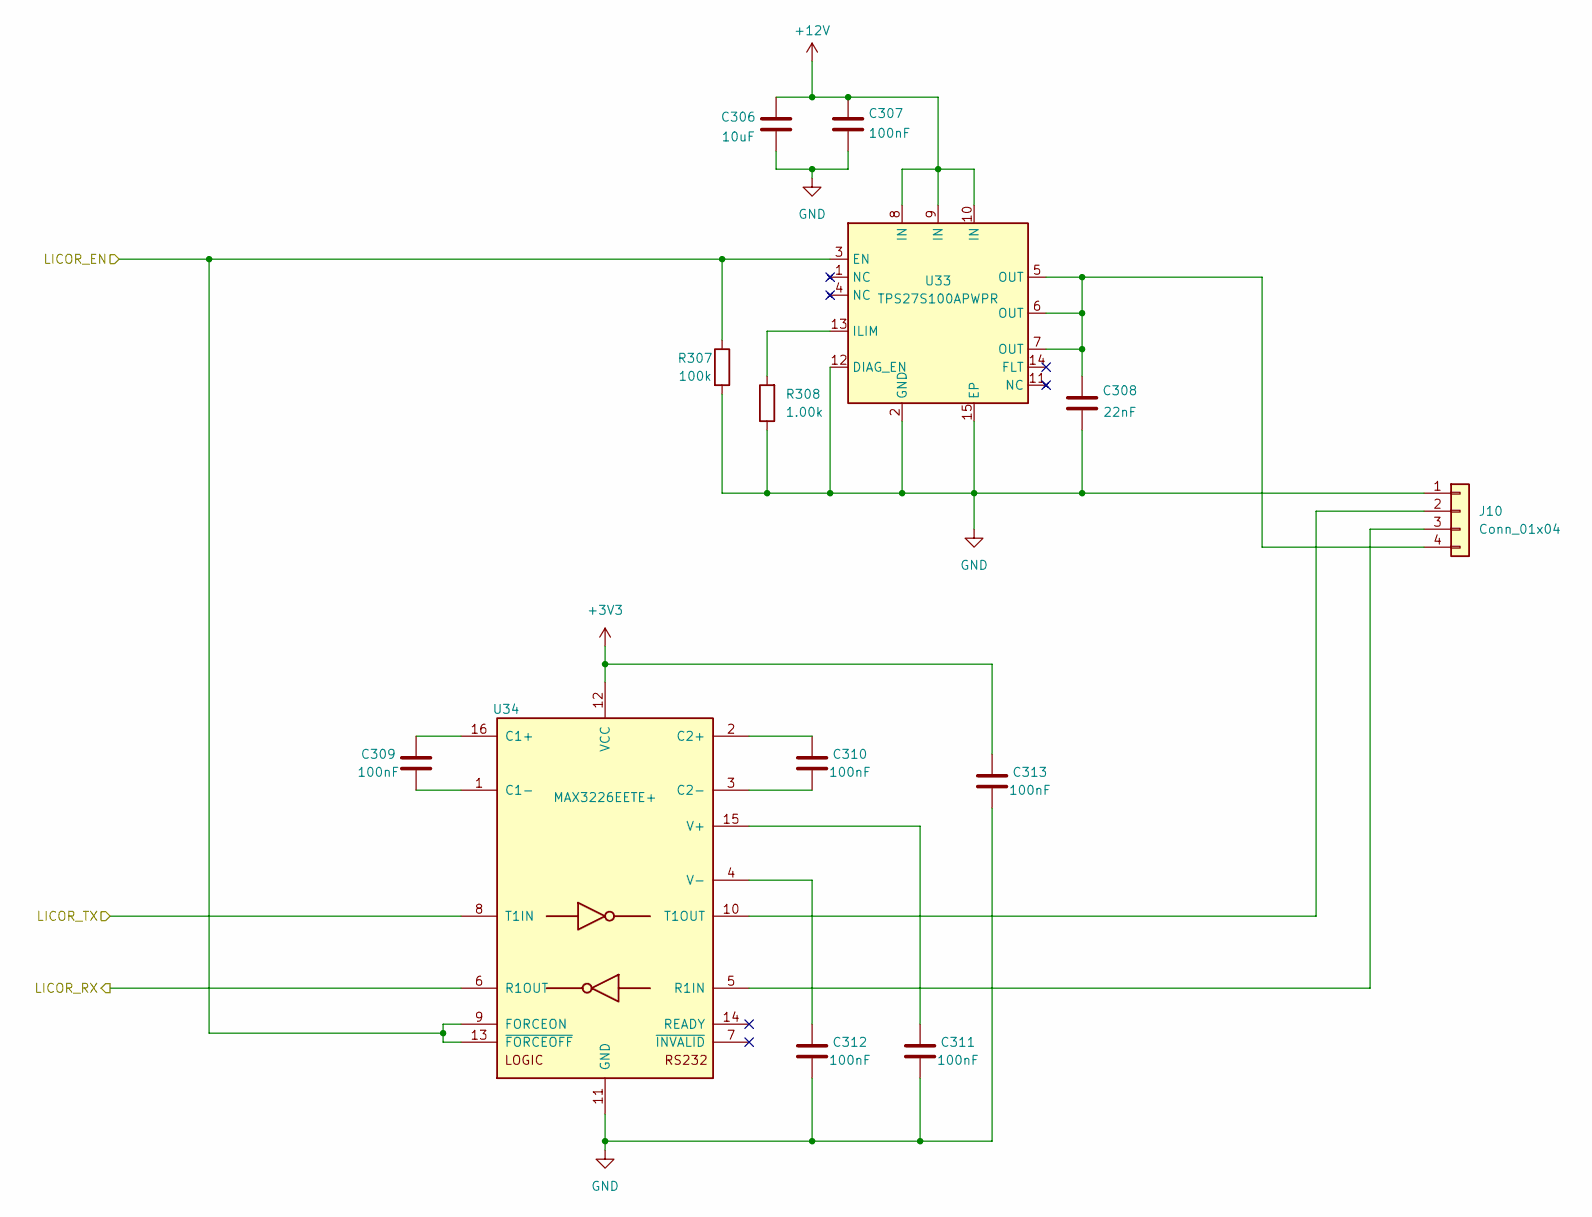
[picture p62: schematic Licor.kicad_sch]

Parts:
C306: 10uF; C_1206_3216Metric; MPN CGA5L1X7R1H106K160AC
C307, C309, C310, C311, C312, C313: 100nF; C_0402_1005Metric; MPN GRM155R71H104ME14D
C308: 22nF; C_0402_1005Metric; MPN GRM155R71H223KA12D
J10: Conn_01x04; Molex_Micro-Fit_3.0_43045-0400_2x02_P3.00mm_Horizontal; MPN 0430450400
R307: 100k; R_0402_1005Metric; MPN CRCW0402100KFKED
R308: 1.00k; R_0402_1005Metric; MPN CRCW04021K00FKED
U33: TPS27S100APWPR; Texas_HTSSOP-14-1EP_4.4x5mm_P0.65mm_EP3.4x5mm_Mask3.155x3.2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; MPN TPS27S100APWPR; DigiKey 296-49002-1-ND
U34: MAX3226EETE+; TQFN-16-1EP_5x5mm_P0.8mm_EP3.1x3.1mm; MPN MAX3226EETE+

Connections:
+3V3: C313.1, U34.12 (VCC); also elsewhere on the board
+12V: C306.1, C307.1, U33.8 (IN), U33.9 (IN), U33.10 (IN); also elsewhere on the board
/STM32 MCU/LICOR_EN: R307.1, U33.3 (EN), U34.9 (FORCEON), U34.13 (~FORCEOFF); also elsewhere on the board
/STM32 MCU/LICOR_RX: U34.6 (R1OUT); also elsewhere on the board
/STM32 MCU/LICOR_TX: U34.8 (T1IN); also elsewhere on the board
GND: C306.2, C307.2, C308.2, C311.2, C312.2, C313.2, J10.1, R307.2, R308.1, U33.2 (GND), U33.12 (DIAG_EN), U33.15 (EP), U34.11 (GND), U34.17 (EP); also elsewhere on the board
unnamed: J10.2, U34.10 (T1OUT)
unnamed: J10.3, U34.5 (R1IN)
unnamed: C308.1, J10.4, U33.5 (OUT), U33.6 (OUT), U33.7 (OUT)
unnamed: R308.2, U33.13 (ILIM)
unnamed: C309.1, U34.16 (C1+)
unnamed: C309.2, U34.1 (C1-)
unnamed: C310.1, U34.2 (C2+)
unnamed: C310.2, U34.3 (C2-)
unnamed: C311.1, U34.15 (V+)
unnamed: C312.1, U34.4 (V-)

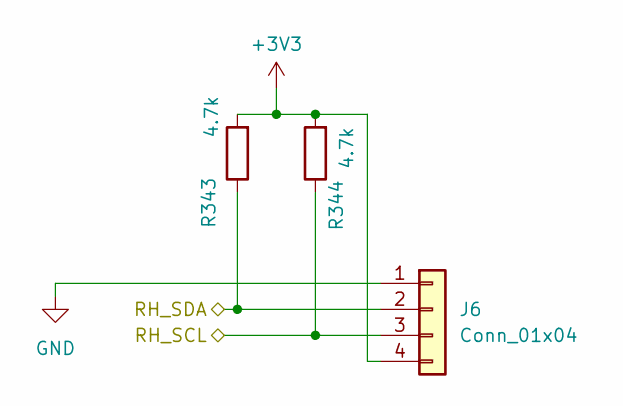
[picture p63: schematic rh_sensor.kicad_sch]

Parts:
J6: Conn_01x04; Molex_Micro-Fit_3.0_43045-0400_2x02_P3.00mm_Horizontal; MPN 0430450400
R343, R344: 4.7k; R_0603_1608Metric; Tolerance 1%; Power Rating 0.125W; MPN CRCW06034K70FKEA

Connections:
+3V3: J6.4, R343.2, R344.2; also elsewhere on the board
/STM32 MCU/RH_SCL: J6.3, R344.1; also elsewhere on the board
/STM32 MCU/RH_SDA: J6.2, R343.1; also elsewhere on the board
GND: J6.1; also elsewhere on the board

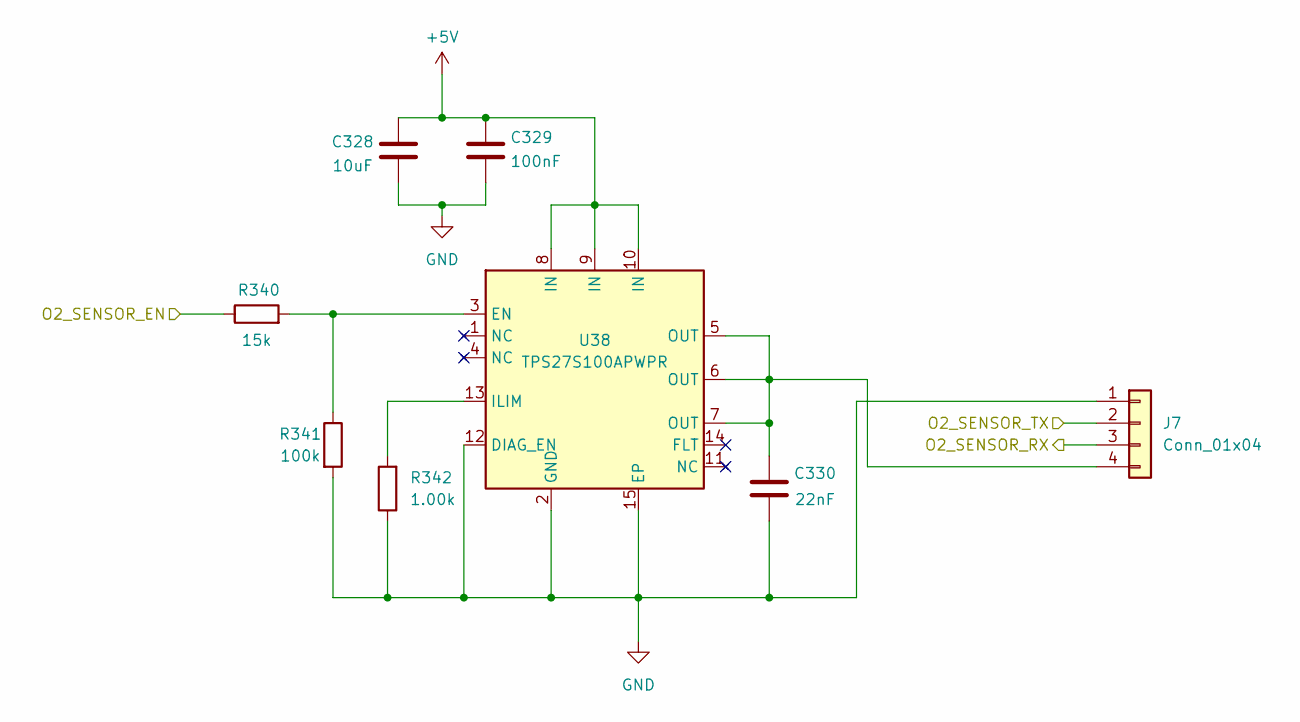
[picture p64: schematic o2_sensor.kicad_sch]

Parts:
C328: 10uF; C_1206_3216Metric; MPN CGA5L1X7R1H106K160AC
C329: 100nF; C_0402_1005Metric; MPN GRM155R71H104ME14D
C330: 22nF; C_0402_1005Metric; MPN GRM155R71H223KA12D
J7: Conn_01x04; Molex_Micro-Fit_3.0_43045-0400_2x02_P3.00mm_Horizontal; MPN 0430450400
R340: 15k; R_0402_1005Metric; MPN CRCW040215K0FKED
R341: 100k; R_0402_1005Metric; MPN CRCW0402100KFKED
R342: 1.00k; R_0402_1005Metric; MPN CRCW04021K00FKED
U38: TPS27S100APWPR; Texas_HTSSOP-14-1EP_4.4x5mm_P0.65mm_EP3.4x5mm_Mask3.155x3.2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; MPN TPS27S100APWPR; DigiKey 296-49002-1-ND

Connections:
+5V: C328.1, C329.1, U38.8 (IN), U38.9 (IN), U38.10 (IN); also elsewhere on the board
/STM32 MCU/O2_SENSOR_EN: R340.1; also elsewhere on the board
/STM32 MCU/O2_SENSOR_RX: J7.3; also elsewhere on the board
/STM32 MCU/O2_SENSOR_TX: J7.2; also elsewhere on the board
GND: C328.2, C329.2, C330.2, J7.1, R341.2, R342.1, U38.2 (GND), U38.12 (DIAG_EN), U38.15 (EP); also elsewhere on the board
unnamed: C330.1, J7.4, U38.5 (OUT), U38.6 (OUT), U38.7 (OUT)
unnamed: R340.2, R341.1, U38.3 (EN)
unnamed: R342.2, U38.13 (ILIM)

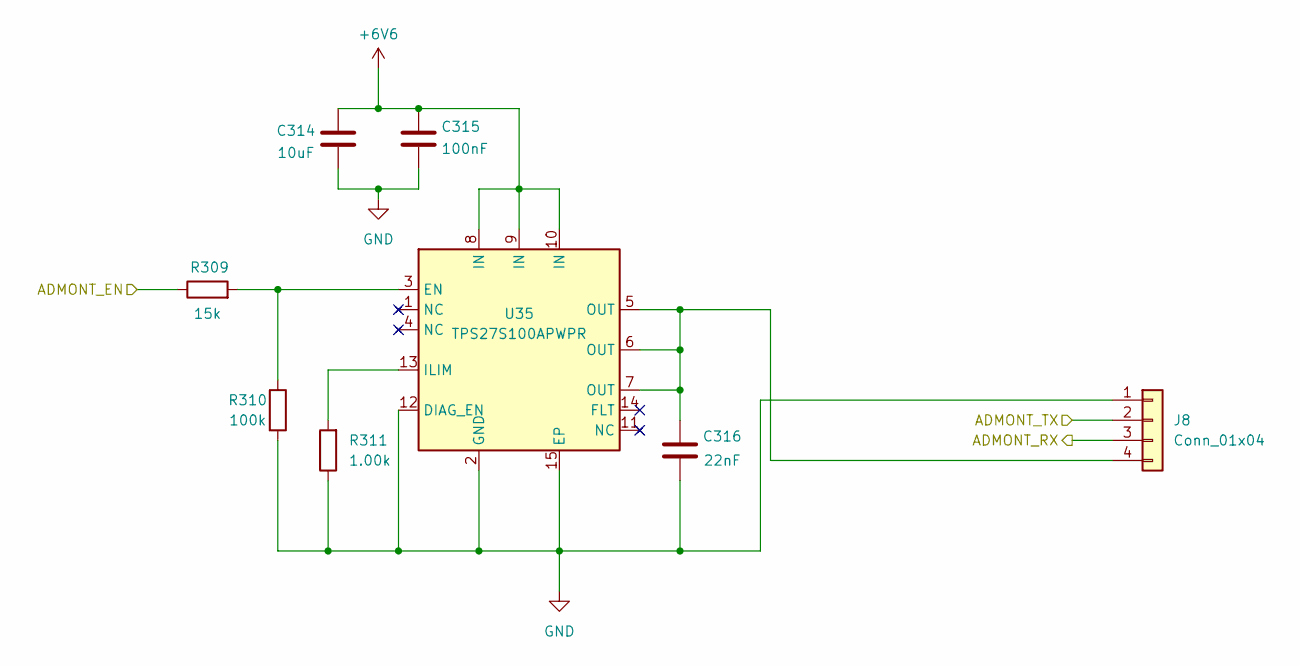
[picture p65: schematic admont_k96.kicad_sch]

Parts:
C314: 10uF; C_1206_3216Metric; MPN CGA5L1X7R1H106K160AC
C315: 100nF; C_0402_1005Metric; MPN GRM155R71H104ME14D
C316: 22nF; C_0402_1005Metric; MPN GRM155R71H223KA12D
J8: Conn_01x04; Molex_Micro-Fit_3.0_43045-0400_2x02_P3.00mm_Horizontal; MPN 0430450400
R309: 15k; R_0402_1005Metric; MPN CRCW040215K0FKED
R310: 100k; R_0402_1005Metric; MPN CRCW0402100KFKED
R311: 1.00k; R_0402_1005Metric; MPN CRCW04021K00FKED
U35: TPS27S100APWPR; Texas_HTSSOP-14-1EP_4.4x5mm_P0.65mm_EP3.4x5mm_Mask3.155x3.2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; MPN TPS27S100APWPR; DigiKey 296-49002-1-ND

Connections:
+6V6: C314.1, C315.1, U35.8 (IN), U35.9 (IN), U35.10 (IN); also elsewhere on the board
/STM32 MCU/ADMONT_EN: R309.1; also elsewhere on the board
/STM32 MCU/ADMONT_RX: J8.3; also elsewhere on the board
/STM32 MCU/ADMONT_TX: J8.2; also elsewhere on the board
GND: C314.2, C315.2, C316.2, J8.1, R310.2, R311.1, U35.2 (GND), U35.12 (DIAG_EN), U35.15 (EP); also elsewhere on the board
unnamed: C316.1, J8.4, U35.5 (OUT), U35.6 (OUT), U35.7 (OUT)
unnamed: R309.2, R310.1, U35.3 (EN)
unnamed: R311.2, U35.13 (ILIM)

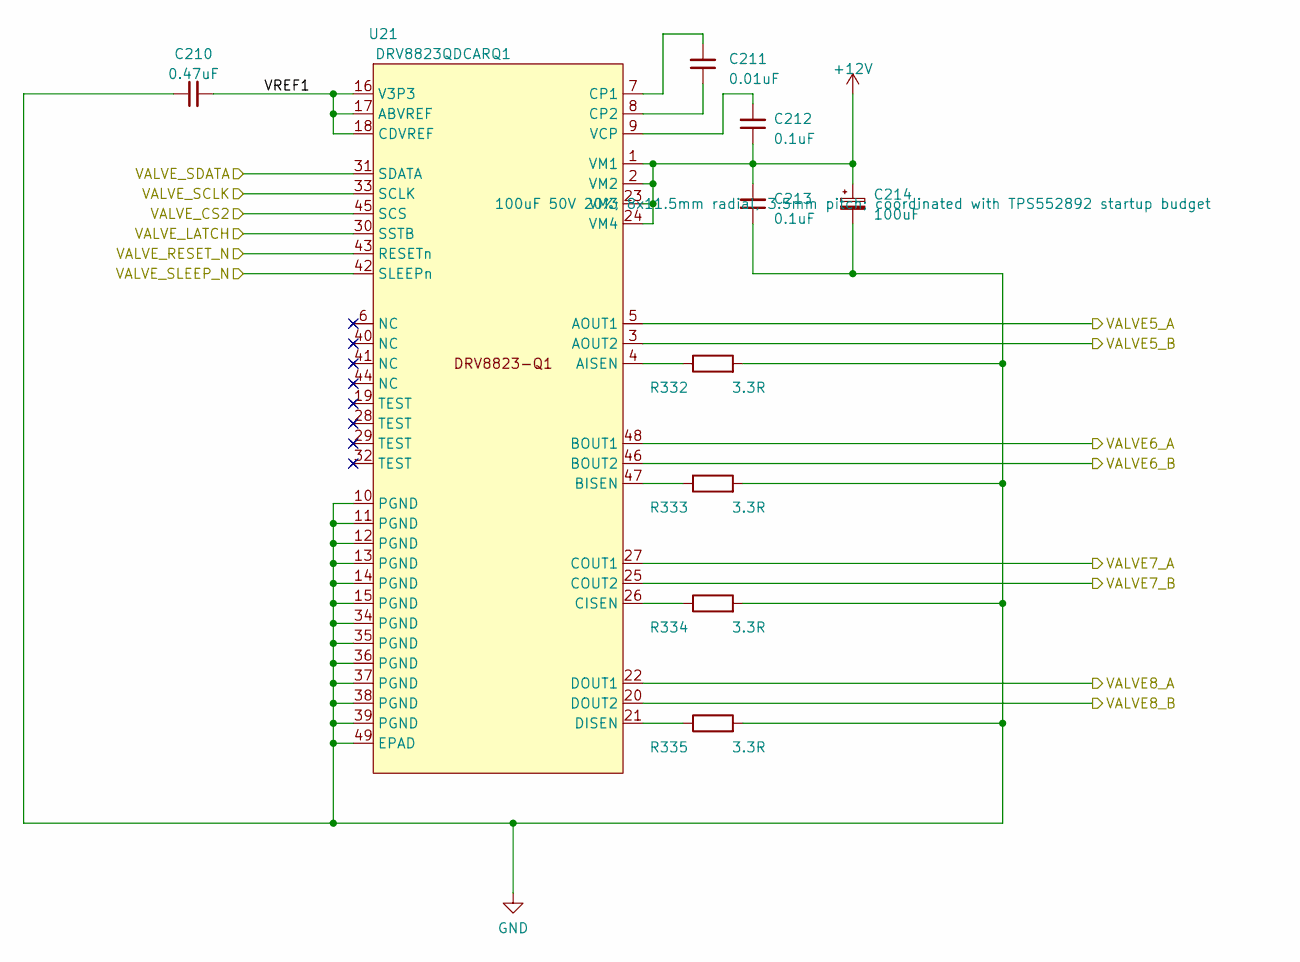
[picture p66: schematic Valve_Control_Bank2.kicad_sch, Valve Control Bank 2]

Parts:
C210: 0.47uF; C_0603_1608Metric_Pad1.08x0.95mm_HandSolder; MPN CGA3E3X7R1H474K080AE
C211: 0.01uF; C_0603_1608Metric_Pad1.08x0.95mm_HandSolder; MPN C0603C103K2RACTU
C212, C213: 0.1uF; C_0603_1608Metric_Pad1.08x0.95mm_HandSolder; MPN C0603X104K5RAC7867
C214: 100uF; CP_Radial_D8.0mm_P3.50mm; MPN UHE1H101MPD
R332, R333, R334, R335: 3.3R; R_0402_1005Metric; Tolerance 1%; Power Rating 0.2W; MPN CRCW04023R30FKEDHP
U21: DRV8823QDCARQ1; DRV8823_DCA48_ReviewFixed; MPN DRV8823QDCARQ1

Connections:
+12V: C212.1, C213.2, C214.1, U21.1 (VM1), U21.2 (VM2), U21.23 (VM3), U21.24 (VM4); also elsewhere on the board
/Valve Control/VALVE_CS2: U21.45 (SCS); also elsewhere on the board
/Valve Control/VALVE_LATCH: U21.30 (SSTB); also elsewhere on the board
/Valve Control/VALVE_RESET_N: U21.43 (RESETn); also elsewhere on the board
/Valve Control/VALVE_SCLK: U21.33 (SCLK); also elsewhere on the board
/Valve Control/VALVE_SDATA: U21.31 (SDATA); also elsewhere on the board
/Valve Control/VALVE_SLEEP_N: U21.42 (SLEEPn); also elsewhere on the board
/Valve Control/Valve Control Bank 2/VALVE5_A: U21.5 (AOUT1); also elsewhere on the board
/Valve Control/Valve Control Bank 2/VALVE5_B: U21.3 (AOUT2); also elsewhere on the board
/Valve Control/Valve Control Bank 2/VALVE6_A: U21.48 (BOUT1); also elsewhere on the board
/Valve Control/Valve Control Bank 2/VALVE6_B: U21.46 (BOUT2); also elsewhere on the board
/Valve Control/Valve Control Bank 2/VALVE7_A: U21.27 (COUT1); also elsewhere on the board
/Valve Control/Valve Control Bank 2/VALVE7_B: U21.25 (COUT2); also elsewhere on the board
/Valve Control/Valve Control Bank 2/VALVE8_A: U21.22 (DOUT1); also elsewhere on the board
/Valve Control/Valve Control Bank 2/VALVE8_B: U21.20 (DOUT2); also elsewhere on the board
/Valve Control/Valve Control Bank 2/VREF1: C210.2, U21.16 (V3P3), U21.17 (ABVREF), U21.18 (CDVREF)
GND: C210.1, C213.1, C214.2, R332.2, R333.2, R334.2, R335.2, U21.10 (PGND), U21.11 (PGND), U21.12 (PGND), U21.13 (PGND), U21.14 (PGND), U21.15 (PGND), U21.34 (PGND), U21.35 (PGND), U21.36 (PGND), U21.37 (PGND), U21.38 (PGND), U21.39 (PGND), U21.49 (EPAD); also elsewhere on the board
unnamed: R332.1, U21.4 (AISEN)
unnamed: R333.1, U21.47 (BISEN)
unnamed: R334.1, U21.26 (CISEN)
unnamed: C211.2, U21.7 (CP1)
unnamed: C211.1, U21.8 (CP2)
unnamed: R335.1, U21.21 (DISEN)
unnamed: C212.2, U21.9 (VCP)

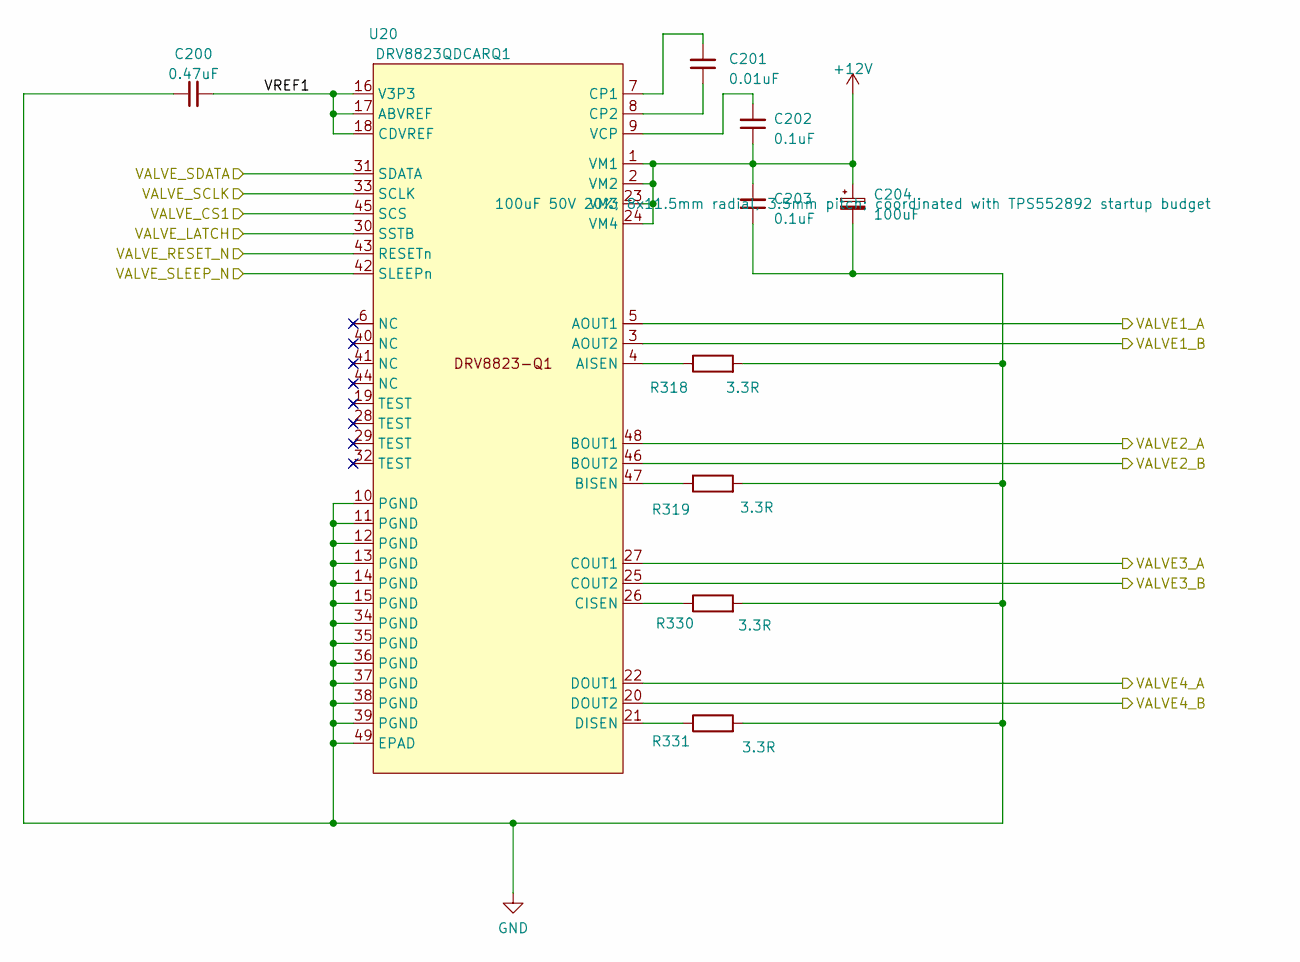
[picture p67: schematic Valve_Control_Bank1.kicad_sch, Valve Control Bank 1]

Parts:
C200: 0.47uF; C_0603_1608Metric_Pad1.08x0.95mm_HandSolder; MPN CGA3E3X7R1H474K080AE
C201: 0.01uF; C_0603_1608Metric_Pad1.08x0.95mm_HandSolder; MPN C0603C103K2RACTU
C202, C203: 0.1uF; C_0603_1608Metric_Pad1.08x0.95mm_HandSolder; MPN C0603X104K5RAC7867
C204: 100uF; CP_Radial_D8.0mm_P3.50mm; MPN UHE1H101MPD
R318, R319, R330, R331: 3.3R; R_0402_1005Metric; Tolerance 1%; Power Rating 0.2W; MPN CRCW04023R30FKEDHP
U20: DRV8823QDCARQ1; DRV8823_DCA48_ReviewFixed; MPN DRV8823QDCARQ1

Connections:
+12V: C202.1, C203.2, C204.1, U20.1 (VM1), U20.2 (VM2), U20.23 (VM3), U20.24 (VM4); also elsewhere on the board
/Valve Control/VALVE_CS1: U20.45 (SCS); also elsewhere on the board
/Valve Control/VALVE_LATCH: U20.30 (SSTB); also elsewhere on the board
/Valve Control/VALVE_RESET_N: U20.43 (RESETn); also elsewhere on the board
/Valve Control/VALVE_SCLK: U20.33 (SCLK); also elsewhere on the board
/Valve Control/VALVE_SDATA: U20.31 (SDATA); also elsewhere on the board
/Valve Control/VALVE_SLEEP_N: U20.42 (SLEEPn); also elsewhere on the board
/Valve Control/Valve Control Bank 1/VALVE1_A: U20.5 (AOUT1); also elsewhere on the board
/Valve Control/Valve Control Bank 1/VALVE1_B: U20.3 (AOUT2); also elsewhere on the board
/Valve Control/Valve Control Bank 1/VALVE2_A: U20.48 (BOUT1); also elsewhere on the board
/Valve Control/Valve Control Bank 1/VALVE2_B: U20.46 (BOUT2); also elsewhere on the board
/Valve Control/Valve Control Bank 1/VALVE3_A: U20.27 (COUT1); also elsewhere on the board
/Valve Control/Valve Control Bank 1/VALVE3_B: U20.25 (COUT2); also elsewhere on the board
/Valve Control/Valve Control Bank 1/VALVE4_A: U20.22 (DOUT1); also elsewhere on the board
/Valve Control/Valve Control Bank 1/VALVE4_B: U20.20 (DOUT2); also elsewhere on the board
/Valve Control/Valve Control Bank 1/VREF1: C200.2, U20.16 (V3P3), U20.17 (ABVREF), U20.18 (CDVREF)
GND: C200.1, C203.1, C204.2, R318.2, R319.2, R330.2, R331.2, U20.10 (PGND), U20.11 (PGND), U20.12 (PGND), U20.13 (PGND), U20.14 (PGND), U20.15 (PGND), U20.34 (PGND), U20.35 (PGND), U20.36 (PGND), U20.37 (PGND), U20.38 (PGND), U20.39 (PGND), U20.49 (EPAD); also elsewhere on the board
unnamed: R318.1, U20.4 (AISEN)
unnamed: R319.1, U20.47 (BISEN)
unnamed: R330.1, U20.26 (CISEN)
unnamed: C201.2, U20.7 (CP1)
unnamed: C201.1, U20.8 (CP2)
unnamed: R331.1, U20.21 (DISEN)
unnamed: C202.2, U20.9 (VCP)
