jkurina86/DIC_Board/DIC_Board/DIC_Board.kicad_pcb

## KiCad design DIC_Board/DIC_Board.kicad_pcb (continued)

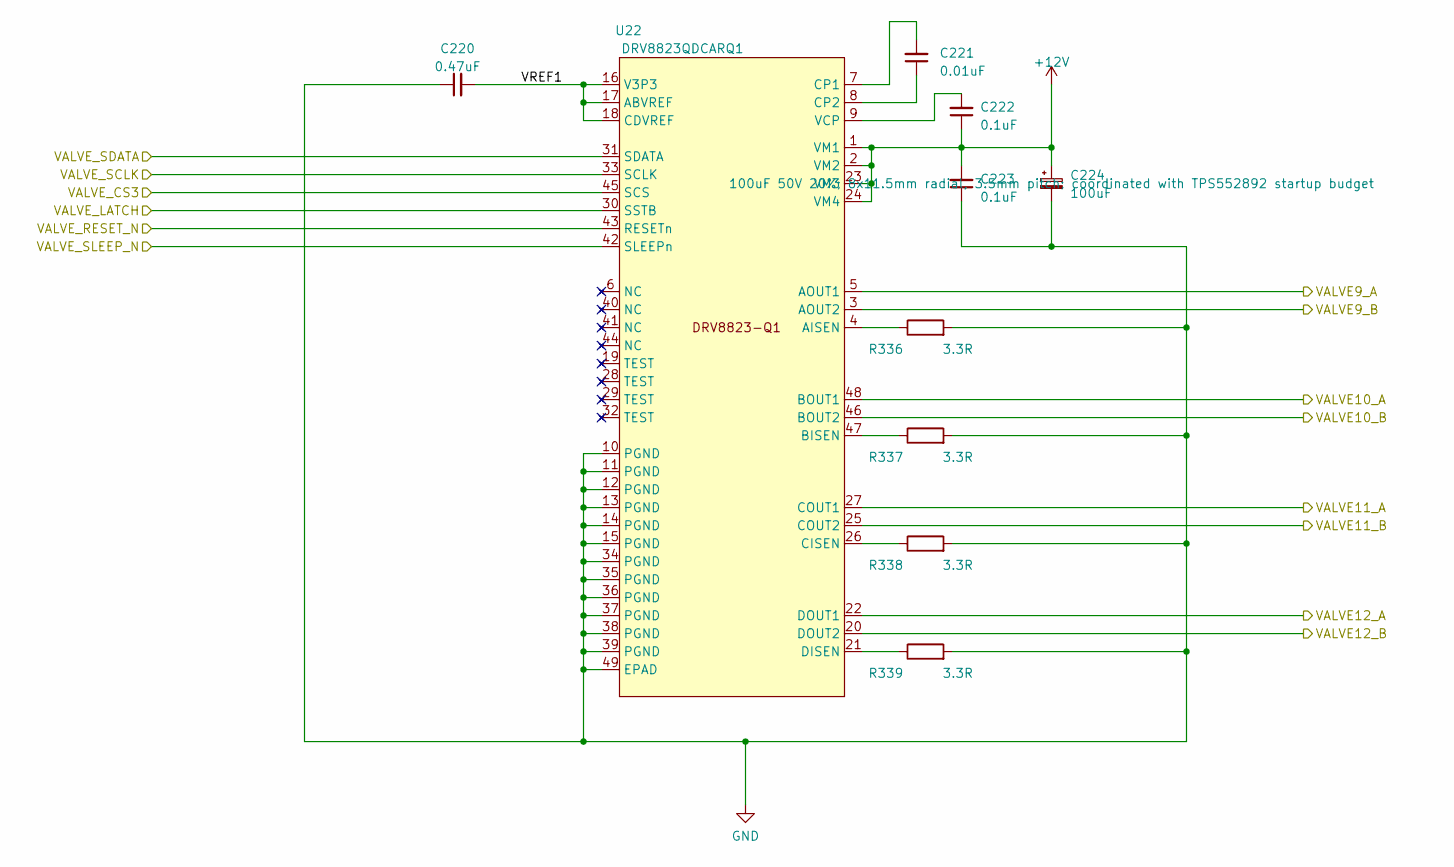
[picture p68: schematic Valve_Control_Bank3.kicad_sch, Valve Control Bank 3]

Parts:
C220: 0.47uF; C_0603_1608Metric_Pad1.08x0.95mm_HandSolder; MPN CGA3E3X7R1H474K080AE
C221: 0.01uF; C_0603_1608Metric_Pad1.08x0.95mm_HandSolder; MPN C0603C103K2RACTU
C222, C223: 0.1uF; C_0603_1608Metric_Pad1.08x0.95mm_HandSolder; MPN C0603X104K5RAC7867
C224: 100uF; CP_Radial_D8.0mm_P3.50mm; MPN UHE1H101MPD
R336, R337, R338, R339: 3.3R; R_0402_1005Metric; Tolerance 1%; Power Rating 0.2W; MPN CRCW04023R30FKEDHP
U22: DRV8823QDCARQ1; DRV8823_DCA48_ReviewFixed; MPN DRV8823QDCARQ1

Connections:
+12V: C222.1, C223.2, C224.1, U22.1 (VM1), U22.2 (VM2), U22.23 (VM3), U22.24 (VM4); also elsewhere on the board
/Valve Control/VALVE_CS3: U22.45 (SCS); also elsewhere on the board
/Valve Control/VALVE_LATCH: U22.30 (SSTB); also elsewhere on the board
/Valve Control/VALVE_RESET_N: U22.43 (RESETn); also elsewhere on the board
/Valve Control/VALVE_SCLK: U22.33 (SCLK); also elsewhere on the board
/Valve Control/VALVE_SDATA: U22.31 (SDATA); also elsewhere on the board
/Valve Control/VALVE_SLEEP_N: U22.42 (SLEEPn); also elsewhere on the board
/Valve Control/Valve Control Bank 3/VALVE9_A: U22.5 (AOUT1); also elsewhere on the board
/Valve Control/Valve Control Bank 3/VALVE9_B: U22.3 (AOUT2); also elsewhere on the board
/Valve Control/Valve Control Bank 3/VALVE10_A: U22.48 (BOUT1); also elsewhere on the board
/Valve Control/Valve Control Bank 3/VALVE10_B: U22.46 (BOUT2); also elsewhere on the board
/Valve Control/Valve Control Bank 3/VALVE11_A: U22.27 (COUT1); also elsewhere on the board
/Valve Control/Valve Control Bank 3/VALVE11_B: U22.25 (COUT2); also elsewhere on the board
/Valve Control/Valve Control Bank 3/VALVE12_A: U22.22 (DOUT1); also elsewhere on the board
/Valve Control/Valve Control Bank 3/VALVE12_B: U22.20 (DOUT2); also elsewhere on the board
/Valve Control/Valve Control Bank 3/VREF1: C220.2, U22.16 (V3P3), U22.17 (ABVREF), U22.18 (CDVREF)
GND: C220.1, C223.1, C224.2, R336.2, R337.2, R338.2, R339.2, U22.10 (PGND), U22.11 (PGND), U22.12 (PGND), U22.13 (PGND), U22.14 (PGND), U22.15 (PGND), U22.34 (PGND), U22.35 (PGND), U22.36 (PGND), U22.37 (PGND), U22.38 (PGND), U22.39 (PGND), U22.49 (EPAD); also elsewhere on the board
unnamed: R336.1, U22.4 (AISEN)
unnamed: R337.1, U22.47 (BISEN)
unnamed: R338.1, U22.26 (CISEN)
unnamed: C221.2, U22.7 (CP1)
unnamed: C221.1, U22.8 (CP2)
unnamed: R339.1, U22.21 (DISEN)
unnamed: C222.2, U22.9 (VCP)

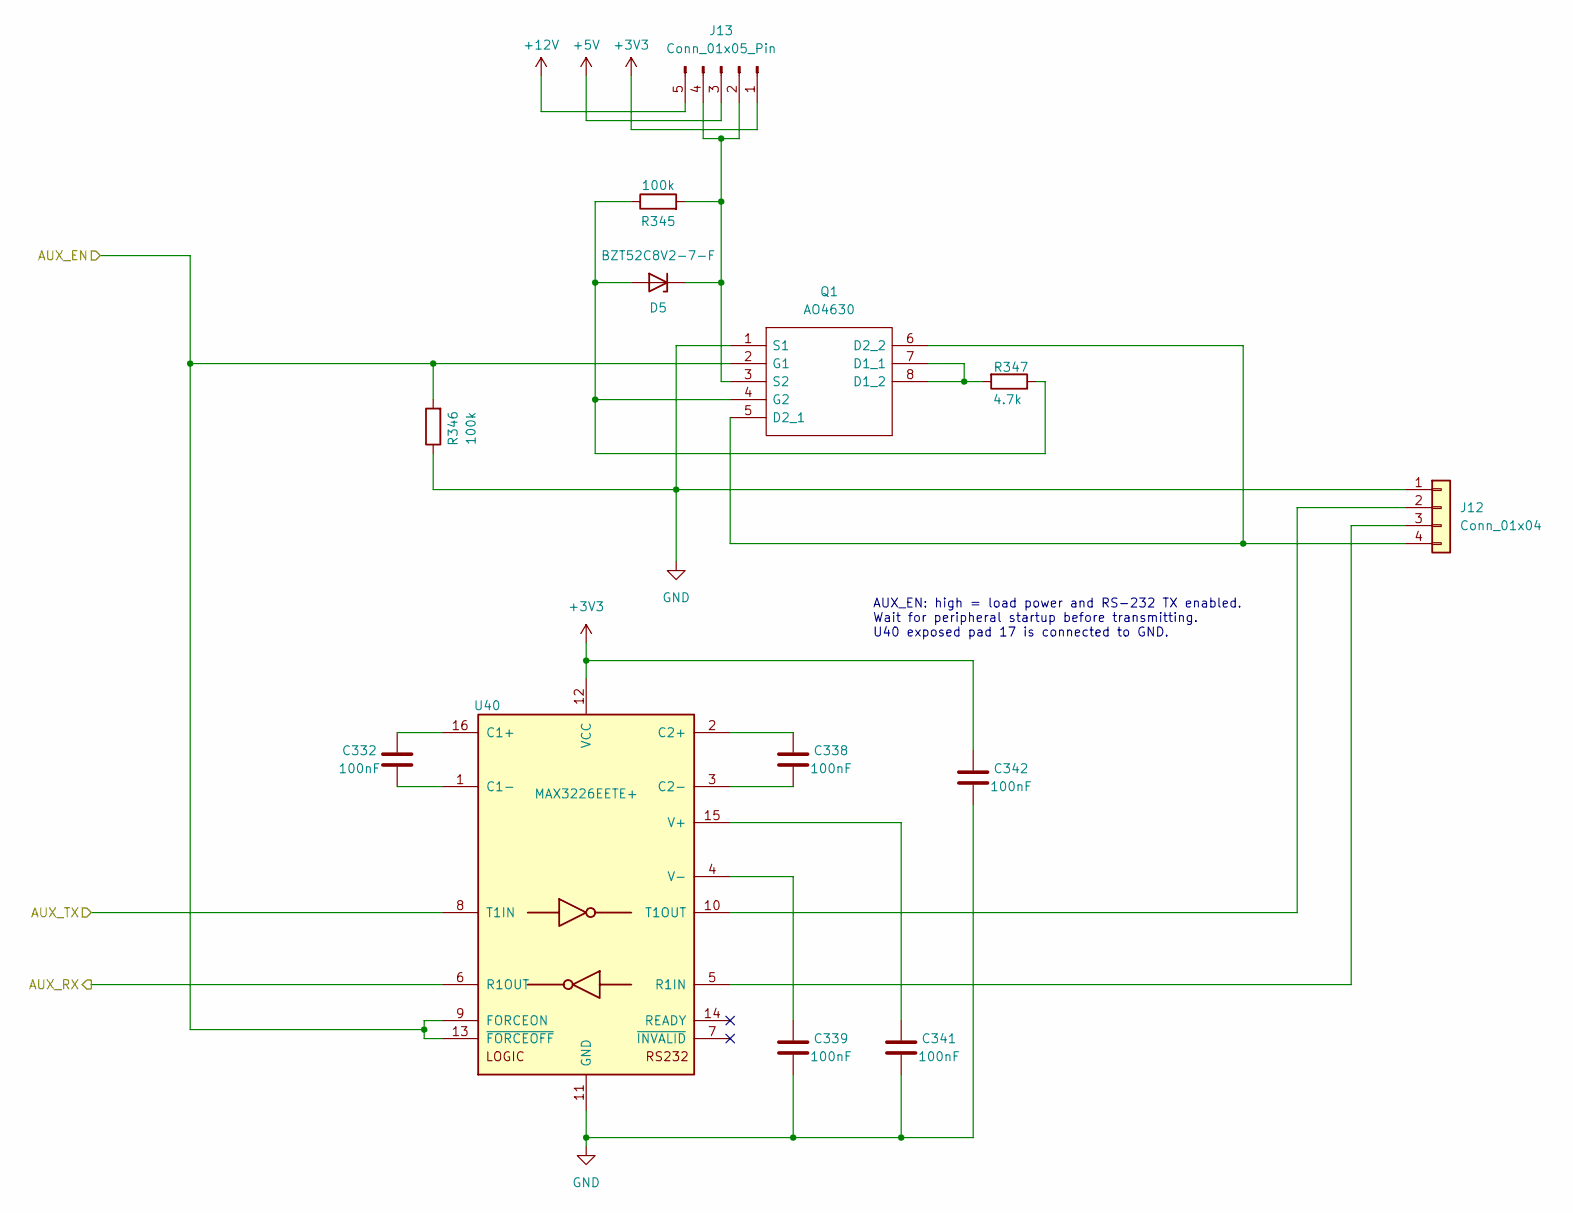
[picture p69: schematic auxiliary.kicad_sch]

Parts:
C332, C338, C339, C341, C342: 100nF; C_0402_1005Metric; MPN GRM155R71H104ME14D
D5: BZT52C8V2-7-F; D_SOD-123; MPN BZT52C8V2-7-F
J12: Conn_01x04; Molex_Micro-Fit_3.0_43045-0400_2x02_P3.00mm_Horizontal; MPN 0430450400
J13: Conn_01x05_Pin; PinHeader_Wurth_61300511121_1x05_P2.54mm_Vertical; MPN 61300511121
Q1: AO4630; SOIC-8_3.9x4.9mm_P1.27mm; Manufacturer_Part_Number AO4630
R345, R346: 100k; R_0402_1005Metric; MPN CRCW0402100KFKED
R347: 4.7k; R_0402_1005Metric; MPN CRCW04024K70FKED
U40: MAX3226EETE+; TQFN-16-1EP_5x5mm_P0.8mm_EP3.1x3.1mm; MPN MAX3226EETE+

Connections:
+3V3: C342.1, J13.1, U40.12 (VCC); also elsewhere on the board
+5V: J13.3; also elsewhere on the board
+12V: J13.5; also elsewhere on the board
/Comms/AUX_EN: Q1.2 (G1), R346.2, U40.9 (FORCEON), U40.13 (~FORCEOFF); also elsewhere on the board
/Comms/AUX_RX: U40.6 (R1OUT); also elsewhere on the board
/Comms/AUX_TX: U40.8 (T1IN); also elsewhere on the board
GND: C339.2, C341.2, C342.2, J12.1, Q1.1 (S1), R346.1, U40.11 (GND), U40.17 (EP); also elsewhere on the board
unnamed: D5.2 (A), Q1.4 (G2), R345.1, R347.1
unnamed: D5.1 (K), J13.2, J13.4, Q1.3 (S2), R345.2
unnamed: J12.2, U40.10 (T1OUT)
unnamed: J12.3, U40.5 (R1IN)
unnamed: J12.4, Q1.5 (D2_1), Q1.6 (D2_2)
unnamed: Q1.7 (D1_1), Q1.8 (D1_2), R347.2
unnamed: C332.1, U40.16 (C1+)
unnamed: C332.2, U40.1 (C1-)
unnamed: C338.1, U40.2 (C2+)
unnamed: C338.2, U40.3 (C2-)
unnamed: C341.1, U40.15 (V+)
unnamed: C339.1, U40.4 (V-)

Notes on the sheet:
AUX_EN: high = load power and RS-232 TX enabled. Wait for peripheral startup before transmitting. U40 exposed pad 17 is connected to GND.

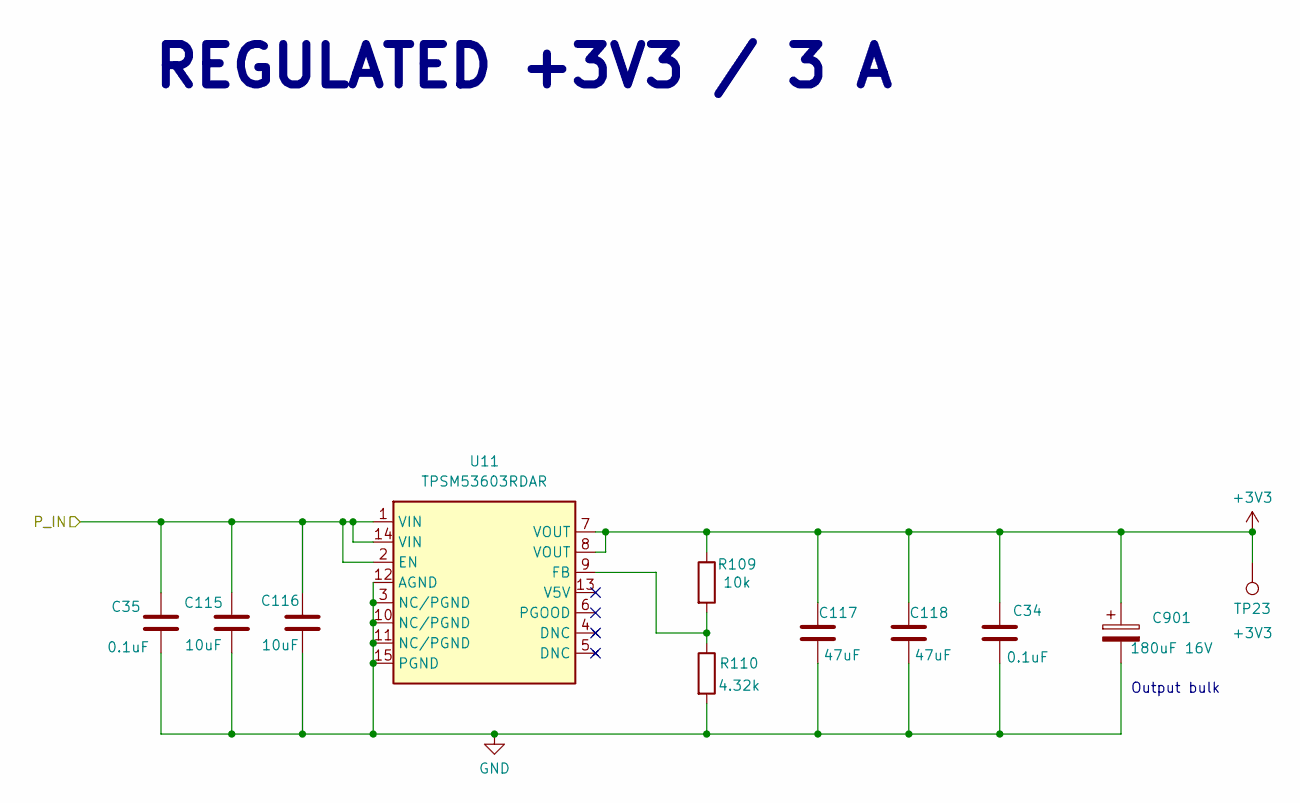
[picture p70: schematic 3v3.kicad_sch]

Parts:
C34, C35: 0.1uF; C_0603_1608Metric; Voltage Rating 50V; Tolerance 10%; MPN C1608X7R1H104K080AA
C115, C116: 10uF; C_1206_3216Metric; MPN CGA5L1X7R1H106K160AC
C117, C118: 47uF; C_1210_3225Metric; MPN GRM32ER61A476ME20L
C901: 180uF 16V; CP_Elec_6.3x5.9; Voltage Rating 16V; Tolerance 20%; MPN 16SVPF180M
R109: 10k; R_0402_1005Metric; MPN CRCW040210K0FKED
R110: 4.32k; R_0402_1005Metric; MPN CRCW04024K32FKED
TP23: +3V3; TestPoint_Pad_D1.0mm
U11: TPSM53603RDAR; Texas_B3QFN-14-1EP_5x5.5mm_P0.65mm_ThermalVia; MPN TPSM53603RDAR

Connections:
+3V3: C34.1, C117.1, C118.1, C901.1, R109.1, TP23.1 (1_1), U11.7 (VOUT), U11.8 (VOUT); also elsewhere on the board
/Power/12V/P_IN: C35.1, C115.1, C116.1, U11.1 (VIN), U11.2 (EN), U11.14 (VIN); also elsewhere on the board
GND: C34.2, C35.2, C115.2, C116.2, C117.2, C118.2, C901.2, R110.2, U11.3 (NC/PGND), U11.10 (NC/PGND), U11.11 (NC/PGND), U11.12 (AGND), U11.15 (PGND); also elsewhere on the board
unnamed: R109.2, R110.1, U11.9 (FB)

Notes on the sheet:
Output bulk
REGULATED +3V3 / 3 A

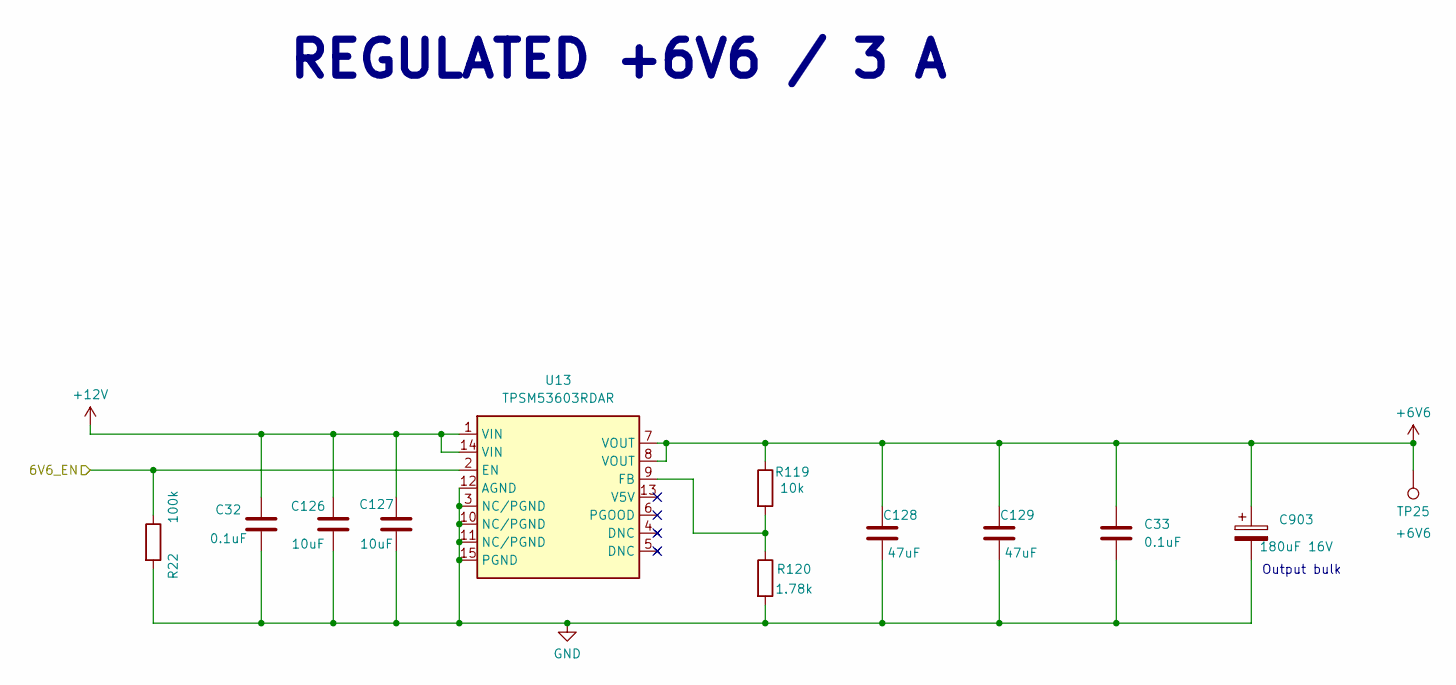
[picture p71: schematic 6v6.kicad_sch]

Parts:
C32, C33: 0.1uF; C_0603_1608Metric; Voltage Rating 50V; Tolerance 10%; MPN C1608X7R1H104K080AA
C126, C127: 10uF; C_1206_3216Metric; MPN CGA5L1X7R1H106K160AC
C128, C129: 47uF; C_1210_3225Metric; MPN GRM32ER61A476ME20L
C903: 180uF 16V; CP_Elec_6.3x5.9; Voltage Rating 16V; Tolerance 20%; MPN 16SVPF180M
R22: 100k; R_0402_1005Metric; MPN CRCW0402100KFKED
R119: 10k; R_0402_1005Metric; MPN CRCW040210K0FKED
R120: 1.78k; R_0402_1005Metric; MPN CRCW04021K78FKED
TP25: +6V6; TestPoint_Pad_D1.0mm
U13: TPSM53603RDAR; Texas_B3QFN-14-1EP_5x5.5mm_P0.65mm_ThermalVia; MPN TPSM53603RDAR

Connections:
+6V6: C33.1, C128.1, C129.1, C903.1, R119.1, TP25.1 (1_1), U13.7 (VOUT), U13.8 (VOUT); also elsewhere on the board
+12V: C32.1, C126.1, C127.1, U13.1 (VIN), U13.14 (VIN); also elsewhere on the board
/Power/6V6_EN: R22.1, U13.2 (EN); also elsewhere on the board
GND: C32.2, C33.2, C126.2, C127.2, C128.2, C129.2, C903.2, R22.2, R120.2, U13.3 (NC/PGND), U13.10 (NC/PGND), U13.11 (NC/PGND), U13.12 (AGND), U13.15 (PGND); also elsewhere on the board
unnamed: R119.2, R120.1, U13.9 (FB)

Notes on the sheet:
REGULATED +6V6 / 3 A
Output bulk

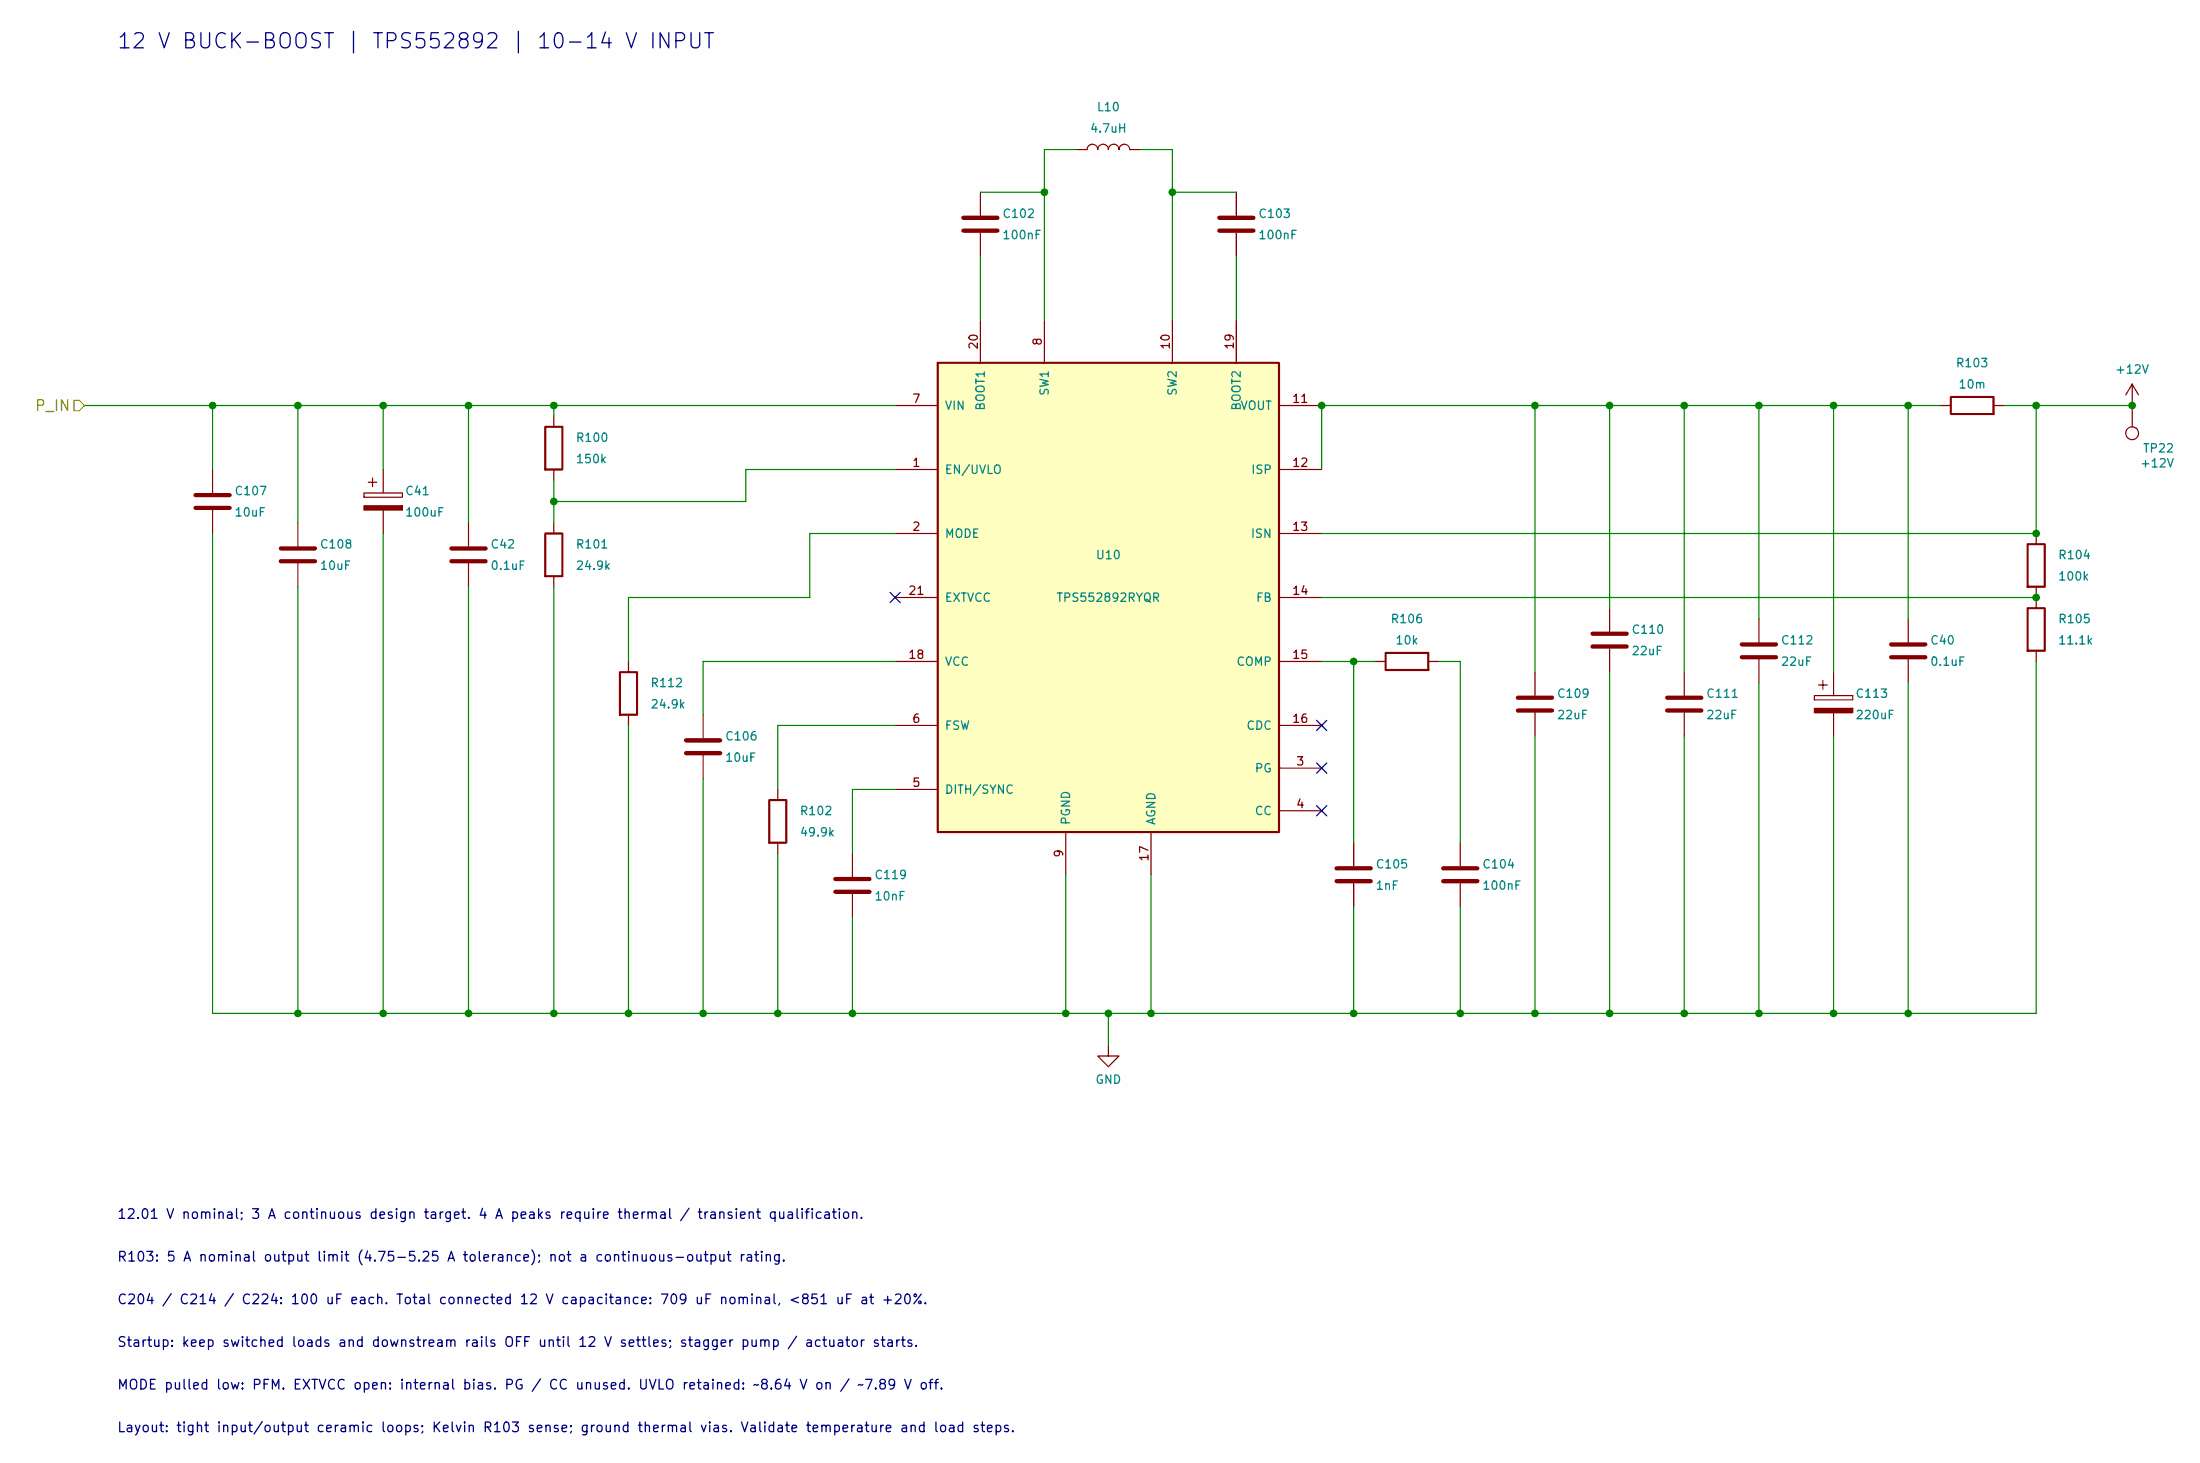
[picture p72: schematic 12v.kicad_sch]

Parts:
C40, C42: 0.1uF; C_0603_1608Metric; Voltage Rating 50V; Tolerance 10%; MPN C1608X7R1H104K080AA
C41: 100uF; CP_Elec_8x10.5; Voltage Rating 35V; MPN EEHZA1V101P
C102, C103: 100nF; C_0402_1005Metric; MPN GRM155R71H104ME14D
C104: 100nF; C_0603_1608Metric; Tolerance 10%; Voltage Rating 50V; MPN C1608X7R1H104K080AA
C105: 1nF; C_0603_1608Metric; Tolerance 5%; Voltage Rating 50V; MPN C1608C0G1H102J080AA
C106: 10uF; C_1206_3216Metric; MPN GRM31CR71E106KA12L
C107, C108: 10uF; C_1206_3216Metric; MPN CGA5L1X7R1H106K160AC
C109, C110, C111, C112: 22uF; C_1210_3225Metric; Voltage Rating 25V; Tolerance 20%; MPN GRM32ER71E226ME15L
C113: 220uF; CP_Elec_8x10.5; MPN EEHZA1E221P
C119: 10nF; C_0402_1005Metric; Voltage Rating 50V; Tolerance 10%; MPN CGA2B3X7R1H103K050BB
L10: 4.7uH; L_Coilcraft_XAL1010-XXX; MPN XAL1010-472MEB
R100: 150k; R_0402_1005Metric; MPN CRCW0402150KFKED
R101: 24.9k; R_0402_1005Metric; MPN CRCW040224K9FKED
R102: 49.9k; R_0402_1005Metric; MPN CRCW040249K9FKED
R103: 10m; R_2512_6332Metric; Power Rating 1W; Tolerance 1%; MPN WSL2512R0100FEA
R104: 100k; R_0402_1005Metric; MPN CRCW0402100KFKED
R105: 11.1k; R_0402_1005Metric; MPN CRCW040211K1FKED
R106: 10k; R_0402_1005Metric; Tolerance 1%; MPN CRCW040210K0FKED
R112: 24.9k; R_0402_1005Metric; Tolerance 1%; Power Rating 0.1W; MPN CRCW040224K9FKED
TP22: +12V; TestPoint_Pad_D1.0mm
U10: TPS552892RYQR; Texas_RYQ0021A_TPS552892; MPN TPS552892RYQR

Connections:
+12V: R103.2, R104.1, TP22.1 (1_1), U10.13 (ISN); also elsewhere on the board
/Power/12V/COMP_12V: C105.1, R106.1, U10.15 (COMP)
/Power/12V/DITHER: C119.1, U10.5 (DITH/SYNC)
/Power/12V/EN_UVLO: R100.2, R101.1, U10.1 (EN/UVLO)
/Power/12V/FB_12V: R104.2, R105.1, U10.14 (FB)
/Power/12V/FSW_SET: R102.1, U10.6 (FSW)
/Power/12V/MODE_SEL: R112.1, U10.2 (MODE)
/Power/12V/P_IN: C41.1, C42.1, C107.1, C108.1, R100.1, U10.7 (VIN); also elsewhere on the board
/Power/12V/VCC_BIAS: C106.1, U10.18 (VCC)
/Power/12V/VOUT_RAW: C40.1, C109.1, C110.1, C111.1, C112.1, C113.1, R103.1, U10.11 (VOUT), U10.12 (ISP)
GND: C40.2, C41.2, C42.2, C104.2, C105.2, C106.2, C107.2, C108.2, C109.2, C110.2, C111.2, C112.2, C113.2, C119.2, R101.2, R102.2, R105.2, R112.2, U10.9 (PGND), U10.17 (AGND); also elsewhere on the board
unnamed: C104.1, R106.2
unnamed: C102.2, U10.20 (BOOT1)
unnamed: C103.2, U10.19 (BOOT2)
unnamed: C102.1, L10.1, U10.8 (SW1)
unnamed: C103.1, L10.2, U10.10 (SW2)

Notes on the sheet:
Startup: keep switched loads and downstream rails OFF until 12 V settles; stagger pump / actuator starts.
Layout: tight input/output ceramic loops; Kelvin R103 sense; ground thermal vias. Validate temperature and load steps.
12 V BUCK-BOOST | TPS552892 | 10-14 V INPUT
C204 / C214 / C224: 100 uF each. Total connected 12 V capacitance: 709 uF nominal, <851 uF at +20%.
R103: 5 A nominal output limit (4.75-5.25 A tolerance); not a continuous-output rating.
MODE pulled low: PFM. EXTVCC open: internal bias. PG / CC unused. UVLO retained: ~8.64 V on / ~7.89 V off.
12.01 V nominal; 3 A continuous design target. 4 A peaks require thermal / transient qualification.

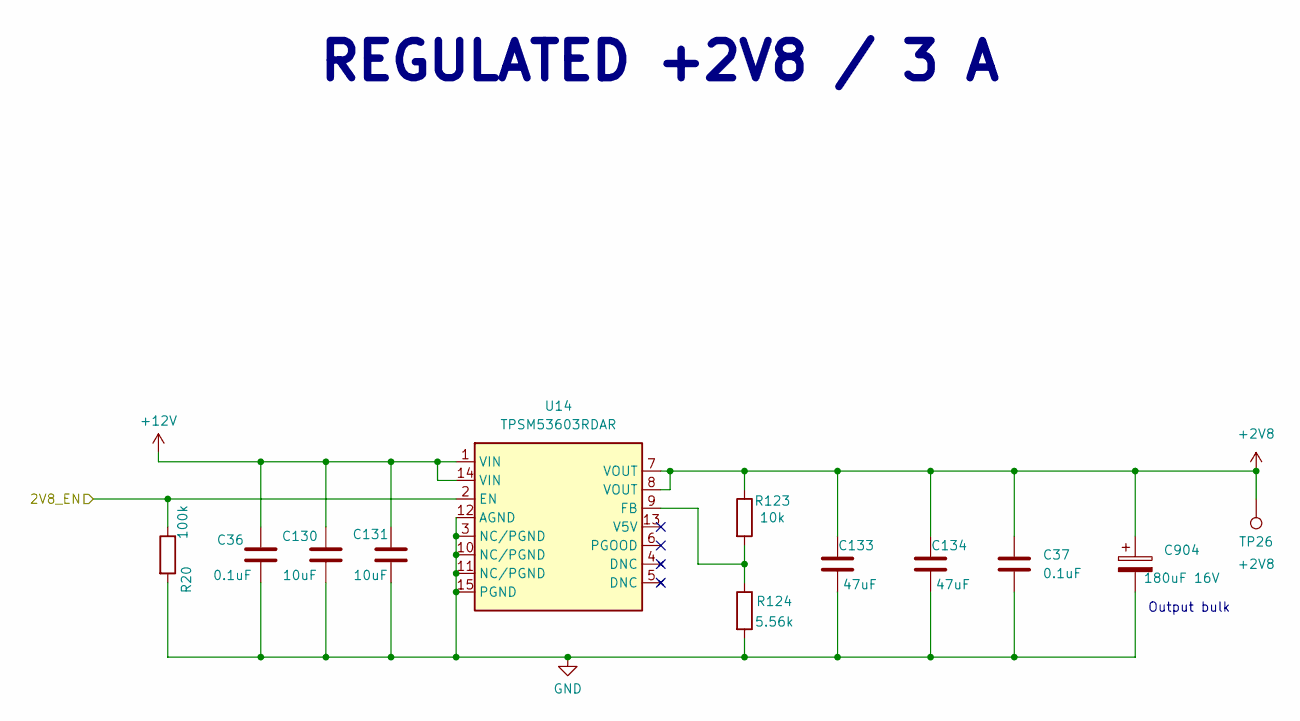
[picture p73: schematic 2v8.kicad_sch]

Parts:
C36, C37: 0.1uF; C_0603_1608Metric; Voltage Rating 50V; Tolerance 10%; MPN C1608X7R1H104K080AA
C130, C131: 10uF; C_1206_3216Metric; MPN CGA5L1X7R1H106K160AC
C133, C134: 47uF; C_1210_3225Metric; MPN GRM32ER61A476ME20L
C904: 180uF 16V; CP_Elec_6.3x5.9; Voltage Rating 16V; Tolerance 20%; MPN 16SVPF180M
R20: 100k; R_0402_1005Metric; MPN CRCW0402100KFKED
R123: 10k; R_0402_1005Metric; MPN CRCW040210K0FKED
R124: 5.56k; R_0402_1005Metric; MPN CRCW04025K56FKED
TP26: +2V8; TestPoint_Pad_D1.0mm
U14: TPSM53603RDAR; Texas_B3QFN-14-1EP_5x5.5mm_P0.65mm_ThermalVia; MPN TPSM53603RDAR

Connections:
+2V8: C37.1, C133.1, C134.1, C904.1, R123.1, TP26.1 (1_1), U14.7 (VOUT), U14.8 (VOUT); also elsewhere on the board
+12V: C36.1, C130.1, C131.1, U14.1 (VIN), U14.14 (VIN); also elsewhere on the board
/Power/2V8_EN: R20.1, U14.2 (EN); also elsewhere on the board
GND: C36.2, C37.2, C130.2, C131.2, C133.2, C134.2, C904.2, R20.2, R124.2, U14.3 (NC/PGND), U14.10 (NC/PGND), U14.11 (NC/PGND), U14.12 (AGND), U14.15 (PGND); also elsewhere on the board
unnamed: R123.2, R124.1, U14.9 (FB)

Notes on the sheet:
REGULATED +2V8 / 3 A
Output bulk

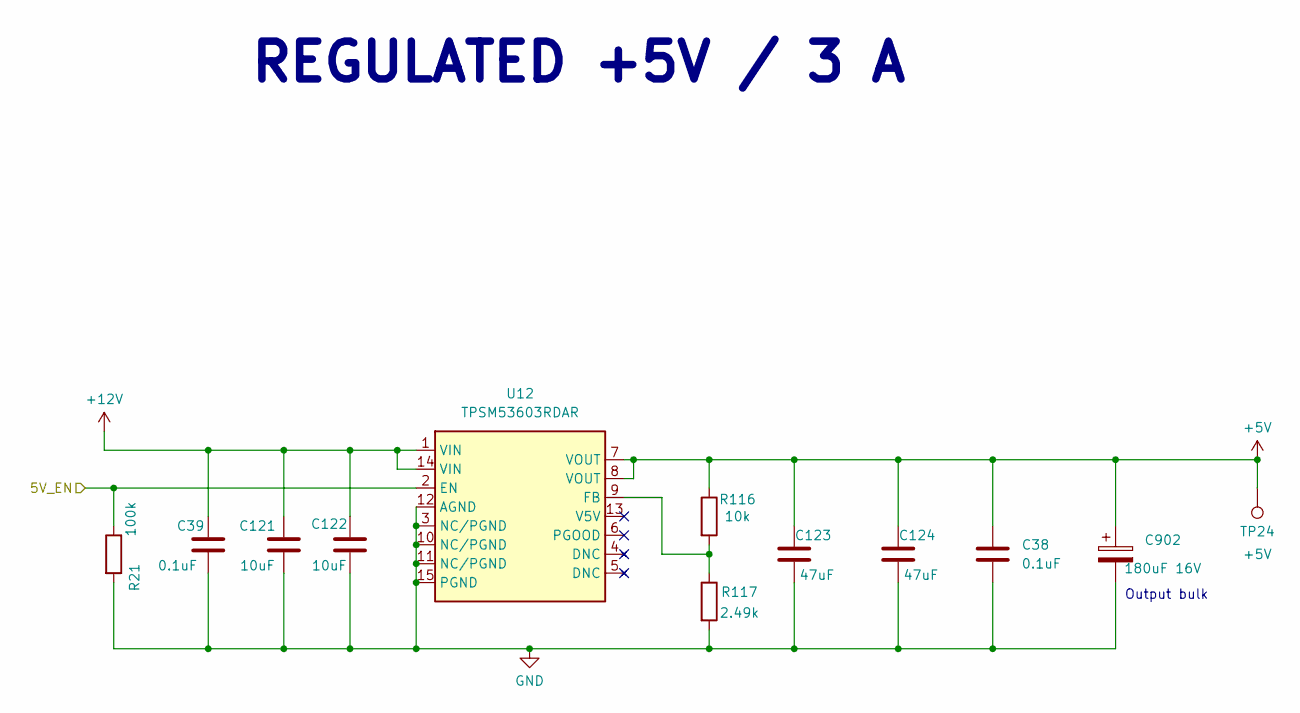
[picture p74: schematic 5v.kicad_sch]

Parts:
C38, C39: 0.1uF; C_0603_1608Metric; Voltage Rating 50V; Tolerance 10%; MPN C1608X7R1H104K080AA
C121, C122: 10uF; C_1206_3216Metric; MPN CGA5L1X7R1H106K160AC
C123, C124: 47uF; C_1210_3225Metric; MPN GRM32ER61A476ME20L
C902: 180uF 16V; CP_Elec_6.3x5.9; Voltage Rating 16V; Tolerance 20%; MPN 16SVPF180M
R21: 100k; R_0402_1005Metric; MPN CRCW0402100KFKED
R116: 10k; R_0402_1005Metric; MPN CRCW040210K0FKED
R117: 2.49k; R_0402_1005Metric; MPN CRCW04022K49FKED
TP24: +5V; TestPoint_Pad_D1.0mm
U12: TPSM53603RDAR; Texas_B3QFN-14-1EP_5x5.5mm_P0.65mm_ThermalVia; MPN TPSM53603RDAR

Connections:
+5V: C38.1, C123.1, C124.1, C902.1, R116.1, TP24.1 (1_1), U12.7 (VOUT), U12.8 (VOUT); also elsewhere on the board
+12V: C39.1, C121.1, C122.1, U12.1 (VIN), U12.14 (VIN); also elsewhere on the board
/Power/5V_EN: R21.1, U12.2 (EN); also elsewhere on the board
GND: C38.2, C39.2, C121.2, C122.2, C123.2, C124.2, C902.2, R21.2, R117.2, U12.3 (NC/PGND), U12.10 (NC/PGND), U12.11 (NC/PGND), U12.12 (AGND), U12.15 (PGND); also elsewhere on the board
unnamed: R116.2, R117.1, U12.9 (FB)

Notes on the sheet:
Output bulk
REGULATED +5V / 3 A

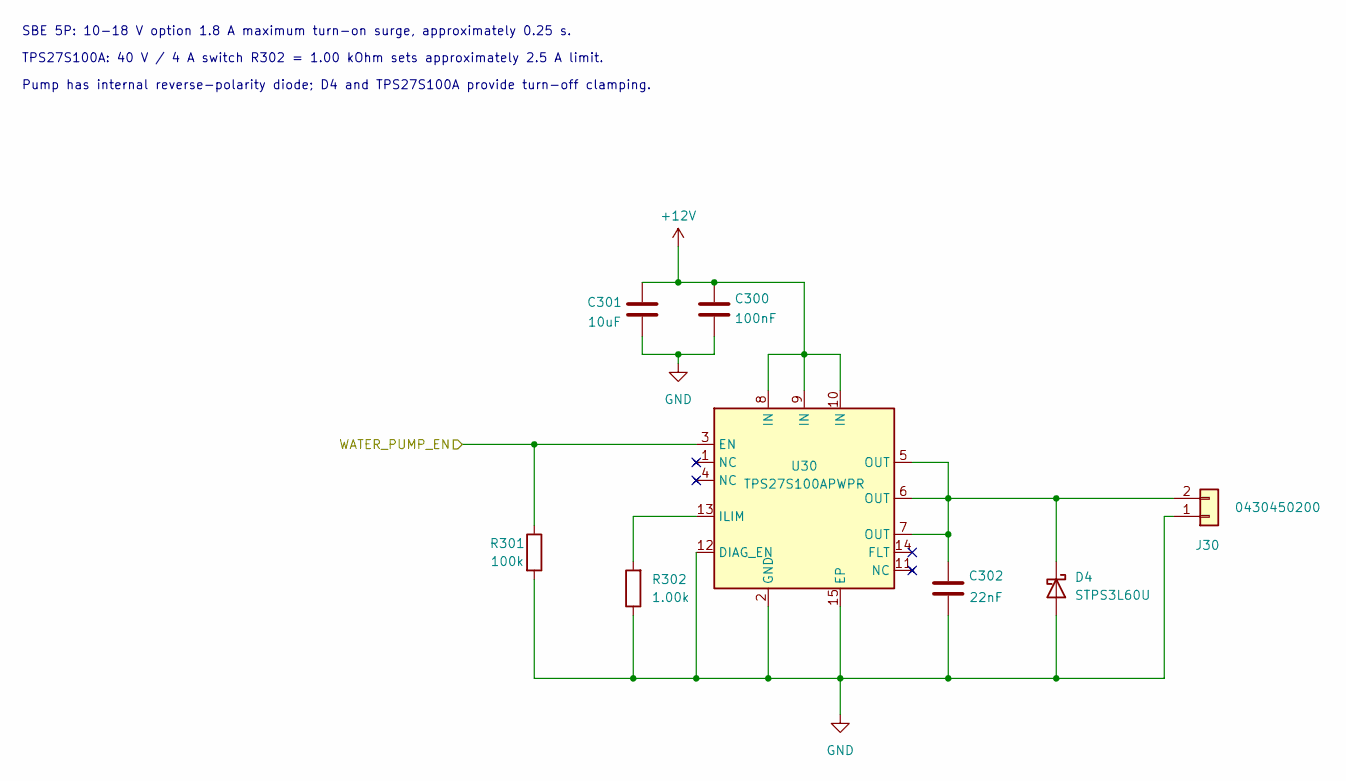
[picture p75: schematic Water_Pump.kicad_sch, Water Pump]

Parts:
C300: 100nF; C_0402_1005Metric; MPN GRM155R71H104ME14D
C301: 10uF; C_1206_3216Metric; MPN CGA5L1X7R1H106K160AC
C302: 22nF; C_0402_1005Metric; MPN GRM155R71H223KA12D
D4: STPS3L60U; D_SMB; MPN STPS3L60U
J30: 0430450200; Molex_Micro-Fit_3.0_43045-0200_2x01_P3.00mm_Horizontal; MPN 0430450200; DigiKey WM1813-ND
R301: 100k; R_0402_1005Metric; MPN CRCW0402100KFKED
R302: 1.00k; R_0402_1005Metric; MPN CRCW04021K00FKED
U30: TPS27S100APWPR; Texas_HTSSOP-14-1EP_4.4x5mm_P0.65mm_EP3.4x5mm_Mask3.155x3.2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; MPN TPS27S100APWPR; DigiKey 296-49002-1-ND

Connections:
+12V: C300.1, C301.1, U30.8 (IN), U30.9 (IN), U30.10 (IN); also elsewhere on the board
/Pump Control/WATER_PUMP_EN: R301.1, U30.3 (EN); also elsewhere on the board
GND: C300.2, C301.2, C302.2, D4.2 (A), J30.1, R301.2, R302.1, U30.2 (GND), U30.12 (DIAG_EN), U30.15 (EP); also elsewhere on the board
unnamed: C302.1, D4.1 (K), J30.2, U30.5 (OUT), U30.6 (OUT), U30.7 (OUT)
unnamed: R302.2, U30.13 (ILIM)

Notes on the sheet:
SBE 5P: 10-18 V option 1.8 A maximum turn-on surge, approximately 0.25 s.
Pump has internal reverse-polarity diode; D4 and TPS27S100A provide turn-off clamping.
TPS27S100A: 40 V / 4 A switch R302 = 1.00 kOhm sets approximately 2.5 A limit.

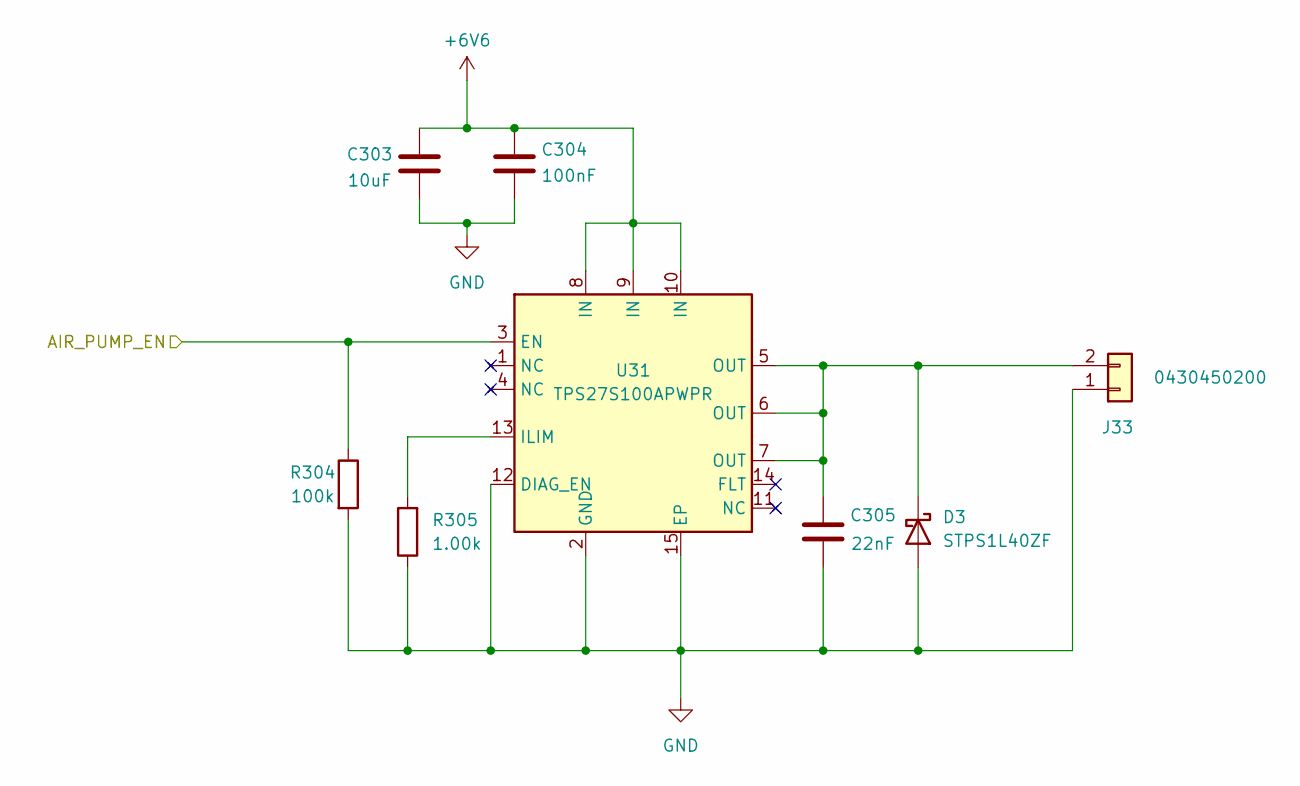
[picture p76: schematic Air_Pump.kicad_sch, Air Pump]

Parts:
C303: 10uF; C_1206_3216Metric; MPN CGA5L1X7R1H106K160AC
C304: 100nF; C_0402_1005Metric; MPN GRM155R71H104ME14D
C305: 22nF; C_0402_1005Metric; MPN GRM155R71H223KA12D
D3: STPS1L40ZF; D_SOD-123F; MPN STPS1L40ZF; DigiKey 497-16916-1-ND
J33: 0430450200; Molex_Micro-Fit_3.0_43045-0200_2x01_P3.00mm_Horizontal; MPN 0430450200; DigiKey WM1813-ND
R304: 100k; R_0402_1005Metric; MPN CRCW0402100KFKED
R305: 1.00k; R_0402_1005Metric; MPN CRCW04021K00FKED
U31: TPS27S100APWPR; Texas_HTSSOP-14-1EP_4.4x5mm_P0.65mm_EP3.4x5mm_Mask3.155x3.2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; MPN TPS27S100APWPR; DigiKey 296-49002-1-ND

Connections:
+6V6: C303.1, C304.1, U31.8 (IN), U31.9 (IN), U31.10 (IN); also elsewhere on the board
/Pump Control/AIR_PUMP_EN: R304.1, U31.3 (EN); also elsewhere on the board
GND: C303.2, C304.2, C305.2, D3.2 (A), J33.1, R304.2, R305.1, U31.2 (GND), U31.12 (DIAG_EN), U31.15 (EP); also elsewhere on the board
unnamed: C305.1, D3.1 (K), J33.2, U31.5 (OUT), U31.6 (OUT), U31.7 (OUT)
unnamed: R305.2, U31.13 (ILIM)
