jkurina86/DIC_Board/DIC_Board/DIC_Board.kicad_pcb

## KiCad design DIC_Board/DIC_Board.kicad_pcb (continued)

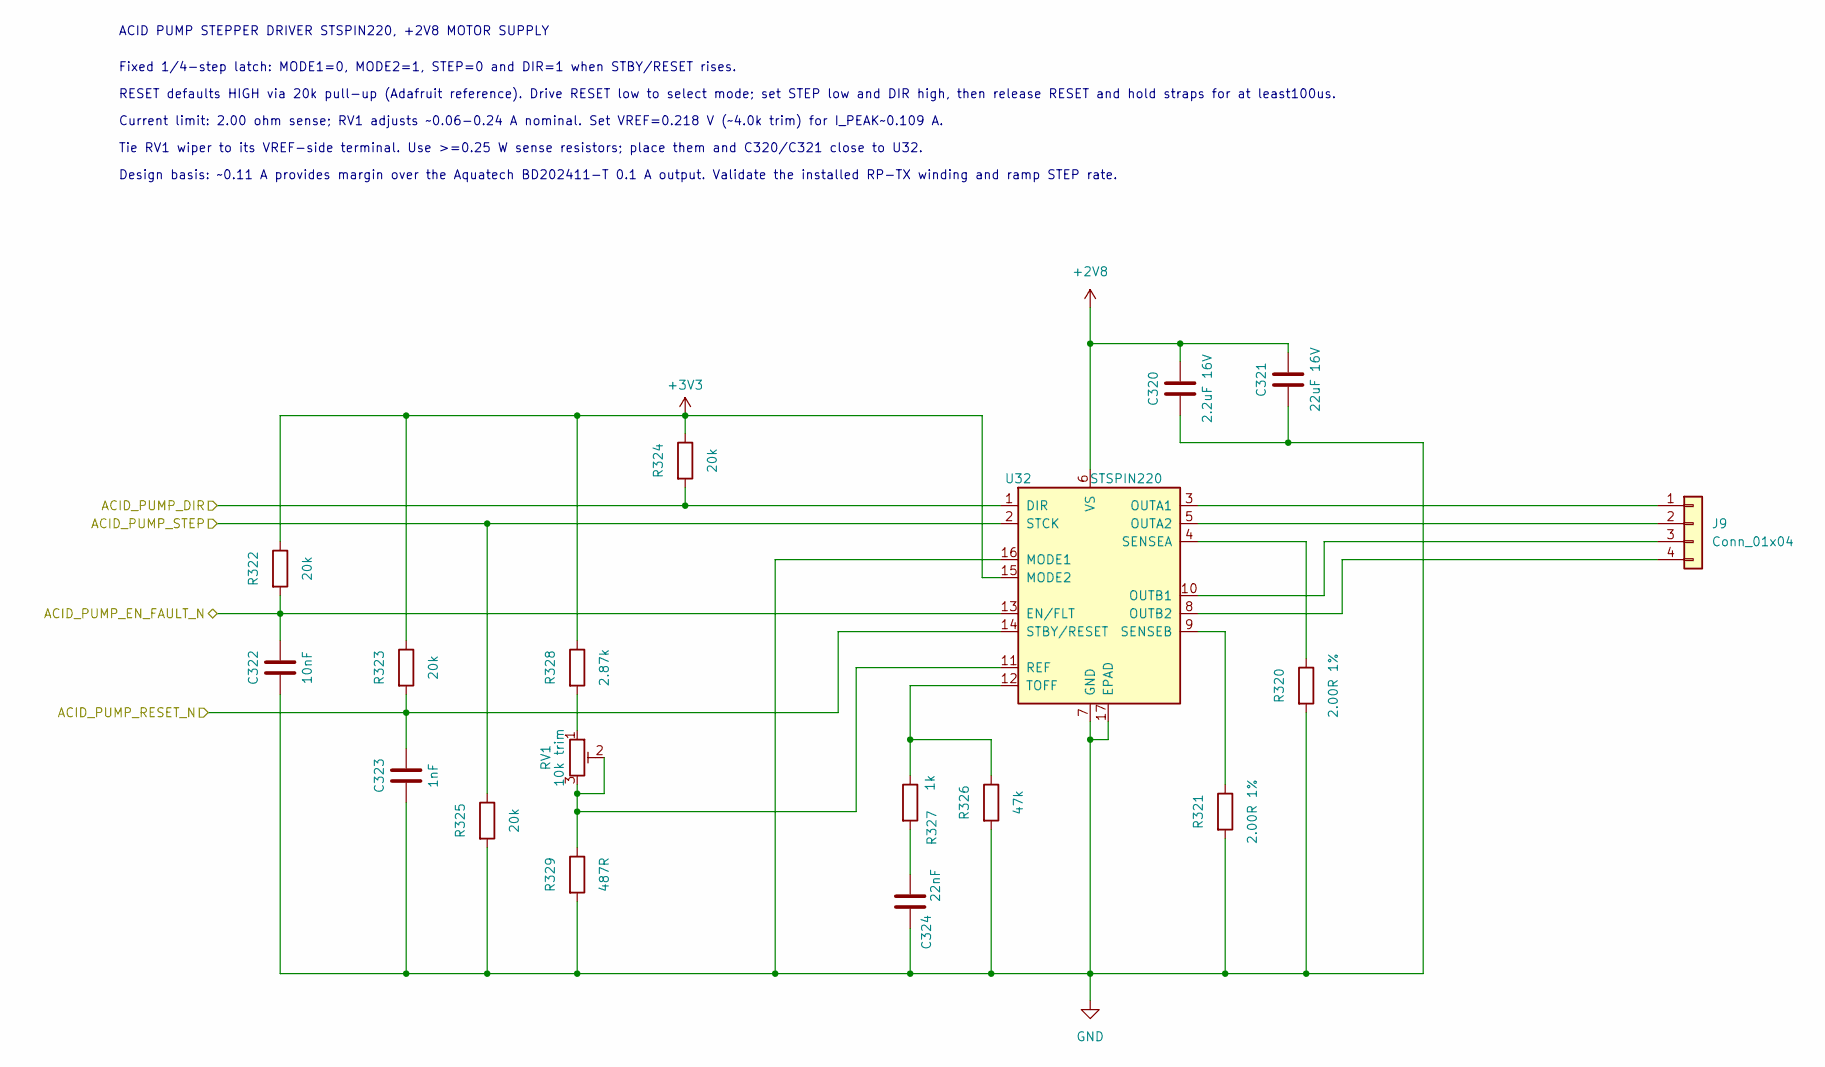
[picture p77: schematic Acid_Pump.kicad_sch, Acid Pump]

Parts:
C320: 2.2uF 16V; C_0603_1608Metric; Voltage Rating 16V; Tolerance 10%; MPN C1608X5R1C225K080AB
C321: 22uF 16V; C_1210_3225Metric; Voltage Rating 25V; Tolerance 20%; MPN GRM32ER71E226ME15L
C322: 10nF; C_0603_1608Metric; Voltage Rating 50V; Tolerance 10%; MPN C1608X7R1H103K080AA
C323: 1nF; C_0603_1608Metric; Voltage Rating 50V; Tolerance 5%; MPN C1608C0G1H102J080AA
C324: 22nF; C_0603_1608Metric; Voltage Rating 50V; Tolerance 10%; MPN C1608X7R1H223K080AA
J9: Conn_01x04; Molex_Micro-Fit_3.0_43045-0400_2x02_P3.00mm_Horizontal; MPN 0430450400
R320, R321: 2.00R 1%; R_1206_3216Metric; Tolerance 1%; Power Rating 0.25W; MPN CRCW12062R00FKEA
R322, R323, R324, R325: 20k; R_0603_1608Metric; Tolerance 1%; Power Rating 0.125W; MPN CRCW060320K0FKEA
R326: 47k; R_0603_1608Metric; Tolerance 1%; Power Rating 0.125W; MPN CRCW060347K0FKEA
R327: 1k; R_0603_1608Metric; Tolerance 1%; Power Rating 0.125W; MPN CRCW06031K00FKEA
R328: 2.87k; R_0603_1608Metric; Tolerance 0.1%; Power Rating 0.125W; MPN TNPW06032K87BEEA
R329: 487R; R_0603_1608Metric; Tolerance 0.1%; Power Rating 0.125W; MPN TNPW0603487RBEEA
RV1: 10k trim; Potentiometer_Bourns_3314J_Vertical; MPN 3314J-1-103E
U32: STSPIN220; VQFN-16-1EP_3x3mm_P0.5mm_EP1.8x1.8mm; MPN STSPIN220

Connections:
+2V8: C320.1, C321.1, U32.6 (VS); also elsewhere on the board
+3V3: R322.1, R323.1, R324.1, R328.1, U32.15 (MODE2); also elsewhere on the board
/Pump Control/ACID_PUMP_DIR: R324.2, U32.1 (DIR); also elsewhere on the board
/Pump Control/ACID_PUMP_EN_FAULT_N: C322.1, R322.2, U32.13 (EN/FLT); also elsewhere on the board
/Pump Control/ACID_PUMP_RESET_N: C323.1, R323.2, U32.14 (STBY/RESET); also elsewhere on the board
/Pump Control/ACID_PUMP_STEP: R325.1, U32.2 (STCK); also elsewhere on the board
GND: C320.2, C321.2, C322.2, C323.2, C324.2, R320.2, R321.2, R325.2, R326.2, R329.2, U32.7 (GND), U32.16 (MODE1), U32.17 (EPAD); also elsewhere on the board
unnamed: C324.1, R327.2
unnamed: J9.1, U32.3 (OUTA1)
unnamed: J9.2, U32.5 (OUTA2)
unnamed: J9.3, U32.10 (OUTB1)
unnamed: J9.4, U32.8 (OUTB2)
unnamed: R328.2, RV1.1
unnamed: R329.1, RV1.2, RV1.3, U32.11 (REF)
unnamed: R320.1, U32.4 (SENSEA)
unnamed: R321.1, U32.9 (SENSEB)
unnamed: R326.1, R327.1, U32.12 (TOFF)

Notes on the sheet:
RESET defaults HIGH via 20k pull-up (Adafruit reference). Drive RESET low to select mode; set STEP low and DIR high, then release RESET and hold straps for at least100us.
ACID PUMP STEPPER DRIVER STSPIN220, +2V8 MOTOR SUPPLY
Tie RV1 wiper to its VREF-side terminal. Use >=0.25 W sense resistors; place them and C320/C321 close to U32.
Fixed 1/4-step latch: MODE1=0, MODE2=1, STEP=0 and DIR=1 when STBY/RESET rises.
Current limit: 2.00 ohm sense; RV1 adjusts ~0.06-0.24 A nominal. Set VREF=0.218 V (~4.0k trim) for I_PEAK~0.109 A.
Design basis: ~0.11 A provides margin over the Aquatech BD202411-T 0.1 A output. Validate the installed RP-TX winding and ramp STEP rate.

Board: 4 copper layers, 291 parts (0 on the bottom side), 216 nets, no tracks yet.
