jkurina86/DIC_Board/Firmware/DIC/DIC.ioc

Mcu.UserName=STM32L476ZGTx
PA0.GPIO_Label=ADMONT_TX
PA0.Signal=UART4_TX
PA1.GPIO_Label=ADMONT_RX
PA1.Signal=UART4_RX
PA10.GPIO_Label=COMM_RX
PA10.Signal=USART1_RX
PA11.Signal=USB_OTG_FS_DM
PA12.Signal=USB_OTG_FS_DP
PA2.GPIO_Label=LICOR_TX
PA2.Signal=USART2_TX
PA3.GPIO_Label=LICOR_RX
PA3.Signal=USART2_RX
PA4.GPIO_Label=RTC_CE
PA4.Signal=GPIO_Output
PA5.Signal=SPI1_SCK
PA6.Signal=SPI1_MISO
PA7.Signal=SPI1_MOSI
PA8.GPIO_Label=COMM_EN
PA8.Signal=GPIO_Output
PA9.GPIO_Label=COMM_TX
PA9.Signal=USART1_TX
PC13.Signal=GPIO_Input
PB0.GPIO_Label=RTC_INT
PB0.Signal=GPIO_Input
PB1.GPIO_Label=RTC_CLKOUT
PB1.Signal=GPIO_Input
PB10.GPIO_Label=VALVE_CS1
PB10.Signal=GPIO_Output
PB11.GPIO_Label=VALVE_CS2
PB11.Signal=GPIO_Output
PB12.GPIO_Label=VALVE_CS3
PB12.Signal=GPIO_Output
PB13.GPIO_Label=VALVE_LATCH
PB13.Signal=GPIO_Output
PB14.GPIO_Label=VALVE_RESET_N
PB14.Signal=GPIO_Output
PB15.GPIO_Label=VALVE_SLEEP_N
PB15.Signal=GPIO_Output
PB2.GPIO_Label=RTC_CLKOE
PB2.Signal=GPIO_Output
PE12.Signal=QUADSPI_BK1_IO0
PC0.GPIO_Label=ACTUATOR_1_POS
PC0.Signal=ADCx_IN1
PC1.GPIO_Label=ACTUATOR_1_CURRENT
PC1.Signal=ADCx_IN2
PC10.Signal=SDMMC1_D2
PC11.Signal=SDMMC1_D3
PC12.Signal=SDMMC1_CK
PC2.GPIO_Label=ACTUATOR_2_POS
PC2.Signal=ADCx_IN3
PC3.GPIO_Label=ACTUATOR_2_CURRENT
PC3.Signal=ADCx_IN4
PC4.GPIO_Label=O2_SENSOR_TX
PC4.Signal=USART3_TX
PC5.GPIO_Label=O2_SENSOR_RX
PC5.Signal=USART3_RX
PC8.Signal=SDMMC1_D0
PC9.Signal=SDMMC1_D1
PD12.GPIO_Label=ACID_PUMP_STEP
PD12.Signal=S_TIM4_CH1
PD2.Signal=SDMMC1_CMD
PE10.Signal=QUADSPI_CLK
PE11.Signal=QUADSPI_NCS
PE13.Signal=QUADSPI_BK1_IO1
PE14.Signal=QUADSPI_BK1_IO2
PE15.Signal=QUADSPI_BK1_IO3
PE0.GPIO_Label=USB_VBUS_SENSE
PE0.Signal=GPIO_Input
PF0.GPIO_Label=EN_2V8
PF0.Signal=GPIO_Output
PF1.GPIO_Label=EN_5V
PF1.Signal=GPIO_Output
PF10.GPIO_Label=AIR_PUMP_EN
PF10.Signal=GPIO_Output
PF11.GPIO_Label=ACID_PUMP_DIR
PF11.Signal=GPIO_Output
PF12.GPIO_Label=ACID_PUMP_EN_FAULT_N
PF12.Signal=GPIO_Output
PF13.GPIO_Label=ACID_PUMP_RESET_N
PF13.Signal=GPIO_Output
PF14.GPIO_Label=ACTUATOR_1_EN
PF14.Signal=GPIO_Output
PF15.GPIO_Label=ACTUATOR_2_EN
PF15.Signal=GPIO_Output
PF2.GPIO_Label=EN_6V6
PF2.Signal=GPIO_Output
PF3.GPIO_Label=LICOR_EN
PF3.Signal=GPIO_Output
PF4.GPIO_Label=O2_SENSOR_EN
PF4.Signal=GPIO_Output
PF5.GPIO_Label=ADMONT_EN
PF5.Signal=GPIO_Output
PF6.GPIO_Label=ACTUATOR_1_PWM
PF6.Signal=S_TIM5_CH1
PF7.GPIO_Label=ACTUATOR_2_PWM
PF7.Signal=S_TIM5_CH2
PF9.GPIO_Label=WATER_PUMP_EN
PF9.Signal=GPIO_Output
PG11.GPIO_Label=VALVE_SDATA
PG11.Signal=SPI3_MOSI
PG13.GPIO_Label=RH_SDA
PG13.Signal=I2C1_SDA
PG14.GPIO_Label=RH_SCL
PG14.Signal=I2C1_SCL
PG6.GPIO_Label=AUX_EN
PG6.Signal=GPIO_Output
PG7.GPIO_Label=AUX_TX
PG7.Signal=LPUART1_TX
PG8.GPIO_Label=AUX_RX
PG8.Signal=LPUART1_RX
PG9.GPIO_Label=VALVE_SCLK
PG9.Signal=SPI3_SCK
