jkurina86/DIC_Board/(commit log)

2026-07-09 Initial KiCad project import
    [DIC_Board.kicad_pcb, DIC_Board.kicad_sch, untitled.kicad_sch]
2026-07-16 Add MCU schematic hierarchy and pin configuration
    [DIC_Board.kicad_sch, Power.kicad_sch, mcu.kicad_sch]
2026-07-17 Update MCU schematic and add project document
    [mcu.kicad_sch]
2026-07-18 Add MCU clock and RTC integration
    [mcu.kicad_sch]
2026-07-20 Add component documentation archive
    [Actuonix_LAC_advanced_configuration.txt, LI-830_XML_configuration_grammar.txt]
2026-07-22 Add PSRAM and SD card MCU circuits
    [mcu.kicad_sch]
2026-07-23 Complete MCU and regulated power schematics
    [Power.kicad_sch, mcu.kicad_sch]
2026-07-25 Update power supply schematic and symbol libraries
    [Power.kicad_sch]
2026-07-27 Updated the 12V power circuit.
    [Power.kicad_sch]
2026-07-28 Fixed the 12V regulator circuit.
    [Power.kicad_sch]
2026-08-01 minor changes
    [mcu.kicad_sch]
2026-08-05 added 5V and 6V power rails
    [Power.kicad_sch]
2026-08-18 added valve control sheet
    [DIC_Board.kicad_sch, Power.kicad_sch, Valve_Control.kicad_sch]
2026-08-19 added valve control banks.
    [DIC_Board.kicad_sch, Valve_Control.kicad_sch, Valve_Control_Bank1.kicad_sch, Valve_Control_Bank2.kicad_sch, Valve_Control_Bank3.kicad_sch]
2026-08-22 Added Sheets for pumps and sensors
    [Acid_Pump.kicad_sch, Air_Pump.kicad_sch, DIC_Board.kicad_sch, Pump_Control.kicad_sch, Sensors.kicad_sch, Valve_Control.kicad_sch, Water_Pump.kicad_sch]
2026-08-25 Completed water pump and added the 2.7V rail
    [Acid_Pump.kicad_sch, Air_Pump.kicad_sch, DIC_Board.kicad_sch, Power.kicad_sch, Pump_Control.kicad_sch, Sensors.kicad_sch, Valve_Control_Bank3.kicad_sch, Water_Pump.kicad_sch]
2026-08-26 Completed Acid Pump sheet
    [Acid_Pump.kicad_sch, Valve_Control_Bank1.kicad_sch, Valve_Control_Bank2.kicad_sch, Valve_Control_Bank3.kicad_sch, Water_Pump.kicad_sch]
2026-08-28 Separated the power sheets, did the sensor sheets.
    [12v.kicad_sch, 2v8.kicad_sch, 3v3.kicad_sch, 5v.kicad_sch, 6v6.kicad_sch, Air_Pump.kicad_sch, DIC_Board.kicad_sch, Licor.kicad_sch]
2026-08-29 Wrapping up schematic
    [DIC_Board.kicad_sch, Power.kicad_sch, Pump_Control.kicad_sch, Sensors.kicad_sch, Valve_Control.kicad_sch, Valve_Control_Bank1.kicad_sch, Valve_Control_Bank2.kicad_sch, Valve_Control_Bank3.kicad_sch]
2026-08-30 Checkpoint current schematic state
    [Acid_Pump.kicad_sch, admont_k96.kicad_sch, mcu.kicad_sch, rh_sensor.kicad_sch]
2026-08-31 Synchronize schematic hierarchy and MCU pin map
    [12v.kicad_sch, 2v8.kicad_sch, 3v3.kicad_sch, 5v.kicad_sch, 6v6.kicad_sch, Acid_Pump.kicad_sch, Air_Pump.kicad_sch, DIC_Board.kicad_sch]
2026-09-02 Synchronize power, communications, and MCU configuration
    [12v.kicad_sch, 2v8.kicad_sch, 3v3.kicad_sch, 5v.kicad_sch, 6v6.kicad_sch, Acid_Pump.kicad_sch, DIC_Board.kicad_sch, Valve_Control_Bank1.kicad_sch]
2026-09-05 Pump fixes + doc extraction
    [12v.kicad_sch, Acid_Pump.kicad_sch, Air_Pump.kicad_sch, Licor.kicad_sch, Water_Pump.kicad_sch, auxiliary.kicad_sch]
2026-09-12 Updated board for layout! All footprints added
    [12v.kicad_sch, 2v8.kicad_sch, 3v3.kicad_sch, 5v.kicad_sch, 6v6.kicad_sch, Acid_Pump.kicad_sch, Air_Pump.kicad_sch, DIC_Board.kicad_pcb]
2026-09-15 Preliminary layout
    [12v.kicad_sch, 2v8.kicad_sch, 3v3.kicad_sch, 5v.kicad_sch, 6v6.kicad_sch, DIC_Board.kicad_pcb, DIC_Board.kicad_sch, Power.kicad_sch]
2026-09-17 Changed the 12V regulator to an integrated IC
    [12v.kicad_sch, DIC_Board.kicad_pcb, DIC_Board_BOM.xlsx, Valve_Control_Bank1.kicad_sch, Valve_Control_Bank2.kicad_sch, Valve_Control_Bank3.kicad_sch, mcu.kicad_sch]
2026-09-18 minor PCB
    [DIC_Board.kicad_pcb]
2026-09-18 resized the board to 9.5 in by 2 in
    [12v.kicad_sch, DIC_Board.kicad_pcb, mcu.kicad_sch]
