jkurina86/DIC_Board/(notices)

Notices in the files:
Docs/Board/STM32_hardware_guidance/AN4621_ultralow_power_overview.txt:
© 2019 STMicroelectronics – All rights reserved
Docs/Sensors/LI-COR_LI-830/LI-830_LI-850_support_manuals.txt:
©2026 LI-COR, Inc.
